whois169/roboot007v/docs/机械狗007A/头部抬头低头.png

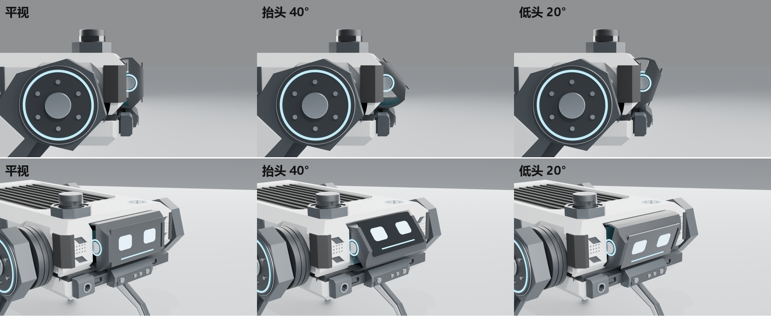
docs/机械狗007A/头部抬头低头.png
