whois169/roboot007v/docs/机械狗007A/效果图_v20_后45.png

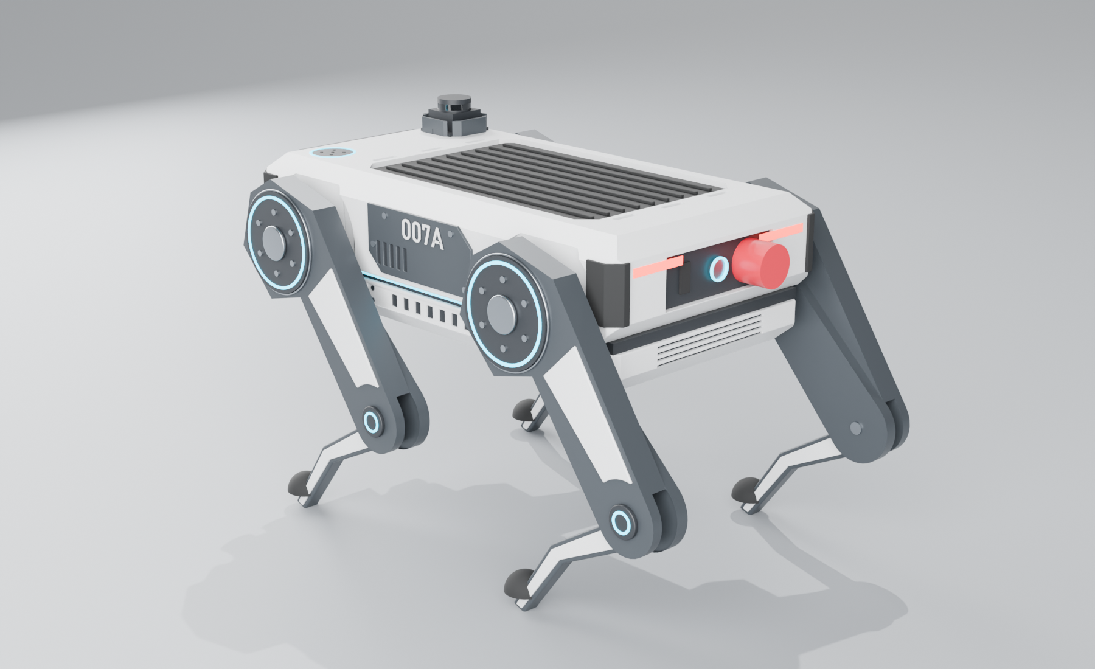
docs/机械狗007A/效果图_v20_后45.png
