whois169/roboot007v/007a/out/eng_report.txt

007A 骨架检查（eng_body.py）

站立：0 处干涉
外摆 ±20°（加 3 mm 余量）：0 处干涉

电子托板 z = 83（离机身底），顶板 z = 131，托板上能放高 41 的东西
托板上太高的：无
