whois169/roboot007v/007v/out/report.txt

机械狗007v骨架检查报告  2026-10-23 15:56
改尺寸：007v/config.py；重新生成：python 007v/build.py

【姿态】
  行驶（平视）：摆臂 +55.0°，头 +0°，机身底离地 127 mm → 长 591 × 宽 410 × 高 463 mm
      滑撬离地 121 mm；轮子最低 0.0 mm；除轮子和滑撬外最低的是 前右电机护罩端圈（18 mm）
  行驶（抬头）：摆臂 +55.0°，头 -35°，机身底离地 127 mm → 长 591 × 宽 410 × 高 463 mm
      滑撬离地 121 mm；轮子最低 0.0 mm；除轮子和滑撬外最低的是 前右电机护罩端圈（18 mm）
  行驶（低头）：摆臂 +55.0°，头 +20°，机身底离地 127 mm → 长 591 × 宽 410 × 高 463 mm
      滑撬离地 121 mm；轮子最低 0.0 mm；除轮子和滑撬外最低的是 前右电机护罩端圈（18 mm）
  折叠：摆臂 +0.0°，头 +15°，机身底离地 6 mm → 长 736 × 宽 410 × 高 342 mm
      滑撬离地 0 mm；轮子最低 18.0 mm；除轮子和滑撬外最低的是 外壳·底部灯槽右（4 mm）
  机身坐上滑撬时的摆臂角 +6.1°（从这里往上翻，轮子离地）

【干涉检查】（实体求交，> 2 mm³ 算撞；转轴、皮带、卡槽这些本来就套在一起的不算）
  行驶（平视）：0 处
  行驶（抬头）：0 处
  行驶（低头）：0 处
  折叠：0 处

【折叠过程 + 抬头低头】（每 2° 摆一次，算不同刚体之间的最近距离；40 mm 以外不细算；髋部轴承座和臂座之间固定的 1 mm / 3 mm 转动缝不算）
  全程没有相撞，也没有零件进到地面以下
  机身 ↔ 屏幕头：最近 0.7 mm（左转轴壳 ↔ 屏幕头·主壳，③行驶时抬头到低头，摆臂 +55°、头 +20°）
  前左腿 ↔ 机身：最近 7.0 mm（外壳·髋支座前左螺栓 x+182z57 ↔ 前左外壳·线夹4，①轮子着地、机身降到滑撬上，摆臂 +55°、头 +0°）
  后左腿 ↔ 机身：最近 7.0 mm（外壳·髋支座后左螺栓 x-182z57 ↔ 后左外壳·线夹4，①轮子着地、机身降到滑撬上，摆臂 +55°、头 +0°）
  前右腿 ↔ 机身：最近 7.0 mm（外壳·髋支座前右螺栓 x+182z57 ↔ 前右外壳·线夹4，①轮子着地、机身降到滑撬上，摆臂 +55°、头 +0°）
  后右腿 ↔ 机身：最近 7.0 mm（外壳·髋支座后右螺栓 x-182z57 ↔ 后右外壳·线夹4，①轮子着地、机身降到滑撬上，摆臂 +55°、头 +0°）
  ①轮子着地、机身降到滑撬上：除轮子和滑撬外离地最低 4 mm（外壳·底部灯槽左）
  ②摆臂往上往里翻：除轮子和滑撬外离地最低 4 mm（外壳·底部灯槽左）
  ③行驶时抬头到低头：除轮子和滑撬外离地最低 18 mm（前左电机护罩端圈）

【重量和重心】
  空车：15.9 kg，重心 x +12 / y +1 / 离地 180 mm
      前轮各 4.2 kg、后轮各 3.8 kg；撑住车身的髋扭矩 前 4.0 / 后 3.6 N·m
      侧翻临界 45°，往前翻 53°，往后翻 55°
      其他腿不动、直接抬一条腿，重心离三轮三角形的边：前左 -8 mm，前右 -6 mm，后左 +6 mm，后右 +8 mm（正 = 在里面；要靠调姿势加大，见仿真报告）
  满载 10 kg：25.9 kg，重心 x -13 / y +1 / 离地 257 mm
      前轮各 6.1 kg、后轮各 6.8 kg；撑住车身的髋扭矩 前 5.9 / 后 6.5 N·m
      侧翻临界 35°，往前翻 45°，往后翻 42°
      其他腿不动、直接抬一条腿，重心离三轮三角形的边：前左 +7 mm，前右 +8 mm，后左 -8 mm，后右 -7 mm（正 = 在里面；要靠调姿势加大，见仿真报告）
  满载从趴着撑起来：髋扭矩最大 11.2 N·m（摆臂 +6°）；髋驱动额定约 20.7 N·m

【整机宽度】
  机身 240 + 两边各（髋轴承座 18 + 轴毂 17 + 腿板 6 + 轴承座 3 + 轮宽 37（外侧和腿外侧齐平）+ 髋盖 4；电机在腿板内侧、露在机身下方）= 410 mm

零件 471 个，自重合计 15.9 kg（含外壳 1.37 kg）；用时 86 秒
