whois169/roboot007v/007v/out/sim_report.txt

机械狗007v仿真报告  2026-10-22 15:24
重新跑：python 007v/sim/run_sim.py（改了 CAD 先跑 python 007v/build.py，再加 --export）

电机模型：髋 = 5840 蜗轮 × 3:1 同步带（额定按 20.7 N·m 判）；轮 = GIM4310-10（峰值 5.6、额定 2.05 N·m，转速越高能出的越少）；
麦轮按 12 个 45° 滚子真实建模（每个滚子能自由转）；地面摩擦系数 0.9；货物 10 kg 在货斗中间、重心高出甲板 10 cm。

【站着不动】背上 10 kg，看髋关节要撑多大力。
  前腿髋关节撑住车身：5.0 N·m（上限 20.7）  ✓
  后腿髋关节撑住车身：5.6 N·m（上限 20.7）  ✓
  每个轮子分到的重量：6.1 / 6.1 / 6.7 / 6.7 kg（前左/前右/后左/后右）
  轮子电机要出力吗：不用 ；蜗轮自锁，站着不耗电  ✓

【折叠 → 站起来 → 趴下】背上 10 kg，从折叠趴着展开站起来，再趴下折叠（髋 80°/秒，轮子接地前后放慢到 20°/秒）。
  站起来时髋扭矩最大：11.4 N·m（上限 20.7）；后左腿  ✓
  趴下时髋扭矩最大：9.9 N·m（上限 20.7）；后左腿  ✓
  站起来用时：2.3 秒
  站起来后机身离地：127 mm；设计值 127  ✓
  站起来过程车身最大倾斜：0.0 °  ✓
  注：如果一直 80°/秒不放慢，轮子接地那一下髋扭矩冲到 12.0 N·m（之后稳定在 8–10）；接地前后放慢以后见上面

【平地加速和急停】背上 10 kg，加速到最高速 1.0 m/s（110 轮 + GIM4310-10 的上限），正常刹车，再加速后急停。
  加速时轮子扭矩最大：0.88 N·m（上限 5.6）；额定 2.05  ✓
  1.0 m/s 匀速时轮子扭矩：0.4 N·m（上限 2.05）  ✓
  实际速度：1.0 m/s；指令 1.0  ✓
  急停实际减速度：3.7 m/s²；指令 4  ✓
  急停刹车距离：19 cm
  急停时后轮最少还压着：1.9 kg；大于 0 就没翘起来  ✓
  急停时车身最大点头：0.0 °
  注：轮子电机限幅触发 2.39 秒

【10% 坡】背上 10 kg，在 10% 的坡（5.7°）上停住、上坡、坡上停车、倒着下坡。
  坡上停住时轮子扭矩：0.35 N·m（上限 2.05）  ✓
  匀速上坡时轮子扭矩（最累的轮）：0.79 N·m（上限 2.05）；这个转速下电机最多能出 0.8  ✓
  上坡起步时轮子扭矩最大：1.26 N·m（上限 5.6）  ✓
  下坡刹车时轮子扭矩最大：0.67 N·m（上限 5.6）  ✓
  实际上坡速度：0.99 m/s；指令 1.0  ✓
  坡上髋扭矩最大：5.7 N·m（上限 20.7）；前左腿  ✓
  停在坡上会不会溜：1.1 mm（第一次停住的 1 秒里滑了多少）  ✓

【横走和原地转】背上 10 kg，麦轮横着往左走 0.5 m/s，再原地转 90°/秒。
  实际横走速度：0.49 m/s；指令 0.5  ✓
  横走时往前后跑偏：0.0 m/s  ✓
  横走 2 秒车头转偏：0.0 °  ✓
  横走时轮子扭矩：0.52 N·m（上限 2.05）  ✓
  实际原地转速：89.0 °/秒；指令 90  ✓
  原地转时轮子扭矩：0.43 N·m（上限 2.05）  ✓
  整段轮子扭矩最大：1.03 N·m（上限 5.6）  ✓

【压过 15 mm 门槛】背上 10 kg，0.8 m/s 直接压过一根 15 mm 高、4 cm 宽的门槛条。
  过得去吗：过得去   ✓
  压门槛时髋扭矩最大：22.2 N·m（上限 20.7）；后左腿  ✗
  平地时髋扭矩（对比）：9.2 N·m
  压门槛时轮子扭矩最大：2.41 N·m（上限 5.6）  ✓
  车身上下颠簸最大：1.9 g；仿真里冲击只是估算
  车身最大点头：1.8 °
  注：髋关节是蜗轮自锁的“硬腿”，颠簸全靠轮子和轮胎吸收，冲击直接传到蜗轮上
  注：同样的门槛慢到 0.3 m/s 过，髋扭矩最大 12.8 N·m

【直接抬后左腿】背上 10 kg，其他腿不动、直接把后左腿往上抬。
  后左腿抬离地面了吗：抬起来了 
  抬起的轮子离地（仿真）：16 mm
  抬着时另外三个轮子最少还压着：0.0 kg；大于 0 就不会翻
  抬着时车身倾斜（仿真）：32.9 °
  整个过程髋扭矩最大：17.5 N·m（上限 20.7）；后左腿
  结论：抬不起来：整个车往后左方向歪了 33°，所以抬腿前必须先调姿势 

【调姿势后抬前左腿】背上 10 kg，先让另外三条腿换角度把重心挪开，再把前左腿抬离地 8 cm 以上，停 2 秒放下。
  调姿势后（静力计算）重心离三角形边：51 mm  ✓
  三条支撑腿的角度：前右 60° / 后左 100° / 后右 65° 
  车身倾斜（计算）：2.5 °
  前左腿抬离地面了吗：抬起来了   ✓
  抬起的轮子离地（仿真）：88 mm
  抬着时另外三个轮子最少还压着：3.9 kg；大于 0 就不会翻  ✓
  抬着时车身倾斜（仿真）：2.5 °
  整个过程髋扭矩最大：8.9 N·m（上限 20.7）；前右腿  ✓
  结论：稳   ✓

【调姿势后抬后左腿】背上 10 kg，先让另外三条腿换角度把重心挪开，再把后左腿抬离地 8 cm 以上，停 2 秒放下。
  调姿势后（静力计算）重心离三角形边：50 mm  ✓
  三条支撑腿的角度：前左 100° / 前右 55° / 后右 50° 
  车身倾斜（计算）：4.9 °
  后左腿抬离地面了吗：抬起来了   ✓
  抬起的轮子离地（仿真）：86 mm
  抬着时另外三个轮子最少还压着：3.4 kg；大于 0 就不会翻  ✓
  抬着时车身倾斜（仿真）：4.9 °
  整个过程髋扭矩最大：10.1 N·m（上限 20.7）；后右腿  ✓
  结论：稳   ✓

【抬腿静力计算】重心离三个着地轮围成的三角形的边（正 = 在里面，越大越稳；限制车身倾斜 ≤ 12°、滑撬离地 ≥ 4 cm）
  满载 前左腿：其他腿不动直接抬 3 cm：+6 mm；先调姿势再抬 10 cm：+51 mm（车身歪 2°，髋 7.8 N·m）
  满载 前右腿：其他腿不动直接抬 3 cm：+7 mm；先调姿势再抬 10 cm：+51 mm（车身歪 2°，髋 7.9 N·m）
  满载 后左腿：其他腿不动直接抬 3 cm：-8 mm；先调姿势再抬 10 cm：+50 mm（车身歪 5°，髋 11.3 N·m）
  满载 后右腿：其他腿不动直接抬 3 cm：-8 mm；先调姿势再抬 10 cm：+49 mm（车身歪 4°，髋 10.4 N·m）
  空车 前左腿：其他腿不动直接抬 3 cm：-11 mm；先调姿势再抬 10 cm：+49 mm（车身歪 7°，髋 6.7 N·m）
  空车 前右腿：其他腿不动直接抬 3 cm：-10 mm；先调姿势再抬 10 cm：+50 mm（车身歪 6°，髋 7.7 N·m）
  空车 后左腿：其他腿不动直接抬 3 cm：+7 mm；先调姿势再抬 10 cm：+50 mm（车身歪 3°，髋 5.3 N·m）
  空车 后右腿：其他腿不动直接抬 3 cm：+8 mm；先调姿势再抬 10 cm：+49 mm（车身歪 2°，髋 4.8 N·m）

【结论】站着不动 ✓；折叠 → 站起来 → 趴下 ✓；平地加速和急停 ✓；10% 坡 ✓；横走和原地转 ✓；压过 15 mm 门槛 ✗；调姿势后抬前左腿 ✓；调姿势后抬后左腿 ✓（“直接抬腿”是演示，不算）
用时 73 秒
