whois169/roboot007v/docs/开发进度与交接.md

# 开发进度与交接（新对话先读这份）

> 最后更新：2026-10-11（硬件 v0.6）。每做完一块就更新这份文件。
> 新开对话时，Claude 先读：`CLAUDE.md` → 这份文件 → `docs/00_项目核心原则.md` → 要改哪块就读哪块的 README。

---

## 一、用户的工作习惯和定下的规矩（一定要遵守）
- **说中文，用简单直白的中文**写文档和回复。
- **测试说明按语音模式写**（`python main.py`）：用户 2026-10-12 说以后基本不用打字模式。
- **用 git**（从 v0.6 起工程是 git 仓库，只在本地，没有远程仓库）。做完一块、用户测通后提交一次；`007v/brain/.env`（密钥）、`007v/brain/models/`、`007v/brain/data/` 不进 git。改完必须跑回归测试（见下）。
- **一块一块做**：每做完一块就停下，告诉用户怎么运行、怎么测，用户测通了再做下一块；做完写进对应的 README。
- **要装大依赖或要做选择时先问用户**；小事按推荐做法直接做，事后说明。
- **改完 CAD 设计**要跑 `CLAUDE.md` 里的验证流程，并同步完整资料包（最新是 v0.6 资料包，01–08 编号文件夹）、README 版本记录、相关文档。
- **定位：科技机械狗**，不是宠物狗，也不做 AI 音箱（见核心原则）。语气是系统汇报式，不说“汪”，不叫“主人”。
- **不用唤醒词**：看着它说话就行，唤醒词只留作备用。
- **隐私**：用户说“不管隐私了”，看着它说的话会发给大模型。**例外**：总指挥要求以后的“会议助手”开始记录前必须先征得在场的人同意。
- **模型以后再换**：现在 DeepSeek 只是测试用；回答速度、合成音色、看图模型，用户说以后自己找了再改，不要卡在这上面。
- **树莓派性能测试**：用户说以后自己弄。
- **上位机是树莓派 5**（2026-10-12 用户更正，不是 4B）。供电要单独一路 5V 5A，GPIO 供电要开 `usb_max_current_enable=1`，见 `../旧版/旧文档/电子系统与接线.md`。CAD 里占位盒的名字还叫“树莓派4B”，下次改 CAD 重新生成时顺手改名。

## 二、大脑程序 `007v/brain/` 现在的状态（2026-10-17 从 `brain/` 挪进来，屏幕动画按 800×440 新屏重写）
详细说明都在 `007v/brain/README.md`。运行：`cd 007v/brain` 然后 `python main.py`。

| 块 | 内容 | 状态 |
|---|---|---|
| ① | 语音对话：看着它说话（不用唤醒词）、本地 SenseVoice 识别、DeepSeek、语音合成服务（Qwen3-TTS，桌面 `RoboDog_TTS`，2026-10-15 起）、边想边说 | ✅ 用户测通 |
| ② | 眼睛：科技风 HUD（平时细小的真实数据流往上流，有人打交道时眼睛从数据流里拼出来；12 个状态；统一 JSON 指令，以后原样发给 ESP32） | ✅ 用户测通 |
| ③ | 看：本地人脸检测（YuNet）+ 正对程度 + 动静检测；有事才截图（看图模型还没配） | ✅ 用户测通 |
| ④ | 感觉板 + 三栏上下文 + 查天气（Open-Meteo，城市默认填的成都，用户还没改） | ✅ |
| ⑤ | 记忆：`data/memory/<家>.db`（SQLite），事实 / 事件 / 每日小结 | ✅ 用户测过“能记住我了” |
| — | 人设改成科技风、回声识别、决策日志、回归测试 | ✅ |
| ⑥ | 主动开口：今天第一次见 / 你回来了（走到面前看着它时先开口）/ 坐太久提醒；频率限制、夜间不说、`quiet` 遵守（`dog/attention.py`） | ✅ 做完，待用户测试 |
| ⑦ | 点屏幕唤醒（2026-10-17 取消头顶、下巴触摸）+ 头部通信协议（`dog/protocol.py`，`docs/头部通信协议.md`）：ESP32 发来的触摸、传感器、隐私开关、心跳；模拟器 T/C/P 键代替 | ✅ 做完，待用户测试 |
| ⑧ | 红外遥控（`dog/ir.py`）：学按键、发码、忘掉；码库和记忆同一个 .db（`ir_codes` 表）；模拟器 R 键代替按遥控器 | ✅ 用户测通（模拟器） |
| ⑨ | 热成像（`dog/thermal.py`）：ESP32 每秒发一帧 32×24，大脑分析热源 / 冷点 / 方向，进感觉板；屏幕画真热画面；60°C 以上持续 5 秒主动提醒；模拟器假房间，H 键开假灶台 | ✅ 用户测通（模拟器） |
| ⑩ | 室内外对比 + 屋里舒不舒服：温湿度改成头部 SHT40 发来（`senses.temp_hum: head`，`temp_offset` 校准）；程序算好温差放进【我查到的】；偏热 / 冷 / 潮 / 干持续 10 分钟、有人在时主动提醒，会问要不要开空调但不自己发；模拟器 [ ] 调温度、, . 调湿度 | ✅ 用户测通（模拟器） |
| ⑪ | 认人（`dog/people.py`，`vision.py` 里算 SFace 特征）：登记（enroll 技能）、认出叫名字、陌生人主动汇报、删人；只存 128 维特征不存照片，和记忆同一个 .db | ✅ 做完，待用户测试 |

**回归测试**（改完代码必须跑）：`cd 007v/brain` → `python tests/run_tests.py`（约 3 分钟，134 项，要联网调大模型）；`--quick` 只跑不联网的部分。

## 三、下一步要做的（按建议顺序，2026-10-11 和用户定的）
1. ~~红外遥控技能~~（第⑧块，2026-10-11 做完）。以后：脖子能转了先转头对准家电再发。
2. ~~热成像模式~~（第⑨块，2026-10-12 做完）。以后：脖子能转了可以“转一圈扫描整个房间的热分布”。
3. ~~测温对比汇报~~（第⑩块，2026-10-12 做完）。
4. ~~认人~~（第⑪块，2026-10-12 做完；SFace 实际约 37MB，用户同意下载）。
4b. ~~换语音合成~~（2026-10-15 做完）：Kokoro 在 CPU 上太慢没用。改成桌面 `RoboDog_TTS` 文件夹里的独立语音合成服务（Qwen3-TTS 0.6B CustomVoice + faster-qwen3-tts 加速，RTX 3060 上约 0.4 秒出第一段，比说话快），大脑通过 HTTP 边收边播。MeloTTS、Kokoro、edge-tts 的模型和代码都删了。树莓派以后也是调笔记本上的这个服务。
5. 搬上树莓派前：断网时的本地回答、开机自启动、崩溃自动重启、日志不无限变大。
6. 零件到了再接：毫米波、测距、光照的真读数；脖子电机（视线换成脖子转角，遵守 `cad/head.py` 的 `NECK_LIMITS`）。
7. 等 ESP32 回声消除做好：说话时能用嗓子打断（现在只能点屏幕打断）。

**2026-10-13 起的顺序（和用户定的）**：用户先测第⑪块认人 → 稳定性（上面第 5 条）→ 对话打断第一步（看着它 + 声音明显大于回声 + 持续 0.5 秒才停，加“停 / 等一下”口令；彻底版等 ESP32 回声消除）→ 搬树莓派。
功能类想法（以后再定）：看家值守 + 回家汇报、留言转达（认出某人时转达）、条件联动（回家且屋里热就开空调）、带热成像确认的关火提醒、声音事件识别、今天谁来过、会议助手（必须先征得在场的人同意）。

**待用户决定的事**：
- ESP32 固件谁写、什么时候写（我写的话要先在电脑上装 PlatformIO 或 Arduino，没板子只能编译不能实测）。
- 红外和热成像要不要加进采购表（旧分阶段采购表（已删））。
- 天气城市（`007v/brain/config.yaml` 的 `weather.city`）、名字（`persona.name`，2026-10-17 已改成 007v）。用户最早回答唤醒词时写过“004v”，含义没确认。

## 四、硬件设计的状态
- **2026-10-16 改版为机械狗007v**，四足（`cad/`）存档。第 1 步选型计算书、第 2 步结构骨架已完成（`007v/`，检查报告 `007v/out/report.txt`）。骨架检查结果：4 个姿态 0 处干涉、折叠全程不撞，最小间隙 3.6 mm（雷达和抬头时的屏幕头）；整机展开约 646×438×468 mm、折叠约 411×438×319 mm；自重 15.6 kg、满载 25.6 kg。
- **第 3 步仿真已完成**（`007v/sim/`，MuJoCo，麦轮 12 个滚子真实建模）：满载站立、起身趴下、加速到 1.4 m/s、急停、10% 坡、横走、原地转、压 15 mm 门槛、抬腿全部在电机额定以内，选型不用改。抬腿要先调姿势（同侧另一条腿收到 100°、对面两条 50–65°）。得出 5 条控制规矩（接地前后放慢、髋加速度限制、软急停、门槛减速、调姿势时松轮子），写底盘程序时照做；风险：髋是硬腿，0.8 m/s 压门槛冲到 17.3 N·m，第 4 步给同步带加弹性。详见 `docs/机械狗007v/仿真报告.md`。
- **第 4 步 4a 完成（2026-10-16）**：查了零件真实尺寸，按真实零件改了模型（麦轮改 45 宽 15 滚子、整机宽 428；头加高放下 112.4 × 75.1 的屏板、头宽 136、肩座 48 宽放得下 LD19 的安装脚；摆臂根部改成铝内板 + 4 根铝柱受力，打印箱只是外壳；髋部轴承座两个 6001、键连接、端头螺丝压紧）。出了零件清单（样品批约 3500 元、第二批约 3500 元）、23 种加工件图纸（`007v/mfg.py`）、接线图（急停只断电机）。**等用户**：下单样品，问卖家要轮子电机、麦轮轮毂、5840 箱体、屏板的安装尺寸图（★），拿到后改 `config.py` 再出 4b 定稿图。屏板引脚被屏幕占满，头部传感器继续用旧的 ESP32-S3。
- 旧版四足 **v0.6**（git 提交 747867e）：参考概念图重做腿（圆弧肩大腿、叉形大腿、外露银色膝盖、狗腿反弓小腿、双色护甲）；v0.5 起是科技机械狗方向，头部有热成像和红外收发，背部任务导轨。详见根目录 `README.md`。
- 2026-10-11 修了 Windows 上 `build.py` 写 `report.txt` / `rig.json` 的乱码（加 `encoding="utf-8"`）。
- **买热成像要注意**：前脸那条白边只够放 12×12 的小板，常见 25×18 转接板放不下（详见 `零件尺寸收集清单.md`）。
- 以后的规划：`docs/扩展规划_投影与传感器.md`（胸口投影、传感器三个梯队、模式切换）。

## 五、在这台电脑上干活的技术坑
- 系统 Python 3.11，命令用 `python`，不是 `python3`。
- **工程路径里有中文**：有些 C++ 库打不开中文路径。`007v/brain/main.py` 启动时会先切到 `007v/brain/` 目录，用相对路径（`dog/config.py` 的 `rel()`）；MuJoCo 脚本也是先 `os.chdir` 再加载。写文本文件一律加 `encoding="utf-8"`。
- 在 Bash 里用 heredoc 写 Python 补丁时，`\n` 这类转义经常被吃掉，改出语法错误。**多行改动用 Edit 工具，或者先把补丁脚本写成文件再运行。**
- 用 `sed` 批量替换要小心范围：曾经一条 sed 改到了别的同名代码行，导致“大模型回答第二句就报错”，靠回归测试才发现。
- **语音合成服务**在桌面 `C:\Users\67309\Desktop\RoboDog_TTS`（不在工程里，自己的 .venv，显卡版 PyTorch 2.14 cu126）。依赖版本被 `constraints.txt` 锁住：transformers 必须 5.15.1（5.19 会报 MimiConfig 没有 rope_theta）。0.6B 模型**不支持 instruct 语气说明**（官方代码里写死了），硬给会生成乱声音。跑大脑和测试前先开服务（start.bat）。
