whois169/roboot007v/docs/机械狗007A/孔位核对.md

# 机械狗007A 孔位核对（每一颗螺丝）

> 由 `007a/print_parts.py` 生成（`mounts.check`）：沿每颗螺丝的轴线每 0.4 mm 取点，中心要空（有孔）、外面一圈要有料（铝板 / 螺丝柱 / 热熔螺母座）。
> 过孔有料 ≥ 1.5、咬螺纹的（自攻 / 热熔螺母）有料 ≥ 3 才算过。

一共 47 颗，**对不上 0 颗**。

| 螺丝 | 结果 | 细节 |
|---|---|---|
| 上层壳 M3×6 (-25,-108) | ✅ | A07 顶板：有孔、有料 3.2；上层甲板壳：有孔、有料 2.8 |
| 上层壳 M3×6 (-25,108) | ✅ | A07 顶板：有孔、有料 3.2；上层甲板壳：有孔、有料 2.8 |
| 上层壳 M3×6 (25,-108) | ✅ | A07 顶板：有孔、有料 3.2；上层甲板壳：有孔、有料 2.8 |
| 上层壳 M3×6 (25,108) | ✅ | A07 顶板：有孔、有料 3.2；上层甲板壳：有孔、有料 2.8 |
| 上层壳 M3×6 (-200,0) | ✅ | A07 顶板：有孔、有料 3.2；上层甲板壳：有孔、有料 2.8 |
| 上层壳 M3×6 (200,0) | ✅ | A07 顶板：有孔、有料 3.2；上层甲板壳：有孔、有料 2.8 |
| 下层底盘 M3×8 (-200,0) | ✅ | 下层底盘：有孔、有料 1.6；A01 底板：有孔、有料 3.2 |
| 下层底盘 M3×8 (200,0) | ✅ | 下层底盘：有孔、有料 1.6；A01 底板：有孔、有料 3.2 |
| 防撞杠 M3×8 (y+66,z24) | ✅ | A05 前端板：有孔、有料 4.0；前防撞杠：有孔、有料 3.6 |
| 防撞杠 M3×8 (y+66,z40) | ✅ | A05 前端板：有孔、有料 4.0；前防撞杠：有孔、有料 3.6 |
| 防撞杠 M3×8 (y-66,z24) | ✅ | A05 前端板：有孔、有料 4.0；前防撞杠：有孔、有料 3.6 |
| 防撞杠 M3×8 (y-66,z40) | ✅ | A05 前端板：有孔、有料 4.0；前防撞杠：有孔、有料 3.6 |
| 深度相机 M3×6 (y-22) | ✅ | 前防撞杠：有孔、有料 2.8 |
| 深度相机 M3×6 (y+22) | ✅ | 前防撞杠：有孔、有料 2.8 |
| 热像仪 M2.5×6 (-10.2,-6.3) | ✅ | 前防撞杠：有孔、有料 4.0 |
| 热像仪 M2.5×6 (-10.2,+6.3) | ✅ | 前防撞杠：有孔、有料 4.0 |
| 热像仪 M2.5×6 (+10.2,-6.3) | ✅ | 前防撞杠：有孔、有料 4.0 |
| 热像仪 M2.5×6 (+10.2,+6.3) | ✅ | 前防撞杠：有孔、有料 4.0 |
| 台阶测距 M2×6 (y+78,-6.3) | ✅ | 前防撞杠：有孔、有料 4.0 |
| 台阶测距 M2×6 (y+78,+6.3) | ✅ | 前防撞杠：有孔、有料 4.0 |
| 台阶测距 M2×6 (y-78,-6.3) | ✅ | 前防撞杠：有孔、有料 4.0 |
| 台阶测距 M2×6 (y-78,+6.3) | ✅ | 前防撞杠：有孔、有料 4.0 |
| 尾部接口板 M3×8 (y+63,z-15) | ✅ | A06 后端板：有孔、有料 4.0；尾部接口板：有孔、有料 3.6 |
| 尾部接口板 M3×8 (y+63,z+15) | ✅ | A06 后端板：有孔、有料 4.0；尾部接口板：有孔、有料 3.6 |
| 尾部接口板 M3×8 (y-63,z-15) | ✅ | A06 后端板：有孔、有料 4.0；尾部接口板：有孔、有料 3.6 |
| 尾部接口板 M3×8 (y-63,z+15) | ✅ | A06 后端板：有孔、有料 4.0；尾部接口板：有孔、有料 3.6 |
| 雷达 M2×8 (+16.0,+23.4) | ✅ | 上层甲板壳：有孔、有料 4.8 |
| 雷达 M2×8 (+16.0,-23.4) | ✅ | 上层甲板壳：有孔、有料 4.8 |
| 雷达 M2×8 (-16.0,+0.0) | ✅ | 上层甲板壳：有孔、有料 4.8 |
| 舵机座 M3×8 (x238) | ✅ | 舵机座 P04：有孔、有料 2.0；头支架左：有孔、有料 3.2 |
| 舵机座 M3×8 (x248) | ✅ | 舵机座 P04：有孔、有料 2.0；头支架左：有孔、有料 3.2 |
| 舵机后耳 M2×6 (z-4) | ✅ | 舵机座 P04：有孔、有料 4.0 |
| 舵机后耳 M2×6 (z+4) | ✅ | 舵机座 P04：有孔、有料 4.0 |
| 树莓派 5 铜柱孔 (+24.5,+39.0) | ✅ | C01 电子托板：有孔、有料 2.8 |
| 树莓派 5 铜柱孔 (+24.5,-19.0) | ✅ | C01 电子托板：有孔、有料 2.8 |
| 树莓派 5 铜柱孔 (-24.5,+39.0) | ✅ | C01 电子托板：有孔、有料 2.8 |
| 树莓派 5 铜柱孔 (-24.5,-19.0) | ✅ | C01 电子托板：有孔、有料 2.8 |
| 5V 5.5A 降压 D36V50F5 铜柱孔 (-10.5,-10.6) | ✅ | C01 电子托板：有孔、有料 2.8 |
| 5V 5.5A 降压 D36V50F5 铜柱孔 (-10.5,+10.6) | ✅ | C01 电子托板：有孔、有料 2.8 |
| 5V 5.5A 降压 D36V50F5 铜柱孔 (+10.5,+10.6) | ✅ | C01 电子托板：有孔、有料 2.8 |
| 5V 3.2A 降压 D36V28F5 铜柱孔 (+7.1,+7.7) | ✅ | C01 电子托板：有孔、有料 2.8 |
| 5V 3.2A 降压 D36V28F5 铜柱孔 (-6.5,-8.2) | ✅ | C01 电子托板：有孔、有料 2.8 |
| 功放 MAX98357A 铜柱孔 (-6.3,+7.0) | ✅ | C01 电子托板：有孔、有料 2.8 |
| 功放 MAX98357A 铜柱孔 (+6.3,+7.0) | ✅ | C01 电子托板：有孔、有料 2.8 |
| IMU 超核 HI12M0 铜柱孔 (+0.0,+8.3) | ✅ | C01 电子托板：有孔、有料 2.8 |
| IMU 超核 HI12M0 铜柱孔 (-8.5,-8.3) | ✅ | C01 电子托板：有孔、有料 2.8 |
| IMU 超核 HI12M0 铜柱孔 (+8.5,-8.3) | ✅ | C01 电子托板：有孔、有料 2.8 |

## 传感器官方尺寸来源

| 东西 | 型号 | 外形 | 孔 | 怎么装 | 来源 |
|---|---|---|---|---|---|
| 深度相机 | 奥比中光 Gemini 335 | 89.48 × 30 × 25 | 背面 2-M3 深 3，孔距 45，高度正中；底面 1/4-20 深 5 | 前防撞杠相机罩，2 颗 M3×6 从杠背面拧（低头 20°） | 奥比中光官网《Gemini 330 系列 Reference Design - Mounting》产品图 V1.0（2024-03-22） |
| 热像仪 | Adafruit MLX90640 110°（4469） | 板 25.4 × 17.78 × 1.57；探头 Φ9.3 在板背面正中，凸出 5.72 | 4-Φ2.5，孔距 20.32 × 12.7 | 前防撞杠右头，探头朝前，4 颗 M2.5 自攻 | Adafruit 官方 3D 模型 4469 MLX90640 Stemma.step（007a/ref/adafruit/） |
| 台阶测距 ×2 | Pololu VL53L1X（3415） | 12.7 × 17.78 | 2-Φ2.18，孔距 12.7，离左边 2.54 | 前防撞杠 y ±78，低头 20°，2 颗 M2 自攻 | Pololu 官方尺寸图（007v/ref/pololu/dims_3415.jpg） |
| 探照灯 | XHP50 20 mm 铜基板 + 3° 聚光透镜（矮款）+ 20 × 20 × 6 散热铝块 | 透镜 Φ21.8 × 17.6；基板 Φ20 × 1.6；铝块 20 × 20 × 6 | — | 前防撞杠左头灯筒：透镜、基板、铝块从后往前叠，前面打印压圈压住 | 淘宝店铺尺寸图（格锐特光电 3 度透镜：直径 21.78 高 17.6；铜基板 Φ20 × 1.6；铝块 20 × 20 × 6） |
| 激光雷达 | 乐动 LD19 | 安装脚 54 × 46.29，总高 34.8，扫描面离底 27 | 3-Φ2.5：前两个 ±23.4、前后 31.92 | 上层壳左前角，3 颗 M2 自攻拧进壳里的柱子 | 乐动 LD19 规格书 V2.5 |
| 麦克风 ×2 | INMP441 圆板 | Φ13.8 | — | 上层壳右前角拾音孔下面 Φ14.2 圆槽，胶粘 | 模块资料 |
| 急停 | 施耐德 XB2BS542C | 头 Φ40；面板后 66.5，底座 30 × 40 | 开孔 Φ22.5，面板厚 1–6 | 尾部接口板 y = -40 | 施耐德产品数据表（ref/estop/） |
| 总开关 | GQ16F 自锁带灯 | 头 Φ18，螺母 19，面板后 26 | 开孔 Φ16.2 | 尾部接口板正中 | 厂家图纸（ref/switch/） |
| 充电口 | Amass XT60E1-F | 27.1 × 12.1 × 16.7 | 后身截面 15.5 × 8.1（店铺 XT60 图纸，开孔 16.2 × 8.6）；★ 法兰固定孔距 20.5 按外形推的，到货卡尺量 | 尾部接口板 y = +42，2 颗 M2.5 自攻 | Amass 产品规格书（ref/xt60/） |
| 树莓派 5 | Raspberry Pi 5 | 85 × 56 | 4-M2.5，孔距 58 × 49，离边 3.5 | C01 托板，M2.5 铜柱 ×4 | 树莓派官方机械图 |
| 5V 5.5A 降压 | Pololu D36V50F5 | 25.4 × 25.4 | 3-Φ2.18（三个角，离边约 2） | C01 托板，M2 铜柱 ×3 | Pololu 官方尺寸图（007v/ref/pololu/dims_4091.jpg） |
| 5V 3.2A 降压 | Pololu D36V28F5 | 20.32 × 17.78 | 2-Φ2.18（对角） | C01 托板，M2 铜柱 ×2 | Pololu 官方尺寸图（007v/ref/pololu/dims_3782.jpg） |
| 功放 | Adafruit MAX98357A（3006） | 17.78 × 19.05 | 2-Φ2.5，孔距 12.7，离一边 2.54 | C01 托板，M2.5 铜柱 ×2 | Adafruit 官方 3D 模型 3006 MAX98357.step（007a/ref/adafruit/） |
| IMU | 超核 HI12M0-MI1-000（UART + CAN） | 22 × 22 × 10 | 3-Φ2.6：下面两个孔距 17，上面一个在正中、离下排 16.6 | C01 托板，M2.5 铜柱 ×3 | 天猫 HiPNUC 旗舰店详情页尺寸表（HI12 系列：A 10、D 22、D1 17、E 22、E1 16.6、孔 Φ2.6、缺口 R2.4） |
| 抬头舵机 | 飞特 STS3032 | 23 × 12 × 27.5；耳总长 32，离底 20.5–22；花键 25T Φ4.95，顶离底 31.9 | 4-Φ2.5（★ 孔距 28 × 8 按 4-R2 同心推的；输出轴离机身一头 8.21 ★） | 打印舵机座 P04，后耳 2 颗 M2 自攻，座子 2 颗 M3 拧左头支架 | 店铺详情页尺寸图 |
| USB 转 4 路 485 | 宇树 | 照片估约 60 × 35（托板上留 60 × 45） | 没有 | C01 托板：扎带 + 3M 双面泡棉胶，不靠尺寸 | 天猫宇树旗舰店照片：光板、没有安装孔（宇树没给尺寸） |
