whois169/roboot007v/docs/机械狗007A/走线说明.md

# 机械狗007A 走线说明（第 2 步初版）

> 图：`走线图.png`（`python 007a/routing.py` 生成）。接线到每一个针脚的接线图等样品到了再出（同 007v 的 `wiring.py`）。

## 1. 腿：每条腿一路 485，3 个电机串起来

宇树手册：一路总线可以串 3 个电机，**两头各加一个 120 Ω**；电源线至少 16 AWG；**不能带电插 XT30(2+2)**。

```
USB 转 4 路 485（托板上）的第 k 路 ──┐
保险丝盒的第 k 路（10 A）──────────┤ 一根 XT30(2+2) 线，从外摆隔板中间的 Φ40 孔过去
                                    ▼
外摆电机（固定在隔板上）──短线、留 6 cm 余量──▶ 髋电机（在髋座上，跟外摆转 ±20°）
                                                   │
                                                   ▼ 在“绕线环”里绕 1.5 圈（像钟表发条）
                                                膝电机（在大腿杯上，跟大腿转）← 这里接 120 Ω
```

| 哪一段 | 要转多少 | 余量怎么留 |
|---|---|---|
| 外摆电机 → 髋电机 | 外摆 ±20° | 线在髋座后板和隔板之间弯一个 U 形，长 6 cm |
| 髋电机 → 膝电机 | 大腿前后摆约 ±100° | **绕线环**：打印的环（外径 108、内径 98、宽 30），套在髋电机外面、拧在髋座上；线在环里绕 1.5 圈约 19 cm，大腿转的时候圈收紧 / 放松，不拉、不磨 |

> 每个关节都要在程序里设软限位，不能超过上面的角度（不然线会被拉断）。

## 2. 电源

```
电池 XT60 ─ 保险丝盒（30 A 总）─┬─ 继电器 80 A（急停断它的线圈）─ 4 路 10 A ─ 4 条腿
                                ├─ 5 V 5.5 A ─ 树莓派
                                ├─ 5 V 3.2 A ─ USB 集线器、传感器、抬头舵机 STS3032（5 V！）
                                └─ 12 V 5 A ─ 探照灯
充电口 XT60（尾部）─ 电池保护板的充电口
```

电机刹车会往电池回充电：**一定用电池供电**，不要接开关电源（宇树手册第 3 条）。

## 3. 传感器和头

| 东西 | 在哪 | 线 | 从哪进机身 | 接到 |
|---|---|---|---|---|
| 深度相机 Gemini 335 | 前防撞杠正中 | USB-C（USB 3） | 前端板下面的窗口 | 树莓派 USB 3 口 |
| 热像仪 P2 Pro | 防撞杠右头 | USB-C | 同上 | USB 集线器 |
| 探照灯 | 防撞杠左头 | 12 V + PWM | 同上 | 12 V 降压、派 GPIO（MOSFET） |
| 台阶测距 ×2 | 防撞杠里 | I2C | 同上 | 派 I2C |
| 头：屏幕板 4.3B | 头里面 | USB-C | 前端板上面的窗口（头支架旁边），留 3 cm 余量（头转 ±20°） | USB 集线器 |
| 抬头舵机 STS3032 | 左头支架上 | 舵机总线 | 同上 | 总线舵机转接板 → 派串口 |
| 喇叭 ×2 | 前脸两边 | 喇叭线 | 前端板窗口 | 功放 MAX98357A（托板上） |
| 激光雷达 LD19 | 顶上左前角 | USB（转接板） | 顶板前面那条中间通道 | USB 集线器 |
| 麦克风 + 录音灯 | 顶上右前角 | I2S + 灯 | 同上 | 派 I2S、GPIO |
| IMU 超核 HI12M0 | 托板正中 | Molex 8 针（UART，3.3 V） | — | 派串口 |
| 急停、总开关、充电口 | 尾部接口板 | 粗线 | 后端板窗口 | 继电器线圈、电源、电池 |
| 腰线灯（WS2812） | 两侧黑腰 | 5 V + 数据 | 侧梁的减重孔 | 派 GPIO |

## 4. 还要等到货再定的（★）

- 宇树电机 XT30(2+2) 插座在电机哪一面、朝哪个方向（决定隔板孔和髋座上的走线口位置）
- USB 转 4 路 485 模块的尺寸和接口朝向
- 每段线的实际长度（样品电机装上以后量）
