whois169/roboot007v/docs/机械狗007A/选型计算书.md

# 机械狗 007A 选型计算书（第 1 步，草稿 2026-10-29）

做法和 007v 一样：先算要多大力 → 再选国内买得到的零件 → 尺寸以**官方资料**为准。
标记：✅ 官方资料查到了；★ 官网查不到（只有图片 / 经销商数据），下单时问卖家要“安装尺寸图（PDF / STEP）”；📏 便宜通用件，到货实测。

---

## 一、用途和要求

- 用途：管道巡检（电缆隧道、综合管廊这种人能走进去的），看哪里堵塞、哪里发热、有没有有害气体；也能驮东西（5 kg 以内）。先不考虑防水。
- 能上楼梯：住宅 175 × 260、公共 150 × 300（腿长按 `007a/stair_calc.py` 定：大腿 200、小腿 190）。

## 二、整机重量估算（`007a/sizing.py`）

| 项 | kg |
|---|---|
| 关节电机 ×12（按候选里最重的 0.53 kg 算） | 6.4 |
| 腿结构 ×4 | 1.4 |
| 机身骨架（铝板 + 型材） | 2.0 |
| 外壳（打印） | 1.5 |
| 电池 6S 约 220 Wh | 1.5 |
| 主控、驱动、线 | 0.8 |
| 传感器（雷达、深度相机、热像仪、气体、屏幕、灯） | 0.8 |
| **整机** | **14.4** |
| 加 5 kg 货 | 19.4 |

## 三、每个关节要多大扭矩（19.4 kg，侧面静力 × 动载系数）

| 工况 | 髋高 mm | 每条腿 N | 髋前后 N·m | 膝 N·m | 外摆 N·m |
|---|---|---|---|---|---|
| 站立（膝 90°） | 276 | 47 | 0 | 6.5 | 2.8 |
| 对角小跑（2 腿 × 1.8） | 276 | 171 | 0 | **23.5** | **10.3** |
| 爬楼梯·后腿蹬直（3 腿 × 1.3） | 353 | 82 | **8.2** | 1.3 | 4.9 |
| 爬楼梯·前腿收起 | 178 | 82 | 6.6 | 15.6 | 4.9 |
| 趴下站起（膝 40°） | 134 | 47 | 0 | 8.7 | 2.8 |

结论：**膝最吃力（小跑 23.5 N·m）**，髋前后和外摆 10 N·m 左右。
→ 三个关节用同一款电机（好备件），膝加一级 **1 : 1.5 减速**（同步带或连杆，电机放在髋那里，腿轻、甩得快），膝就有 1.5 倍余量。

## 四、关节电机候选（要你定）

| | 宇树 GO-M8010-6 | SteadyWin GIM8108-8 |
|---|---|---|
| 峰值扭矩 | 23.7 N·m ✅ | 22 N·m（堵转）★ 官网只有曲线图 |
| 额定扭矩 | — | 7.5 N·m ★ |
| 重量 | 530 g ✅ | 约 375 g ★（各家 327–396 g） |
| 尺寸 | 96.5 × 92.5 × 42.3 ✅ | Φ92 × 55 ★ |
| 电压 | 12–30 V，推荐 24 V ✅ | 12–56 V，额定 48 V ★ |
| 通信 | RS-485 4 Mbps（要宇树的 USB 转 485）✅ | **CAN**（和 007v 轮子电机 GIM4310 同一家、同一套协议，007v 写好的底盘固件能接着用） |
| 用在哪 | 宇树 Go1 同款，四足用得最多，资料多 | 国产开源四足用得多，价格低 |
| 12 个省多少重 | — | 比宇树轻约 1.9 kg |

| 价格（只查到海外零售价，国内以淘宝官方店为准） | 约 280 美元 / 个 | 约 85 美元 / 个（不带驱动） |

**定：宇树 GO-M8010-6**（2026-10-29，用户要“好用、稳健、灵敏”）：
- 稳健：宇树 Go1 量产同款，官方参数、SDK、仿真模型都齐，不用猜；
- 灵敏：电机里 6000 Hz 闭环，RS-485 4 Mbps，每条腿一路总线，500–1000 Hz 控制没压力；
- 代价：12 个大约贵一倍、重 1.9 kg（重量估算已经按它算了）；007v 的 CAN 程序不能直接用（007A 走路本来就要新写）。

**膝：电机放髋上 + 同步带 1 : 1.5**（用户定）：皮带没有间隙、比连杆准，膝转动范围也大。膝峰值 23.7 × 1.5 ≈ 35 N·m，比小跑要的 23.5 多 50% 余量。

## 五、其他零件（新加的）

| 零件 | 型号 | 关键数据 | 状态 |
|---|---|---|---|
| 深度相机 | 奥比中光 Gemini 335 | 90 × 25 × 30，97 g，< 3 W，USB-C，底部 1/4-20 + 背面 2 × M3，0.1–20 m，视场 90° × 65° | ✅ 官网；装得进前防撞杠正中的相机罩（96 宽） |
| 红外热像仪 | 艾睿光电 Tiny1-C（256 × 192，要带 USB 转接板的版本） | 机芯 < 2.5 g，长波 8–14 µm，25 帧 | ★ 官网尺寸两处写的不一样（13 × 13 × 8 / 13 × 28 × 10），USB 板要问卖家 |
| 气体检测 | 炜盛 ZCE04B 四合一（CO / H₂S / O₂ / CH₄） | 41 × 41 × 21.6，3.5–5 V，< 100 mA，串口（2.8 V 电平），7 针 | ✅ 手册；★ 安装孔要问卖家 |
| IMU（走路必须有） | 超核 HI14 一类（1000 Hz） | — | ★ 官网查不到尺寸，下一轮再定 |
| 腿主控 | 要能同时管 4 路总线（每条腿一路，500 Hz 以上） | 候选：达妙 MC02（3 路 CAN FD）/ 4 个 USB 转 CAN | ★ 跟电机一起定 |
| 探照灯 | CREE XHP50 一类 12 V LED 灯头 + 恒流板 | 灯筒 Φ34 | 📏 |

**气体模块的说明书写着“不要用在涉及人身安全的系统里”**：所以 007A 测到的气体只是**预警**，人进管道前还是要用合格的手持检测仪再测一次。这一条会写进说明书和大脑的回答规矩里。

## 六、沿用 007v 的（已经查过官方资料）

树莓派 5、乐动 LD19 雷达、微雪 4.3 寸屏、飞特 STS3215（屏幕抬头低头）、VL53L1X 台阶测距、施耐德急停、GQ16 开关、XT60 充电口、6S 电池方案、Pololu 降压板、MAX98357A 功放、INMP441 麦克风。

## 七、下一步（你点头以后）

1. ~~定关节电机、膝的减速方式~~（已定）；腿主控跟着电机定：每条腿一个宇树 USB 转 485（共 4 个）接树莓派。
2. 我按定下来的去官网把剩下的 ★ 补齐，出完整采购表（同 007v 的 `bom.py`）。
3. 第 2 步骨架：电机座、膝减速、机身铝板、电子件托板、卡槽、螺丝孔（同 007v 的 `config.py → model.py → build.py`，带干涉检查）。

资料来源：宇树官网电机页 unitree.com/go1/motor；奥比中光官网 orbbec.com Gemini 335；炜盛 ZCE04B 用户手册 V1.0（winsen-sensor.com）；SteadyWin 官网 steadywin.cn（只有图）；艾睿 infiray.com Tiny1-C。

## 六、国产电机对比（2026-10-30，用户问能不能换）

要求（按第 3 步仿真）：峰值扭矩 ≥ 23 N·m（小跑 0.8 m/s 髋 22.0、上楼梯膝 33.8 ÷ 1.5 = 22.6）；输出转速 ≥ 约 180 rpm（小跑 17.6–18.3 rad/s），上楼梯短时到 26.6 rad/s（≈ 255 rpm）。电池现在是 6S（22.2 V）。

| | 宇树 GO-M8010-6（现在） | SteadyWin GIM8108-8 | 达妙 DM-J8009P-2EC | 灵足 RobStride 03 |
|---|---|---|---|---|
| 峰值扭矩 | 23.7 | 18.3（24 V 驱动）/ 23.1（48 V 驱动） | 40 | 60 |
| 最高转速（输出） | 286 rpm @24 V | 308 / 290 rpm | 160 rpm @24 V，320 @48 V | 195 rpm @48 V |
| 重量 | 530 g | 396 g | 930 g | 880 g |
| 尺寸 | Φ96.5 × 42.3 | Φ92 × 55 | Φ98 × 61.7 | 106 × 106 × 56 |
| 通信 | RS-485 | CAN / RS-485 | CAN | CAN |
| 价格 | 天猫 1500 元 | 海外 85 美元（不含驱动），国内价未查到 | 约 2200 元（两年前文章）；海外 395 美元 | 发布价 999 元（2024-09）；海外 225 美元 |
| 12 个比现在 | — | 轻 1.6 kg | 重 4.8 kg | 重 4.2 kg |
| 结论 | ✅ 够用 | ⚠ 24 V 不够劲；要换 48 V 电池才勉强够，没余量 | ❌ 24 V 太慢；换 48 V 能用，但更重更贵 | ⚠ 扭矩很足，但太慢（小跑勉强、上楼梯不够），还要换 48 V、重 4 kg |

小米 CyberGear（峰值 12 N·m）、RobStride 01（17 N·m）扭矩不够，不列。
**暂不换**：便宜的两款都要把电池改成 48 V，且转速或扭矩没余量；宇树仍是 24 V 下唯一扭矩、转速、重量都合适的。
