whois169/roboot007v/docs/机械狗007A/仿真报告.md

# 机械狗007A 仿真报告（第 3 步初版）

> `python 007a/sim/run_sim.py [场景…] [--gif]`（MuJoCo 3.15）。模型 `007a/sim/export_mujoco.py`：重量、重心、惯量按第 2 步的零件算（整机 17.17 kg，背 5 kg 货）。
> 电机按宇树 GO-M8010-6 官方手册：23.7 N·m、24 V 最高 30 rad/s（电池 22.2 V → 27.8）；膝经同步带 ×1.5 → 35.5 N·m。
> ★ 估的：转速过半以后扭矩直线降到 0、线圈电阻 0.25 Ω、转子惯量、减速器摩擦（等宇树数据）。
> 每个场景有扭矩曲线图 `仿真_*.png` 和动图 `仿真_*.gif`。

## 结果

| 场景（背 5 kg） | 外摆 峰值 / 23.7 | 髋 峰值 / 23.7 | 膝 峰值 / 35.5 | 机身晃 | 结果 |
|---|---|---|---|---|---|
| 站立 | 4.8 | 0.4 | 8.3 | 0° | ✅ |
| 趴下 → 站起 → 趴下 | 9.0 | 16.6 | 10.0 | < 1° | ✅ |
| 小跑 0.5 m/s | 10.4 | 17.1 | 24.2 | < 2° | ✅ 实测 0.50 m/s |
| 小跑 0.8 m/s | 9.9 | 22.0 | 23.2 | < 2° | ✅ 实测 0.80 m/s，髋快到上限 |
| 住宅楼梯 175×260×4 级，正着上（静步） | 23.7（顶到） | 14.4 | 22.7 | 俯仰 ≤ 20° | ✅ 上去了（+701 mm），⚠ 小腿 / 大腿蹭踏步边（最深约 3 mm） |
| 公共楼梯 150×300，正着上 | — | — | — | — | ❌ 摔了：是静步控制器（我写的）的问题，见下 |
| 跨 60 高电缆槽 | — | — | — | — | ❌ 同上 |

- 电机：平地站、起、小跑扭矩都够。小跑 0.5 m/s 膝 99% 时间在 23 N·m 以下（余量约 35%）；0.8 m/s 髋到 22.0，**0.8 m/s 就是上限**，平时用 0.5。
- 功率：站着约 140 W（外摆电机要一直撑着横向，腿在机身外侧），小跑约 225 W。电池 280 Wh 用 85 % → **小跑约 1 小时、站着巡检约 1.7 小时**（★ 线圈电阻是估的）。

## 楼梯：重要发现

1. stair_calc.py 只算了“膝中心离踏步边 15 mm”，但真实的膝（大带轮 + 皮带 + 壳）半径约 31.5 mm，大腿、小腿也有厚度。按真实厚度重新算（膝 ≥ 34、大腿 ≥ 32、小腿 ≥ 18 mm）：
   - **正着上住宅楼梯：只剩 2–6 mm 余量**（后腿的小腿 / 膝贴着踏步边）；公共楼梯约 9 mm。仿真里也确实在蹭。
   - **倒着上（屁股朝楼梯）：20–31 mm**；公共楼梯 26–33 mm。膝朝后的腿倒着上舒服得多。
   - 站着不动的姿势里，“倒着上”和“正着下”是一样的 → **正着下楼梯也舒服**。
2. 倒着上的问题：深度相机在前面，看不到身后的台阶 → 要先正面看清楚、记下台阶，再转身倒着上（或者尾部加一个便宜的深度 / 测距传感器）。
3. 静步控制器（一次抬一条腿、重心始终在三条腿的三角形里）是我为了验证写的简化版，还不够好：公共楼梯、电缆槽、倒着上的物理仿真还会摔。这是控制程序的问题，不是电机或结构的问题（摔之前扭矩都没顶满）。真机上楼梯一般用强化学习训出来的步态，这一块可以以后做。

## 下一步可选

- A：改结构让正着上楼梯也有余量（比如小腿靠膝那一段做细、膝盖帽做小，或大腿 / 小腿各加长 10 mm 再算一遍）。
- B：保持结构，楼梯按“倒着上、正着下”，尾部加一个测距 / 深度传感器。
- C：继续改静步控制器，把公共楼梯、电缆槽、倒着上都跑通。

## 第二版：走楼梯程序改版（2026-10-30）

**结构结论（改正上一版）**：上一版说“正着上楼梯余量只剩 2–6 mm”是把小腿当直圆棍算的，算悲观了。按真实腿外形（髋盘 + 大腿 + 膝圆头 + 带折弯的小腿）把所有走法搜一遍：正着上住宅楼梯余量 18 mm、公共楼梯 20 mm。
小腿的折弯是有用的（改直反而只剩 11 / 13 mm），**腿的结构不改**。对比图：小腿外形对比.png；检查程序：007a/sim/leg_clear.py。

**程序改了什么**（007a/sim/run_sim.py）：
1. 碰撞检查用真实腿外形（轮廓每 4 mm 一个点），离台阶 ≥ 5 mm；膝角放到 40–165°。
2. 节奏：机身每走半个踏步停一次，左右两条腿在同一处先后跨；前腿、后腿的跨步时机分开挑。
3. 稳：抬腿前机身左右挪 ±12 cm、前后挪 ±10 cm，重心离三角形每条边 ≥ 5 cm；一对腿先跨哪条挑稳的。
4. 机身高度 / 俯仰：规则姿势不够好（< 1 cm）时，在 ±5 cm / ±10° 里再挑，每步最多变 2 cm / 5°。
5. 跨的腿按机身**实际**姿势算落点（以前按“应该在的”姿势，机身一滑脚就落偏，越走越歪 —— 这是电缆槽以前摔的原因）；撑着的脚滑了 5 cm 以内就按实际位置撑。

| 场景 | 结果 | 峰值扭矩 外摆 / 髋 / 膝 | 说明 |
|---|---|---|---|
| 住宅楼梯·正着上 | ✅ 走完，升高 716 mm | 21.3 / 16.7 / 33.8 | 腿还会短时擦台阶边；膝短时到 33.8 / 35.5 |
| 跨电缆槽 60 mm | ✅ 通过，没碰 | 9.6 / 11.7 / 24.1 | 晃 2° |
| 公共楼梯·正着上 | ❌ 第 13 步摔 | — | 第一级到第二级之间，规划找不到又稳又不碰的落脚 |
| 住宅楼梯·倒着上 | ❌ 第 8 步摔 | — | |
| 住宅楼梯·正着下 | ❌ 第 25 步摔 | — | 快到底时脚滑 |

**判断**：摔的地方电机扭矩都没到上限，是这个“一次抬一条腿、事先排好”的步态程序能力到头了，不是结构或电机不够。
真机走楼梯一般用强化学习训练出来的步态（边走边看、边调），以后单独做。
