whois169/roboot007v/docs/机械狗007v/软件结构.md

# 机械狗007v 软件结构（先定逻辑，再写代码）

> 2026-10-24 初稿，等你看过、定下来再动手写。
> 下面"已有"是指代码里已经有、并且测过（模拟器或笔记本）；"要做"是还没写的。

## 一、四层

```
第 4 层  大模型（总调度）      听懂你的话 → 决定用哪几个技能 → 汇报结果
            ↑ 看"感觉板"摘要          ↓ 调用技能
第 3 层  自动反应（不经过模型）  一直盯着数据，该停就停、该提醒就提醒；断网、模型卡住也照样工作
            ↑                          ↓
第 2 层  感觉板（数据中心）      所有传感器的最新读数：值、单位、在哪、什么时候测的、可不可信
            ↑ 驱动自己往上送
第 1 层  驱动                    每个硬件一个，只管读数、执行命令
```

规矩：
1. **传感器不等人来问**，驱动读到就往感觉板送。模型想知道什么，看感觉板。
2. **安全的事不交给模型**。急停、台阶、撞东西、断线、电量保护都在第 1–3 层，离硬件越近越好。
3. **模型只拿到"技能"**。每个技能背后必须有真的驱动、真的数据，没有就不给模型（不做假功能）。
4. 每块板和大脑之间都有**心跳**，一边掉线，另一边自己进入安全状态。

## 二、四块"脑子"，各管什么

| 板子 | 在哪 | 管哪些硬件 | 跟谁说话 |
|---|---|---|---|
| **树莓派 5**（大脑） | 机身托板 | 相机 OV5693、激光雷达 LD19、深度相机（以后）；跑大模型对话、看人、记忆、导航 | USB 串口连下面三块 |
| **底盘 ESP32-S3** | 机身托板 | 4 个轮子电机（CAN）、4 个髋电机 + 霍尔编码器、4 个 AS5600 腿角度、4 个台阶测距 VL53L1X、INA226 电池、急停按钮常开触点 | 一根 USB 串口 → 树莓派（协议：`007v/chassis/protocol.py`） |
| **头部传感器 ESP32-S3** | 头里托盘 | 麦克风 ×2、功放、下巴测距 VL53L5CX、毫米波 LD2410B、热成像 MLX90640、红外收 / 发、光照、温湿度、俯仰舵机 STS3215 | 一根 USB → 头部集线器 → 树莓派（协议：`brain/dog/protocol.py`） |
| **屏幕板**（微雪 4.3B） | 头前面 | 屏幕、触摸 | 同上 |

## 三、每个硬件：驱动在哪、数据叫什么、谁用它

| 硬件 | 驱动在哪 | 送到感觉板的数据 | 自动反应（第 3 层）用它做什么 | 模型怎么用到 | 现在 |
|---|---|---|---|---|---|
| 轮子 ×4 + 髋 ×4 | 底盘 ESP32 | 状态、速度、里程、腿角度、载重 | 断线 2 秒自己停；髋卡住停 | 技能 move / turn / stop / posture | 已有（虚拟底盘测过） |
| 急停按钮 | 硬件直接断电机电 + 底盘 ESP32 | 急停中 | 电机断电，要按复位才能动 | 汇报"急停没解除" | 已有 |
| 电池 INA226 | 底盘 ESP32 | 电量 %、电压 | 低于 15% 提醒 | 看感觉板，能回答"还有多少电" | 已有 |
| **台阶测距 ×4** | 底盘 ESP32 | 前后地面距离 | **前面地面突然没了 / 有台阶 → 底盘自己刹车**，再告诉大脑 | 汇报"前面有台阶，停下了" | **要做** |
| **激光雷达 LD19** | 树莓派 | 周围一圈最近的东西（方向 + 距离） | **走的方向上东西太近 → 大脑直接给底盘发 stop / 限速**（不问模型） | 以后：建地图、"去厨房" | **要做** |
| 下巴测距 VL53L5CX | 头部 ESP32 | 正前方 8×8 距离 | 和雷达一起防撞（雷达看不到的矮东西） | 看感觉板 | 协议有，驱动要做 |
| 相机 | 树莓派 | 有没有人、是谁、在哪个方向 | 有人看着它说话 → 开始听 | 技能 enroll / forget_person；以后"看一下"给看图模型 | 已有（笔记本摄像头测过） |
| 麦克风 ×2 + 功放 | 头部 ESP32 装成 USB 声卡，树莓派当普通声卡用 | 声音 | 说话检测 | 对话 | 笔记本上已有 |
| 毫米波 LD2410B | 头部 ESP32 | 有没有人、多远（不动、背对也测得到） | 有人进屋 → 可以主动打招呼 | 看感觉板 | 协议有，驱动要做 |
| 热成像 MLX90640 | 头部 ESP32 发画面，树莓派分析 | 热源、方向、最高温 | 高温主动提醒 | 技能 display thermal | 已有（模拟器） |
| 红外收 / 发 | 头部 ESP32 | 学到的码 | — | 技能 ir_learn / ir_send / ir_forget | 已有（模拟器） |
| 光照、温湿度 | 头部 ESP32 | lux、°C、% | 太热 / 太冷 / 太潮提醒 | 看感觉板 | 已有（模拟器） |
| **俯仰舵机** | 头部 ESP32 | 头的角度 | — | **技能 look 现在只是屏幕上眼睛往那边看，头不会动** | **要做** |
| 屏幕 + 触摸 | 屏幕板 | 点屏幕 | 点一下 = 叫醒 / 打断 | 技能 display、眼睛 | 已有 |
| **灯**（腰线、尾灯、前照灯、关节光环） | 机身的灯归底盘 ESP32，头上的光环归头部 ESP32 | — | 状态灯：电量、急停红闪、刹车尾灯 | — | **要做（灯的型号也还没选）** |

## 四、自动反应清单（第 3 层，全部不经过模型）

| 什么情况 | 谁来管 | 怎么反应 | 现在 |
|---|---|---|---|
| 按了急停 | 硬件 + 底盘 | 电机断电；屏幕变红；要复位 | 已有 |
| 大脑掉线 2 秒 | 底盘 | 自己慢慢停下 | 已有 |
| 前面地面没了 / 台阶 | 底盘 | 马上刹车，报 `CLIFF`；只允许往后退 | 要做 |
| 走的方向上快撞到 | 大脑（雷达 + 下巴测距） | 越近限速越低，太近就停 | 要做 |
| 髋卡住、轮子没回应 | 底盘 | 停下报故障 | 已有 |
| 电量低 | 底盘报、大脑处理 | 提醒；以后自己回去充电（不做自动回充，先只提醒） | 已有提醒 |
| 有人看着它说话 | 大脑 | 开始听 | 已有 |
| 屋里有高温热源 | 大脑 | 主动提醒 | 已有 |

## 五、查出来的问题和决定（2026-10-24 已定）

1. **麦克风和喇叭怎么接到树莓派（最重要）**
   麦克风 INMP441、功放 MAX98357A 都是接在头部 ESP32 上的，可现在头部 ESP32 和树莓派之间只有"一行一条 JSON"的串口协议，是给传感器读数用的，没设计传声音（声音是连续不断的，每秒 256 千位，硬塞进去会把传感器消息堵住，大脑这边也要自己拼声音）。两个办法：
   - **A（已定）**：头部 ESP32 用 USB 同时假装成一块"USB 声卡"。树莓派把它当普通麦克风和喇叭用，大脑程序不用改；工作量在 ESP32 固件里，硬件不用再买。
   - B：另买一个 USB 麦克风阵列 + USB 小喇叭直接插头部集线器（约 150–300 元）。简单，但已经买的麦克风和功放就用不上了，头里还要重新留位置。
2. **灯由谁控制（已定）**：机身上的灯都归底盘 ESP32（它最先知道急停、刹车、电量），头上的光环归头部 ESP32。灯的型号还没选，要先定型号。
3. **"look 看向"要真动（已定）**： 上 / 下 = 俯仰舵机真的抬头低头；左 / 右 = 底盘原地转一点（脖子没有左右转的关节）。
4. **布线图有一处旧了**：接线图上台阶测距还写着"在腿上"，实际已经挪到机身前后，要改。

## 六、写的顺序（建议）

1. 先改协议（纸面上）：底盘加台阶、灯；头部加舵机、声音走法。你看过再写。
2. 底盘 ESP32 固件：照着已经测过的 `chassis/controller.py` 翻成 C++，加台阶刹车。**最先做，因为安全都在这里。**
3. 树莓派：雷达驱动 + 防撞。
4. 头部 ESP32 固件：传感器、舵机、声音。
5. 每到一个硬件，先单独测它的驱动，测通了再接进大脑；每一步跑回归测试，不能把以前测通的弄坏。
