whois169/roboot007v/docs/机械狗007v/选型计算书.md

# 机械狗007v选型计算书

> 第 1 版，2026-10-16。外观按 `docs/概念/机械狗007v_外观v10.html`。
> 计算程序：`007v/sizing.py`（所有输入都在文件最上面，零件到货实测后改数字重新跑）。
> 价格是国内零售的大概价，**以下单时为准**。每个零件都写了“硬指标”，换店比价时只要满足硬指标就行。

## 一、定下来的需求
| 项 | 要求 |
|---|---|
| 载重 | 背上货斗驮 **5–10 kg**（按 10 kg 设计） |
| 地面 | 商场、超市、小区平整路面；10% 的坡；先做平地，跨 8–10 cm 小坎以后再验证 |
| 速度 | 平时 1.0 m/s，能跟上人走路（约 1.4 m/s） |
| 轮子 | 麦克纳姆轮（能横移、原地转） |
| 续航 | 平地 2 小时以上 |
| 费用原则 | 能省则省，**不牺牲质量和功能**；会坏、影响安全的地方不省 |
| 不变的 | 树莓派 5、头部 ESP32-S3、大脑程序、语音合成服务、传感器清单 |

## 二、算出来的结果（`python 007v/sizing.py`）
| 项 | 结果 |
|---|---|
| 整机自重 | 约 **15.6 kg**；加 10 kg 货物 **25.6 kg** |
| 每个轮子受力 | 平时 6.4 kg；抬一条腿时最重的那个约 **12.8 kg** |
| 轮子扭矩 | 持续 1.23 N·m（10% 坡匀速），峰值 1.58 N·m（坡上起步） |
| 轮子转速 | 巡航 126 转/分，跟人走 176 转/分（152 mm 轮） |
| 髋关节扭矩 | 行驶时 6.1 N·m；抬一条腿最大 **12.3 N·m**；从趴着撑起来最大 10.7 N·m |
| 稳定性 | 满载重心高约 0.30 m：侧翻临界 29°，前后翻临界 40°（10% 坡只有 5.7°） |
| 续航 | 平地巡航约 56 W → **3.3 小时**；加机载电脑约 71 W → 2.6 小时；站着不动约 9 小时 |

计算用的假设：麦轮滚动阻力系数 0.08（比普通轮大）、麦轮传力效率 0.7、安全系数 1.5、起步加速度 0.5 m/s²。

## 三、选型和理由

### 1. 轮子电机：扁平关节电机 ×4（推荐 SteadyWin GIM4310-10）
**为什么必须是“扁的”**：轮子挂在摆臂末端，折叠时摆臂翻上来，轮子贴到车身侧面。普通的 42 mm 行星减速电机加减速箱有 12–15 cm 长，要和轮子同轴装，折叠时会捅进车身，展开时车身两边也会被撑宽到半米。扁平电机只有约 4 cm 厚，能贴着轮子装进轮毂一侧。

| 候选 | 额定 / 峰值扭矩 | 最高转速 | 尺寸、重量 | 结论 |
|---|---|---|---|---|
| **SteadyWin GIM4310-10（V1.1）** | 2.05 / 5.6 N·m | 228 转/分 | Φ53×38 mm（含驱动），227 g | **推荐**：扭矩余量 1.7 倍，最高约 1.54 m/s，跟得上人走路 |
| 达妙 DM-J4310-2EC（V1.2，24V） | 3.5 / 12.5 N·m | 200 转/分 | Φ57×46 mm，325 g | 扭矩更大，但最高约 1.35 m/s，跟不上人走路；要更快得用 48V 版 |

**硬指标**：直径 ≤ 60 mm、厚 ≤ 45 mm；24V；额定 ≥ 1.9 N·m、峰值 ≥ 2.4 N·m；带载 ≥ 180 转/分；自带驱动和编码器；CAN 控制。
注意买 **V1.1**（V1.0 的额定扭矩低）。约 **500–650 元/个**。

### 2. 轮子：~~152 mm~~ → ~~127 mm~~ → **110 mm 铝合金麦克纳姆轮 ×4**（2026-10-17 外观定稿时改小两次）
- 127 mm 的轮子要转得更快才跟得上人，而且普通款每个只能保守扛 10–12 kg，抬腿时最重的轮子要扛约 12.8 kg，不够。
- 6 寸轮子转得慢一点就够快，过小坎、地砖缝也更从容，外观也更接近效果图。

**硬指标**：直径 150–155 mm；**金属轮毂**；**带轴承的聚氨酯滚子**；单轮额定载重 ≥ 20 kg；左旋、右旋各 2 个；轮毂能和电机法兰对接（需要转接法兰的话，我们自己做铝件）。约 **400–600 元/套**。

**2026-10-17 外观定稿改成 127 mm**：用户觉得 152 太大不好看。127 宽 40、单轮约 0.68 kg、要求单轮额定 ≥15 kg（抬腿时最重的轮约 12.5 kg）。代价：GIM4310-10 带载最高约 1.3 m/s（平地仿真能到 1.4 但电机顶到转速上限、没余量），正常走路能跟上，快走会落后；坡道扭矩反而更富余（需求 1.0 N·m）。整机 62.2 × 43.0 × 45.6 cm，自重约 15 kg。

**同一天再改成 110 mm**：用户还是嫌大。110 宽 40、14 个滚子、单轮约 0.56 kg。代价：GIM4310-10 带载最高约 **1.1 m/s**（慢走能跟上，快走会落后；要找回 1.4 得换更高转速的轮电机）；平地仿真按 1.1 m/s 测，急停减速 3.6 m/s²、后轮不翘 ✓。过 15 mm 门槛时髋扭矩 20.2 N·m，贴着上限 20.7，**过门槛要慢到 0.3 m/s**（这时只有 11.7）。整机 60.5 × 43.0 × 44.7 cm，自重约 14.7 kg。

**外观定稿 v4（2026-10-18）改成 Φ97，结构也变了**：用户要腿更细、轮子更小，并且不再往上折叠（最多趴平）。
- 轮子 Φ97 × 40（左旋 2、右旋 2），装在腿外侧，外侧面和腿外侧面齐平；最高约 1.0 m/s（GIM4310-10 空载 228 转/分），坡道和加速扭矩余量 2.8 倍。
- 轮子电机在腿板内侧、露在机身下方（不往上折叠所以碰不到机身），外面一个 PA12-CF 打印的护罩兼电机支架。
- 轮子只靠内侧一边支撑：电机输出盘 → 带法兰的轮轴（B08）→ 腿板内侧的轮轴承座（B07，两个 6801-2RS）→ 麦轮。轮子重量由轴承扛，不压电机轴。
- 腿：6 mm 铝腿板（臂根板一直延长到轮轴）承力，外面浅色打印臂座 + 4 mm 铝外板；腿厚 49 mm。
- 每条腿加一个 VL53L1X 台阶测距，看门槛和楼梯口；15 mm 门槛必须减速到 0.3 m/s 再过（0.8 m/s 直接压髋要 22 N·m，超过 20.7 的额定）。
- 整机约 59 × 42 × 46 cm（站立），趴平时长约 74 cm；自重约 16.5 kg。

**第 4 步查资料后定（2026-10-16）**：买**宽 45、15 个轴承滚子的铝合金款**。标“重载”的 152 麦轮（如 Nexus 14169）宽 79、单个 2.3 kg、轴孔 30，太宽太重。轮宽从 50 改 45 后整机宽 428 mm。电机和轮毂之间用自己做的铝转接法兰（图纸 B03）。

### 3. 髋关节：金属蜗轮减速电机 + 3:1 同步带 ×4
- **保留蜗轮“自锁”**：驮着 25 kg 站着**不用通电、不发热**；突然断电也不会塌下去。对运输车来说，这比关节模组更合适，因为腿大部分时间是不动的。
- 常见的 5840 金属齿轮蜗轮电机额定约 **6.9 N·m（70 kg·cm）**，单独不够（抬腿要 12.3 N·m）。**后面再接一级 3:1 同步带减速**：额定变成约 **20.7 N·m**，余量 1.7 倍；蜗轮本身只承受三分之一的力，寿命长得多；皮带还能吸收一点冲击。
- 选 24V 40 转/分那一档，经过 3:1 后髋转速约 13 转/分（80°/秒），折叠一次两三秒。

**硬指标**：24V；**金属齿轮**；额定 ≥ 60 kg·cm；输出轴 8 mm D 形或更粗；带霍尔编码器；**自锁**；约 40 转/分；单个 ≤ 0.5 kg。
注意：网上同叫“5840”的电机参数差很多，**以卖家给的规格书为准**，不要只看标题。约 **100–150 元/个**。
同步带：HTD 3M 或 GT2 9 mm 宽，带轮 15T / 45T（铝），髋轴 Φ12 钢轴 + 两个 6001 轴承。约 **50 元/套**。

**角度**：每个髋轴上装一个 **AS5600 磁编码器**，开机就知道腿在什么角度，不用回零。约 10 元/个。

### 4. 头部俯仰：总线舵机 ×1
带位置反馈的总线舵机（如飞特 STS3215 一类），能读回头的实际角度。头只有约 0.4 kg，扭矩绰绰有余。约 **100 元**。

### 5. 头部屏幕：4.3 寸 800×480 的 ESP32-S3 一体屏板
- 它本身就是一块 ESP32-S3（8 MB PSRAM），所以“头部 ESP32-S3”不变，现在的 HUD 程序移植过去就行；
- 屏幕显示区约 95×54 mm，正好放进效果图里的屏幕脸；
- 推荐带 7–36V 宽电压输入的版本（如微雪 ESP32-S3-Touch-LCD-4.3B），供电更省事。约 **200–270 元**。

### 6. 电池：6S2P 21700 锂电组
- **品牌电芯**（如三星 50E、Molicel P42A），6S2P = 22.2V、10 Ah、约 216 Wh；
- 带**均衡保护板**，持续放电 ≥ 30 A；配 25.2V 充电器；
- 电芯质量直接关系安全和寿命，**这一项不省**。约 **600–800 元**（含保护板和充电器）。

### 7. 控制和驱动
| 部分 | 选什么 | 说明 |
|---|---|---|
| 大脑 | 树莓派 5（不变） | USB 连两块 ESP32-S3 |
| 底盘控制 | **新增一块 ESP32-S3** | 管 4 个髋电机（PWM + 编码器 + AS5600）和 4 个轮子电机（CAN，加一个 CAN 收发芯片） |
| 髋电机驱动 | 带电流检测的双路驱动板 ×2（单路 ≥ 7 A 持续） | 堵转、过流马上停，这是安全功能 |
| 轮子电机驱动 | 电机自带 | 不用另买 |
| 头部 | 4.3 寸 ESP32-S3 屏板 | 屏幕、触摸屏、传感器、红外、热成像 |

**原计划里的达妙 MC02 主控和 12 个达妙电机都不买了。**

### 8. 供电
```
6S 电池（22.2V）─ 总开关 ─ 急停 ─┬─ 轮子电机 ×4（24V 直接供）
                                 ├─ 髋电机驱动 ×2（24V 直接供）
                                 ├─ DC-DC 5V 5A → 树莓派 5（单独一路）
                                 ├─ DC-DC 5V 3A → 头部屏板、传感器、雷达
                                 └─ 头部舵机（按舵机电压，可能要一路 DC-DC）
```

## 四、费用（电机、驱动、电池这一部分）
| 项 | 约 |
|---|---|
| 轮子电机 ×4 | 2000–2600 |
| 152 mm 重载麦轮 ×4 | 400–600 |
| 髋蜗轮电机 ×4 + 同步带 ×4 + AS5600 ×4 | 650–850 |
| 髋电机驱动 ×2 | 150–250 |
| 底盘 ESP32-S3 + CAN 收发 | 50 |
| 头部总线舵机 | 100 |
| 电池 + 保护板 + 充电器 | 600–800 |
| **合计** | **约 4000–5200 元** |

不含：头部屏板（约 200–270）、激光雷达（约 280）、铝型材和铝板、轴承螺丝、打印耗材、传感器。

## 五、先买样品，测完再批量
| 样品 | 测什么 | 合格标准 |
|---|---|---|
| 轮子电机 ×1 + 麦轮 ×1 | 带 6.4 kg 负载转起来的转速、电流、温升；控制是否平稳 | 带载 ≥ 180 转/分；连续跑 30 分钟温升 ≤ 40°C |
| 髋蜗轮电机 ×1 + 同步带 | 输出端挂重物测扭矩；断电后能不能锁住；空程（来回晃的间隙） | 3:1 后额定 ≥ 18 N·m；挂 13 N·m 断电不动；空程 ≤ 1° |
| 电池 | 实际容量；满载放电时保护板会不会跳 | 容量 ≥ 9.5 Ah；30 A 放电不跳 |

测完把实测数字填回 `007v/sizing.py` 顶上，重新算一遍。

## 六、还没解决、要在后面验证的
1. ~~抬一条腿时站不站得稳~~ → **第 3 步仿真已解决**：先把同一侧另一条腿收到 100°、对面两条腿放到 50–65°，再抬，满载四条腿都能抬 10 cm、重心在里面约 5 cm（`docs/机械狗007v/仿真报告.md`）。上台阶的完整动作第一代先不做。
2. **麦轮和电机法兰怎么对接**：取决于买到的麦轮轮毂孔位，可能要做一个铝转接法兰。
3. **蜗轮自锁的代价**：腿是“硬”的。仿真：满载 0.8 m/s 压 15 mm 门槛，髋冲到 17.3 N·m（额定 20.7），0.3 m/s 过只有 10.4。程序上看到门槛减速；结构上第 4 步给同步带加弹簧张紧或橡胶缓冲。

**第 3 步仿真结论**：所有场景（站立、起身趴下、加速到最高速（110 轮后是 1.1 m/s）、急停、10% 坡、横走、原地转、过门槛、抬腿）电机都在额定以内，选型不用改。

## 参考来源
- [SteadyWin GIM4310-10 参数（OpenELAB）](https://openelab.com/products/steadywin-gim4310-10-precision-joint)
- [达妙 DM-J4310-2EC V1.2 参数](https://eckstein-shop.de/dm-j4310-2ec-v1-2-24v-dual-encoder-servo-motor_1)
- [127 mm 铝麦轮载重（EasyMech，各页 10–20 kg 不等）](https://st.robu.in/product/set-127mm-aluminum-mecanum-wheels-set-2-left-2-right)
- [5840 金属齿轮蜗轮电机带编码器，额定 70 kg·cm（E-S Motor）](https://ca.robotshop.com/products/e-s-motor-high-torque-gearmotor-self-locking-worm-gear-motor-w-encoder-24v-56rpm)
- [Micro DC Motors 5840 系列（不同减速比参数）](https://microdcmotors.com/product-category/5840-worm-gear-motor)
- [微雪 ESP32-S3 4.3 寸 800×480 屏板（Type B）](https://www.waveshare.com/esp32-s3-touch-lcd-4.3b.htm?sku=27848)
