whois169/roboot007v/docs/扩展规划_投影与传感器.md

# 扩展规划：胸口投影 + 传感器分梯队（2026-10-08，总指挥讨论记录）

> 这是讨论记录，后面还会深化。已经落实到设计里的只有“第一梯队”的两样（v0.4.1：`cad/head.py` 预留了安装位，`零件尺寸收集清单.md` 加了要量的尺寸）。其余都还没进设计。

---

## 一、胸口微型投影（决定：加，装胸口，以后再选型）

### 先说清楚物理限制（免得以后失望）
- 能装进狗身上的微型投影，亮度大约 **100 流明**量级（体积小、发热低）；正经会议室投影仪一般 **3000 流明以上**。
- 能看清的场合：小会议室拉上窗帘、或者开着灯但不太亮的屋子，投到 1–2 米外的白墙上，40–60 寸画面。
- 看不清的场合：大会议室、开着大灯，画面很淡，比不过会议室自己的投影仪。
- **定位：随叫随到的小型投影，不是会议室投影仪的替代品。** 小团队开会、在客户那边临时演示、在家里投个视频，够用。

### 装在哪：胸口（脖子下方），朝前投；不能装头上
- 头已经很重：之前脖子俯仰电机顶到力矩上限，是靠把俯仰轴往前移 12mm 才解决的（v0.3.3）。投影机加散热一两百克，脖子扛不住。
- **狗的身体本身就是投影支架**：
  - 坐下：身体前高后低，正好朝前上方投到墙上；
  - 站着微微低头：投到地上，显示箭头、地图；
  - 画面歪了，它自己用腿调身体姿态把画面摆正。普通投影仪要靠支架和梯形校正，它自己就能调。

### 开会时能干嘛
1. **投屏**：手机或电脑上的 PPT 投过去，树莓派上跑投屏软件。
2. **会议助手**（真正有价值的地方）：
   - 用麦克风听会议，实时转成文字；
   - 墙上投出“会议要点”“待办事项”，边开边更新；
   - 散会后把纪要发到手机。
   - **规矩**：开始记录前先问在场的人“可以记录吗？”，同意了才录。别人的会议内容不上传、不乱存。
3. **随叫随到**：说一句“过来，投到这面墙上”，它自己走过去、找空白墙面、坐下、对准。**这一条最能体现它和投影仪的区别：自己找位置，自己对准。**

### 怎么实现（以后再比较）
- **A**：买便宜的成品迷你投影，拆出光机和驱动板，HDMI 接树莓派。便宜，但拆机折腾。
- **B**：用 TI 专门给树莓派设计的 DLP 小投影模块。接口现成，尺寸规整，好装进机身。
- 电子产品越晚买越便宜、越亮，到 P5 整机阶段再选。

### 要注意的
- **耗电**：投影大约 10W。狗坐着投影时腿基本不用力，电池扛得住。
- **发热**：机身里本来就设计了 4010 风扇，可以共用风道。

---

## 二、传感器分梯队

### 第一梯队：现在就进头部设计（已落实，v0.4.1）
| 传感器 | 价格 | 能干嘛 | 为什么现在加 |
|---|---|---|---|
| **红外遥控收发**（红外发射管 + VS1838B 类接收头） | 几块钱 | 学习并控制电视、空调、风扇。比如“把空调调到 26 度”，它转头对准空调发信号 | 去别人家也能用，不需要人家有智能家居。音箱做不到，因为音箱不能走到空调前面。头的朝向可以调，正好用来瞄准 |
| **热成像 MLX90640**（32×24） | 一两百块 | 黑暗里看见人；发现发热的插座、充电器、没关的电热器；判断灶台关没关、热水凉没凉；大致看人的体表温度 | 镜头很小（约 Φ9），头部正面传感器带放得下。屏幕和手机 App 上切到“热成像模式”叠加伪彩色，是机器狗最有标志性的画面之一 |

现在定下来的原因：头壳等零件到货就要重画，现在把这两样加进去，以后不用再改一次设计（设计变更最麻烦）。
- 红外收发很便宜，直接买。
- 热成像预算够就现在买，到货量尺寸；不够就先按官方尺寸留好位置（已留），以后再买。

### 第二梯队：身体上加（P5 整机阶段）
| 传感器 | 能干嘛 | 科技感体现 |
|---|---|---|
| CO₂ 传感器 SCD40 | 测每个房间空气闷不闷，提醒开窗 | 手机 App 上的空气质量分布图 |
| 强光补光灯 | 黑暗里照明、巡检 | 夜间巡逻模式 |
| UWB 定位 | 精确跟着你走（“跟我来”），去别人家也能用 | 跟随模式，地图上显示你的位置 |
| 低功率激光指示器 | 找到东西后打一个红点：“钥匙在这” | 很酷。**必须用 1 级/2 级低功率的，并且软件规定：检测到人脸方向时禁止发射** |

### 第三梯队：远期
- **3D 深度相机**：识别台阶、物体形状，以后给机械臂用。
- **微型投影**：见第一部分（胸口，地上投箭头指路、墙上投信息）。

### 夜视
不单独加。热成像 + 激光雷达在全黑环境里都能工作，已经覆盖“黑暗中看见”。想要夜视画面的话，问摄像头卖家 OV5693 有没有“红外夜视版”（带 IR-CUT 自动切换），以后换一个模组就行，不影响设计。

---

## 三、科技感的“出口”：屏幕和 App 的模式切换
传感器多了，要让人看得到它在用什么：

| 模式 | 头部屏幕 / 手机 App 上 |
|---|---|
| 普通模式 | HUD 眼睛（现在是：平时数据流，有人时眼睛拼出来） |
| 热成像模式 | 伪彩色画面（HUD 里已有 THERMAL 状态，现在是假数据） |
| 雷达模式 | 周围的人显示成点 |
| 扫描模式 | 建图动画（HUD 里已有 SCAN 状态） |
| 巡检模式 | 机身灯带流动 |

说一句“切到热成像”，它的眼睛和手机就同时切过去。

---

## 四、待办（以后深化时从这里接着做）
- [ ] 淘宝加购：红外发射管 + 红外接收头；MLX90640 看预算（买之前确认板子尺寸，见《零件尺寸收集清单》）
- [ ] 红外和热成像到货后：量尺寸，改 `cad/head.py` 的 `IR_TX`、`IR_RX`、`THERMAL`，重跑验证流程
- [ ] 大脑软件：红外学习/发射技能（“把空调调到 26 度”）、热成像接进感觉板和 HUD 的 THERMAL 模式（替换假数据）
- [ ] P5：胸口投影选型（A 拆机 / B TI DLP 模块），机身里留安装位和风道；会议助手（先征得同意才记录）
- [ ] P5：第二梯队传感器进机身设计
- [ ] 手机 App：模式切换和 HUD 同步
