whois169/roboot007v/ref/xt60/XT60E-M.pdf

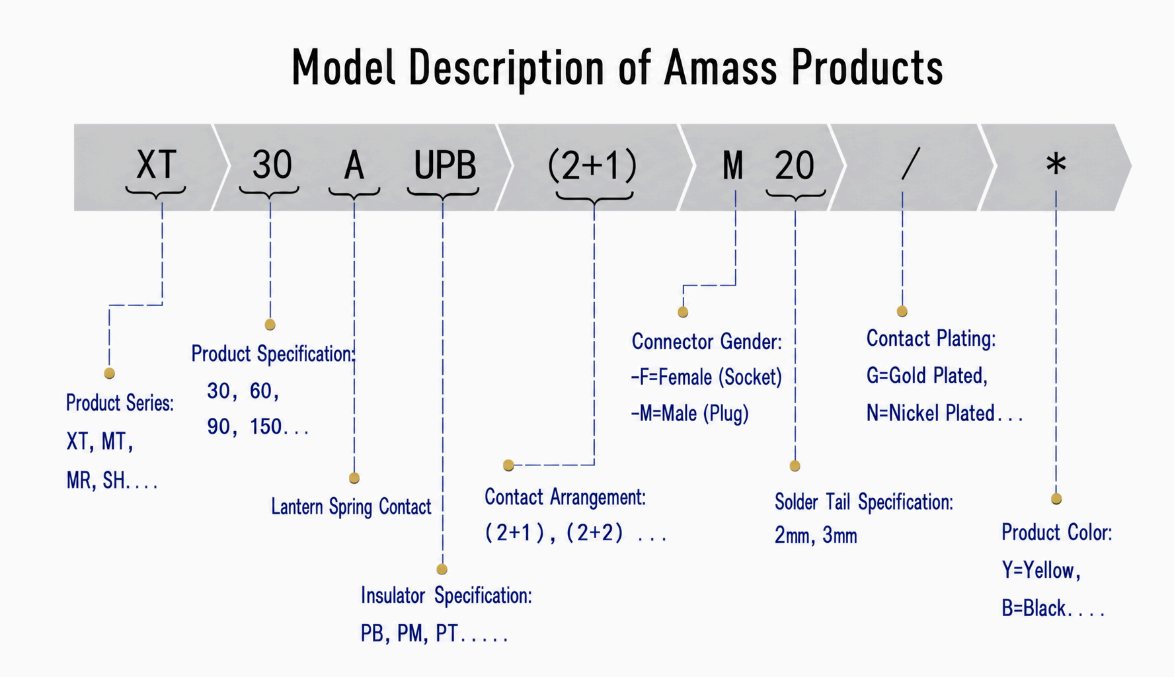
[picture p3: page 1]
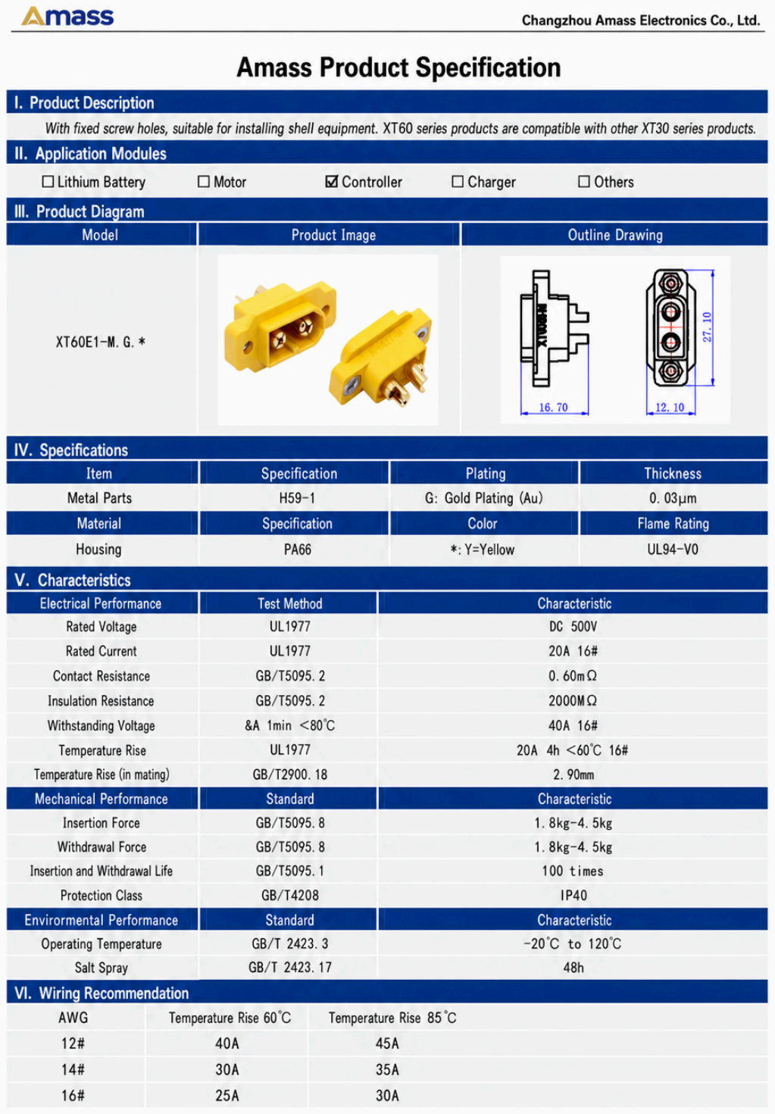
[picture p4: page 2]
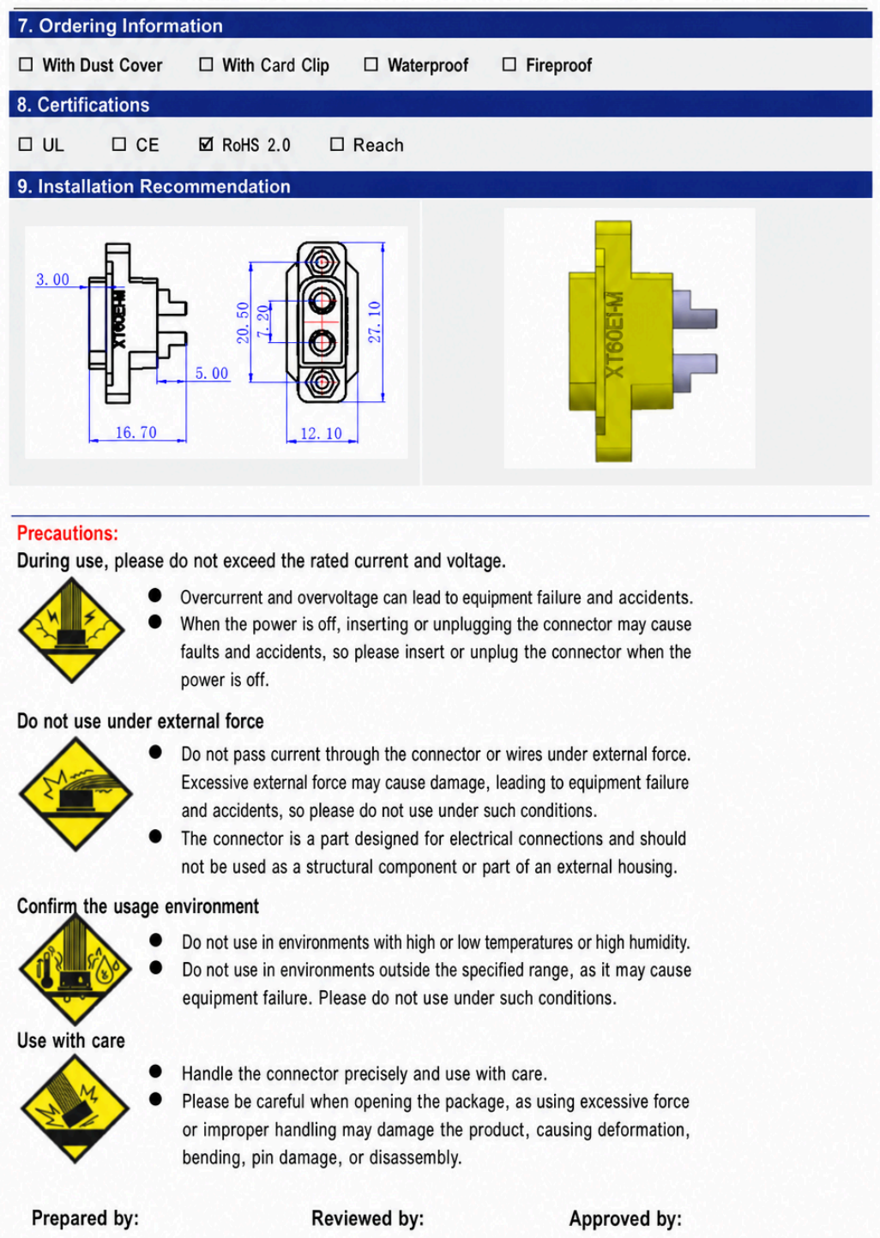
[picture p5: page 3]
