whois169/roboot007v/bb/out/report.txt

笨笨 Mini（BB-01）骨架检查报告  2026-10-16 01:10
改尺寸：bb/config.py；重新生成：python bb/build.py

【姿态】
  行驶（平视）：摆臂 +55.0°，头 +0°，机身底离地 155 mm → 长 647 × 宽 438 × 高 468 mm
      滑撬离地 149 mm；轮子最低 0.0 mm；除轮子和滑撬外最低的是 前右摆臂外板（42 mm）
  行驶（抬头）：摆臂 +55.0°，头 -35°，机身底离地 155 mm → 长 647 × 宽 438 × 高 468 mm
      滑撬离地 149 mm；轮子最低 0.0 mm；除轮子和滑撬外最低的是 前右摆臂外板（42 mm）
  行驶（低头）：摆臂 +55.0°，头 +20°，机身底离地 155 mm → 长 647 × 宽 438 × 高 468 mm
      滑撬离地 149 mm；轮子最低 0.0 mm；除轮子和滑撬外最低的是 前右摆臂外板（42 mm）
  折叠：摆臂 -110.0°，头 +15°，机身底离地 6 mm → 长 411 × 宽 438 × 高 319 mm
      滑撬离地 0 mm；轮子最低 149.8 mm；除轮子和滑撬外最低的是 右侧板（6 mm）
  机身坐上滑撬时的摆臂角 -3.4°（从这里往上翻，轮子离地）

【干涉检查】（实体求交，> 2 mm³ 算撞；转轴、皮带、卡槽这些本来就套在一起的不算）
  行驶（平视）：0 处
  行驶（抬头）：0 处
  行驶（低头）：0 处
  折叠：0 处

【折叠过程 + 抬头低头】（每 2° 摆一次，算不同刚体之间的最近距离；40 mm 以外不细算；髋部轴承座和臂座之间固定的 1 mm / 3 mm 转动缝不算）
  全程没有相撞，也没有零件进到地面以下
  机身 ↔ 屏幕头：最近 3.6 mm（雷达 ↔ 屏幕头，③行驶时抬头到低头，摆臂 +55°、头 -35°）
  前左腿 ↔ 机身：最近 4.0 mm（左肩座 ↔ 前左麦轮轮毂，②摆臂往上往里翻，摆臂 -72°、头 +15°）
  前右腿 ↔ 机身：最近 4.0 mm（右肩座 ↔ 前右麦轮轮毂，②摆臂往上往里翻，摆臂 -65°、头 +15°）
  后左腿 ↔ 机身：最近 5.0 mm（甲板 ↔ 后左麦轮外包络，②摆臂往上往里翻，摆臂 -45°、头 +15°）
  后右腿 ↔ 机身：最近 5.0 mm（甲板 ↔ 后右麦轮外包络，②摆臂往上往里翻，摆臂 -45°、头 +15°）
  前左腿 ↔ 后左腿：最近 32.6 mm（前左麦轮外包络 ↔ 后左麦轮外包络，②摆臂往上往里翻，摆臂 -110°、头 +15°）
  前右腿 ↔ 后右腿：最近 32.6 mm（前右麦轮外包络 ↔ 后右麦轮外包络，②摆臂往上往里翻，摆臂 -110°、头 +15°）
  ①轮子着地、机身降到滑撬上：除轮子和滑撬外离地最低 6 mm（左侧板）
  ②摆臂往上往里翻：除轮子和滑撬外离地最低 6 mm（左侧板）
  ③行驶时抬头到低头：除轮子和滑撬外离地最低 42 mm（前左摆臂外板）

【重量和重心】
  空车：15.6 kg，重心 x +9 / y +0 / 离地 188 mm
      前轮各 4.1 kg、后轮各 3.8 kg；撑住车身的髋扭矩 前 3.9 / 后 3.6 N·m
      侧翻临界 38°，往前翻 52°，往后翻 54°
      其他腿不动、直接抬一条腿，重心离三轮三角形的边：前左 -5 mm，前右 -4 mm，后左 +4 mm，后右 +5 mm（正 = 在里面；要靠调姿势加大，见仿真报告）
  满载 10 kg：25.6 kg，重心 x -24 / y +0 / 离地 274 mm
      前轮各 5.8 kg、后轮各 7.0 kg；撑住车身的髋扭矩 前 5.5 / 后 6.7 N·m
      侧翻临界 29°，往前翻 45°，往后翻 39°
      其他腿不动、直接抬一条腿，重心离三轮三角形的边：前左 +12 mm，前右 +12 mm，后左 -12 mm，后右 -12 mm（正 = 在里面；要靠调姿势加大，见仿真报告）
  满载从趴着撑起来：髋扭矩最大 11.5 N·m（摆臂 +1°）；髋驱动额定约 20.7 N·m

【整机宽度】
  机身 240 + 两边各（间隙 5 + 轮宽 50 + 轮子电机 38 + 外板 6）= 438 mm

零件 152 个，自重合计 15.6 kg（含外壳 1.5 kg）；用时 8 秒
