whois169/roboot007v/007a/concept/007A_方案草图_v1.png

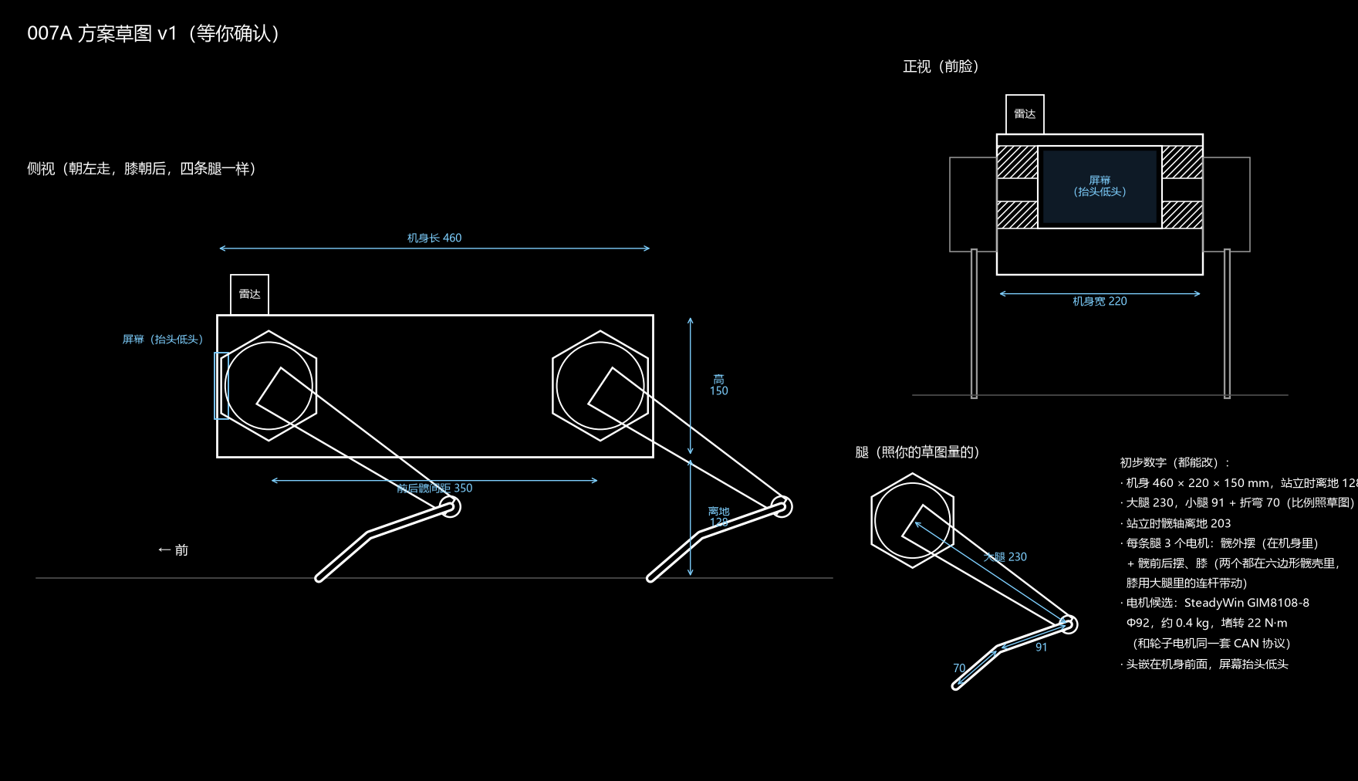
007a/concept/007A_方案草图_v1.png
