whois169/roboot007v/007a/out/drawings/A01_A01底板.png

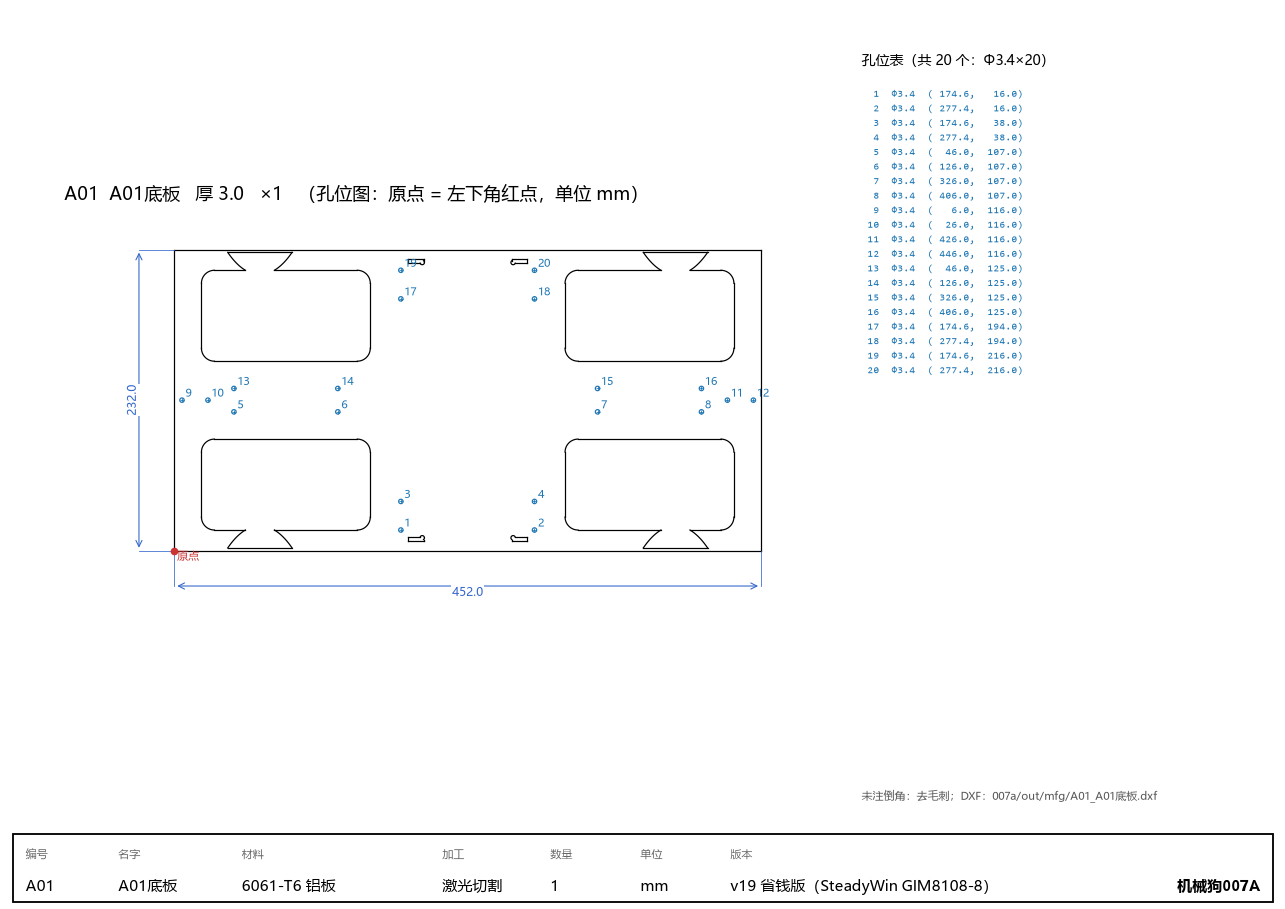
007a/out/drawings/A01_A01底板.png
