whois169/roboot007v/007a/out/drawings/A02_A02外摆隔板前.png

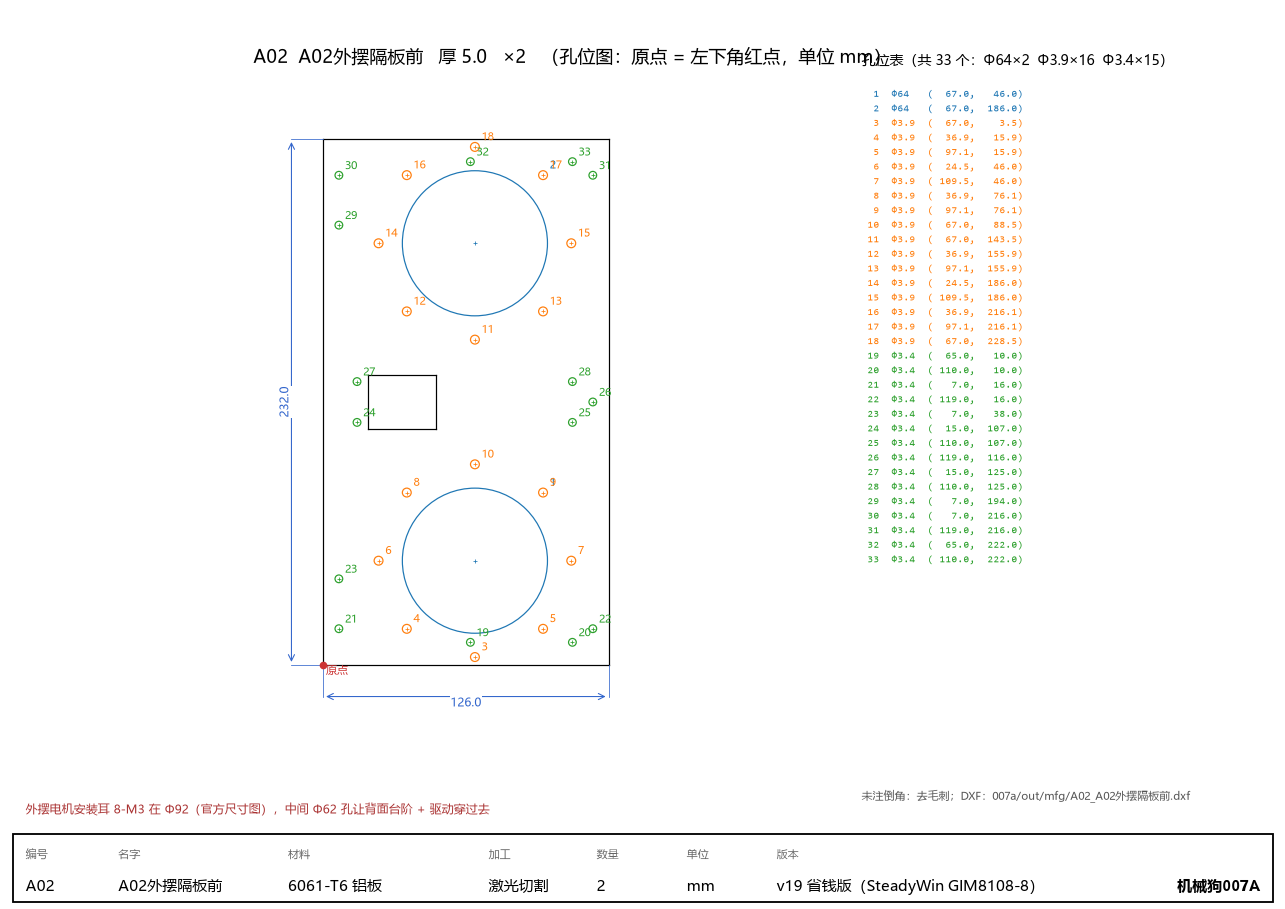
007a/out/drawings/A02_A02外摆隔板前.png
