whois169/roboot007v/007a/out/drawings/A03_A03侧梁左.png

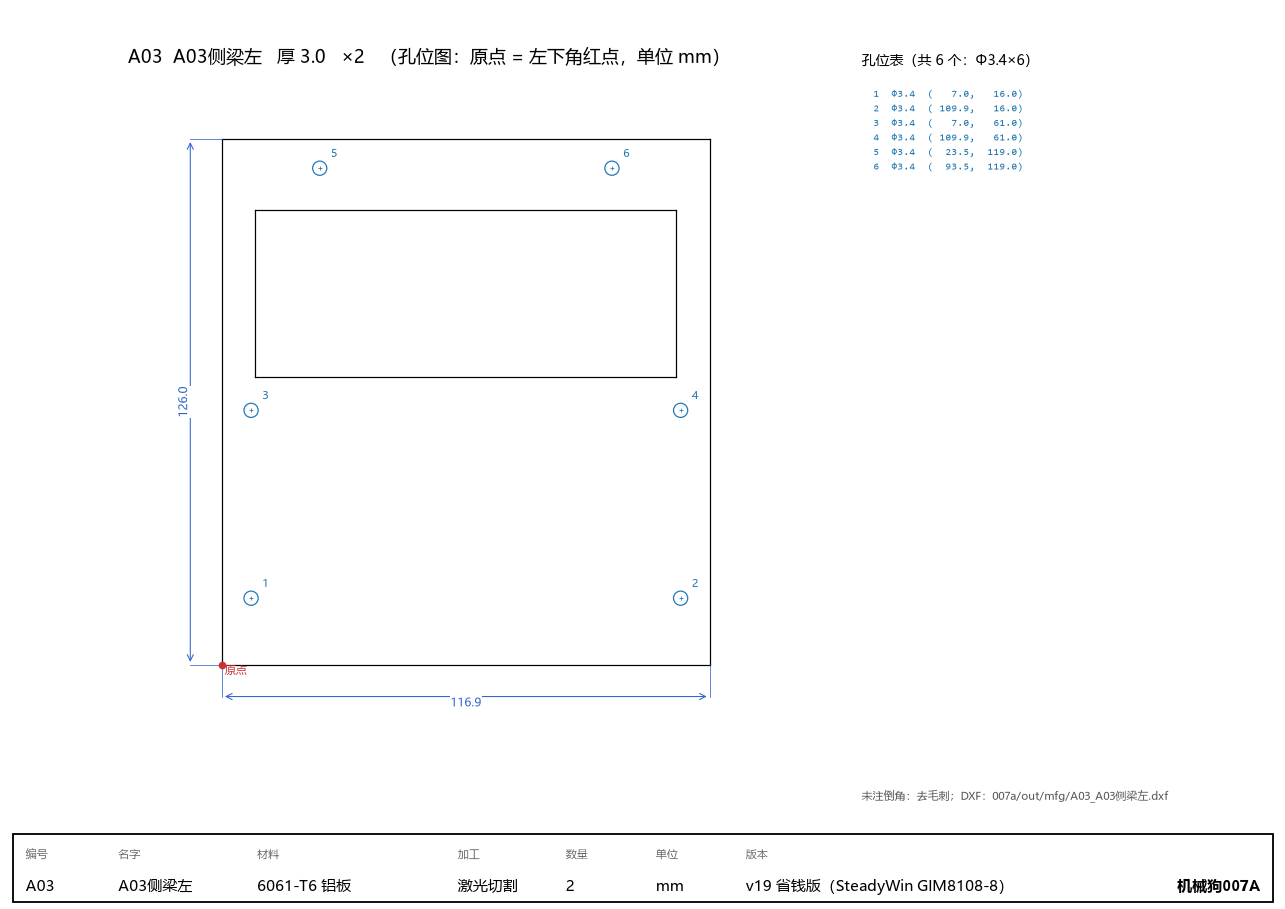
007a/out/drawings/A03_A03侧梁左.png
