whois169/roboot007v/007a/out/drawings/A04_A04纵梁前左.png

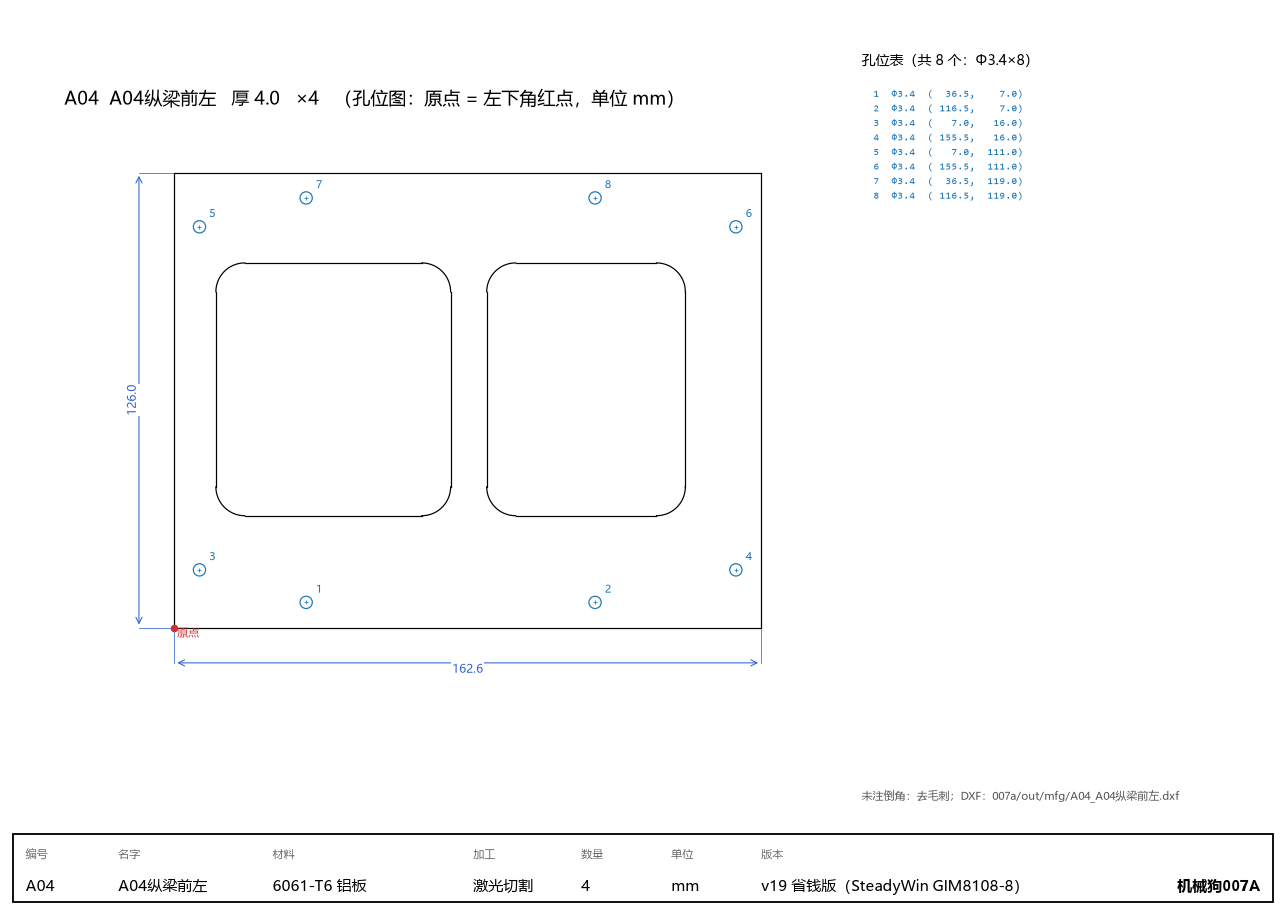
007a/out/drawings/A04_A04纵梁前左.png
