whois169/roboot007v/007a/out/drawings/A05_A05前端板.png

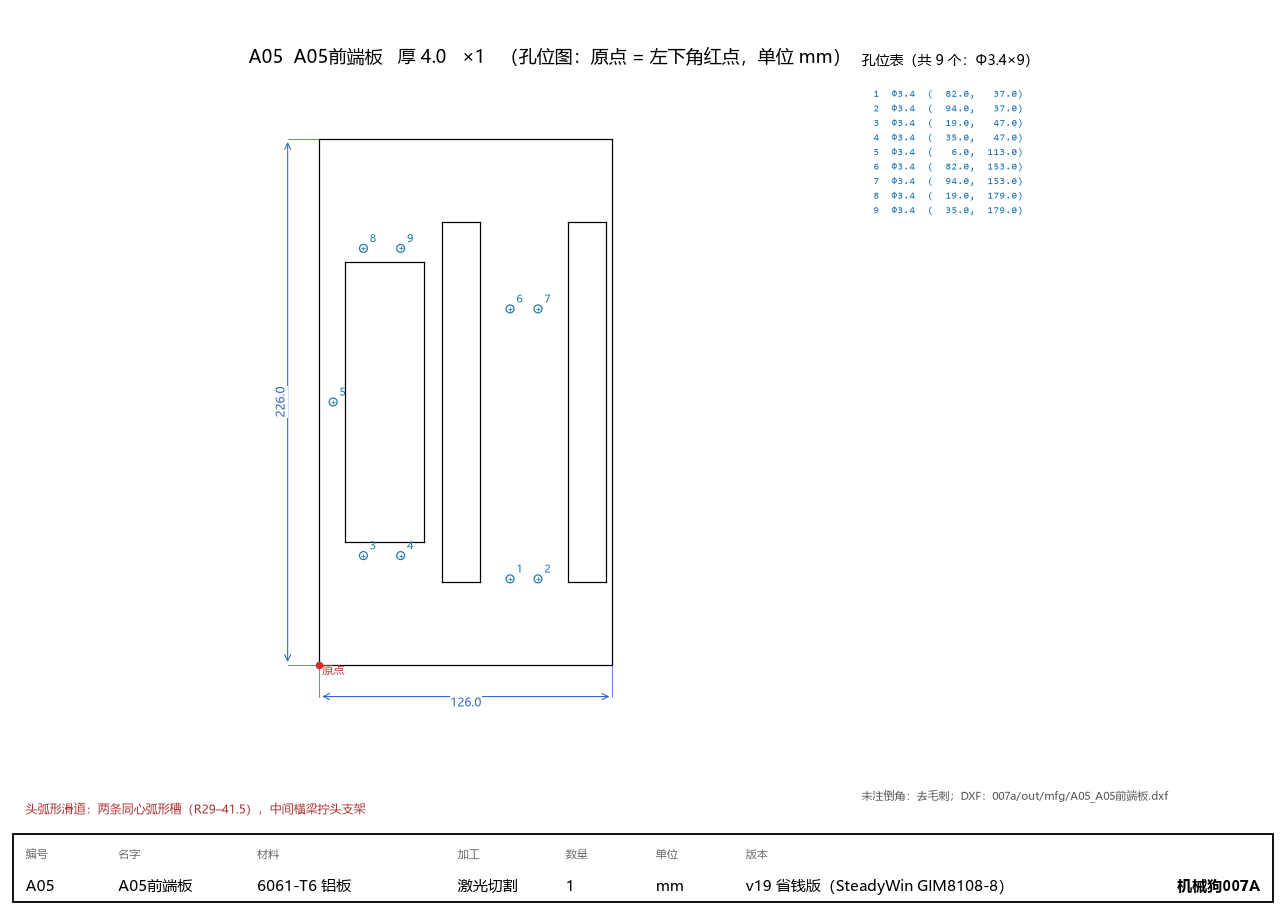
007a/out/drawings/A05_A05前端板.png
