whois169/roboot007v/007a/out/drawings/A06_A06后端板.png

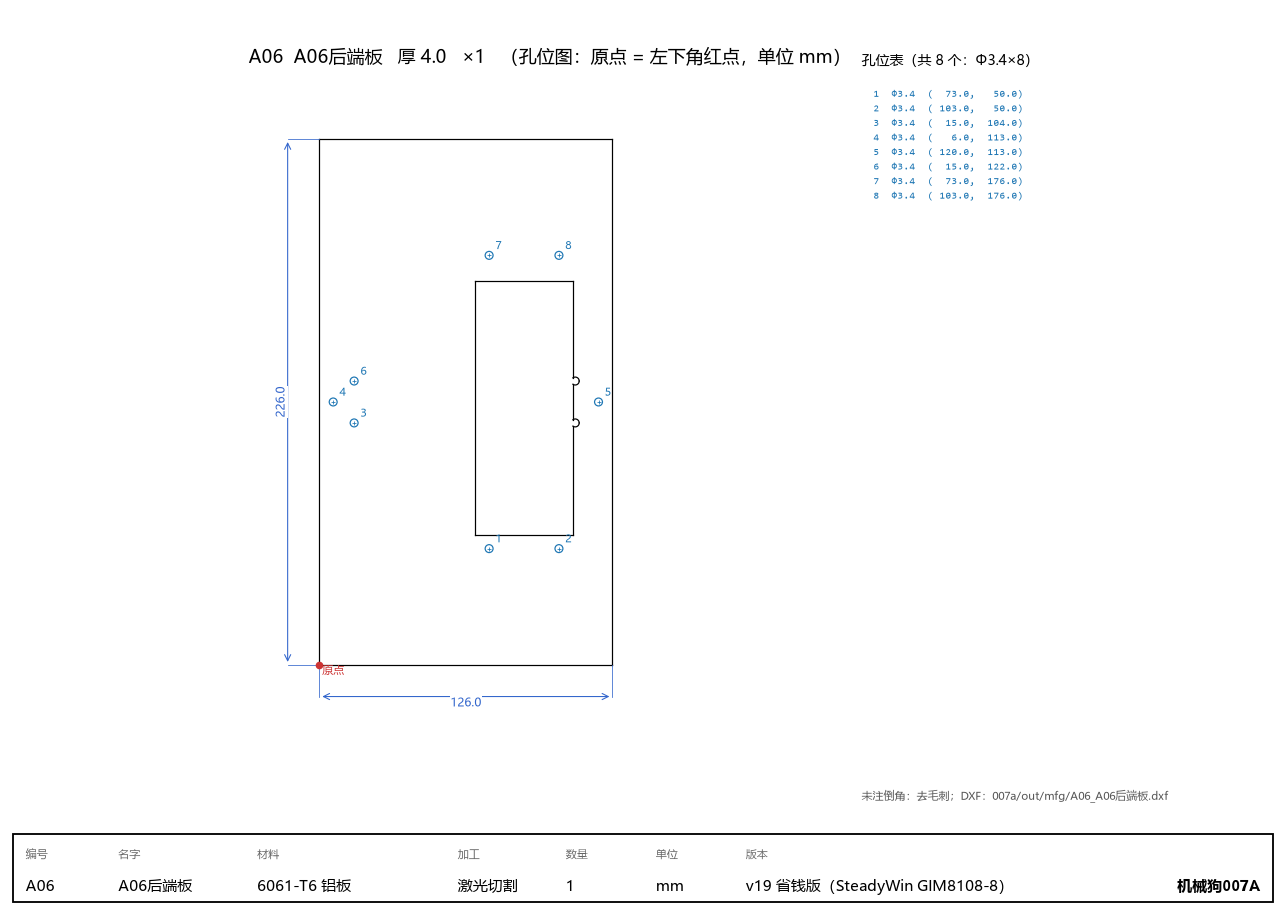
007a/out/drawings/A06_A06后端板.png
