whois169/roboot007v/007a/out/drawings/A07_A07顶板.png

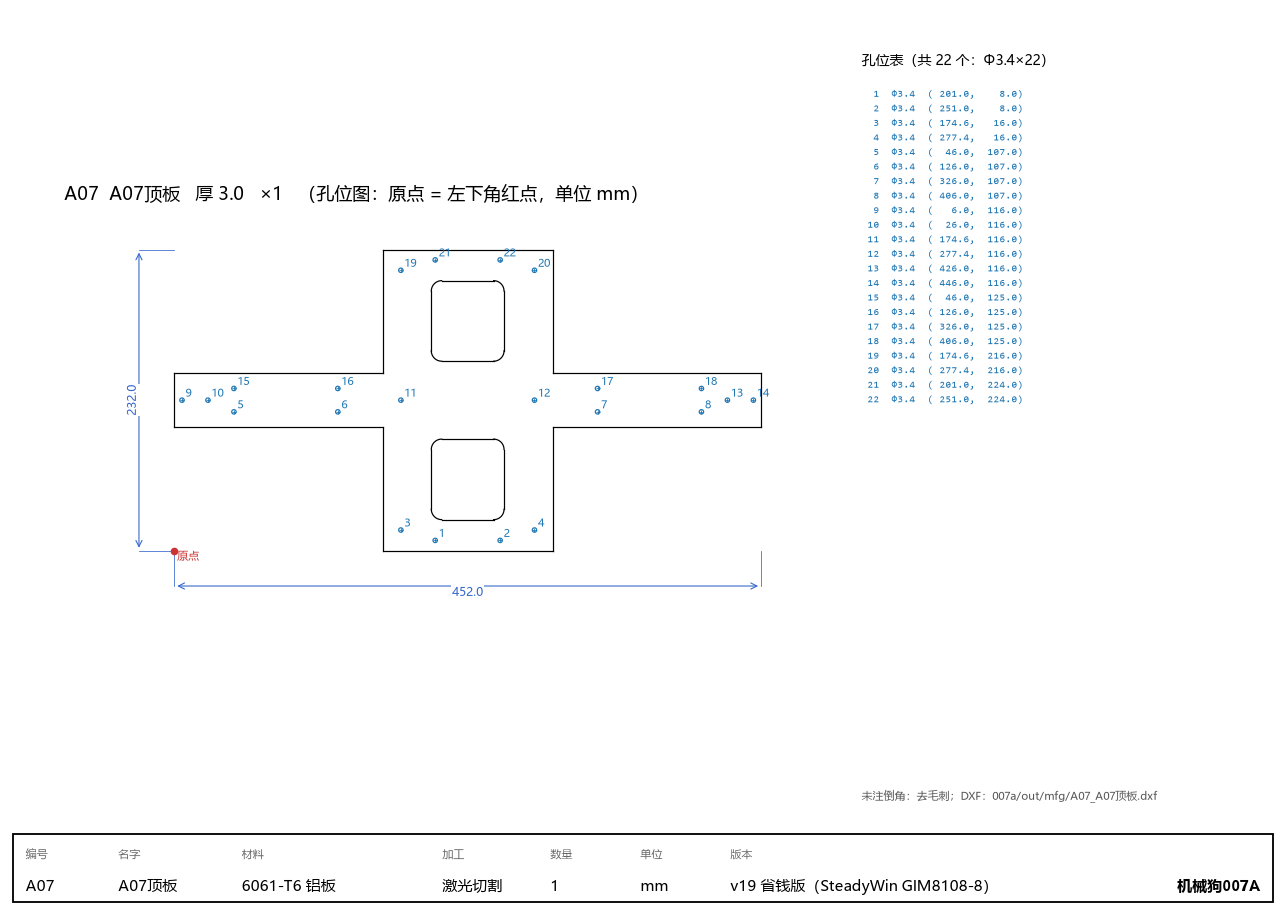
007a/out/drawings/A07_A07顶板.png
