whois169/roboot007v/007a/out/drawings/C01_电子托板.png

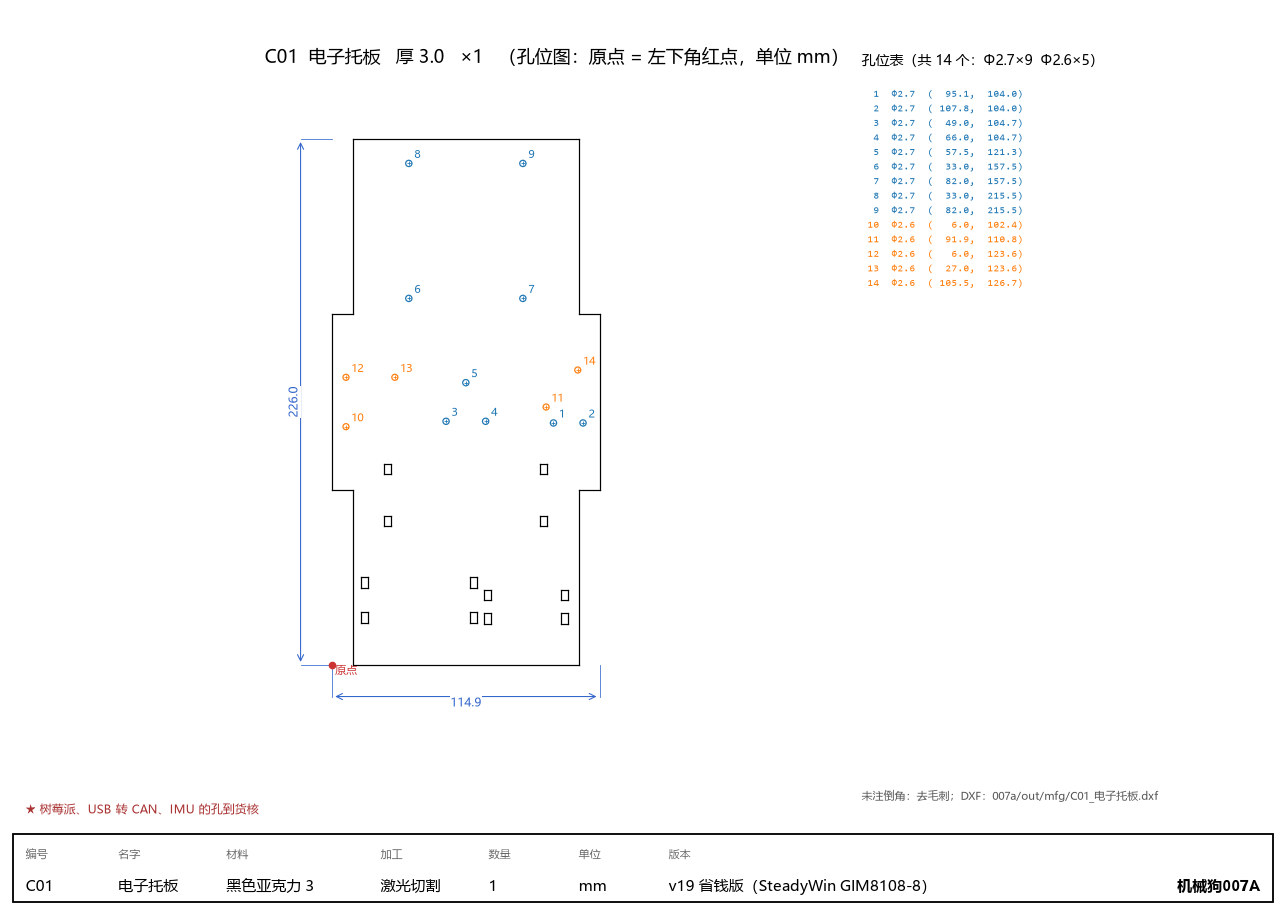
007a/out/drawings/C01_电子托板.png
