whois169/roboot007v/007a/out/drawings/H01_头支架左.png

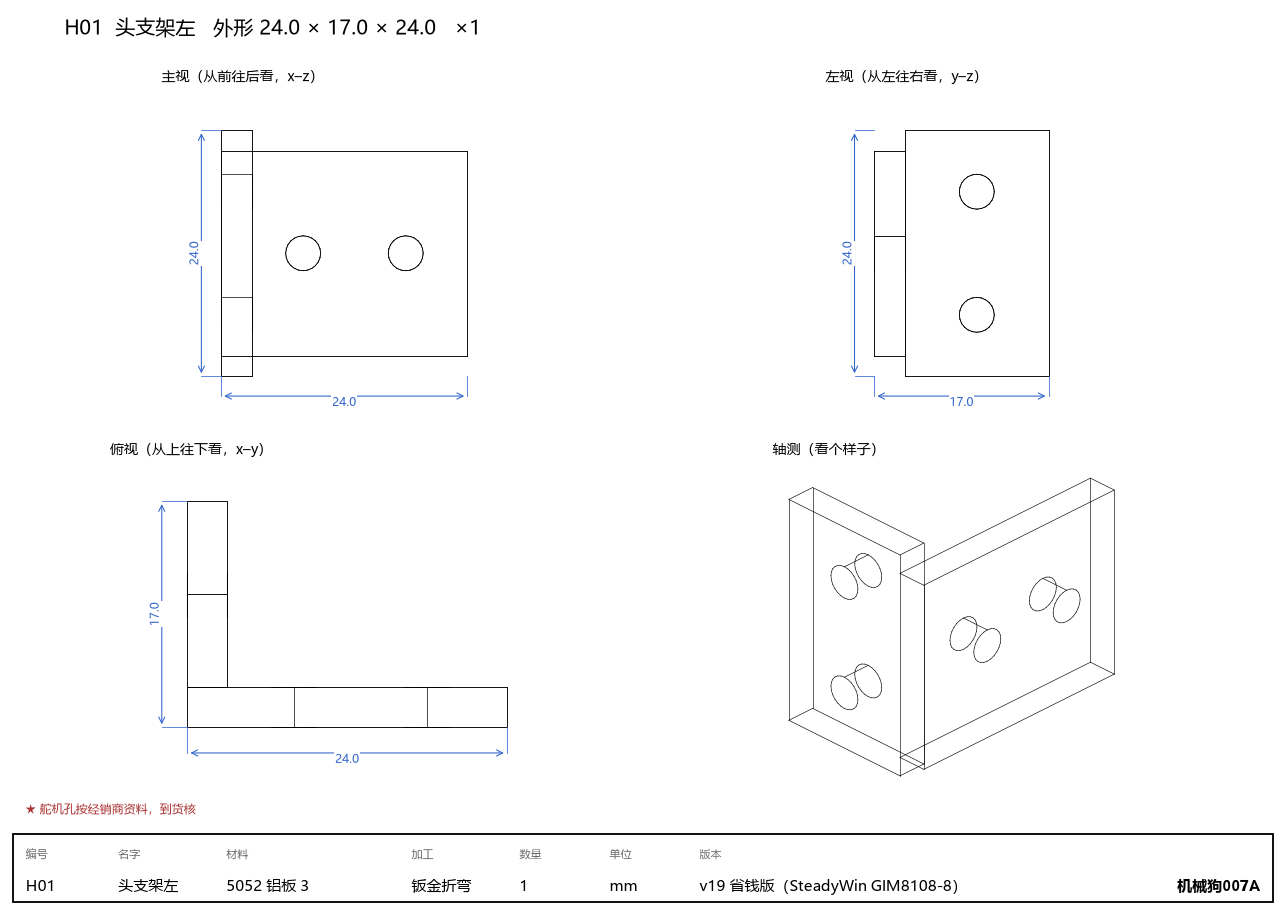
007a/out/drawings/H01_头支架左.png
