whois169/roboot007v/007a/out/drawings/H02_头支架右.png

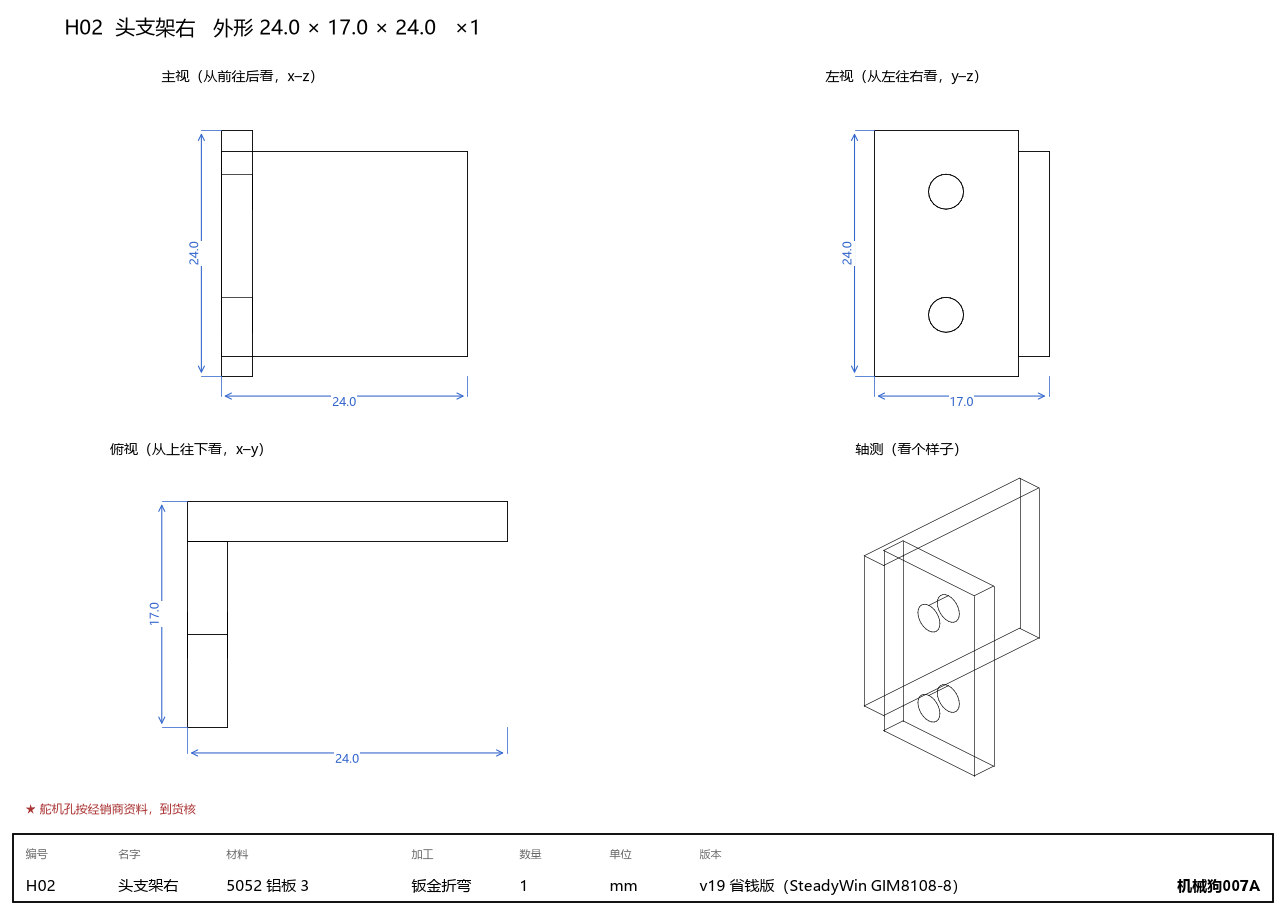
007a/out/drawings/H02_头支架右.png
