whois169/roboot007v/007a/out/drawings/L01_大腿外板.png

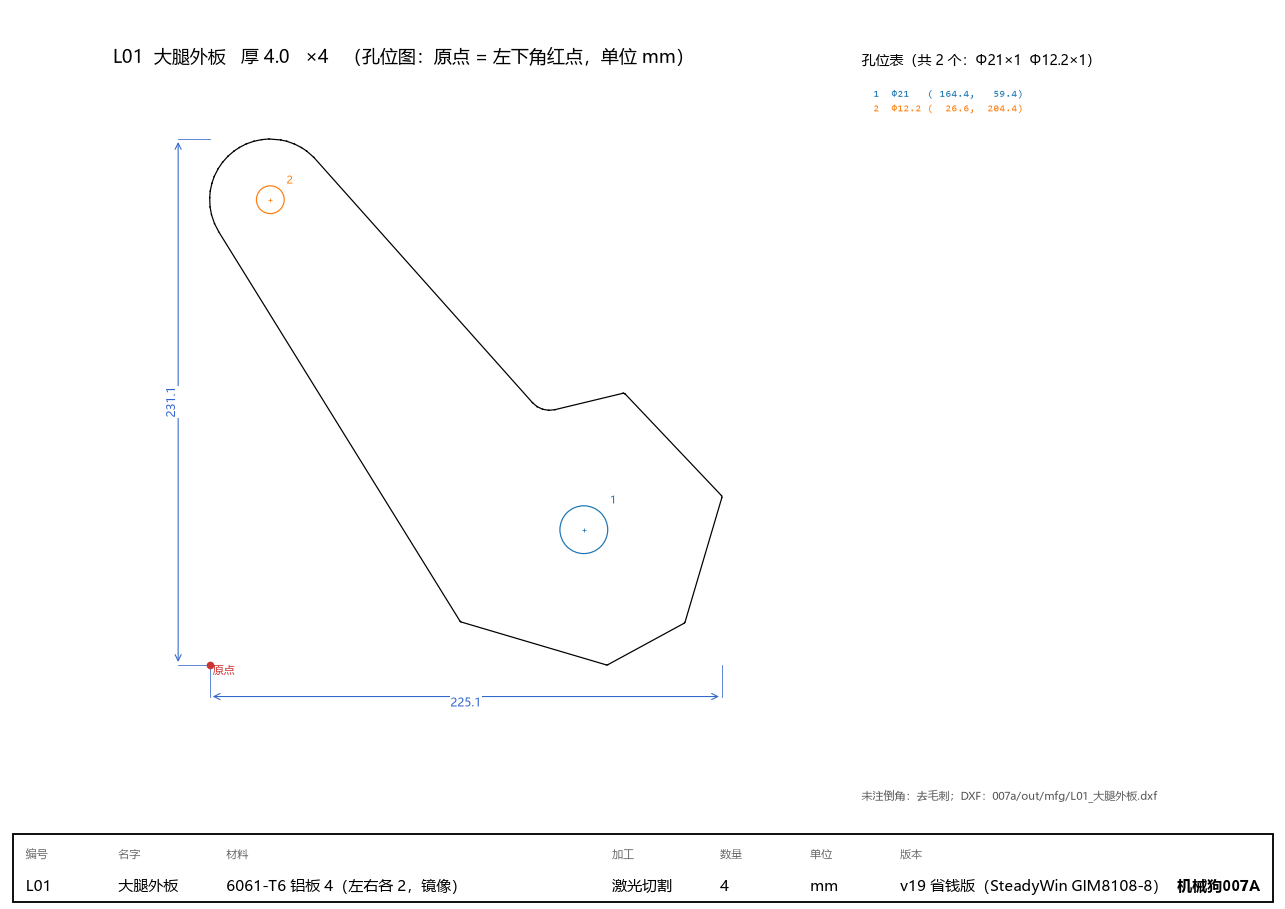
007a/out/drawings/L01_大腿外板.png
