whois169/roboot007v/007a/out/drawings/L02_大腿杯和内板.png

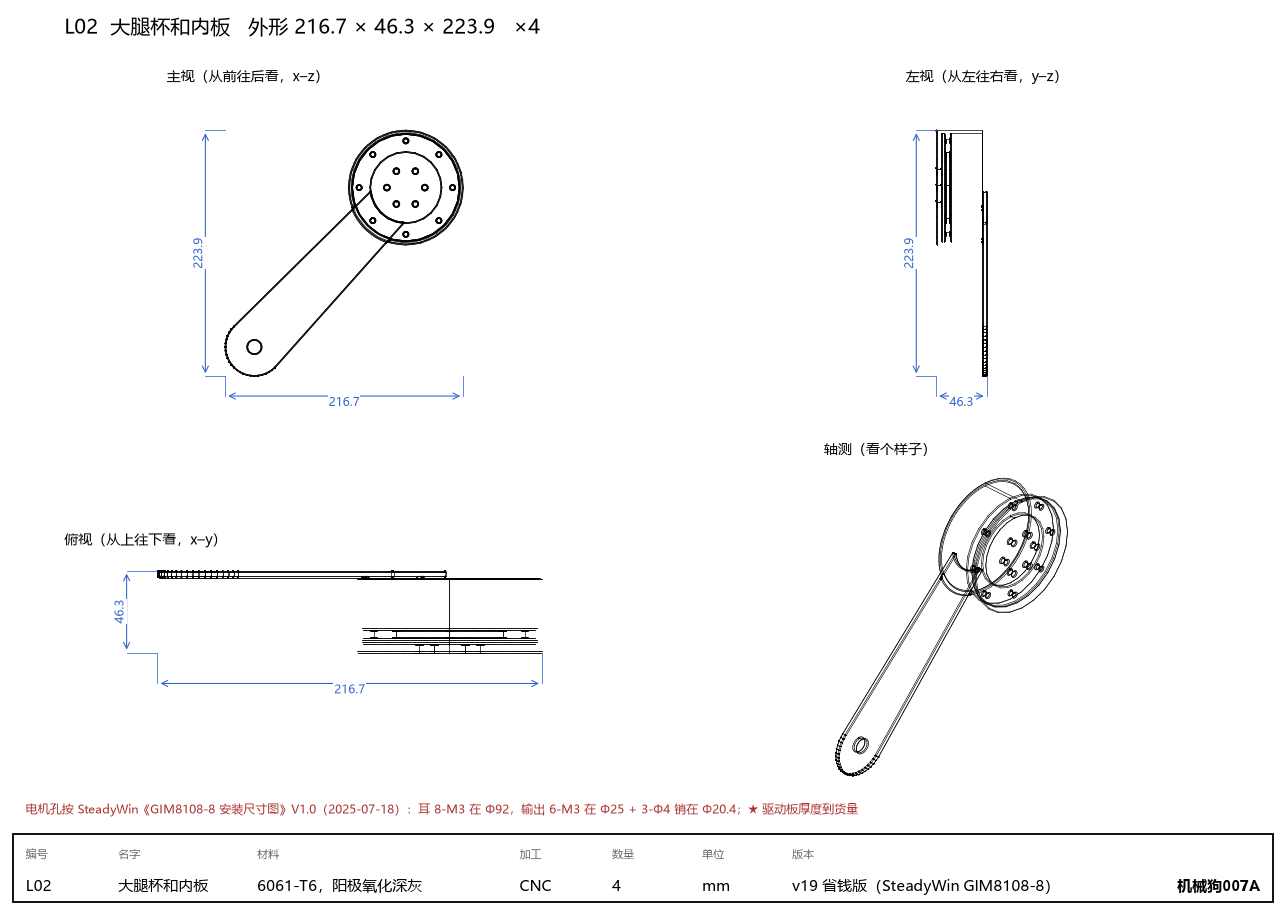
007a/out/drawings/L02_大腿杯和内板.png
