whois169/roboot007v/007a/out/drawings/L03_髋座.png

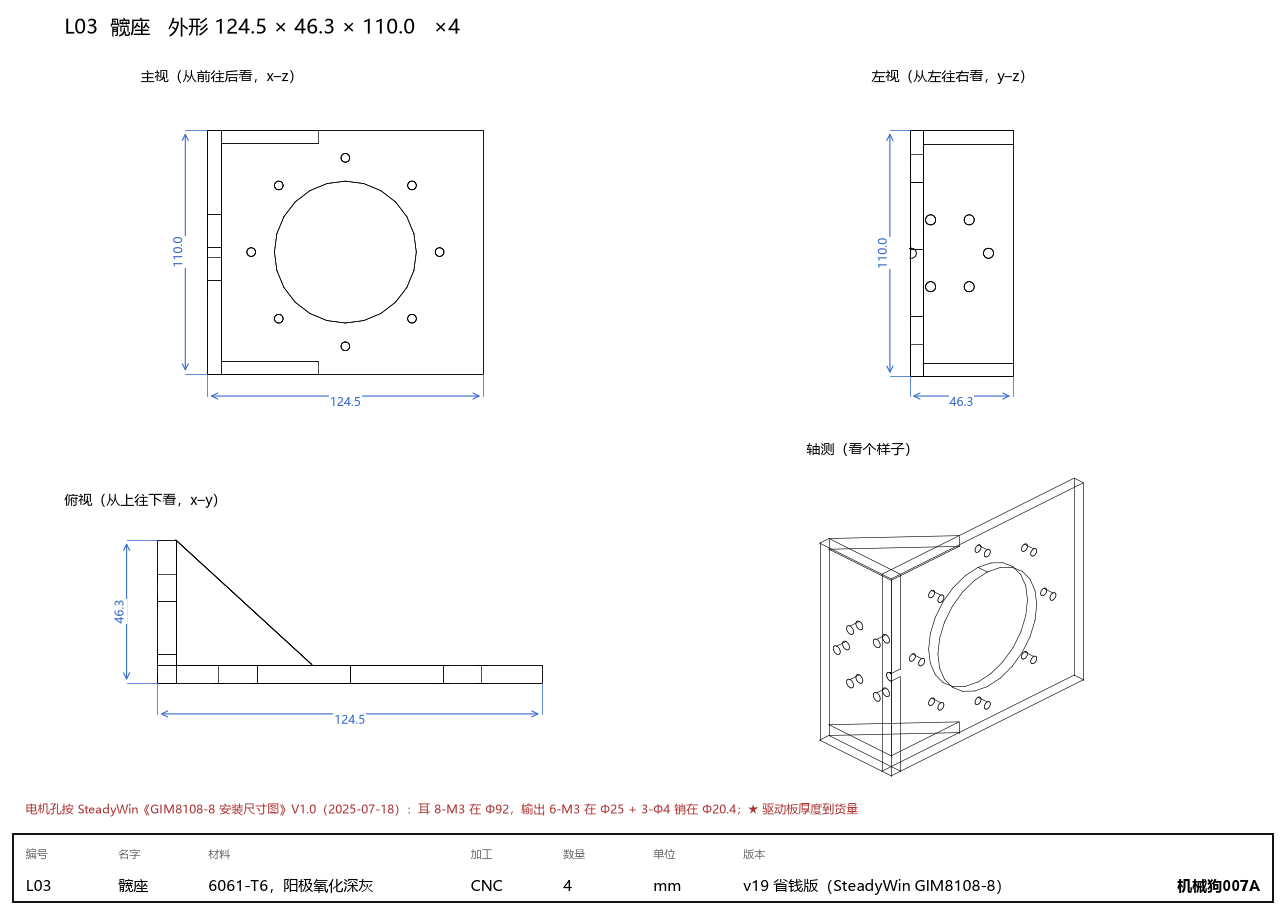
007a/out/drawings/L03_髋座.png
