whois169/roboot007v/007a/out/drawings/L04_转接盘和轴.png

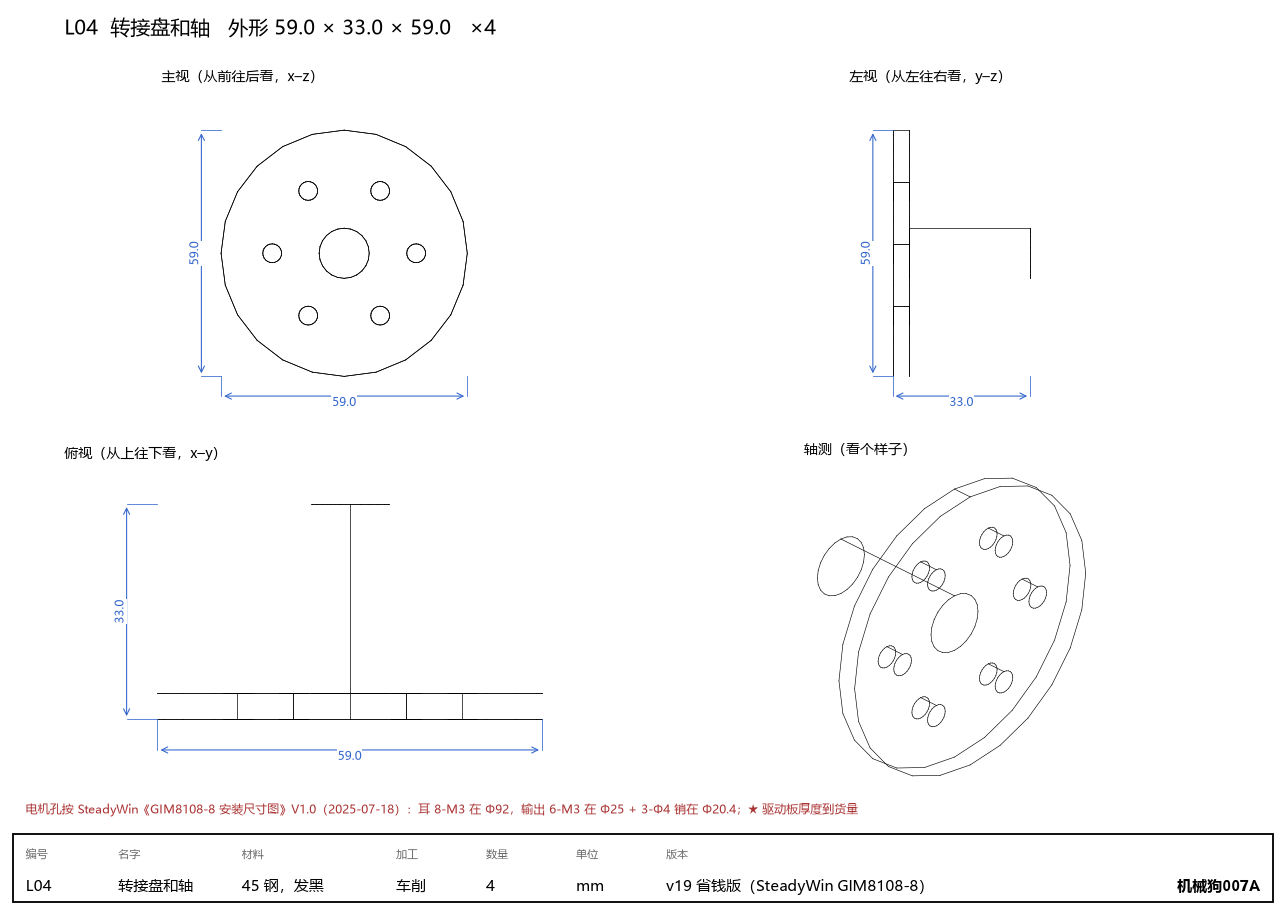
007a/out/drawings/L04_转接盘和轴.png
