whois169/roboot007v/007a/out/drawings/L05_膝轴.png

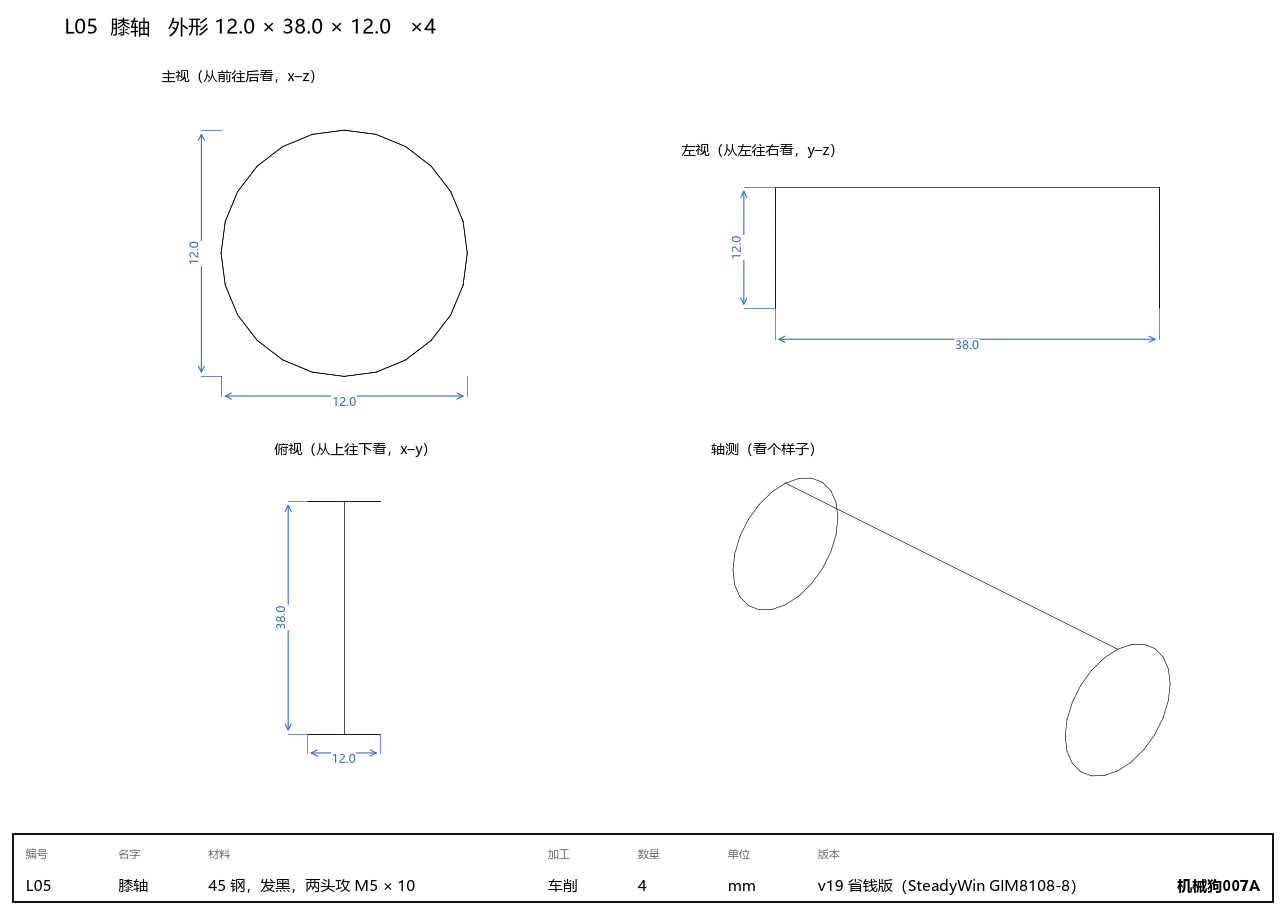
007a/out/drawings/L05_膝轴.png
