whois169/roboot007v/007a/out/drawings/L09_小腿根.png

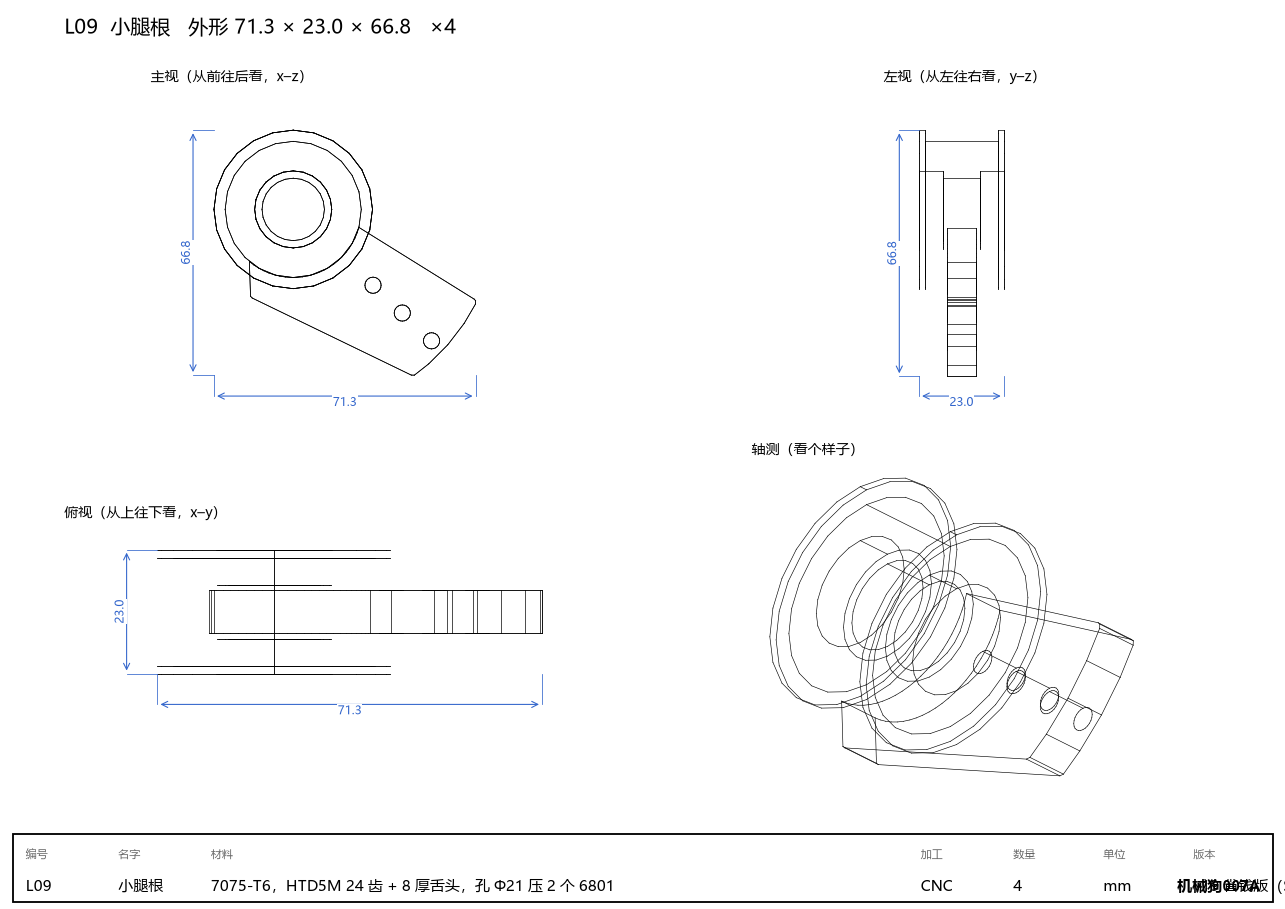
007a/out/drawings/L09_小腿根.png
