whois169/roboot007v/007a/out/exploded/leg/腿部爆炸图_带标注.png

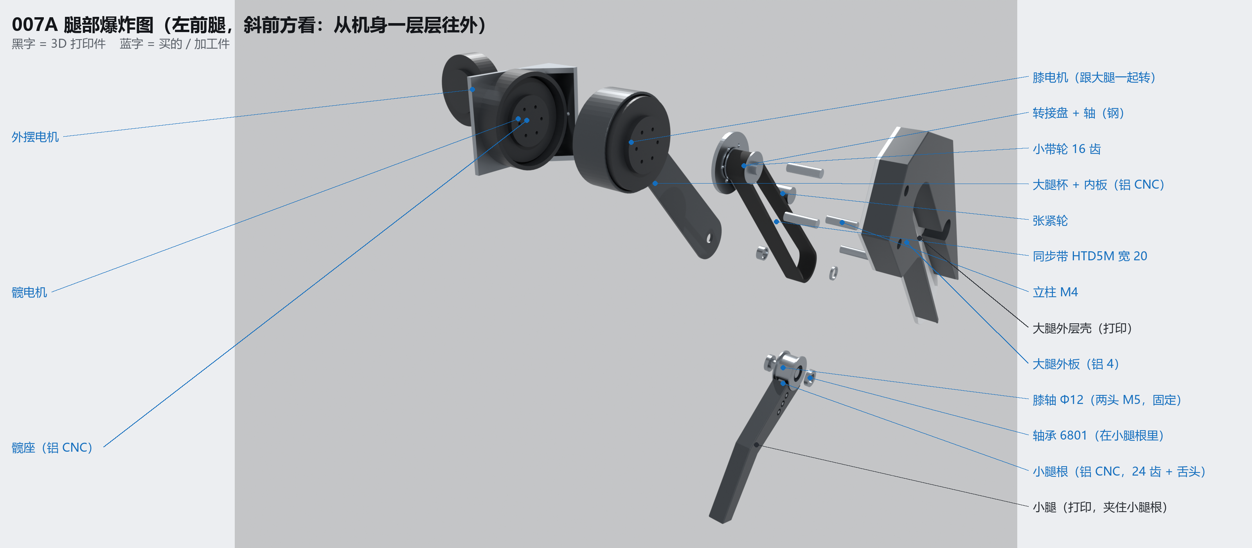
007a/out/exploded/leg/腿部爆炸图_带标注.png
