whois169/roboot007v/007a/out/exploded/whole/整机爆炸图.png

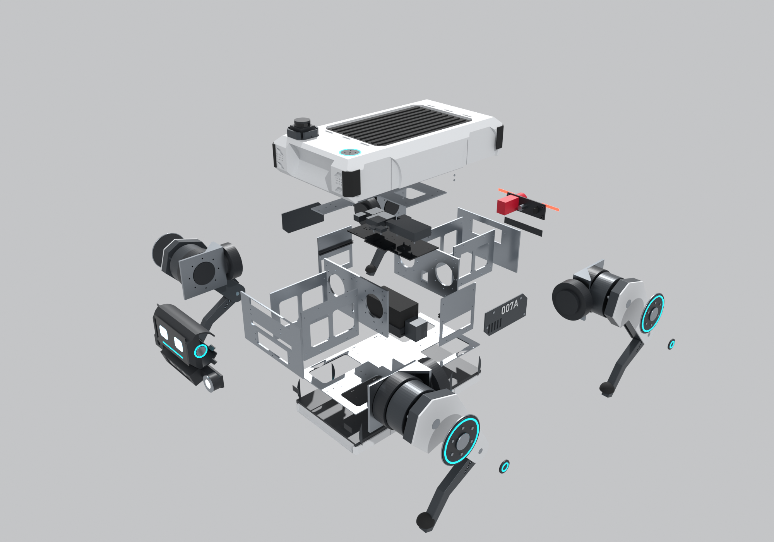
007a/out/exploded/whole/整机爆炸图.png
