whois169/roboot007v/007a/out/head_closeup/头特写_0_前45.png

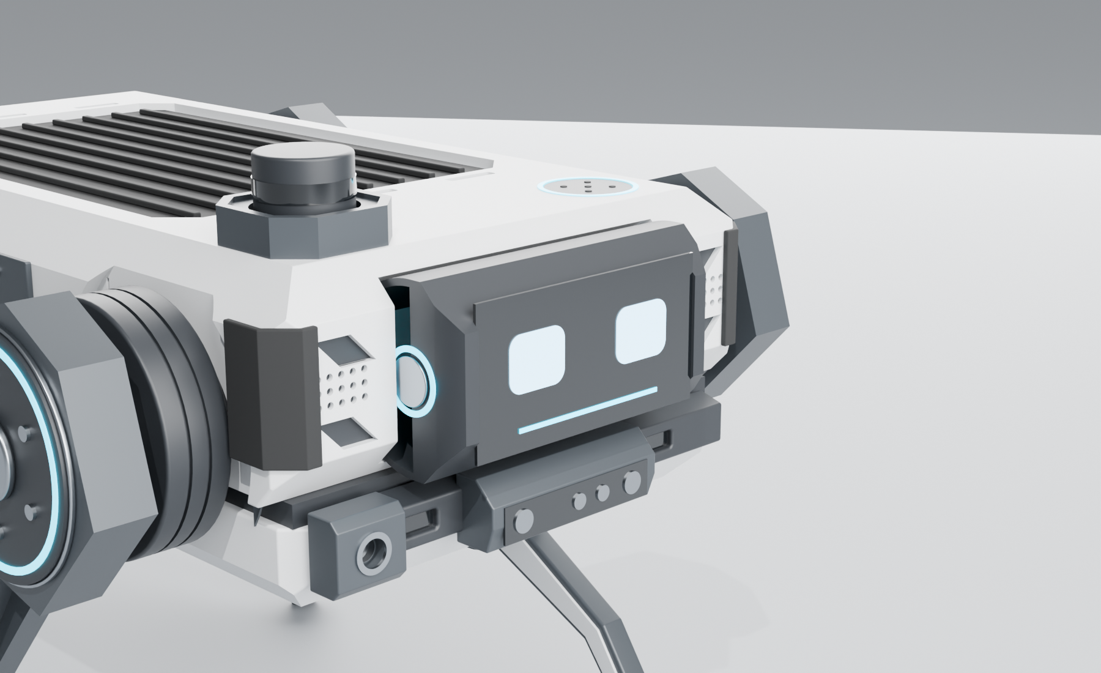
007a/out/head_closeup/头特写_0_前45.png
