whois169/roboot007v/007a/out/render_v21b/007A_侧面.png

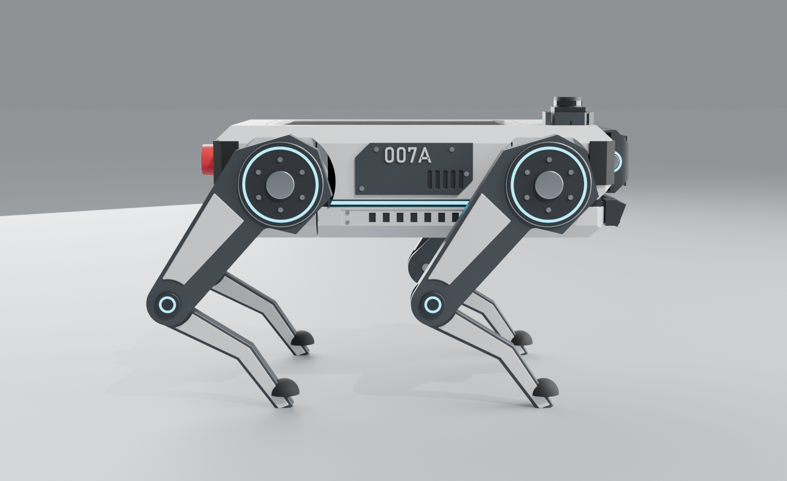
007a/out/render_v21b/007A_侧面.png
