whois169/roboot007v/007a/out/render_v21b/007A_正面.png

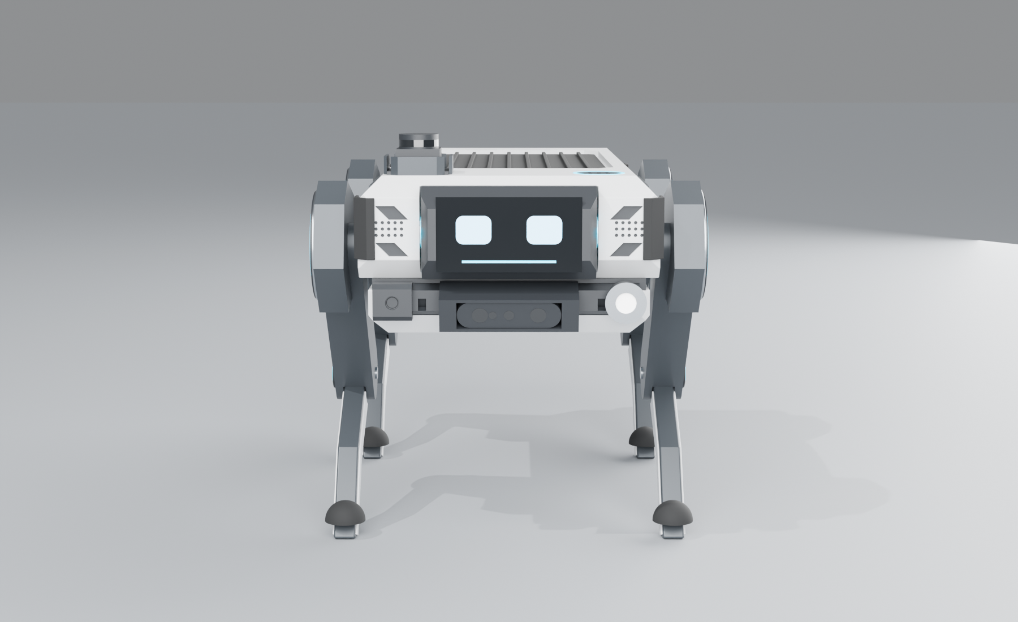
007a/out/render_v21b/007A_正面.png
