whois169/roboot007v/007a/ref/go-m8010-6/尺寸图.png

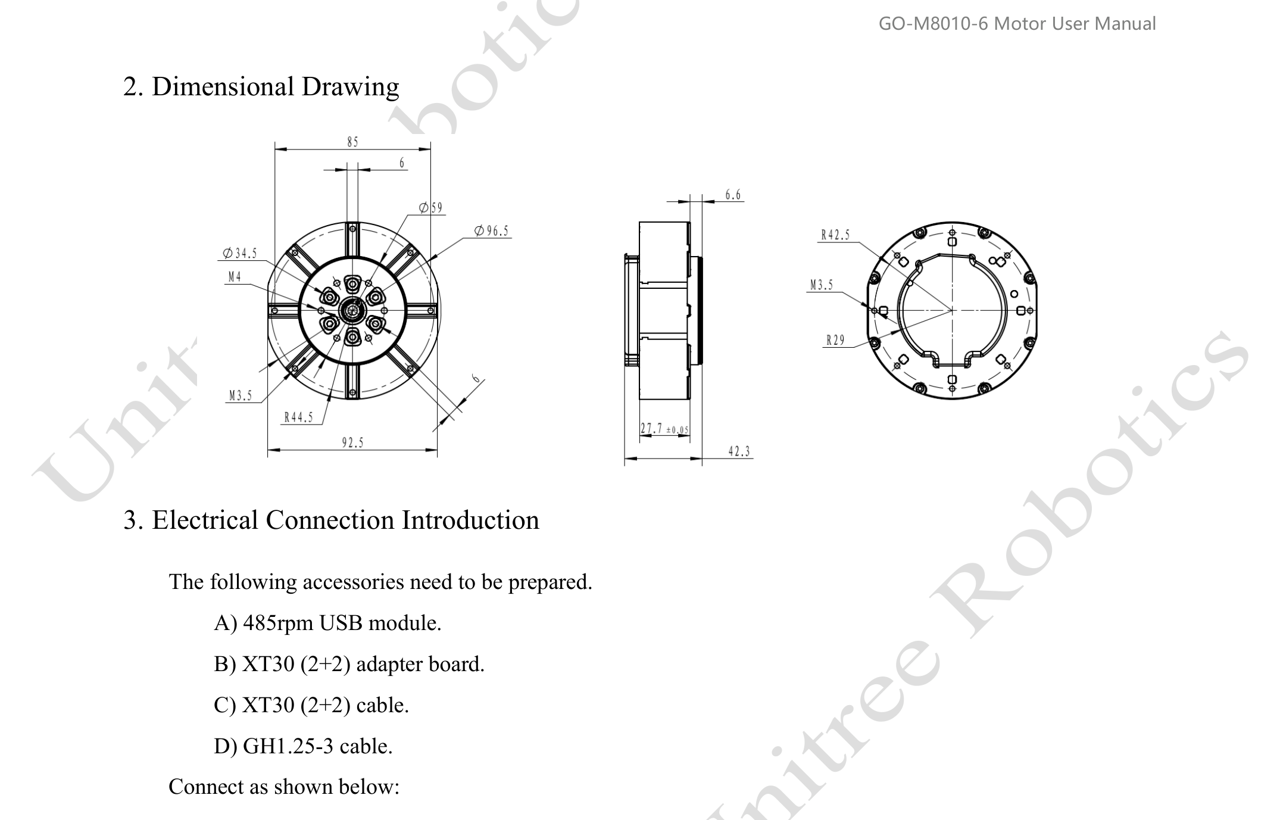
007a/ref/go-m8010-6/尺寸图.png
