whois169/roboot007v/007v/ref/boards/esp32_dims.png

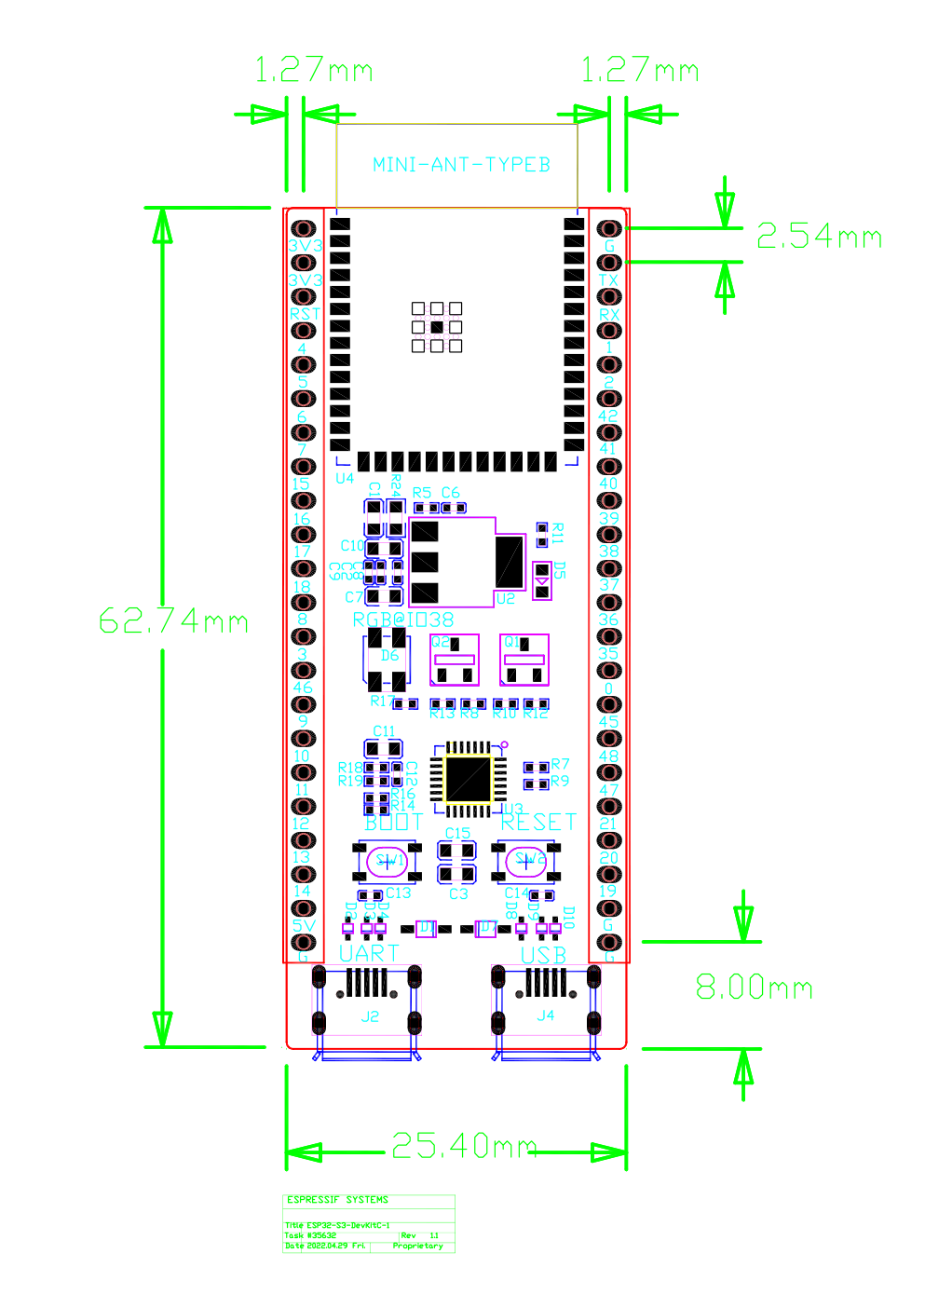
007v/ref/boards/esp32_dims.png
