whois169/roboot007v/007v/ref/gim4310/gds_2d.png

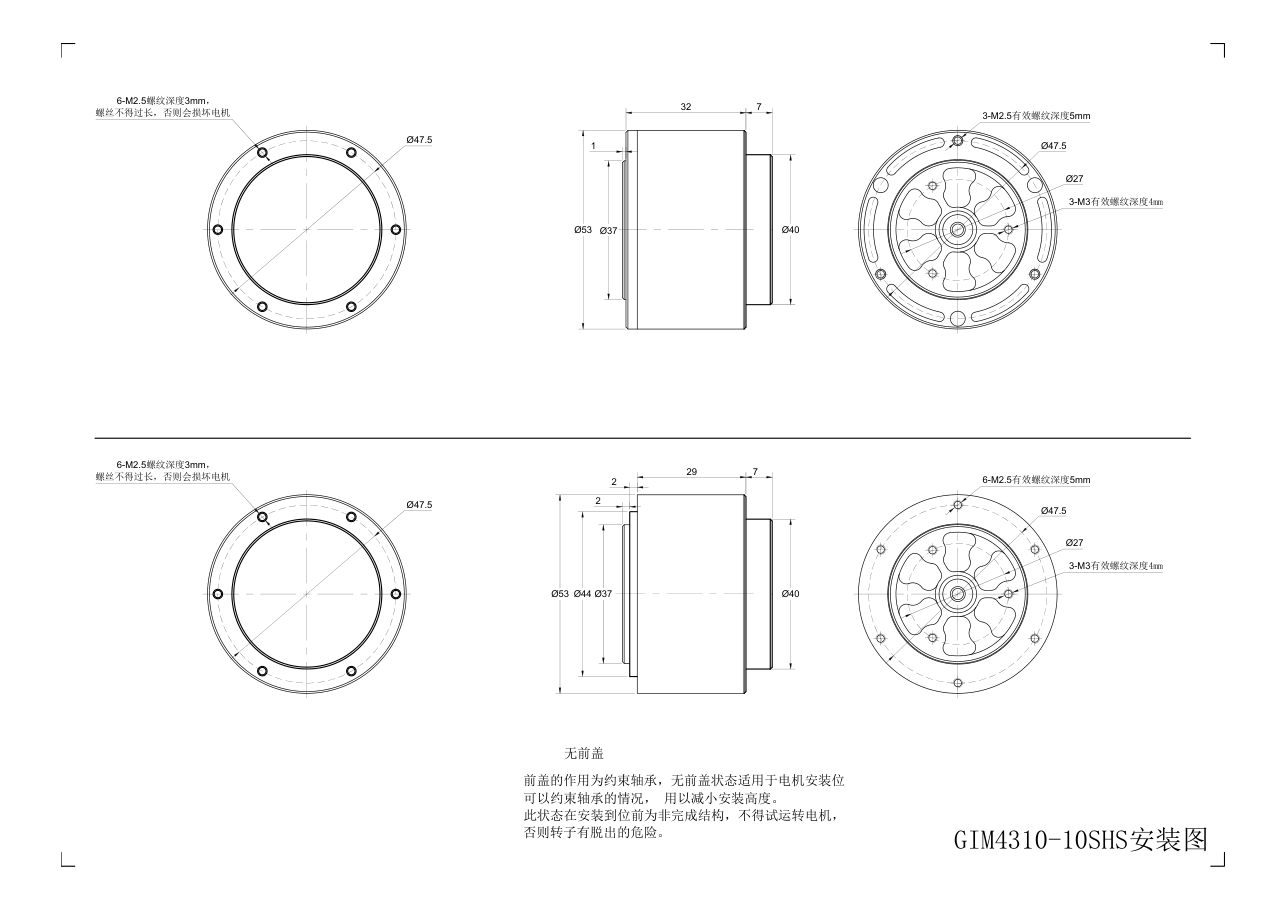
007v/ref/gim4310/gds_2d.png
