whois169/roboot007v/007v/ref/pololu/dims_3782.jpg

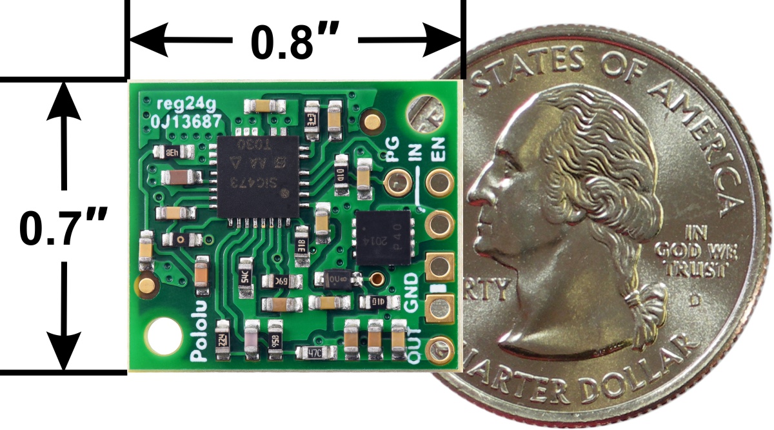
007v/ref/pololu/dims_3782.jpg
