whois169/roboot007v/007v/ref/waveshare_4.3B/size_1.png

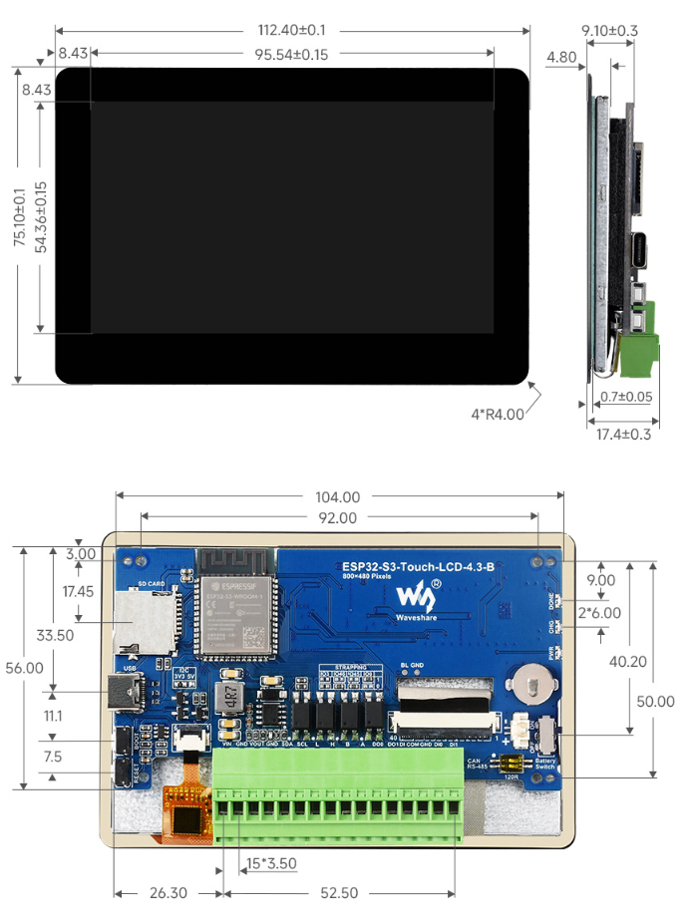
007v/ref/waveshare_4.3B/size_1.png
