whois169/roboot007v/007v/ref/worm5840/dim_zoom.png

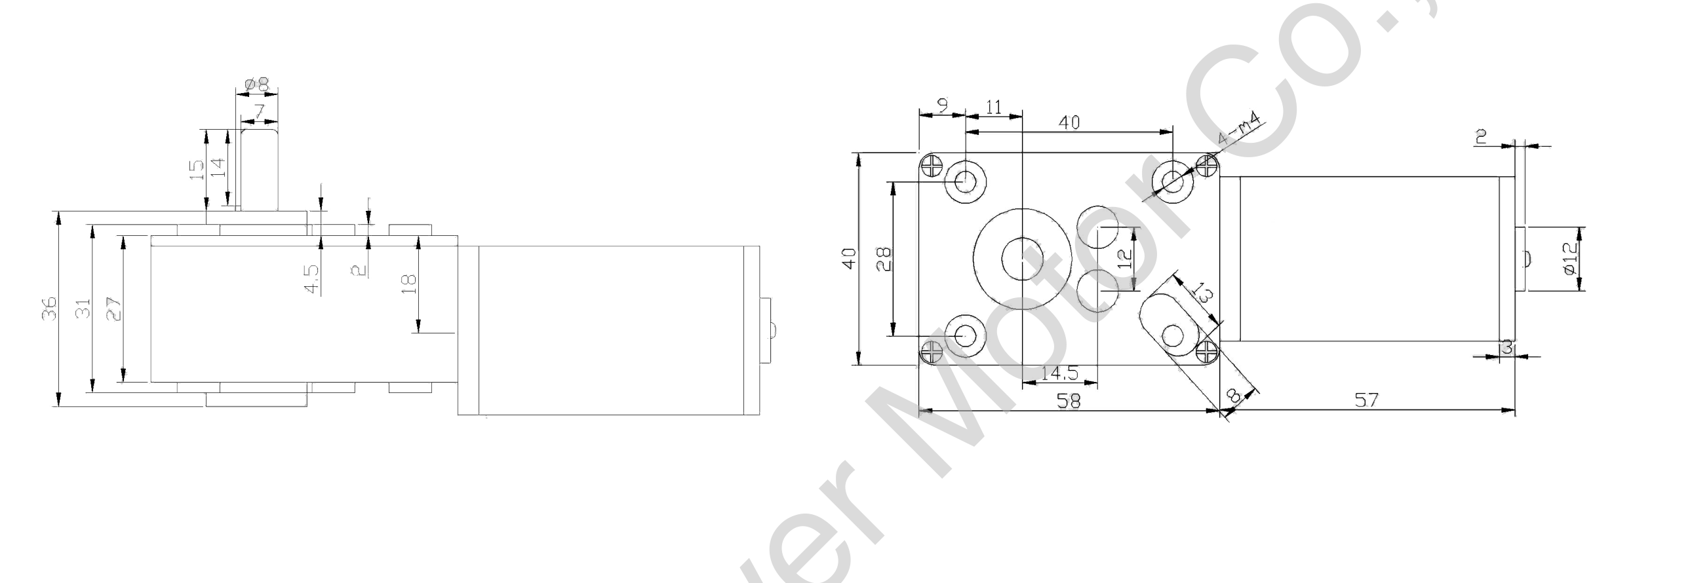
007v/ref/worm5840/dim_zoom.png
