whois169/roboot007v/007v/ref/worm5840/p0.png

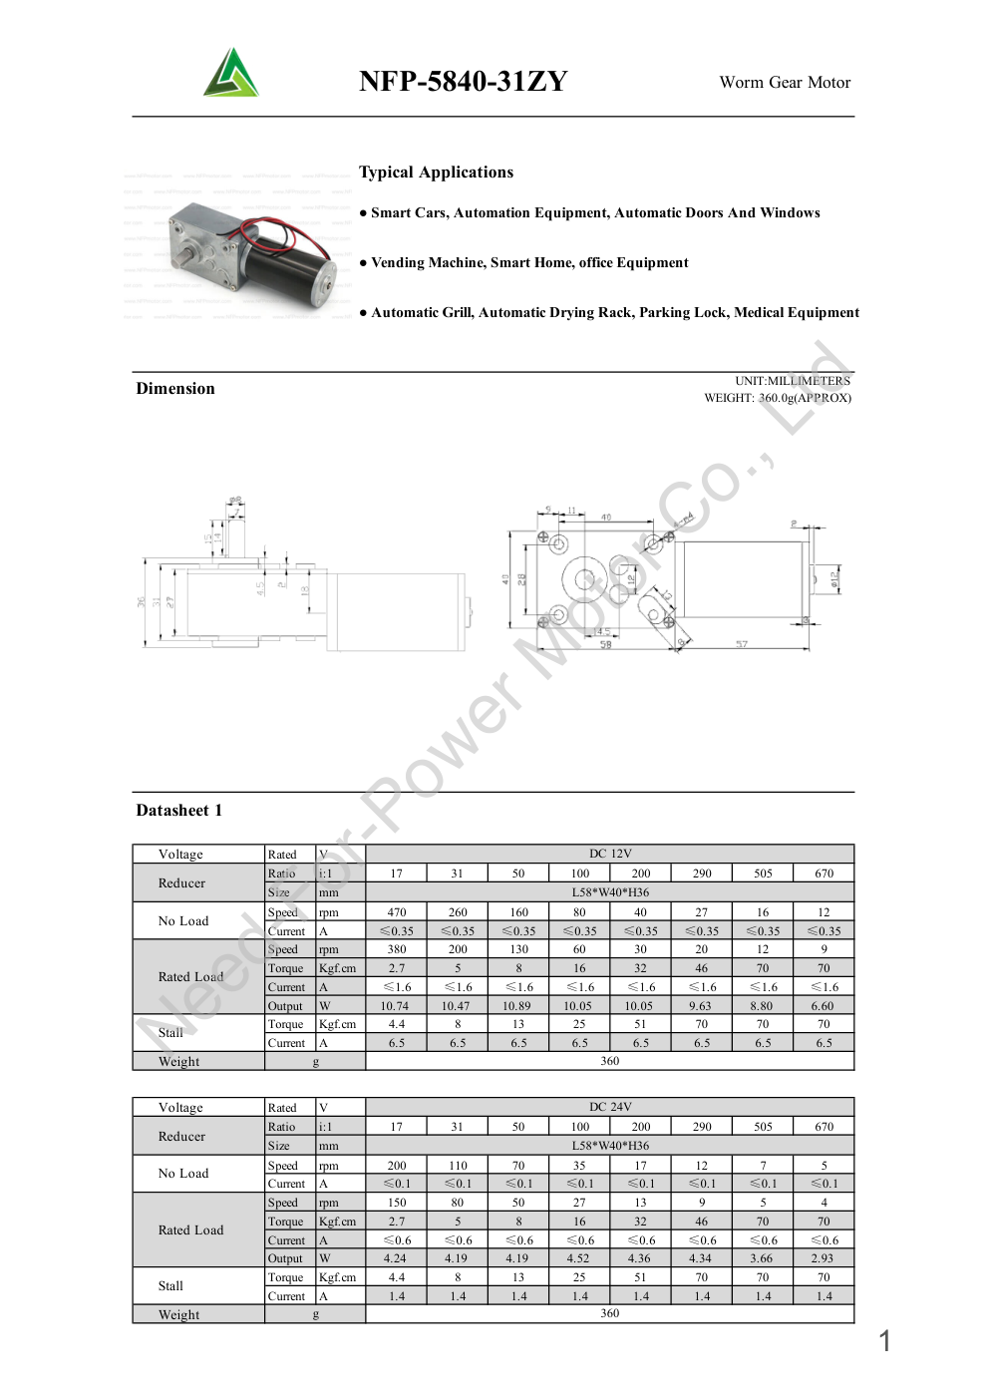
007v/ref/worm5840/p0.png
