whois169/roboot007v/docs/机械狗007A/仿真_住宅楼梯_正着下.gif

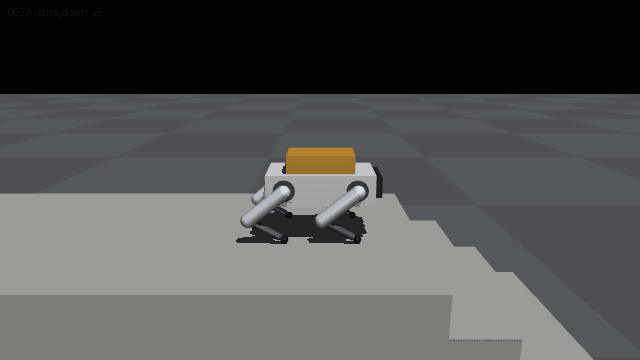
docs/机械狗007A/仿真_住宅楼梯_正着下.gif
