whois169/roboot007v/docs/机械狗007A/仿真_公共楼梯_正着上（空载）.png

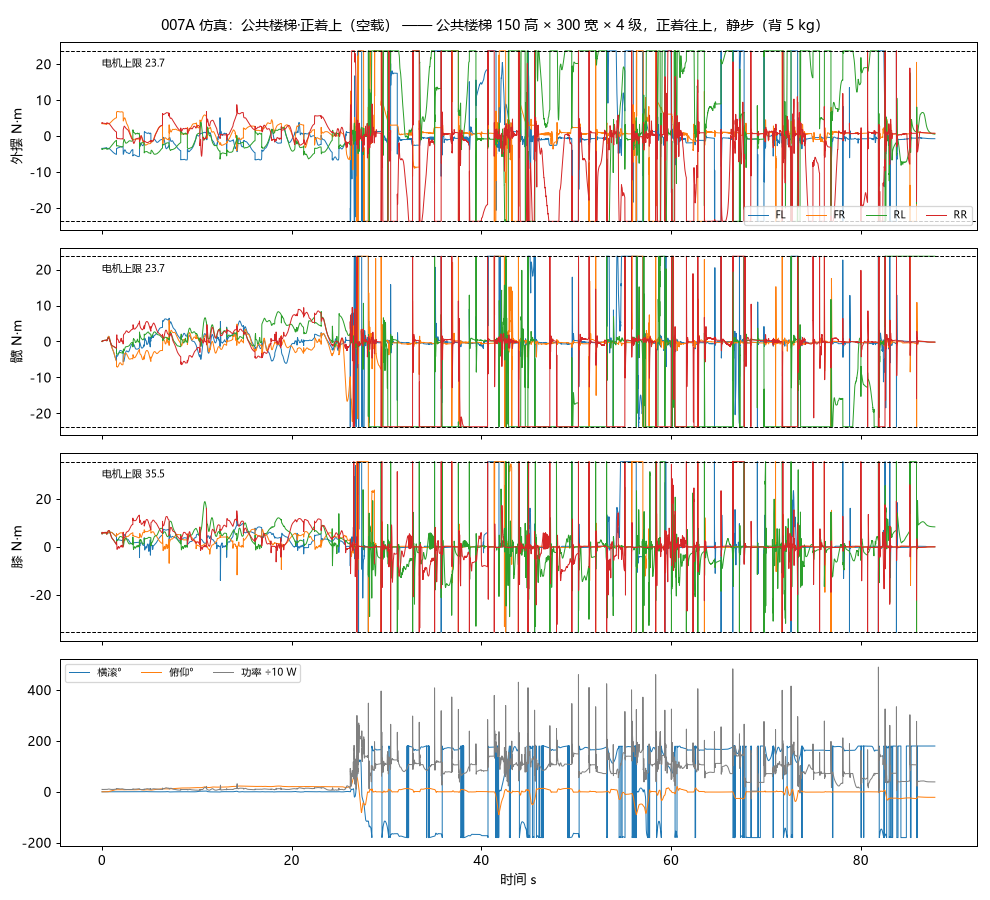
docs/机械狗007A/仿真_公共楼梯_正着上（空载）.png
