whois169/roboot007v/docs/机械狗007A/仿真_小跑0.5m每s.gif

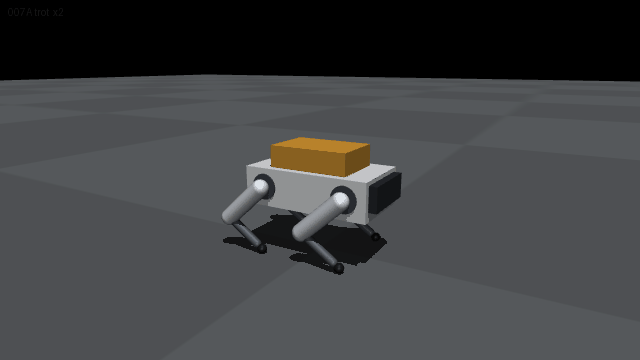
docs/机械狗007A/仿真_小跑0.5m每s.gif
