whois169/roboot007v/docs/机械狗007A/仿真_小跑0.8m每s.png

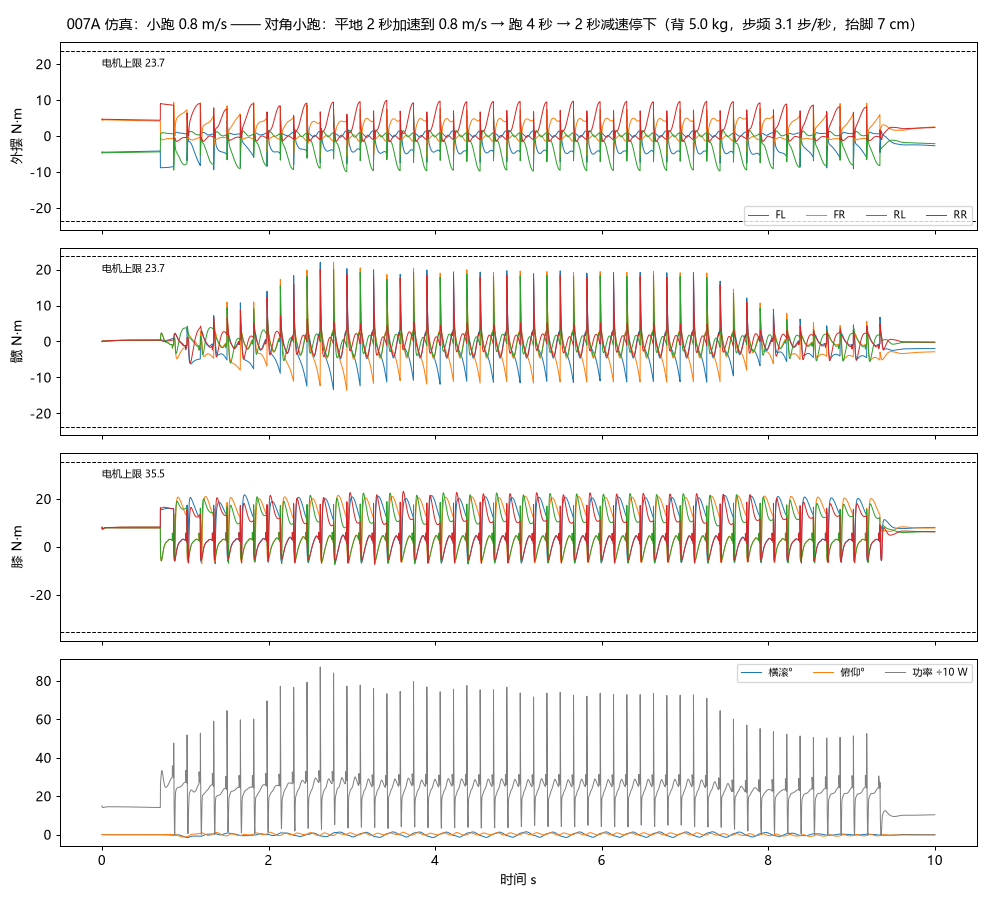
docs/机械狗007A/仿真_小跑0.8m每s.png
