whois169/roboot007v/docs/机械狗007A/仿真_小跑0.8m每s（空载）.png

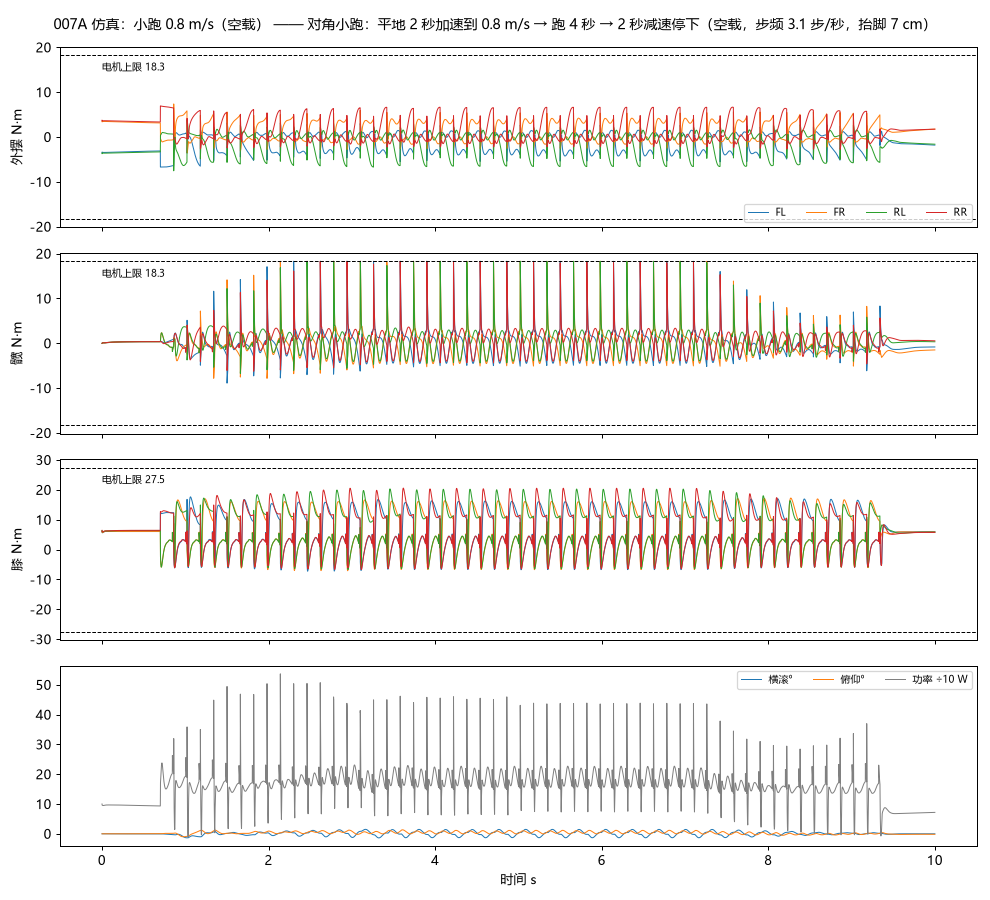
docs/机械狗007A/仿真_小跑0.8m每s（空载）.png
