whois169/roboot007v/docs/机械狗007A/仿真_趴下站起（空载）.gif

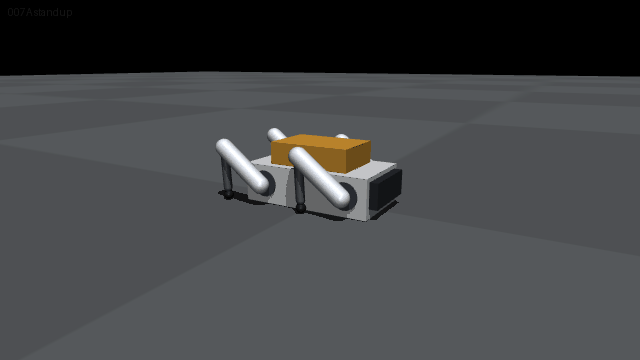
docs/机械狗007A/仿真_趴下站起（空载）.gif
