whois169/roboot007v/docs/机械狗007A/仿真_跨电缆槽（空载）.png

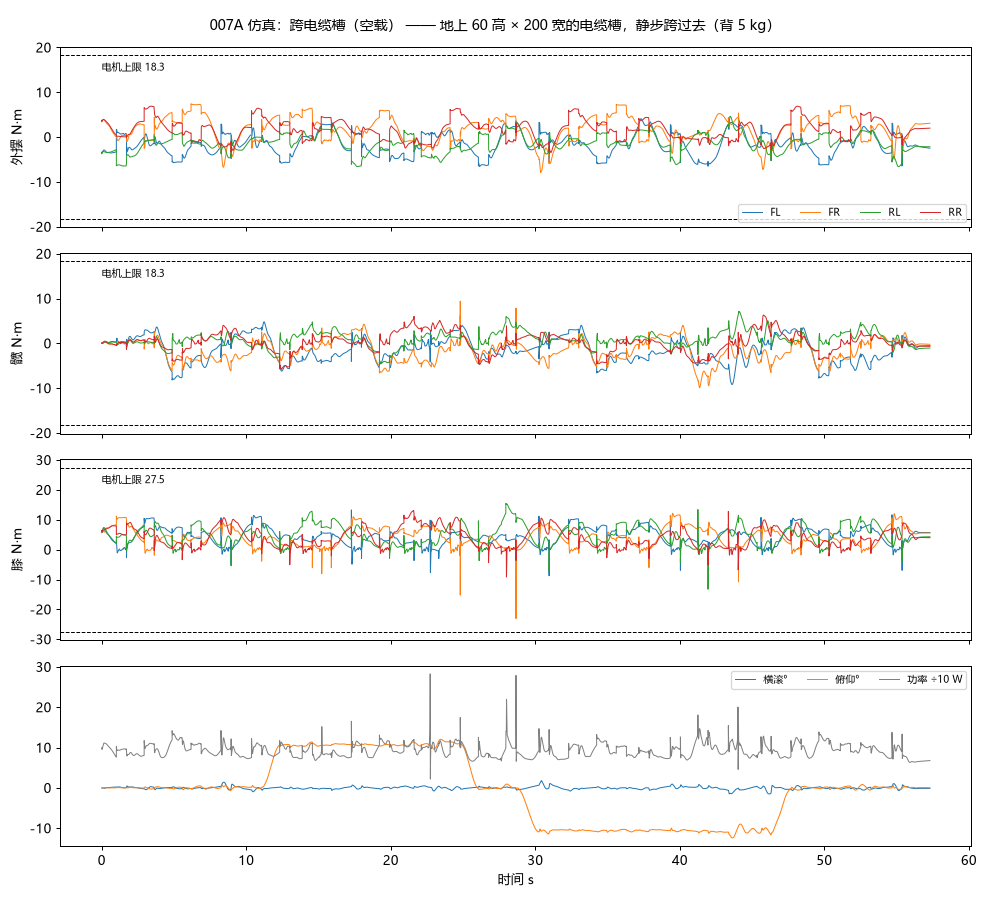
docs/机械狗007A/仿真_跨电缆槽（空载）.png
