whois169/roboot007v/docs/机械狗007A/制造件总览.png

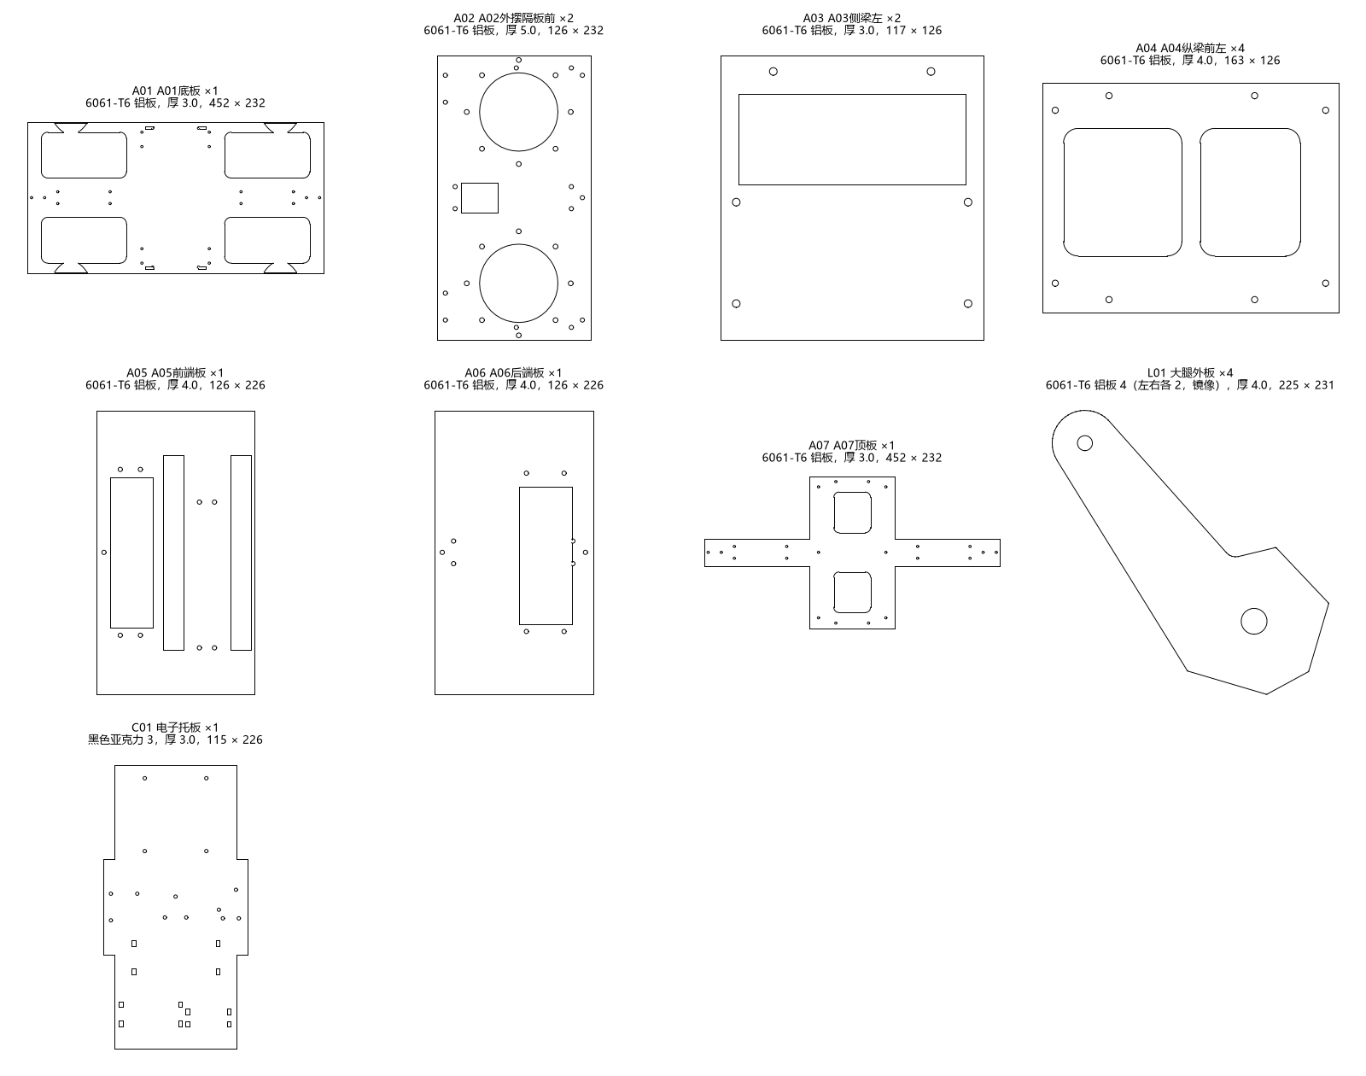
docs/机械狗007A/制造件总览.png
