whois169/roboot007v/docs/机械狗007A/大腿收细对比.png

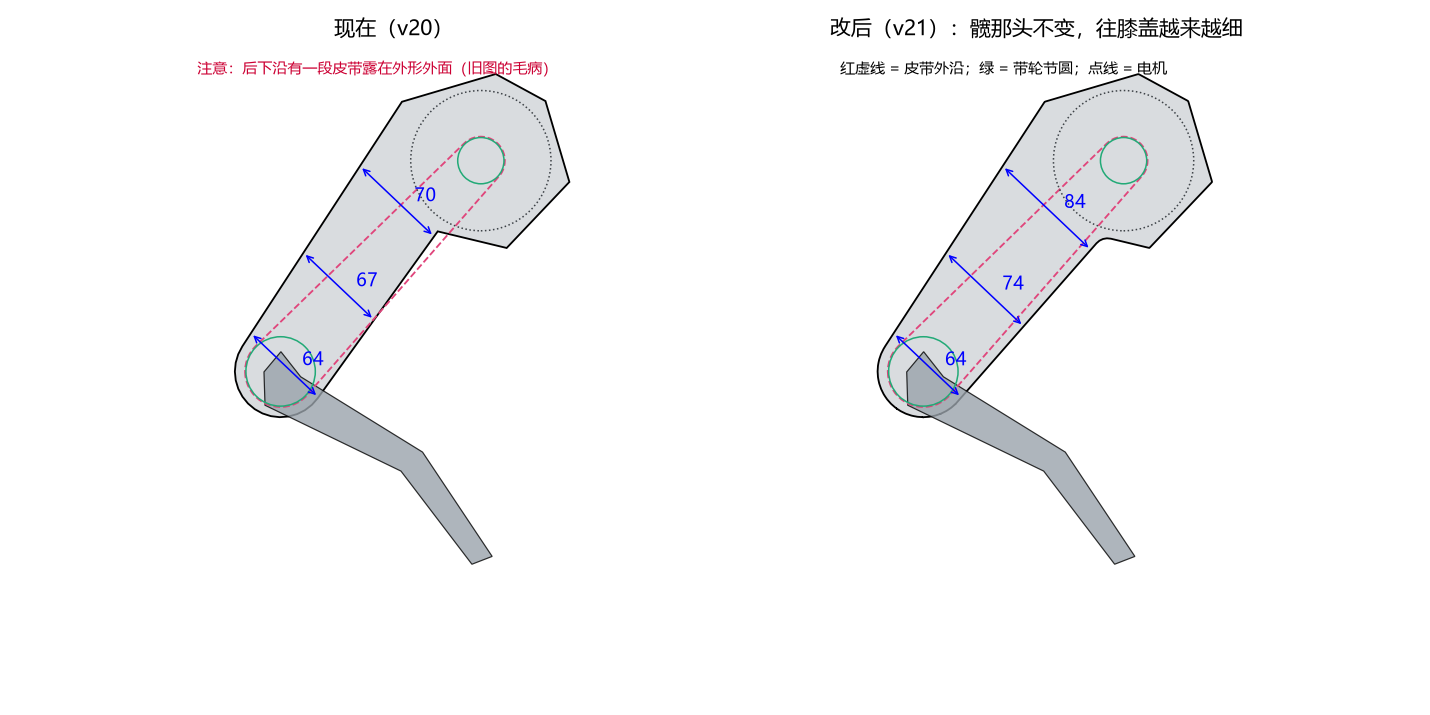
docs/机械狗007A/大腿收细对比.png
