whois169/roboot007v/docs/机械狗007A/小腿外形对比.png

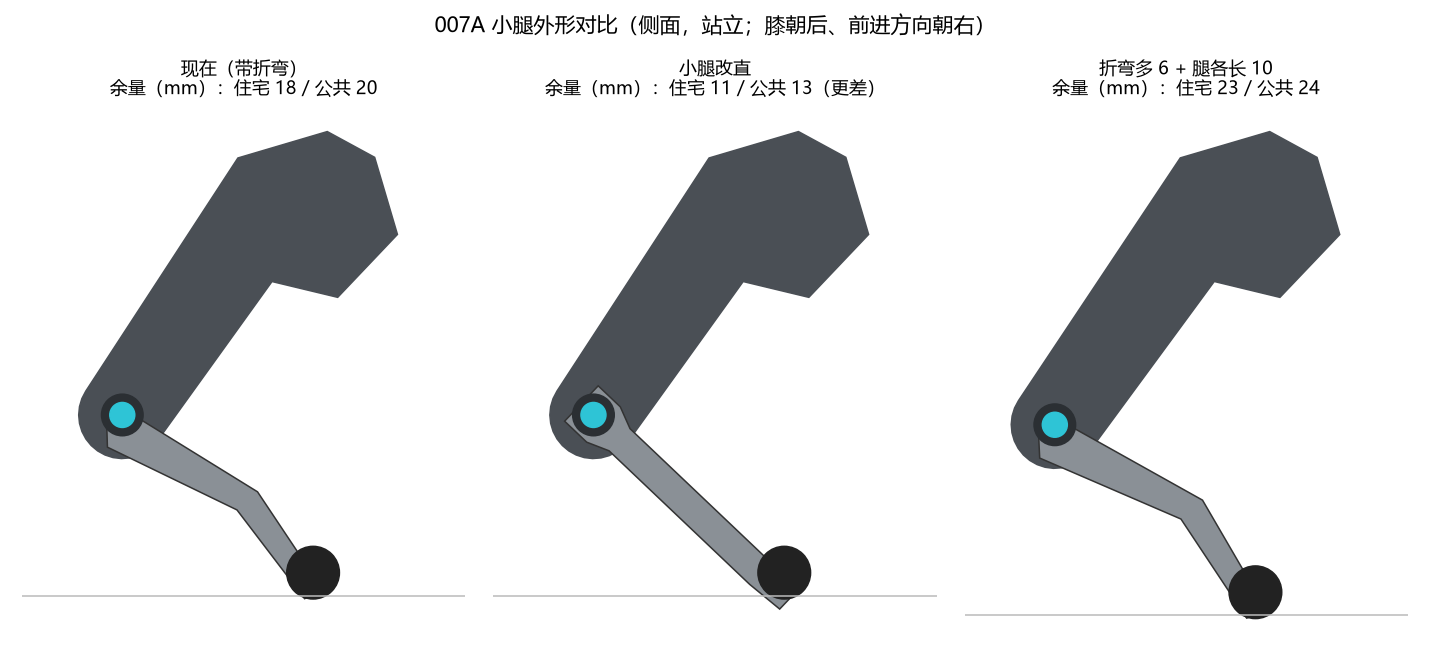
docs/机械狗007A/小腿外形对比.png
