whois169/roboot007v/docs/机械狗007A/电机布置方案.png

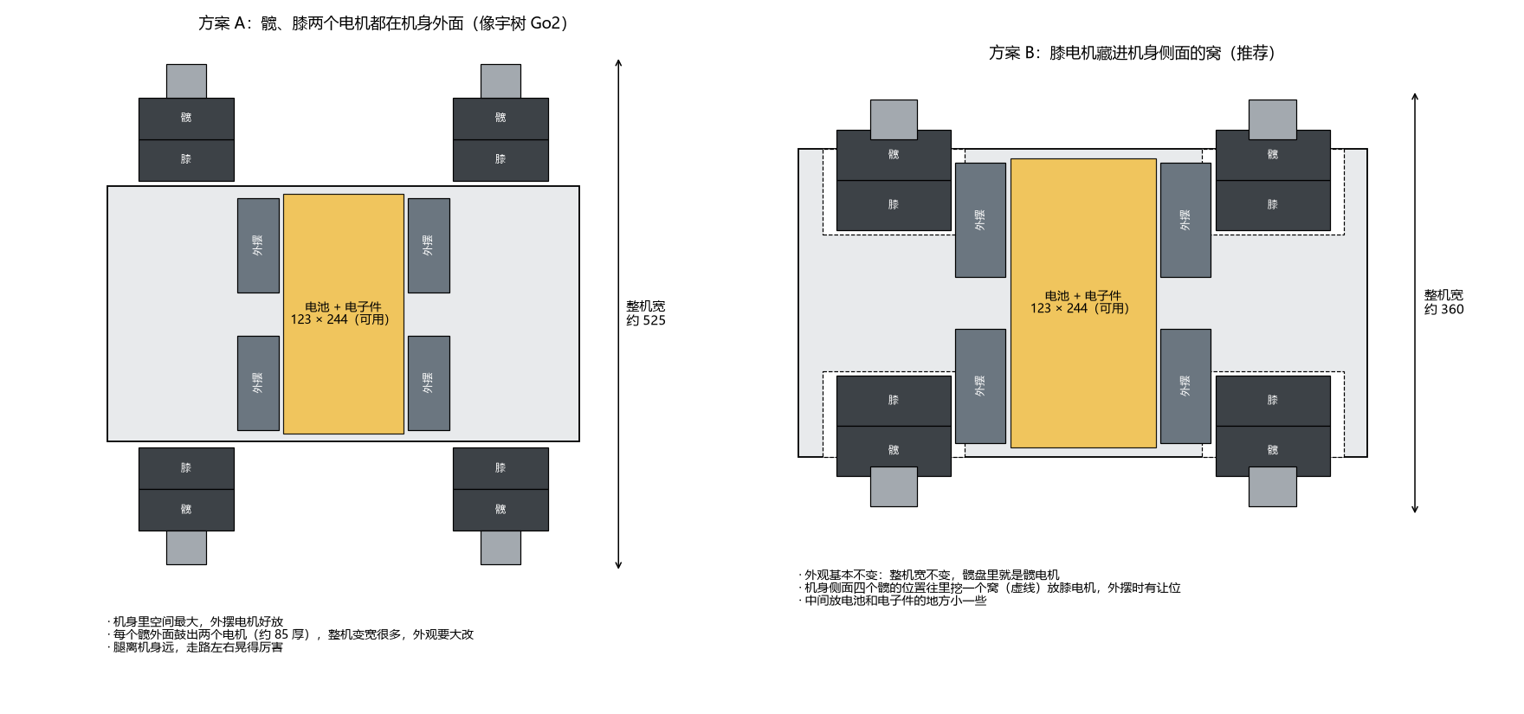
docs/机械狗007A/电机布置方案.png
