whois169/roboot007v/docs/机械狗007A/腿_截面.png

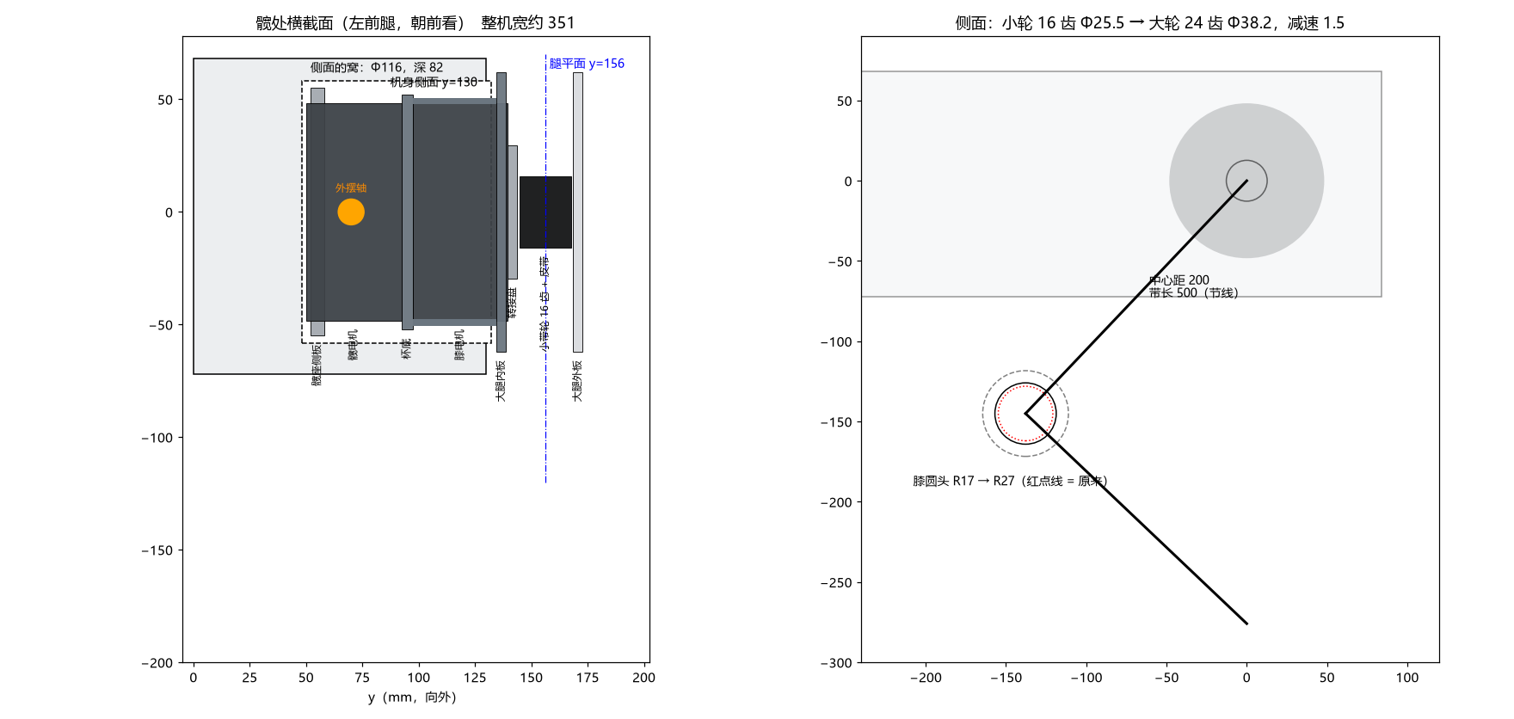
docs/机械狗007A/腿_截面.png
