whois169/roboot007v/docs/机械狗007A/膝盖_小腿根连接.png

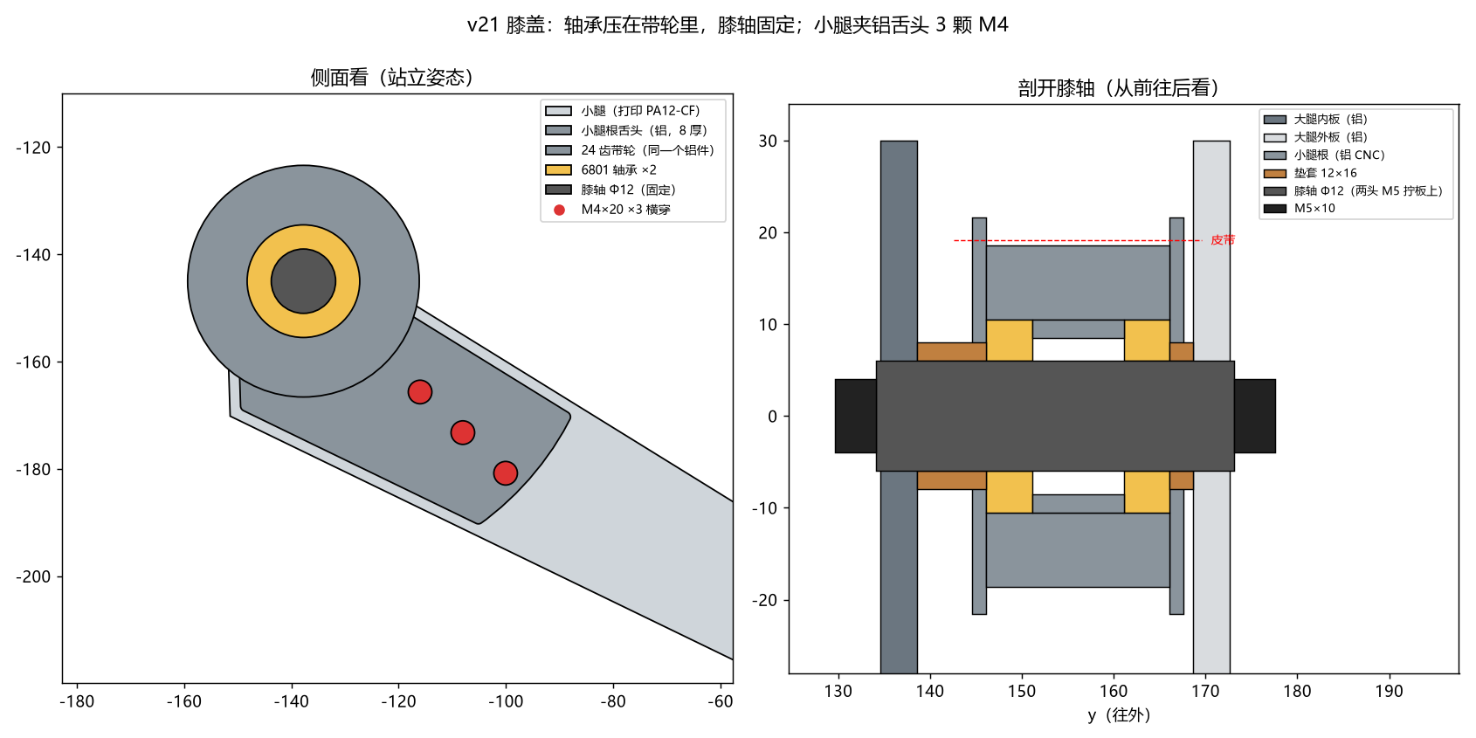
docs/机械狗007A/膝盖_小腿根连接.png
