whois169/roboot007v/docs/机械狗007A/走线图.png

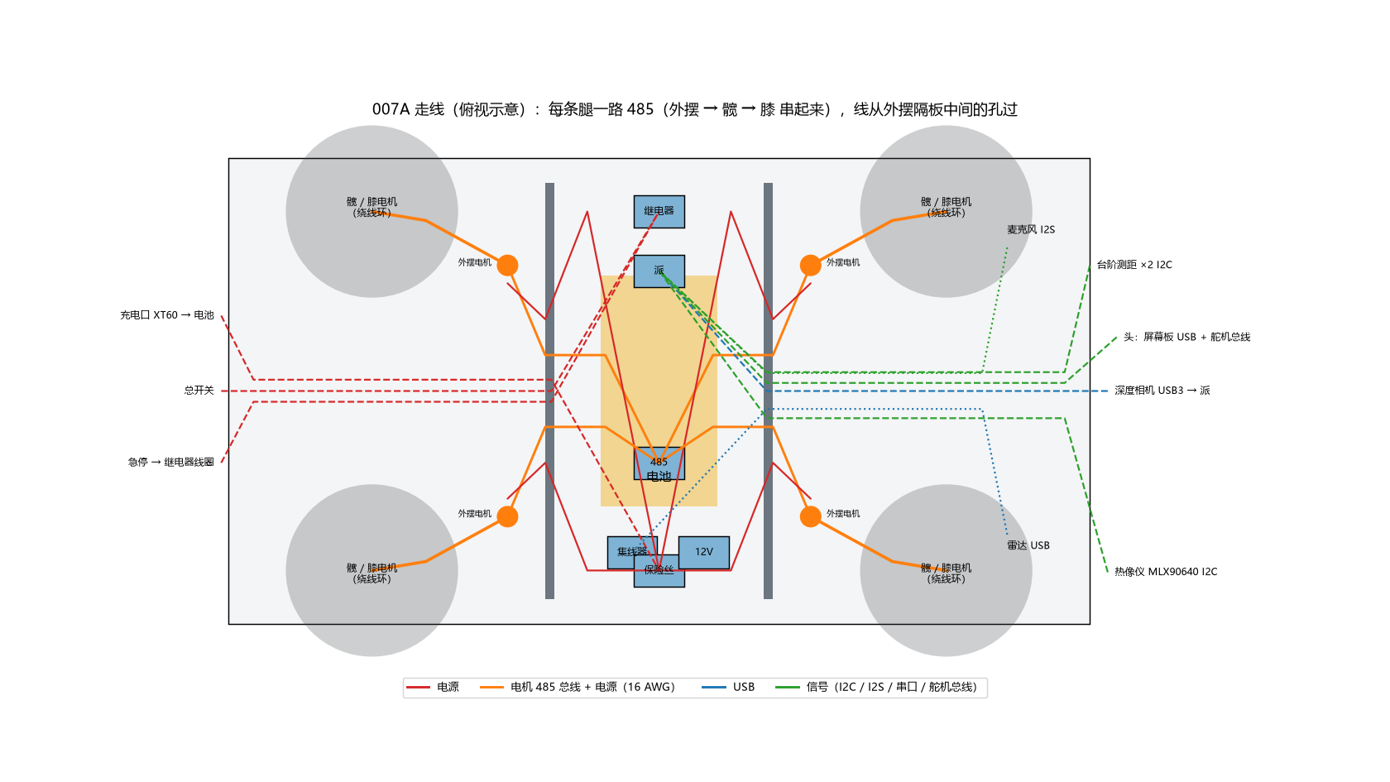
docs/机械狗007A/走线图.png
