whois169/roboot007v/docs/机械狗007A/骨架_俯视.png

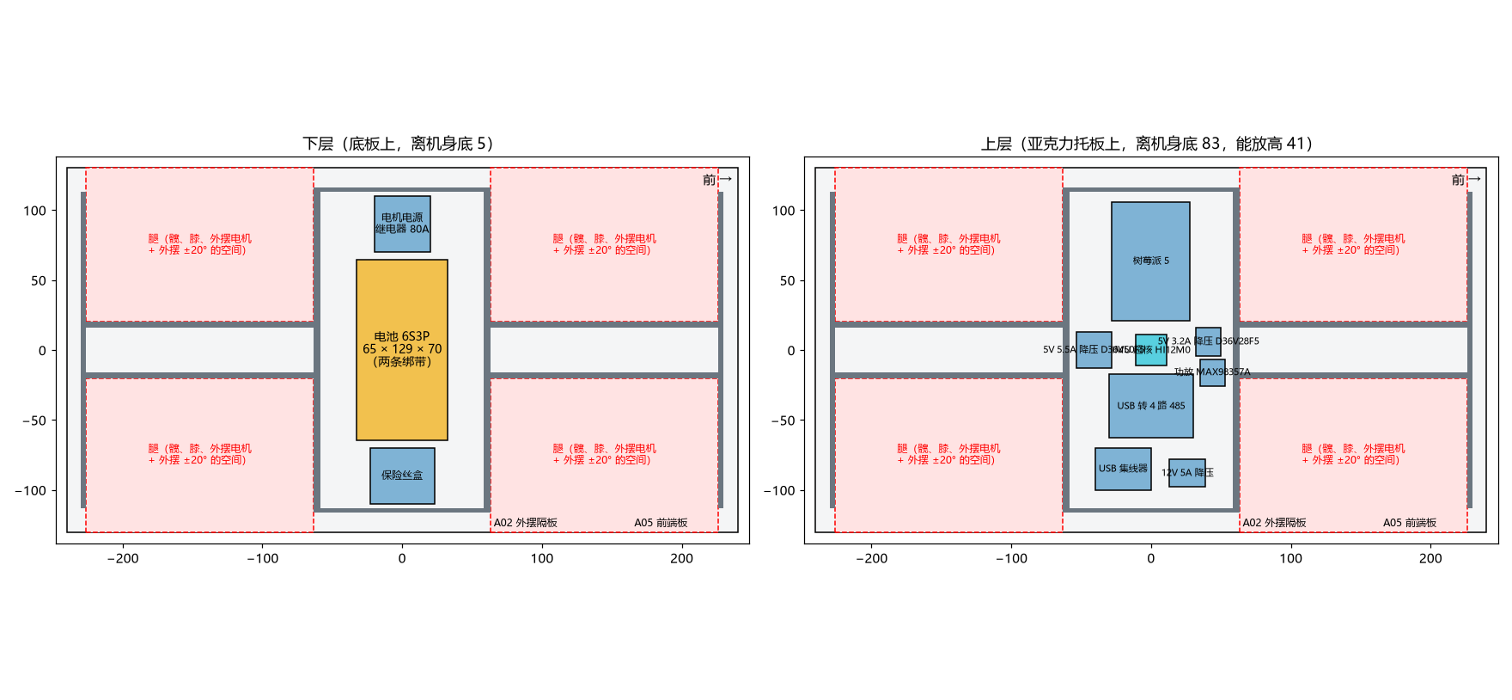
docs/机械狗007A/骨架_俯视.png
