whois169/roboot007v/docs/机械狗007A/骨架_前45.png

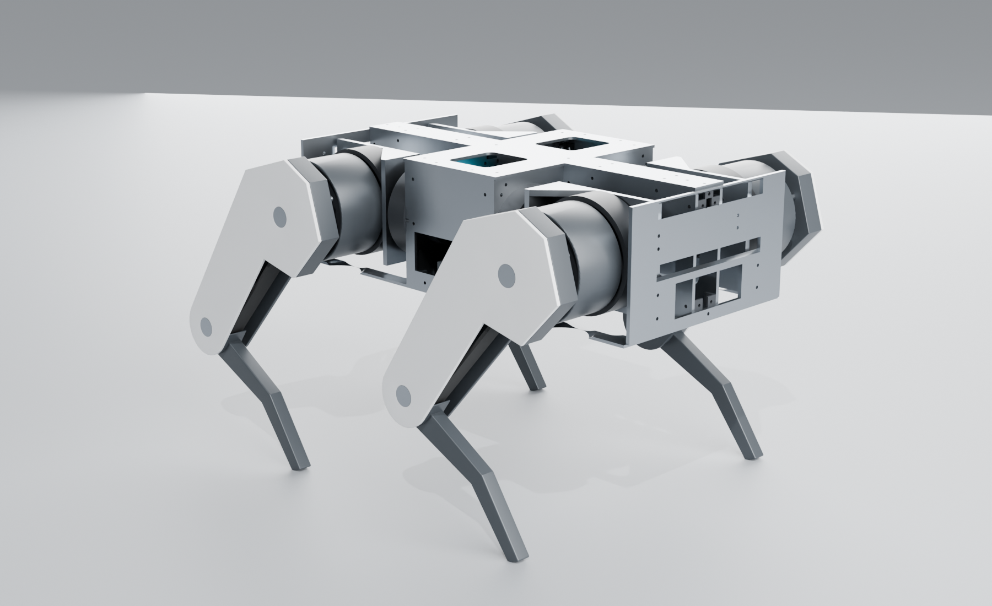
docs/机械狗007A/骨架_前45.png
