whois169/roboot007v/docs/机械狗007v/007V宣传海报_手机版.png

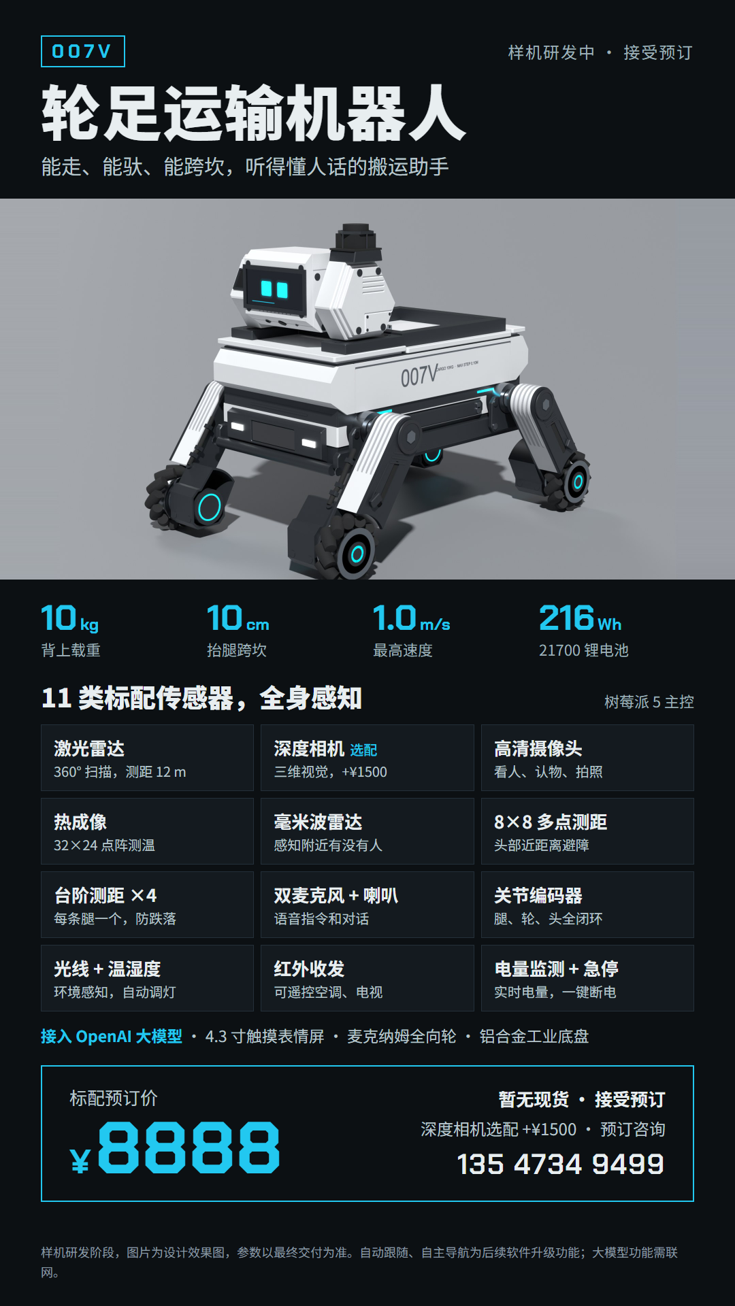
docs/机械狗007v/007V宣传海报_手机版.png
