whois169/roboot007v/docs/机械狗007v/头部爆炸图_带标注.png

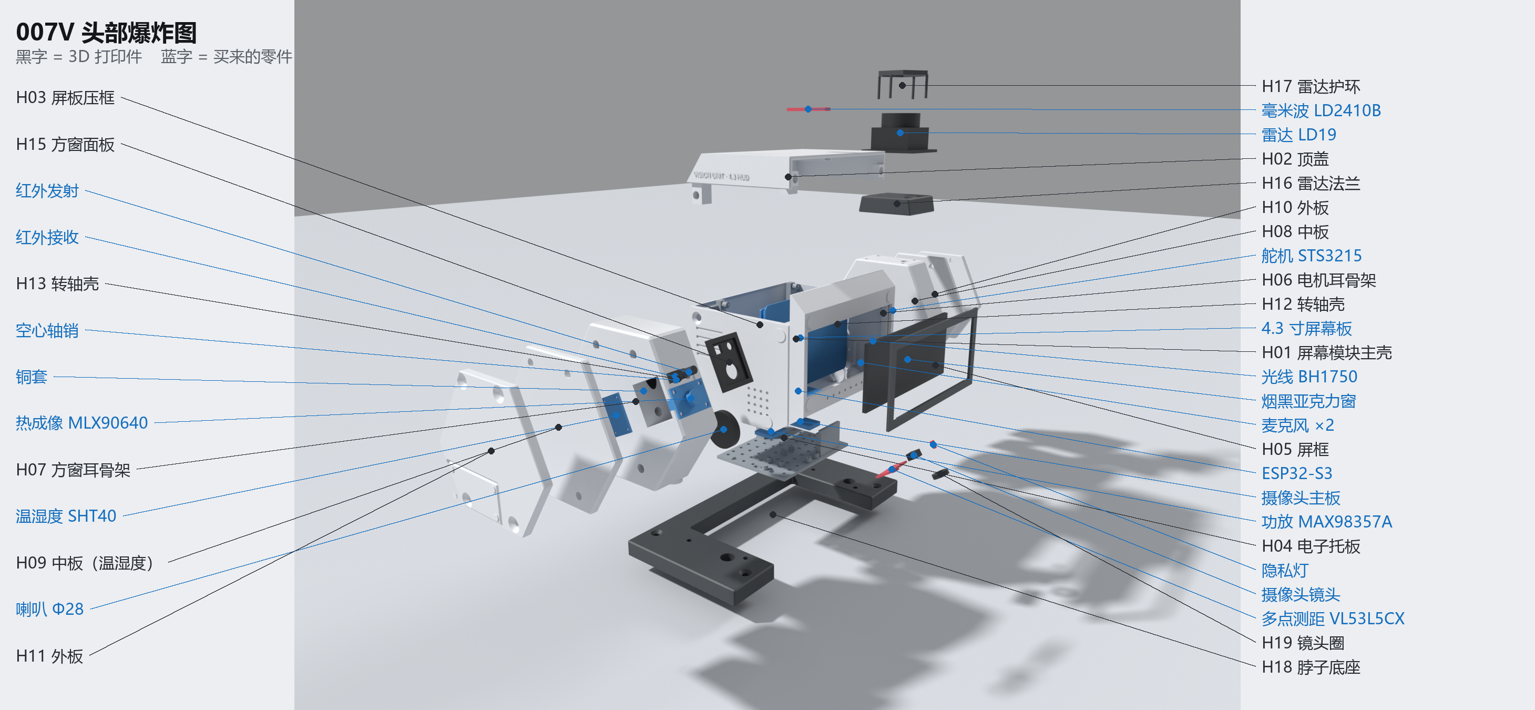
docs/机械狗007v/头部爆炸图_带标注.png
