whois169/roboot007v/docs/机械狗007v/腿部爆炸图_带标注.png

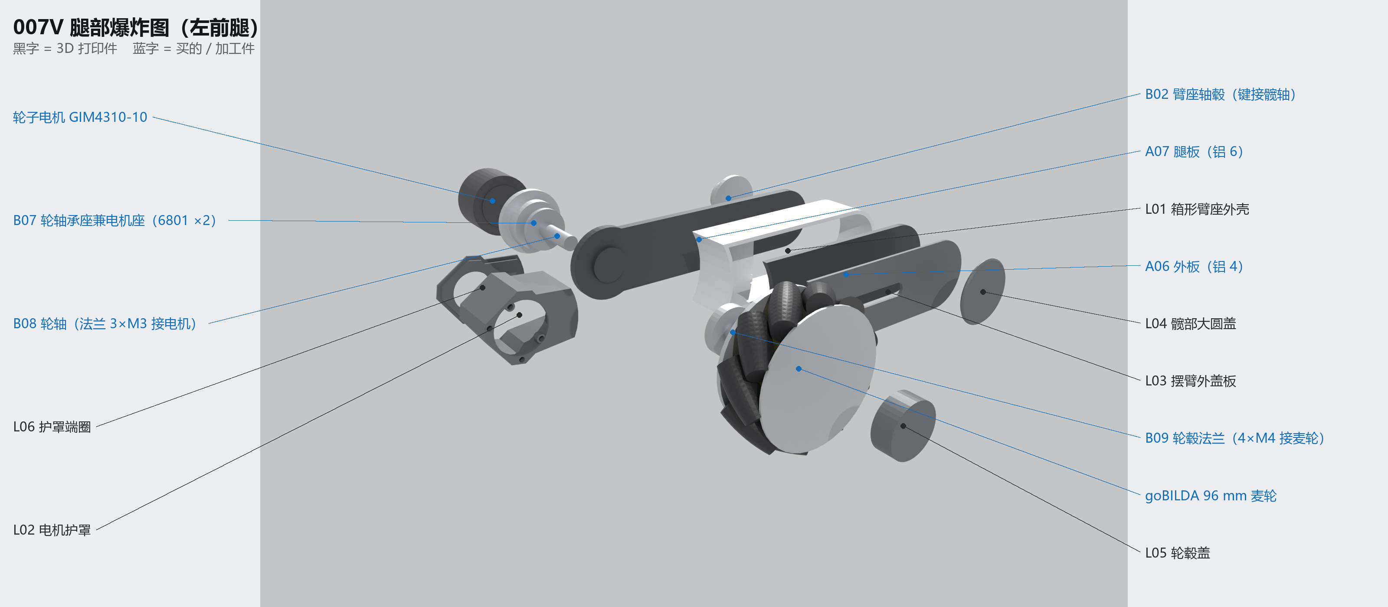
docs/机械狗007v/腿部爆炸图_带标注.png
