whois169/roboot007v/docs/机械狗007A/制造件清单.md

# 机械狗007A 制造件清单（第 4 步，v19 省钱版）

> 由 `007a/mfg.py` 生成。文件在 `007a/out/mfg/`。铝板发 DXF 给激光切割厂；CNC / 车削件发 STEP；打印件是 STL。
> 每个件一页的零件图（尺寸、孔表、三视图）在 `零件图.pdf`（`007a/drawings.py`）；外壳等打印件见 `打印件清单.md`（`007a/print_parts.py`）。
> 电机孔已按 SteadyWin 官方安装尺寸图画；孔位标 ★ 的（舵机、IMU、USB 转 CAN、驱动板厚度）到货核对后再改。

| 编号 | 名字 | 数量 | 材料 | 加工 | 厚 | 外形 | 文件 |
|---|---|---|---|---|---|---|---|
| A01 | A01底板 | 1 | 6061-T6 铝板 | 激光切割 | 3.0 | 452 × 232 | A01_A01底板.dxf, A01_A01底板.step |
| A02 | A02外摆隔板前 | 2 | 6061-T6 铝板 | 激光切割 | 5.0 | 126 × 232 | A02_A02外摆隔板前.dxf, A02_A02外摆隔板前.step |
| A03 | A03侧梁左 | 2 | 6061-T6 铝板 | 激光切割 | 3.0 | 117 × 126 | A03_A03侧梁左.dxf, A03_A03侧梁左.step |
| A04 | A04纵梁前左 | 4 | 6061-T6 铝板 | 激光切割 | 4.0 | 163 × 126 | A04_A04纵梁前左.dxf, A04_A04纵梁前左.step |
| A05 | A05前端板 | 1 | 6061-T6 铝板 | 激光切割 | 4.0 | 126 × 226 | A05_A05前端板.dxf, A05_A05前端板.step |
| A06 | A06后端板 | 1 | 6061-T6 铝板 | 激光切割 | 4.0 | 126 × 226 | A06_A06后端板.dxf, A06_A06后端板.step |
| A07 | A07顶板 | 1 | 6061-T6 铝板 | 激光切割 | 3.0 | 452 × 232 | A07_A07顶板.dxf, A07_A07顶板.step |
| L01 | 大腿外板 | 4 | 6061-T6 铝板 4（左右各 2，镜像） | 激光切割 | 4.0 | 225 × 231 | L01_大腿外板.dxf, L01_大腿外板.step |
| L02 | 大腿杯和内板 | 4 | 6061-T6 | CNC | — | 217 × 46 × 224 | L02_大腿杯和内板.step |
| L03 | 髋座 | 4 | 6061-T6 | CNC | — | 124 × 46 × 110 | L03_髋座.step |
| L04 | 转接盘和轴 | 4 | 45 钢 | 车削 | — | 59 × 33 × 59 | L04_转接盘和轴.step |
| L05 | 膝轴 | 4 | 45 钢（两头攻 M5 × 10） | 车削 | — | 12 × 38 × 12 | L05_膝轴.step |
| L06 | 大腿外层壳 | 4 | PETG / ASA | 3D 打印 | — | 215 × 23 × 214 | L06_大腿外层壳.stl |
| L07 | 小腿 | 4 | PA12-CF | 3D 打印 | — | 163 × 20 × 131 | L07_小腿.stl |
| L09 | 小腿根 | 4 | 7075-T6（齿形 HTD5M 24 齿） | CNC | — | 71 × 23 × 67 | L09_小腿根.step |
| L08 | 绕线环 | 4 | PETG | 3D 打印 | — | 112 × 30 × 112 | L08_绕线环.stl |
| J01 | L角码 | 62 | 不锈钢 / 铝（买成品，腿长 12、宽 12、厚 2，M3 孔） | 买 | — | 12 × 12 × 12 | J01_L角码.step |
| H01 | 头支架左 | 1 | 5052 铝板 3（折弯） | 钣金折弯 | — | 24 × 17 × 24 | H01_头支架左.step |
| H02 | 头支架右 | 1 | 5052 铝板 3（折弯） | 钣金折弯 | — | 24 × 17 × 24 | H02_头支架右.step |
| P01 | 电池托 | 1 | PETG | 3D 打印 | — | 73 × 137 × 25 | P01_电池托.stl |
| P02 | 托板插槽导轨 | 2 | PETG | 3D 打印 | — | 117 × 6 × 9 | P02_托板插槽导轨.stl |
| C01 | 电子托板 | 1 | 黑色亚克力 3 | 激光切割 | 3.0 | 115 × 226 | C01_电子托板.dxf, C01_电子托板.step |
