whois169/roboot007v/docs/机械狗007A/打印件清单.md

# 机械狗007A 3D 打印件清单（第 4 步，v19 省钱版）

> 由 `007a/print_parts.py` 生成，STL 在 `007a/out/print/`（按装配位置导出，切片时自己摆平、加支撑）。打印机按 256 × 256 × 256 算。
> 外壳是 2.5 mm 的壳，包在铝骨架外面；大块按 x = 0 / y = 0 拆开，接缝打 Φ4.2 × 6 销孔（Φ4 × 10 钢销）再用胶粘。
> 上层甲板壳从 A07 顶板下面用 M3 拧进热熔螺母；下层底盘从下面用 M3 圆头螺丝拧进 A01 底板。

| 编号 | 名字 | 数量 | 材料 | 外形 mm | 体积 cm³ | 能不能打 | 说明 |
|---|---|---|---|---|---|---|---|
| S01 | 上层甲板壳前左 | 1 | ASA 浅灰 | 244 × 132 × 90 | 110.6 | ✓ | 整圈接缝一共 4 个 Φ3.2 销孔（Φ3 × 10 钢销）+ 胶 |
| S02 | 上层甲板壳前右 | 1 | ASA 浅灰 | 244 × 132 × 90 | 110.7 | ✓ | 整圈接缝一共 4 个 Φ3.2 销孔（Φ3 × 10 钢销）+ 胶 |
| S03 | 上层甲板壳后左 | 1 | ASA 浅灰 | 244 × 132 × 90 | 113.5 | ✓ | 整圈接缝一共 4 个 Φ3.2 销孔（Φ3 × 10 钢销）+ 胶 |
| S04 | 上层甲板壳后右 | 1 | ASA 浅灰 | 244 × 132 × 90 | 113.5 | ✓ | 整圈接缝一共 4 个 Φ3.2 销孔（Φ3 × 10 钢销）+ 胶 |
| S05 | 黑腰前 | 1 | ASA 深灰 | 232 × 240 × 10 | 17.6 | ✓ | 接缝只有胶（壳太薄打不了销） |
| S06 | 黑腰后 | 1 | ASA 深灰 | 232 × 240 × 10 | 19.7 | ✓ | 接缝只有胶（壳太薄打不了销） |
| S07 | 下层底盘前 | 1 | ASA 浅灰 | 236 × 248 × 40 | 121.7 | ✓ | 整圈接缝一共 2 个 Φ3.2 销孔（Φ3 × 10 钢销）+ 胶 |
| S08 | 下层底盘后 | 1 | ASA 浅灰 | 236 × 248 × 40 | 135.1 | ✓ | 整圈接缝一共 2 个 Φ3.2 销孔（Φ3 × 10 钢销）+ 胶 |
| S09 | 头壳 | 1 | ASA 深灰 | 53 × 150 × 80 | 37.6 | ✓ | 壁厚 3，后面上下两片弧形裙边（滑道，跟机身缝 1.5）；屏幕玻璃（亚克力 2 mm 烟黑）从前面嵌进去；后面敞开，头支架从影线缝伸进来 |
| S10 | 侧装甲板1 | 1 | ASA 深灰 | 144 × 3 × 64 | 25.3 | ✓ | 左 |
| S11 | 侧装甲板-1 | 1 | ASA 深灰 | 144 × 3 × 64 | 25.3 | ✓ | 右 |
| S12 | 前防撞杠 | 1 | ASA 深灰 | 44 × 236 × 41 | 107.0 | ✓ | v20 一件：深度相机罩 + 热像仪座 + 探照灯筒 + 2 个台阶测距窗；背面 4 个 M3 热熔螺母（拧 A05）+ 走线槽；传感器孔位见 mounts.py |
| S13 | 雷达护圈 | 1 | ASA 深灰 | 60 × 60 × 16 | 11.3 | ✓ | 中间方口套住 LD19 安装脚；底面 2 个 M2.5 自攻孔（从壳里往上拧） |
| S14 | 尾部接口板 | 1 | ASA 深灰 | 9 × 139 × 47 | 24.1 | ✓ | 4 厚：急停 Φ22.5、开关 Φ16.2、充电口（★ XT60 开孔到货核）；背面 4 根柱子 M3 热熔螺母（拧 A06） |
| S15 | 麦克风座 | 1 | ASA 深灰 | 40 × 40 × 2 | 1.9 | ✓ |  |
| S16 | 探照灯压圈（打印） | 1 | ASA 深灰 | 2 × 36 × 36 | 1.5 | ✓ | 压住透镜，胶粘 |
| S17 | 舵机座 | 1 | PETG | 25 × 25 × 16 | 4.4 | ✓ | 抬头舵机 STS3032 座（店铺尺寸图）；2 颗 M3×8 沉头拧左头支架 H01（外面螺母），舵机后耳 2 颗 M2×6 自攻 |
| S18 | 护角 | 4 | TPU 95A 黑 | 33 × 19 × 54 | 6.8 | ✓ | 四个角一样（左右镜像打：切片里镜像） |
| S19 | 大腿外层壳 | 4 | PA12-CF / ASA | 215 × 23 × 214 | 267.0 | ✓ | 左右腿镜像（切片里镜像） |
| S20 | 小腿 | 4 | PA12-CF | 163 × 20 × 131 | 84.1 | ✓ | 左右腿镜像（切片里镜像） |
| S21 | 绕线环 | 4 | PETG | 112 × 30 × 112 | 50.0 | ✓ | 左右腿镜像（切片里镜像） |
| S22 | 大腿外盖板 | 4 | ASA 浅灰 | 99 × 3 × 110 | 10.2 | ✓ |  |
| S23 | 小腿盖板 | 8 | ASA 浅灰 | 137 × 2 × 118 | 5.8 | ✓ | 小腿两面各一块 |
| S24 | 髋盖 | 4 | ASA 深灰 | 99 × 4 × 99 | 30.5 | ✓ |  |
| S25 | 膝盖帽外 | 4 | ASA 深灰 | 30 × 4 × 30 | 2.8 | ✓ |  |
| S26 | 脚垫 | 4 | TPU 95A 黑 | 38 × 38 × 19 | 14.4 | ✓ |  |

合计约 2890 cm³（实心体积；按 15–20 % 填充、3 圈壁，耗材约 1.6 kg）。超出打印机的：没有
