whois169/roboot007v/docs/机械狗007A/零件清单.md

# 机械狗007A 零件清单

> 由 `007a/bom.py` 生成（改清单改那个文件，再跑 `python 007a/bom.py`）。价格是国内零售大概价，以下单时为准。
> 批次：**样品** = 先买 1 个（电机先买 1 条腿的 3 个）测试；**第二批** = 样品测过再买齐；**第2步定** = 结构件，等骨架图纸；**沿用** = 007v 已有。

**样品这一批约 8950 元；样品合格后第二批约 12775 元；第 2 步结构件约 0 元起**（不含沿用的树莓派；铝板、车削件、打印耗材第 2 步出图后再算）。

## 下单时要问卖家要图的（★）

## 清单

### 关节

| 名称 | 规格 / 型号 | 样品 / 总数 | 单价 | 批次 | 硬指标 | 搜索关键词 | 尺寸与孔位 | 状态 | 备注 |
|---|---|---|---|---|---|---|---|---|---|
| 关节电机 | 宇树 GO-M8010-6（驱动在电机里面，24 V，RS-485） | 3 / 12 | 897 | 样品 | 峰值 23.7 N·m（减速 6.33）；最大电流 40 A；24 V 供电最高 30 rad/s；12–30 V（推荐 24 V）；RS-485 4 Mbps | 宇树 GO-M8010-6 关节电机 | Φ96.5（削平 92.5）× 42.3，约 530 g；输出盘 Φ59 凸 6.6、6-M4 在 Φ34.5；背面 8-M3.5 在 R42.5、背面凸台凸出 8（直径★按图量约 Φ61）；壳上 8 根筋各一个 M3.5（R44.5）（官方《GO-M8010-6 用户手册 V1.0》尺寸图，007a/ref/go-m8010-6/） | 已确认 | v20 换回宇树（用户定）。天猫 Unitree 宇树旗舰店“1个装”1500 元；“会员价”897 元 = 账号首次购买、一个账号限 2 个（客服 2026-10-30）；学生价要学生证 + 学信网、电机相关专业、一证限 2 个。驱动在电机里（客服确认），不用买套装。M3.5 螺丝要专门买 |
| USB 转 4 路 485 | 宇树 USB 转 4 路 485 模块（每路一条腿，3 个电机一条总线） | 1 / 1 | 269 | 样品 | 4 Mbps；一个模块管 4 条腿 | 宇树 USB转4路485模块 | 光板约 60 × 35（照片估），托板留 60 × 45 | 已确认 | 宇树旗舰店 269 元（2026-10-31 截图；之前看到 199）；光板没有安装孔（店铺照片），托板上用扎带 + 双面胶，不用等尺寸；不要买“CAN 转 485”“UART 转 485” |
| 电机线和转接板 | 宇树“包装清单1”（199 元，买 1 套照着做）+ XT30(2+2) 电源信号线（49 元一根）+ XT30(2+2) 母头、GH1.25-3 信号线自己做 | 1 / 1 | 400 | 样品 | 电源线 ≥16 AWG（手册要求） | 宇树 GO 电机 XT30 2+2 转接板 线 | XT30(2+2)-F（Amass，20 A） | 已确认 | 包装清单1 里有：高速单路 485 通信模块、XT30 电源线、GH1.25 数据线、XT30(2+2) 线等（店铺页面）；其余 11 个电机的线照着做 |
| 小同步带轮 | HTD5M 16 齿，铝，带挡边，带宽 20，孔 Φ12 + 键槽 | 1 / 4 | 30 | 样品 | 装在转接轴上（L04）；节圆 Φ25.5 | HTD5M 同步轮 16齿 宽20 孔12 键槽 | 节圆 Φ25.46 | 已确认 | v21 小一号带轮（用户定）：减速 24 / 16 = 1.5 |
| 小腿根 L09（CNC） | 7075-T6 铝 CNC 一体：HTD5M 24 齿带轮（带挡边，带宽 20）+ 往下 8 厚舌头 + 孔 Φ21 压 2 个 6801（中间 Φ17 台阶）；舌头 3 个 Φ4.4 孔 | 1 / 4 | 200 | 样品 | 节圆 Φ38.2；膝盖力：铝齿 → 铝舌头 → 3 颗 M4 → 打印小腿 | CNC 加工 7075 同步带轮 HTD5M 24齿 非标（发 STEP） | STEP 在 007a/out/mfg/L09_小腿根.step | 已确认 | v21（用户：轴承用小的、放进带轮里）：膝轴不转、拧死在大腿两块板上，小腿根绕轴承转；单价是估价，发 STEP 找 CNC 厂报价 |
| 膝轴固定件 | M5 × 10 内六角 ×2 / 腿（拧膝轴两头）+ 垫套 12 × 16（长 6–7，按图车或买尼龙/铜套）×2 / 腿 + M4 × 16 薄头内六角（DIN7984）+ M4 薄螺母（2.2 厚）×3 / 腿（小腿夹舌头，头和螺母沉进小腿 Φ8.5 × 3 沉孔） | 1 / 4 | 8 | 样品 | — | M5x10 内六角；轴套 12x16；M4x16 薄头内六角 DIN7984；M4 薄螺母 | — | 已确认 | 垫套只顶轴承内圈，带轮两边留缝 |
| 膝同步带 | HTD5M 500 节线长（100 齿）、宽 20、PU 钢丝芯闭口带 | 2 / 6 | 40 | 样品 | 膝峰值 35 N·m 时拉力约 1860 N：一定要钢丝芯 PU 带 | PU钢丝 同步带 500-5M 宽20 闭口 | 中心距 200 正好 100 齿 | 已确认 | 卖家确认 20 宽能长期扛 1860 N（2026-10-31）；多买 2 根备用；张紧轮在大腿后侧调 |
| 轴承 | 6801-2RS（12 × 21 × 5）：膝 2 个（压在小腿根里）+ 大腿外板 1 个 / 腿；MF105（5 × 10 × 4，法兰）×2 给头的右转轴 | 3 / 14 | 4 | 样品 | — | 6801-2RS 轴承；MF105 法兰轴承 | 12 × 21 × 5 | 已确认 | 多买 2 个 |
| 张紧轮 | Φ18 光面惰轮（带轴承，M5 轴） | 1 / 4 | 8 | 样品 | — | 同步带 惰轮 18 光面 M5 | Φ18 | 到货实测 | 大腿后侧直段上，长孔 ±4 调 |
| 足端橡胶 | 半球橡胶脚垫 Φ40（TPU 95A 自己打也行） | 4 / 6 | 10 | 样品 | 防滑、耐磨 | 机器狗 足端 橡胶 脚垫 | — | 到货实测 | 多 2 个备用 |

### 传感器

| 名称 | 规格 / 型号 | 样品 / 总数 | 单价 | 批次 | 硬指标 | 搜索关键词 | 尺寸与孔位 | 状态 | 备注 |
|---|---|---|---|---|---|---|---|---|---|
| 深度相机 | 奥比中光 Gemini 335 | 1 / 1 | 1980 | 样品 | 0.1–20 m（最佳 0.26–3 m）；视场 90° × 65°；USB-C（USB 3.0）；< 3 W | 奥比中光 Gemini 335 | 90 × 25 × 30，97 g；底部 1/4-20，背面 2 × M3（官网） | 已确认 | 淘宝 亚博智能旗舰店 1980 元（500+ 人买，2026-10-29）；别家 1500–2050；前防撞杠正中的相机罩里，往下斜 20° 看台阶 |
| 探照灯 | XHP50 LED 20 mm 铜基板（6 V）+ 3° 聚光透镜矮款（直径 21.78 高 17.6，带支架）+ 20 × 20 × 6 散热铝块（带导热胶）+ 恒流驱动（12 V 入，调到约 3 W） | 1 / 1 | 40 | 样品 | 约 400 流明够照路；ASA 灯筒里散热有限，功率别超过 3 W | XHP50 20mm铜基板 6V；3度超聚光透镜 XML 5050 直径21.7 高17.6；20*20*6 铝散热片 带胶 | 透镜 Φ21.8 × 17.6、基板 Φ20 × 1.6、铝块 20 × 20 × 6（店铺图） | 已确认 | v20 加回来（用户要）：前防撞杠左头的灯筒里，打印压圈压住透镜 |
| 热像仪 | Adafruit MLX90640 24×32 热成像 110°（4469） | 1 / 1 | 400 | 样品 | 跟 007v 同款（007v/brain/dog/thermal.py 能直接用）；I2C；要 110° 那款（4469），不是 55°（4407） | Adafruit MLX90640 110度 4469 | 25.8 × 17.8 × 10.5（官方） | 设计时查官方图 | v19：原来的艾睿 P2 Pro 1999 元换成它；前防撞杠右头，镜头前直接开 Φ12 孔（塑料挡远红外） |
| IMU | 超核 HI12M0-MI1-000（基础型 IMU/VRU，带同步，UART(TTL) + CAN 2.0） | 1 / 1 | 350 | 样品 | 走路平衡必须有；UART 接树莓派串口（3.3 V TTL） | 超核 HI12M0-MI1-000 | 22 × 22 × 10；3-Φ2.6（下排孔距 17、上下 16.6）（天猫 HiPNUC 旗舰店尺寸表） | 已确认 | 用户选的（淘宝 HiPNUC 超核，2026-10-31 实付 350）；3 颗 M2.5 铜柱直接拧 C01 托板正中、靠近重心（v21 取消打印卡座） |

### 电源

| 名称 | 规格 / 型号 | 样品 / 总数 | 单价 | 批次 | 硬指标 | 搜索关键词 | 尺寸与孔位 | 状态 | 备注 |
|---|---|---|---|---|---|---|---|---|---|
| 电池 | 6S3P 21700 锂电组定做（Molicel P42A）+ 60 A 均衡保护板 + 25.2 V 充电器 | 1 / 1 | 1000 | 样品 | 22.2 V 12.6 Ah 约 280 Wh；持续 ≥ 60 A；满电 25.2 V（宇树电机 12–30 V 以内）；XT60 头 | 6S3P 21700 P42A 电池组 定做 | 18 节：6 列 × 3 排平放约 130 × 65 × 70（第 2 步按机身里的空间定排法） | 第2步定 | 电机刹车会往回充电：要用电池供电（不要用开关电源），保护板要能吃回充电流 |
| 电机电源继电器 | 24 V 80 A 汽车继电器（带座） | 1 / 1 | 30 | 样品 | 12 个电机峰值合起来可能 60 A 以上 | 汽车继电器 24V 80A | — | 到货实测 | 急停断这个（和 007v 一样：急停串在继电器线圈上） |
| 12 V 降压（抬头舵机、探照灯） | 24 V 转 12 V 5 A 降压模块 | 1 / 1 | 20 | 样品 | — | 24V转12V 5A 降压 | — | 到货实测 | — |
| USB 集线器 | 带外接 5 V 供电的 USB 3.0 集线器（7 口） | 1 / 1 | 80 | 样品 | 要接：USB 转 4 路 485、深度相机（USB 3）、雷达、屏幕板（IMU 走串口不占） | USB3.0 集线器 外接供电 7口 | — | 到货实测 | — |
| 电池监测（多路） | INA226 模块 + 电机总线大电流分流器 75 mV 100 A | 1 / 1 | 40 | 样品 | — | INA226 分流器 100A 75mV | — | 到货实测 | — |

### 结构

| 名称 | 规格 / 型号 | 样品 / 总数 | 单价 | 批次 | 硬指标 | 搜索关键词 | 尺寸与孔位 | 状态 | 备注 |
|---|---|---|---|---|---|---|---|---|---|
| 铝板激光切割 | A01–A07 机身（3 / 4 / 5 mm）+ L01 大腿外板 ×4 + H01 / H02 头支架，6061-T6 | 1 / 1 | 500 | 第二批 | DXF 发激光切割厂 | 铝板 激光切割 6061 | 见 制造件总览.png | 已确认 | 角码孔、减重孔、安装孔都有了；孔位都按官方 / 店铺图；485 模块是光板没孔，用扎带 |
| CNC 件 | L02 大腿杯 + 内板 ×4、L03 髋座 ×4（6061-T6） | 1 / 1 | 2000 | 第二批 | STEP 发 CNC 厂 | CNC 加工 铝 6061 小批量 | — | 已确认 | 价格估的（每件约 250）；先做一条腿的 2 件试装 |
| 车削件 | L04 转接盘 + 轴 ×4、L05 膝轴 ×4（45 钢，两头攻 M5） | 1 / 1 | 320 | 第二批 | — | 车削加工 45钢 | — | 已确认 | — |
| 打印耗材 | 外壳 ASA 浅灰 2 kg、深灰 1 kg；大腿外层壳 / 小腿 PA12-CF 1 kg；电池托、导轨 PETG | 1 / 1 | 600 | 第二批 | — | — | — | 已确认 | — |
| 电子托板 | C01 黑色亚克力 3 mm 激光切割 | 1 / 1 | 30 | 第二批 | — | 亚克力 激光切割 | — | 已确认 | — |
| L 角码 + 螺丝 | L 型角码（腿长 12、宽 12、厚 2，M3 孔）×62 + M3×8 内六角 ×130 + M3 防松螺母 ×130 | 1 / 1 | 90 | 第二批 | 骨架铝板之间全靠它连（eng_body.py joints()） | L型角码 12x12 M3 不锈钢 | 孔离角 7 | 到货实测 | 买不到 12 的就买 15，告诉我改图 |
| 热熔螺母、外壳螺丝 | M3 铜热熔螺母 ×30（外壳螺丝柱）、M3×10 ×20（外壳拧顶板 / 底板） | 1 / 1 | 25 | 第二批 | — | M3 热熔螺母 | — | 已确认 | — |
| 电机螺丝 M3.5 | M3.5 × 8 内六角（电机背面 8 个孔 × 12 个电机，多买）×110 + M4 × 10 内六角（输出盘 6 个 × 12）×80 | 1 / 1 | 60 | 第二批 | 宇树电机背面是 M3.5（不常见），螺纹深度 ★ 到货量再定长度 | M3.5 内六角 螺丝 | — | 到货实测 | — |
| 托板铜柱 | M2.5 × 6 铜柱 + 螺丝螺母 ×10（树莓派 4、功放 2、IMU 3、多 1）；M2 × 6 铜柱 + 螺丝螺母 ×6（两块 Pololu 降压） | 1 / 1 | 15 | 第二批 | — | M2.5 铜柱 6mm 套装；M2 铜柱 6mm | — | 已确认 | — |
| 定位销、自攻螺丝 | Φ3 × 10 钢销 ×40（外壳接缝）；M2 × 6 自攻 ×10（台阶测距）、M2 × 8 自攻 ×10（雷达）；M2.5 × 6 自攻 ×20（热像仪、充电口、雷达护圈）；M3 × 6 ×2（深度相机） | 1 / 1 | 30 | 第二批 | — | 定位销 3x10；M2 自攻；M2.5 自攻 | — | 已确认 | — |

### 沿用 007v

| 名称 | 规格 / 型号 | 样品 / 总数 | 单价 | 批次 | 硬指标 | 搜索关键词 | 尺寸与孔位 | 状态 | 备注 |
|---|---|---|---|---|---|---|---|---|---|
| 急停按钮 | 施耐德 XB2BS542C（Φ40 红蘑菇头，旋转复位，1 常闭）+ ZB2BE101C 常开触点 1 个 | 1 / 1 | 90 | 样品 | — | 施耐德 XB2BS542C 急停 + ZB2BE101C | 开孔 Φ22.5，面板后 ≤ 66.5（官方图纸 ref/estop/） | 已确认 | 常闭断电机继电器，常开告诉 ESP32；加的常开触点要装在同一个底座上，不能往后叠（后面只留了 66.5） |
| 总开关 | 16 mm 金属平头自锁按钮带环形灯，24V 灯（GQ16F 系列，自锁、环形灯） | 1 / 1 | 25 | 样品 | — | 16mm 金属按钮 自锁 环形灯 24V 平头 | 开孔 Φ16.2，头 Φ18，螺母 19，面板后 ≤ 26（ref/switch/） | 已确认 | 灯接 24V：开机就亮 |
| 充电口 | Amass XT60E1-F 面板母座（黑色，带两个固定孔）+ XT60 公头防尘帽 | 1 / 1 | 12 | 样品 | — | Amass XT60E1-F 黑色 面板座 + XT60 防尘帽 | 27.1 × 12.1 × 16.7（ref/xt60/），固定孔距 20.5 到货用卡尺核对 | 已确认 | 车上用母座（带电那头不露铜）；充电器那头换 XT60 公头 |
| 保险丝盒 | 6 路刀片保险丝盒 + 保险丝（30A×1、10A×2、5A×6、3A×2） | 1 / 1 | 35 | 样品 | — | 6路 刀片保险丝盒 | — | 到货实测 | — |
| 接头和线 | XT60（公母 5 对）、XT30（10 对）、14/18/22 AWG 硅胶线、CAN 双绞线、GH1.25 / JST 端子 | 1 / 1 | 120 | 样品 | — | XT60 XT30 硅胶线 | — | — | — |
| 5V 5A 降压 | Pololu D36V50F5（5V 5.5A） | 1 / 1 | 150 | 样品 | 输入 ≥30V；5V ≥5A（树莓派 5 要 5A） | Pololu D36V50F5 | 25.4 × 25.4 × 9.5，3 个 M2 孔 | 已确认 | 单独一路给树莓派 5 |
| 5V 3A 降压 | Pololu D36V28F5（5V 3.2A） | 1 / 1 | 90 | 样品 | — | Pololu D36V28F5 | 17.8 × 22.9 | 已确认 | 给头部 USB 集线器、雷达、底盘 ESP32 |
| 屏幕板 | 微雪 ESP32-S3-Touch-LCD-4.3B（800×480，触摸） | 1 / 1 | 260 | 样品 | — | 微雪 ESP32-S3-Touch-LCD-4.3B | 112.4 × 75.1（官方）；PCB 4 个 M2 孔：相距 92 / 低 50 | 已确认 | 只当显示屏（HUD），通过 USB 接树莓派；已按官方图纸和 3D 模型做了卡槽和压框（H01、H03）；USB 口离侧壁近，要配 90° 侧弯线 |
| 抬头舵机 | 飞特 STS3032（20 g，4.5 kg·cm，5 V 总线，磁编码）+ 总线舵机转接板 | 1 / 1 | 60 | 样品 | 5 V（不是 12 V）；和 007v 的 STS3215 同一套总线协议 | 飞特 STS3032 总线舵机 | 23 × 12 × 27.5，耳总长 32（店铺尺寸图） | 到货实测 | 舵机座 P04 是打印件，耳孔差 1 mm 就重打一个，不卡下单；头只有约 150 g，0.25 kg·cm 就够；STS3215 太大，装进头里转起来会碰屏幕板（eng_head.py 查过 STS3032 不碰） |
| 激光雷达 | 乐动 LD19（DTOF，12 m，带 USB 转接板） | 1 / 1 | 280 | 样品 | — | LD19 激光雷达 | 3 个 Φ2.5 孔：前两个相距 46.8，后一个居中，前后 31.92；总高 34.8，扫描面离底 27 | 已确认 | 装在电机耳顶上的低矮法兰上（打印件 H16，3 颗 M2×8 自攻） |
| 功放 | Adafruit MAX98357A I2S 功放板（3006） | 1 / 1 | 50 | 样品 | 原装 Adafruit | Adafruit MAX98357A 3006 | 官方有尺寸图 | 设计时查官方图 | 接喇叭 |
| 喇叭 | Φ28 小喇叭 8Ω 1W | 2 / 2 | 5 | 样品 | 直径 28 | 28mm 喇叭 8欧 1W | Φ28 | 到货实测 | 前脸两边的扬声器孔后面，左右各一个 |
| 麦克风 | INMP441 I2S 全向麦克风模块（圆板 Φ13.8） | 2 / 2 | 10 | 样品 | 圆形 Φ13.8 那款 | INMP441 全向麦克风模块 圆形 | Φ13.8，底部进声 | 已确认 | 顶上右前角的麦克风座（会议助手录音、听指令） |
| 台阶测距 | Pololu VL53L1X 测距板（3415） | 1 / 2 | 70 | 样品 | 原装 Pololu | Pololu VL53L1X 3415 | 12.7 × 17.78，2 × Φ2.18 孔距 12.7（官方图） | 已确认 | 前防撞杠 2 个，往下斜看台阶 |
| 树莓派 5 | Raspberry Pi 5 + 官方主动散热 | 0 / 1 | — | 沿用 | — | — | 85 × 56；4 × M2.5，58 × 49 | 已确认 | — |

## 尺寸资料来源

- 宇树 GO-M8010-6 用户手册 V1.0（尺寸图、接线、XT30(2+2)）：存在 `007a/ref/go-m8010-6/`；官网 https://www.unitree.com/cn/go1/motor
- 奥比中光 Gemini 335：https://www.orbbec.com/products/stereo-vision-camera/gemini-335/
- 超核 HI12M0：天猫 HiPNUC 旗舰店详情页尺寸表（https://detail.tmall.com/item.htm?id=845713072380）
- 艾睿 Tiny1-C：https://www.infiray.com/products/tiny1-c-micro-uncooled-ir-camera-sensor-module.html
- 沿用 007v 的零件：见 `docs/机械狗007v/零件清单.md` 的资料来源
