whois169/roboot007v/docs/机械狗007v/零件清单.md

# 机械狗007v 零件清单

> 由 `007v/bom.py` 生成（改清单改那个文件，再跑 `python 007v/bom.py`）。价格是国内零售大概价，以下单时为准。
> 头部打印件（H01–H18）、头部要买的螺丝 / 热熔螺母 / 磁铁 / 亚克力窗、装配步骤，见 `头部打印与装配说明.md`。`out/mfg/` 里的 D02、D07–D14、D18 只是外观模型，不要打印。
> 批次：**样品** = 先各买 1 个测试（选型计算书第五节）；**第二批** = 样品测过、图纸改好再买；**已有** = 旧项目沿用；**以后** = 现在不买。

**样品这一批约 5501 元；样品合格后第二批约 4449 元**（不含已有的树莓派，不含以后的深度相机）。

## 下单时要问卖家要图的（★）

这几样的安装孔位网上查不到，图纸里先按常见规格画、标了 ★。下单时请卖家发**安装尺寸图（PDF 或 STEP）**，拿到后发给我，我改图：

## 清单

### 底盘

| 名称 | 规格 / 型号 | 样品 / 总数 | 单价 | 批次 | 硬指标 | 搜索关键词 | 尺寸与孔位 | 状态 |
|---|---|---|---|---|---|---|---|---|
| 轮子电机 | SteadyWin GIM4310-10 V1.1（自带驱动 + 编码器，CAN） | 1 / 4 | 580 | 样品 | 24V；额定 ≥1.9、峰值 ≥2.4 N·m；带载 ≥180 转/分；Φ≤60、厚≤45；买 V1.1 | GIM4310-10 关节电机 CAN | Φ53 × 41（GDZ34 驱动版；GDS34 版 39 也行），227 g；输出盘 3-M3 Φ27，前面机壳 3-M2.5 Φ47.5 | 已确认 |
| 麦克纳姆轮（一套 4 个） | goBILDA 96 mm 麦轮套装（3213-3606-0002，左 2 + 右 2，70A 轴承滚子） | 1 / 1 | 1100 | 样品 | 认准 goBILDA 原装（官方有 3D 模型） | goBILDA 96mm 麦克纳姆轮 3213-3606-0002 | Φ96.3 × 37.2，轮毂 Φ14 孔 + 16 mm 孔型 4 × M4（官方 3D 模型） | 已确认 |
| 髋蜗轮电机 | NFP-5840-31ZY-EN 蜗轮蜗杆减速电机（带霍尔编码器，自锁），24V，减速比 505（空载 16 转/分） | 1 / 4 | 130 | 样品 | 24V；减速比 505：额定 70 kgf·cm（3:1 后 20.6 N·m）；输出轴 Φ8 D 形；带编码器 | NFP-5840-31ZY-EN 24V 505 编码器 蜗轮蜗杆 | 减速箱 58 × 40 × 31，4 × M4 孔距 28 × 40，输出轴 Φ8 伸出 15、离远端 20；电机 Φ31 × 57（厂家图） | 已确认 |
| 小同步带轮 | HTD3M 15 齿，D 形孔 8，带挡边，带宽 10 | 1 / 4 | 12 | 样品 | D 孔对上蜗轮电机输出轴；带两颗顶丝 | 3M 同步轮 15齿 D孔8 宽10 | 节圆 Φ14.32 | 已确认 |
| 大同步带轮 | HTD3M 45 齿，孔 12 带 4 mm 键槽，带挡边，带宽 10 | 1 / 4 | 35 | 样品 | 孔 Φ12 H7 + 键槽 4（扭矩 20 N·m，顶丝扛不住，一定要键槽） | 3M 同步轮 45齿 内孔12 键槽 | 节圆 Φ42.97 | 已确认 |
| 同步带 | HTD3M 闭口带，宽 9，周长 213（71 齿） | 2 / 6 | 8 | 样品 | 买不到 213 就 210 或 216，侧板长孔能调 ±2 | HTD 3M 213 同步带 宽9 | 中心距 60 | 已确认 |
| 髋轴承 | 6001-2RS（12 × 28 × 8） | 2 / 8 | 4 | 样品 | 双面胶封 | 6001-2RS 轴承 | 12 × 28 × 8 | 已确认 |
| 轮轴轴承 | 6801-2RS（12 × 21 × 5） | 2 / 10 | 4 | 样品 | 双面胶封；多买 2 个备用 | 6801-2RS 轴承 12x21x5 | 12 × 21 × 5 | 已确认 |
| 台阶测距 | Pololu VL53L1X 测距板（3415） | 1 / 4 | 70 | 样品 | 原装 Pololu | Pololu VL53L1X 3415 | 12.7 × 17.78，2 × Φ2.18 孔距 12.7（官方图） | 已确认 |
| 磁编码器 | Adafruit AS5600 磁编码器板（6357）+ Φ6 × 2.5 径向充磁磁铁 | 1 / 4 | 60 | 样品 | 原装 Adafruit；磁铁要“径向充磁” | Adafruit AS5600 6357 | 25.4 × 17.78，4 × M2.5（官方 .brd） | 已确认 |
| I2C 分路器 | Adafruit TCA9548A（2717） | 1 / 1 | 50 | 样品 | 原装 Adafruit | Adafruit TCA9548A 2717 | 17.78 × 30.48，2 × M2.5（官方 .brd） | 已确认 |
| 髋电机驱动 | BTS7960（IBT-2）43A 单路 H 桥，带电流检测 | 1 / 4 | 30 | 样品 | ≥7A 持续；带电流检测输出（IS） | BTS7960 电机驱动 模块 43A | 约 50 × 50 × 40（含散热片） | 到货实测 |
| 底盘主控 | ESP32-S3-DevKitC-1 N16R8 | 1 / 1 | 50 | 样品 | — | ESP32-S3-DevKitC-1 N16R8 | 约 63 × 25.5（没有安装孔，扎带固定） | 已确认 |
| CAN 收发小板 | Adafruit CAN Pal（TJA1051，5708） | 1 / 1 | 50 | 样品 | 原装 Adafruit；3.3V 逻辑 | Adafruit CAN Pal 5708 | 20.32 × 20.32，2 × M2.5（官方 .brd） | 已确认 |
| USB 转 RS485（调试用） | USB 转 RS485 模块（CH340 / FT232 都行） | 1 / 1 | 15 | 样品 | — | USB转RS485 模块 | — | 已确认 |
| 机身小件 | 热熔铜螺母 M3 ×40、M4 ×40；M5×12 沉头 ×8（侧挂板）、M3×10 ×8（保险杠 / 格栅）、M4×12 沉头 ×8（滑撬）、M3×8 沉头 ×8（编码器支架）；M2 / M2.5 / M3 尼龙柱套装；3M VHB 双面胶 1 卷（外壳贴铝板）；扎带 | 1 / 1 | 80 | 样品 | — | — | — | 已确认 |

### 电源

| 名称 | 规格 / 型号 | 样品 / 总数 | 单价 | 批次 | 硬指标 | 搜索关键词 | 尺寸与孔位 | 状态 |
|---|---|---|---|---|---|---|---|---|
| 电池 | 6S2P 21700 锂电组定做（三星 50E / Molicel P42A 品牌电芯）+ 30A 均衡保护板 + 25.2V 充电器 | 1 / 1 | 700 | 样品 | 22.2V 10Ah 约 216 Wh；持续放电 ≥30A；电芯平放沿一个方向，6 列 × 2 层；XT60 头 | 6S2P 21700 电池组 定做 22.2V 10Ah | 外形 ≤ 75 × 135 × 47（不含保护板；保护板约 60 × 40 × 8 另外贴在顶上） | 按这个尺寸定做 |
| 电池监测 | INA226 模块（带分流电阻，量程 ≥20A） | 1 / 1 | 15 | 样品 | — | INA226 电流电压 模块 | 约 25 × 20 | 到货实测 |
| 5V 5A 降压 | Pololu D36V50F5（5V 5.5A） | 1 / 1 | 150 | 样品 | 输入 ≥30V；5V ≥5A（树莓派 5 要 5A） | Pololu D36V50F5 | 25.4 × 25.4 × 9.5，3 个 M2 孔 | 已确认 |
| 5V 3A 降压 | Pololu D36V28F5（5V 3.2A） | 1 / 1 | 90 | 样品 | — | Pololu D36V28F5 | 17.8 × 22.9 | 已确认 |
| 12V 降压 | 24V 转 12V 3A 降压模块 | 1 / 1 | 15 | 样品 | — | 24V转12V 3A 降压模块 | 到货实测 | 到货实测 |
| 总开关继电器 | 24V 40A 汽车继电器 ×2（总电源一个、电机电源一个）+ 座 | 2 / 2 | 20 | 样品 | 触点 ≥40A | 24V 40A 继电器 带座 | — | 到货实测 |
| 急停按钮 | 施耐德 XB2BS542C（Φ40 红蘑菇头，旋转复位，1 常闭）+ ZB2BE101C 常开触点 1 个 | 1 / 1 | 90 | 样品 | — | 施耐德 XB2BS542C 急停 + ZB2BE101C | 开孔 Φ22.5，面板后 ≤ 66.5（官方图纸 ref/estop/） | 已确认 |
| 总开关 | 16 mm 金属平头自锁按钮带环形灯，24V 灯（GQ16F 系列，自锁、环形灯） | 1 / 1 | 25 | 样品 | — | 16mm 金属按钮 自锁 环形灯 24V 平头 | 开孔 Φ16.2，头 Φ18，螺母 19，面板后 ≤ 26（ref/switch/） | 已确认 |
| 充电口 | Amass XT60E1-F 面板母座（黑色，带两个固定孔）+ XT60 公头防尘帽 | 1 / 1 | 12 | 样品 | — | Amass XT60E1-F 黑色 面板座 + XT60 防尘帽 | 27.1 × 12.1 × 16.7（ref/xt60/），固定孔距 20.5 到货用卡尺核对 | 已确认 |
| 保险丝盒 | 6 路刀片保险丝盒 + 保险丝（30A×1、10A×2、5A×6、3A×2） | 1 / 1 | 35 | 样品 | — | 6路 刀片保险丝盒 | — | 到货实测 |
| 接头和线 | XT60（公母 5 对）、XT30（10 对）、14/18/22 AWG 硅胶线、CAN 双绞线、GH1.25 / JST 端子 | 1 / 1 | 120 | 样品 | — | XT60 XT30 硅胶线 | — | — |

### 头部

| 名称 | 规格 / 型号 | 样品 / 总数 | 单价 | 批次 | 硬指标 | 搜索关键词 | 尺寸与孔位 | 状态 |
|---|---|---|---|---|---|---|---|---|
| 屏幕板 | 微雪 ESP32-S3-Touch-LCD-4.3B（800×480，触摸） | 1 / 1 | 260 | 样品 | — | 微雪 ESP32-S3-Touch-LCD-4.3B | 112.4 × 75.1（官方）；PCB 4 个 M2 孔：相距 92 / 低 50 | 已确认 |
| 头部传感器主控 | 乐鑫官方 ESP32-S3-DevKitC-1-N16R8 | 1 / 1 | 70 | 样品 | 买乐鑫官方版（有官方尺寸图），不要杂牌 | 乐鑫 ESP32-S3-DevKitC-1-N16R8 官方 | 约 63 × 25.4，以乐鑫官方图为准 | 设计时查官方图 |
| 俯仰舵机 | 飞特 STS3215-C018（12V 30 kg·cm，磁编码器）+ 总线舵机转接板 | 1 / 1 | 150 | 样品 | 能读回角度 | 飞特 STS3215 12V 舵机 | 45.22 × 24.72 × 35；舵盘 Φ19.2，4 × M2 在 Φ14 圆上 | 已确认 |
| 激光雷达 | 乐动 LD19（DTOF，12 m，带 USB 转接板） | 1 / 1 | 280 | 样品 | — | LD19 激光雷达 | 3 个 Φ2.5 孔：前两个相距 46.8，后一个居中，前后 31.92；总高 34.8，扫描面离底 27 | 已确认 |
| USB 集线器 | 4 口 USB 2.0 集线器小板（带外部 5V 供电） | 1 / 1 | 20 | 样品 | 外部供电 | USB2.0 HUB 小板 4口 外部供电 | — | 到货实测 |
| 功放 | Adafruit MAX98357A I2S 功放板（3006） | 1 / 1 | 50 | 样品 | 原装 Adafruit | Adafruit MAX98357A 3006 | 官方有尺寸图 | 设计时查官方图 |
| 喇叭 | Φ28 小喇叭 8Ω 1W | 1 / 1 | 5 | 样品 | 直径 28 | 28mm 喇叭 8欧 1W | Φ28 | 到货实测 |
| 多点测距 | SparkFun Qwiic Mini ToF Imager VL53L5CX（SEN-19013） | 1 / 1 | 180 | 样品 | 原装 SparkFun | SparkFun VL53L5CX Mini 19013 | 官方有尺寸图 | 设计时查官方图 |
| 毫米波雷达 | 海凌科 HLK-LD2410B（原厂） | 1 / 1 | 20 | 样品 | 原厂海凌科 | 海凌科 LD2410B | 约 35 × 7，以原厂规格书为准 | 设计时查官方图 |
| 热成像 | Adafruit MLX90640 24×32 热成像 110°（4469） | 1 / 1 | 400 | 样品 | 要 110° 那款（4469），不是 55°（4407） | Adafruit MLX90640 110度 4469 | 25.8 × 17.8 × 10.5（官方） | 设计时查官方图 |
| 红外收发 | 5 mm 940 nm 红外发射管 ×2 + VS1838B 红外接收头 ×2 | 1 / 1 | 5 | 样品 | 940 nm | 940nm 红外发射管 5mm VS1838B | 标准元件 | 已确认 |
| 光线传感器 | GY-302 BH1750 模块 | 1 / 1 | 8 | 样品 | — | GY-302 BH1750 | 通用 18.5 × 13.9 | 到货实测 |
| 温湿度 | Adafruit SHT40 温湿度板（4885） | 1 / 1 | 50 | 样品 | 原装 Adafruit | Adafruit SHT40 4885 | 官方有尺寸图 | 设计时查官方图 |
| 麦克风 | INMP441 I2S 全向麦克风模块（圆板 Φ13.8） | 2 / 2 | 10 | 样品 | 圆形 Φ13.8 那款 | INMP441 全向麦克风模块 圆形 | Φ13.8，底部进声 | 已确认 |
| 摄像头 | OV5693 500 万像素 USB 排线摄像头（自动对焦，排线 55 mm） | 1 / 1 | 80 | 样品 | 排线选 55 mm | 500万像素USB排线摄像头模组 OV5693 自动对焦 | 镜头模组 8 × 8.5 × 5.3；主板 15 × 30，孔距 11 × 26（卖家图纸 WN-L2112） | 已确认 |
| 隐私灯 | 3 mm 红色 LED | 2 / 2 | 1 | 样品 | — | 3mm 红色 LED 直插 | Φ3 | 已确认 |
| 烟黑亚克力窗 | 3 mm 烟黑亚克力，激光切 117.6 × 49.6，四角 R1 | 1 / 1 | 10 | 样品 | — | 烟黑亚克力 激光切割 定做 3mm | 117.6 × 49.6 × 3 | 已确认 |
| USB-C 90° 侧弯线 | USB-C 公（90° 侧弯）转 USB-A 公，0.3 m | 1 / 1 | 15 | 样品 | — | USB-C 90度 侧弯 数据线 短 | — | 已确认 |
| 头部小件 | 热熔铜螺母 M2 ×20、M5 ×10；螺丝：M2×6 盘头 ×13、M2×6 自攻 ×4、M2×8 自攻 ×3、M3×8 ×4、M3×6 ×4、M3×20 沉头 ×4、M4×20 沉头 ×4、M5×20 沉头 ×8、M5×10 沉头 ×2、M2×6 自攻再 ×4（摄像头主板）、M2.5×6 自攻 ×6；钕磁铁 Φ6×3 ×4；1 mm EVA 泡棉 1 张；小扎带 1 包 | 1 / 1 | 60 | 样品 | — | — | — | 已确认 |

### 大脑

| 名称 | 规格 / 型号 | 样品 / 总数 | 单价 | 批次 | 硬指标 | 搜索关键词 | 尺寸与孔位 | 状态 |
|---|---|---|---|---|---|---|---|---|
| 树莓派 5 | Raspberry Pi 5 + 官方主动散热 | 0 / 1 | — | 已有 | — | — | 85 × 56；4 × M2.5，58 × 49 | 已确认 |
| 深度相机 | 奥比中光 Gemini 2 / RealSense D435i 一类 | 0 / 1 | 1500 | 以后 | — | — | 约 90 × 25 × 25 | — |

### 结构

| 名称 | 规格 / 型号 | 样品 / 总数 | 单价 | 批次 | 硬指标 | 搜索关键词 | 尺寸与孔位 | 状态 |
|---|---|---|---|---|---|---|---|---|
| 铝板激光切割 | 图纸 A01–A07（6061-T6，4 / 3 / 6 mm）+ D31 髋支座（7 mm） | 1 / 1 | 520 | 第二批 | 按 DXF 加工；沉头孔、螺纹孔看图纸；外露件深灰阳极 | 铝板 激光切割 加工 6061 | 见图纸 | — |
| 车削件 | 图纸 B01、B02、B04–B08（髋轴承座、轴毂、髋轴、隔圈、轮轴承座、带法兰轮轴） | 1 / 1 | 550 | 第二批 | 按 STEP + 图纸；轴承孔 H7、轴承位 k6 | CNC 车削 加工 来图 | 见图纸 | — |
| 铝管 | 底盘边梁：6063 铝方管 26×10×1.5，长 420 ×2；底盘横管：Φ16×1.5，长 240 ×2 + 银色塑料端盖 ×4 | 1 / 1 | 60 | 第二批 | 深灰阳极 | 铝方管 26x10 铝管 16x1.5 切割 | 见图纸切割表 | 已确认 |
| 2020 铝型材 | 欧标 2020，切割：232 ×4、240 ×2、184 ×2，横梁两端攻 M5 | 1 / 1 | 50 | 样品 | — | 2020 欧标 铝型材 切割 攻丝 | — | 已确认 |
| 2020 配件 | 角码 ×12、M5 T 型螺母 ×50、M5 螺丝 | 1 / 1 | 40 | 样品 | — | 2020 角码 T型螺母 M5 | — | 已确认 |
| 六角铝柱 | M4 × 16 ×16、M3 × 65 ×8 | 1 / 1 | 25 | 样品 | — | 六角铝柱 M4 M3 | — | 已确认 |
| 螺丝套装 | 不锈钢内六角 / 沉头 M2.5、M3、M4、M5，防松螺母，平垫、弹垫 | 1 / 1 | 60 | 样品 | — | 不锈钢 内六角 螺丝 套装 | — | — |
| 平键、挡圈 | 平键 4 × 4 × 12 ×14、轴用挡圈 12（GB894）×12 | 1 / 1 | 20 | 样品 | — | 平键 4x4x12 轴用挡圈 12 | — | 已确认 |
| 热熔螺母 | M2、M2.5、M3、M4 铜热熔螺母各 50，M5 ×20 | 1 / 1 | 35 | 样品 | — | 热熔螺母 铜 M3 | — | 已确认 |
| 打印耗材 | ASA 浅灰 2 kg、ASA 深灰 1 kg、PETG 黑 1 kg、PA12-CF 0.5 kg、TPU 95A 0.5 kg | 1 / 1 | 450 | 第二批 | — | — | — | — |
| 电子托板 | 3 mm 黑色亚克力激光切割（图纸 C01） | 1 / 1 | 30 | 第二批 | — | 亚克力 激光切割 来图 | — | — |

## 标准件 / 关键件清单

轴承、轴、挡圈、平键、磁铁、螺丝这些不贵，但缺一个就装不起来。数量已经算上备用。

| 类别 | 名称 | 规格 | 数量 | 装在哪里 / 做什么 | 备注 |
|---|---|---|---|---|---|
| 轴承 | 髋轴承 | 6001-2RS（12×28×8） | 8 | B01 髋轴承座，每个髋 2 个背靠背 | 外圈 H7 压入；内圈 k6 |
| 轴承 | 轮轴轴承 | 6801-2RS（12×21×5） | 8 | B07 轮轴承座，每个轮子 2 个 | 轮子只靠内侧一边支撑，重量全靠这两个；另备 2 个 |
| 轴承 | 俯仰铜套 | 黄铜 Φ10 外 / Φ8.1 内 × 18 | 1 | 方窗耳里，托屏幕模块右边的 Φ8 轴销 | 头很轻，铜套够了 |
| 轴 | 髋轴 | B04，45# 钢 Φ12 | 4 | 穿过髋轴承、大带轮、轴毂 | 车削件 |
| 轴 | 轮轴（带法兰） | B08，45# 钢 Φ12 + Φ30 法兰 | 4 | 法兰拧电机输出盘，轴穿过两个 6801 进麦轮 | 车削件；轴端按麦轮轮毂做 |
| 轴 | 俯仰轴销 | Φ8 / Φ5 × 35 不锈钢空心管（Φ8×1.5 精密管切 35） | 1 | 屏幕模块右边（-Y）→ 铜套 | 压进 H01；右耳传感器的线从管子里穿进头 |
| 轴 | 隔圈 | B05 ×4、B06 ×4（Φ16 / Φ12.2） | 8 | 髋轴上：带轮 ↔ 轴承、轴承 ↔ 轴毂 | 车削件 |
| 定位 | 平键 | 4×4×12 | 14 | 髋轴：大带轮 4 + 轴毂 4；轮轴：麦轮 4；另备 2 | — |
| 定位 | 轴用挡圈 | GB894 12 | 12 | 髋轴 4、轮轴 4；另备 4 | — |
| 传感 | 径向充磁磁铁 | Φ6 × 2.5 | 6 | 髋轴端头，AS5600 读腿角度 | AB 胶粘；另备 2 |
| 紧固 | 沉头螺丝 M5 | 不锈钢 10.9 级，长 10 / 12 / 16 各 30 | 90 | 外露的 Φ10 螺栓头：髋支座、侧挂板、耳朵、屏幕模块、腿外板 | 全机外露螺栓统一 M5 沉头（头 Φ10） |
| 紧固 | 内六角 M4 | 长 10 / 16 / 20 / 30 | 100 | 髋轴承座、轴毂法兰、轮轴承座、电机护罩、蜗轮箱 | — |
| 紧固 | 内六角 / 沉头 M3 | 长 6 / 8 / 10 / 12 | 120 | 电机背面（护罩）、轮轴法兰（6 颗 × 4）、托板、外壳拼接 | — |
| 紧固 | M2.5 / M2 | 长 6 / 8 | 40 | 树莓派、雷达（3 颗）、屏板压条、小模块 | — |
| 紧固 | 热熔螺母 | M2 / M2.5 / M3 / M4 各 50、M5 ×20 | 220 | 所有打印件的螺丝孔 | 铜，滚花 |
| 传感 | 钕磁铁 | Φ6 × 3（N52） | 4 | 屏幕模块顶盖前端吸住主壳 | — |
| 紧固 | 六角铝柱 | M4×16 ×16、M3×65 ×8 | 24 | 蜗轮箱支柱、电子托板 | — |
| 紧固 | 2020 配件 | 角码 ×12、M5 T 型螺母 ×50 | 62 | 机身横梁、货斗导轨 | — |

## 尺寸资料来源

- 乐动 LD19 规格书 V2.5（安装孔、扫描面高度）：https://botland.com.pl/img/art/inne/21991_Karta%20katalogowa.pdf
- 微雪 ESP32-S3-Touch-LCD-4.3B（112.4 × 75.1、接口、引脚占用）：https://www.waveshare.com/wiki/ESP32-S3-Touch-LCD-4.3B
- SteadyWin GIM4310-10（Φ53 × 38、227 g）：https://openelab.com/products/steadywin-gim4310-10-precision-joint
- Nexus 152 mm 重载麦轮（宽 79、2.3 kg、孔 30）：https://www.vstone.co.jp/products/nexusrobot/download/nexus_14169.pdf
- EasyMech 152 mm 麦轮（宽 45、中心孔 22、分布圆 47.5）：https://stg.robu.in/?p=1971
- 5840 蜗轮电机外形（58 × 40、Φ8 × 15 D 轴）：https://www.robotshop.com/products/aslong-motor-5840-3650-24v-470rpm-high-torque-self-locking-worm-gear-motor
- Pololu D36V50F5（25.4 × 25.4 × 9.5）：https://www.pololu.com/product/4091
- 飞特 STS3215（45.2 × 24.7 × 35）：https://servodatabase.com/servo/feetech/sts3215
- AS5600 模块（23 × 23、Φ6 × 2.5 径向磁铁）：https://www.tinytronics.nl/shop/en/sensors/magnetic-field/as5600-magnetic-angle-sensor-encoder-module
