whois169/roboot007v/007a/out/eng_parts/127.stl

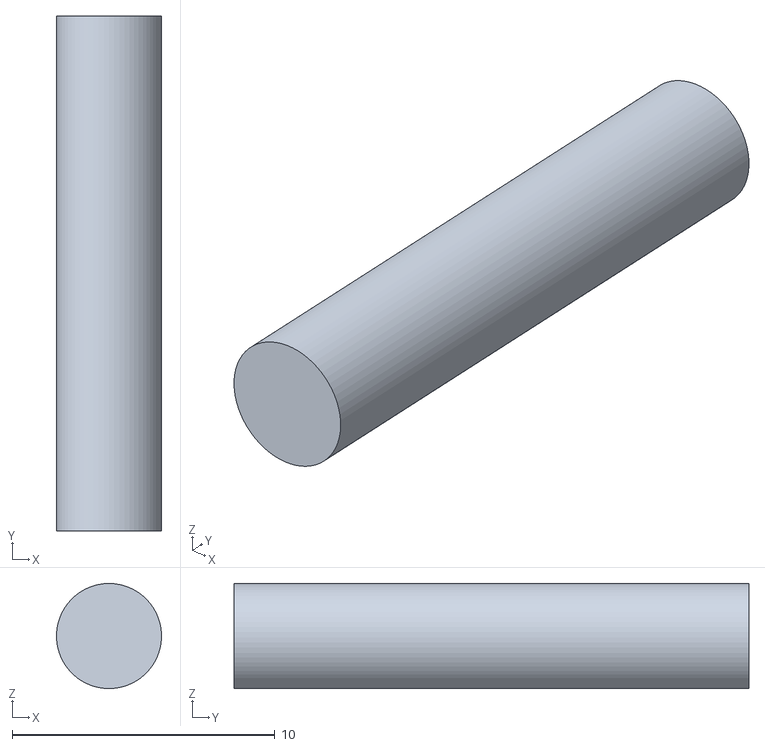
[picture p85: CAD file, 2026-10-31]
007a/out/eng_parts/127.stl
4.00 x 19.6 x 4.00
