whois169/roboot007v/007a/out/leg_parts/021.stl

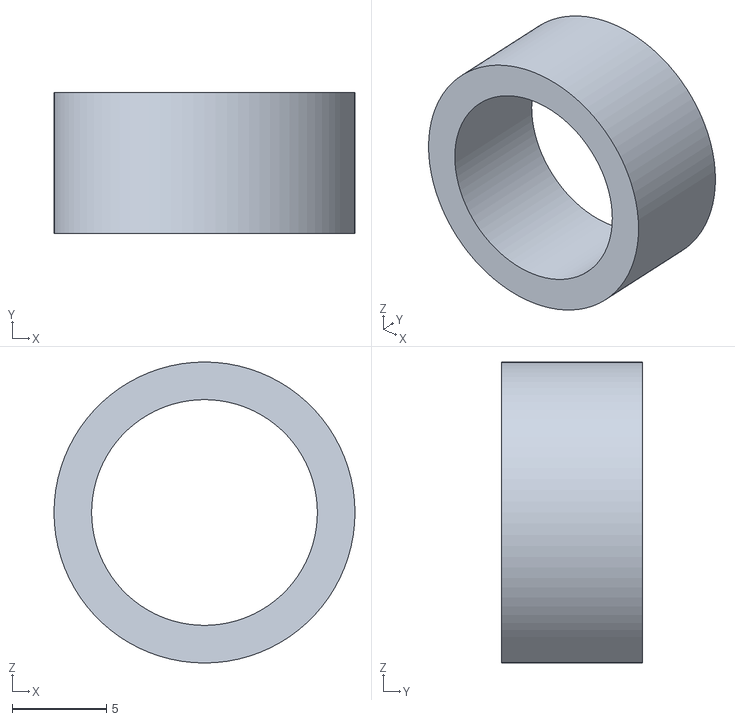
[picture p86: CAD file, 2026-10-31]
007a/out/leg_parts/021.stl
16.0 x 7.50 x 16.0
