whois169/roboot007v/007a/out/mfg/A03_A03侧梁左.step

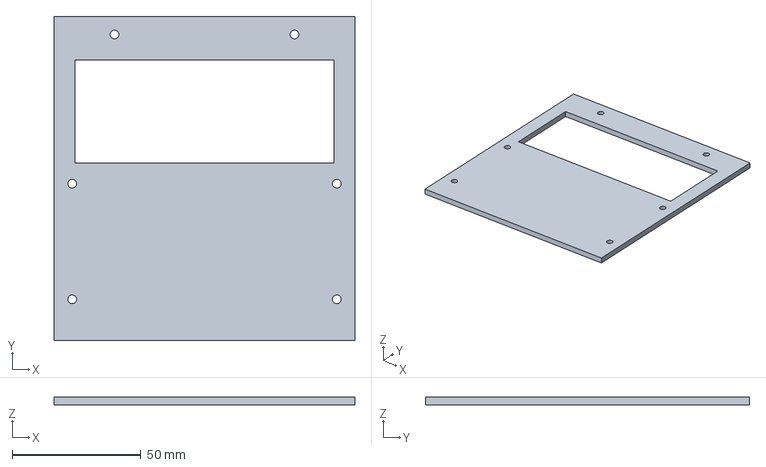
[picture p87: CAD file, 2026-10-31]
007a/out/mfg/A03_A03侧梁左.step
116.9 x 126.0 x 3.00 mm
