whois169/roboot007v/007a/out/print/S21_绕线环.stl

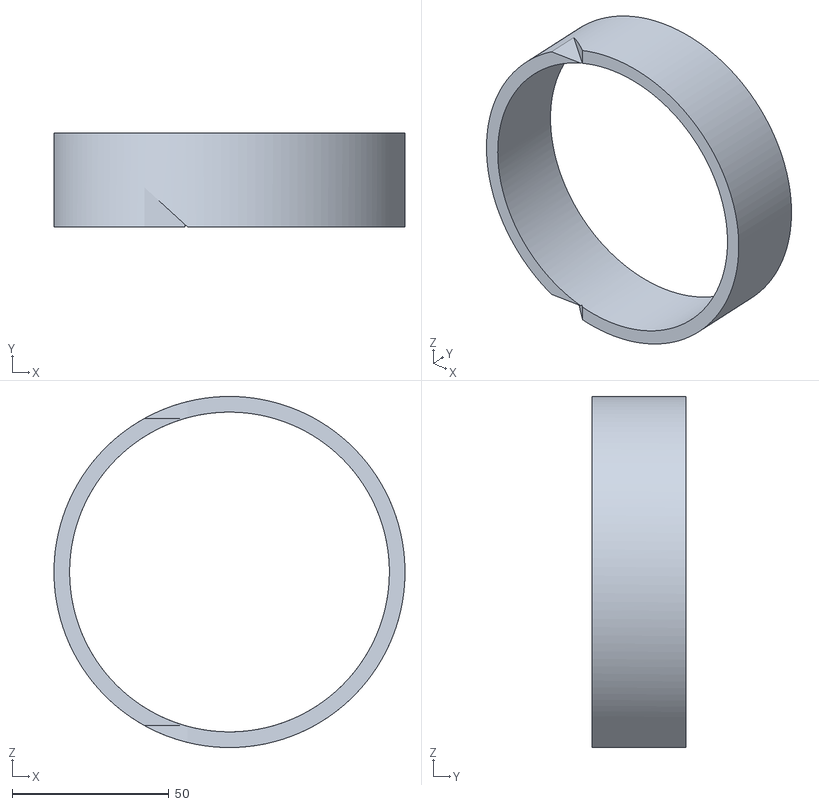
[picture p88: CAD file, 2026-10-31]
007a/out/print/S21_绕线环.stl
112.0 x 30.0 x 112.0
