whois169/roboot007v/007a/ref/adafruit/4469_MLX90640.step

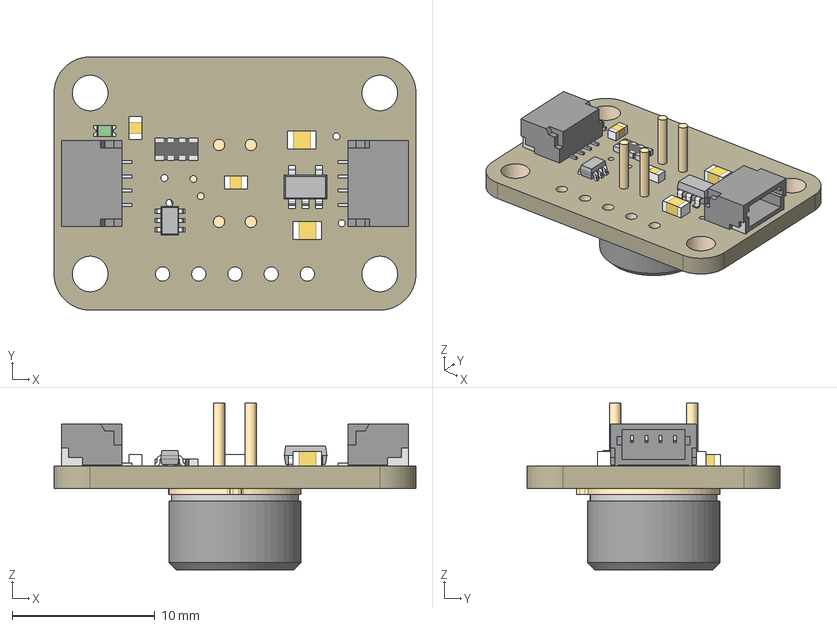
[picture p89: CAD file, 2026-10-30]
007a/ref/adafruit/4469_MLX90640.step
25.4 x 17.8 x 11.7 mm
Board
10uF x 2
AP2112K-3.3
10K x 2
4.7K
BSS138
STEMMA_I2C_QT x 2
GREEN
MLX90640
