whois169/roboot007v/007v/out/body_print/P14_侧挂板·右.step

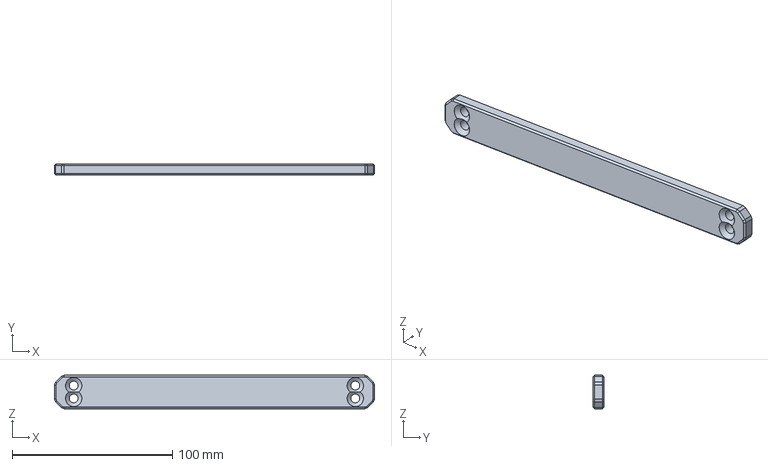
[picture p90: CAD file, 2026-10-23]
007v/out/body_print/P14_侧挂板·右.step
200.0 x 7.00 x 21.0 mm
