whois169/roboot007v/007v/ref/sts3215/STS3215_03a.step

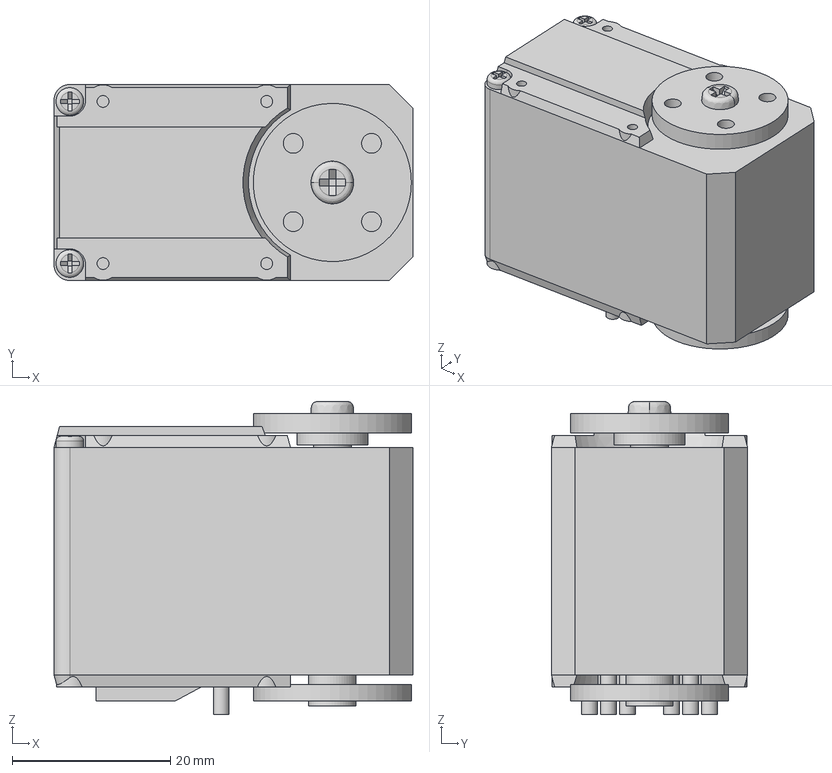
[picture p91: CAD file, 2026-10-22]
007v/ref/sts3215/STS3215_03a.step
45.4 x 24.8 x 39.6 mm
