whois169/roboot007v/007a/out/leg_parts/005.stl

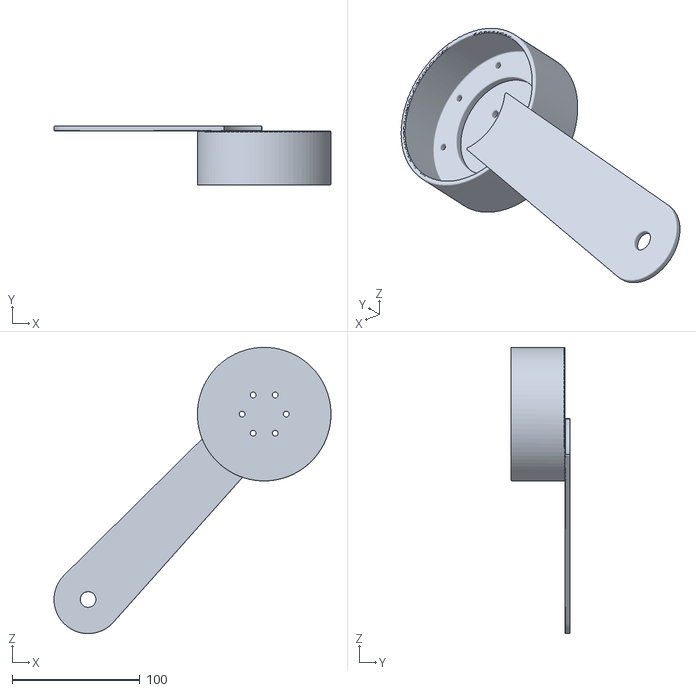
[picture p92: CAD file, 2026-10-31]
007a/out/leg_parts/005.stl
216.7 x 46.3 x 223.9
