whois169/roboot007v/007a/out/mfg/L03_髋座.step

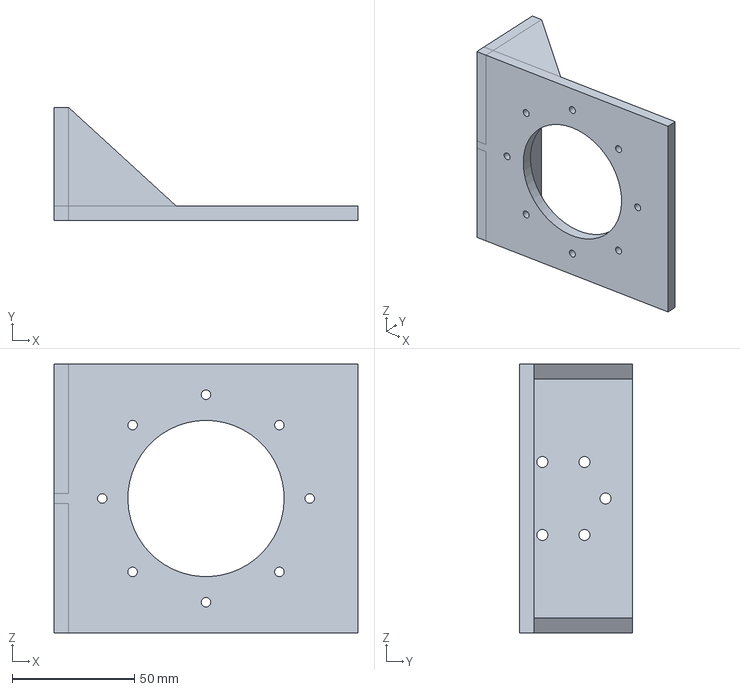
[picture p93: CAD file, 2026-10-31]
007a/out/mfg/L03_髋座.step
124.5 x 46.3 x 110.0 mm
