whois169/roboot007v/007a/out/print/S20_小腿.stl

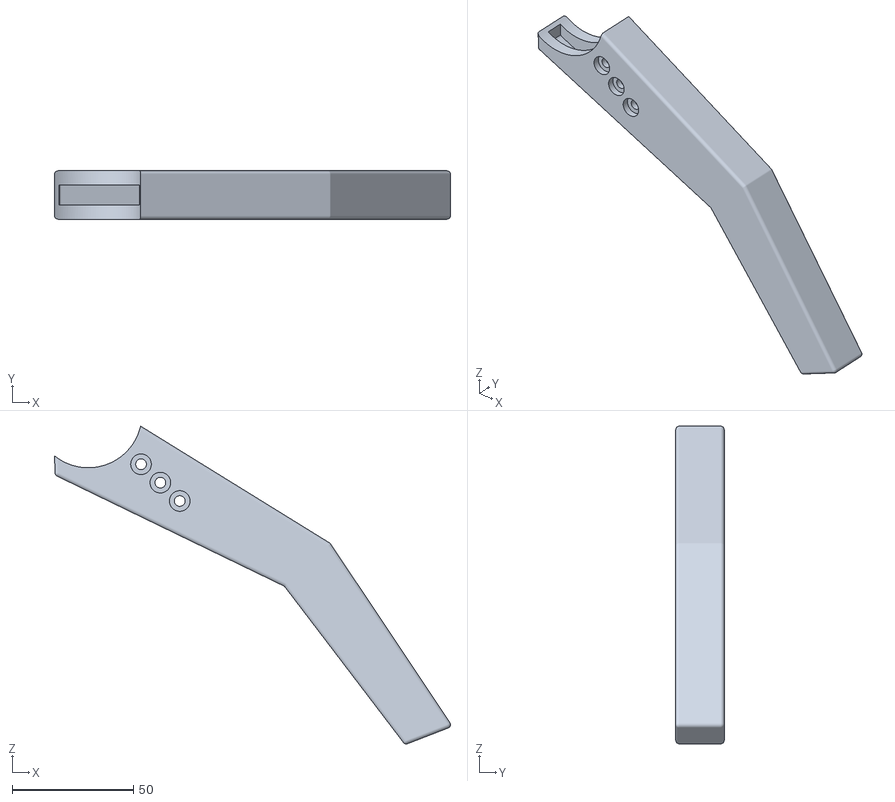
[picture p94: CAD file, 2026-10-31]
007a/out/print/S20_小腿.stl
163.2 x 20.0 x 131.0
