whois169/roboot007v/007a/ref/adafruit/3006_MAX98357.step

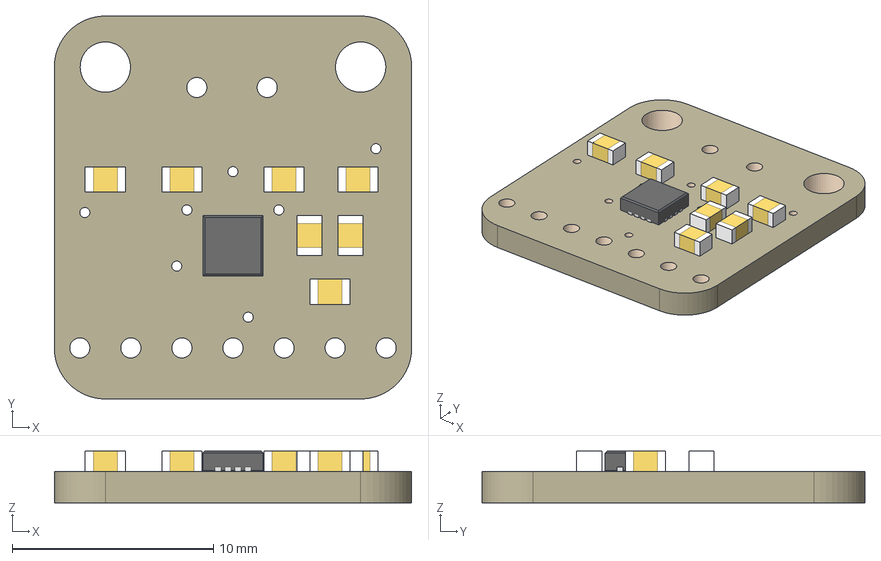
[picture p95: CAD file, 2026-10-30]
007a/ref/adafruit/3006_MAX98357.step
17.8 x 19.1 x 2.57 mm
Board
MAX98357A
220pF x 7
