whois169/roboot007v/007v/out/body_print/P09_上层甲板壳·左前.step

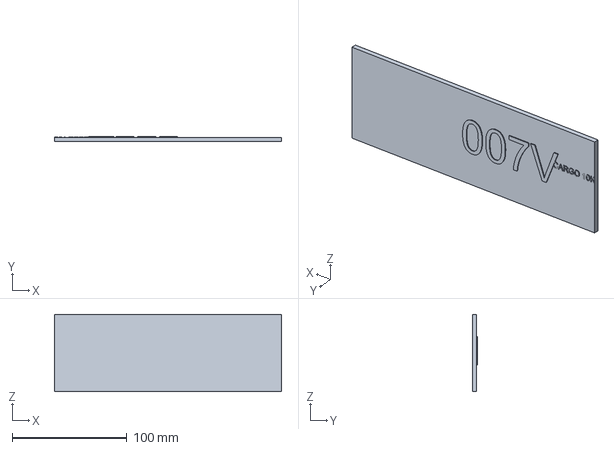
[picture p96: CAD file, 2026-10-23]
007v/out/body_print/P09_上层甲板壳·左前.step
198.0 x 4.10 x 67.5 mm
