whois169/roboot007v/007a/out/leg_parts/006.stl

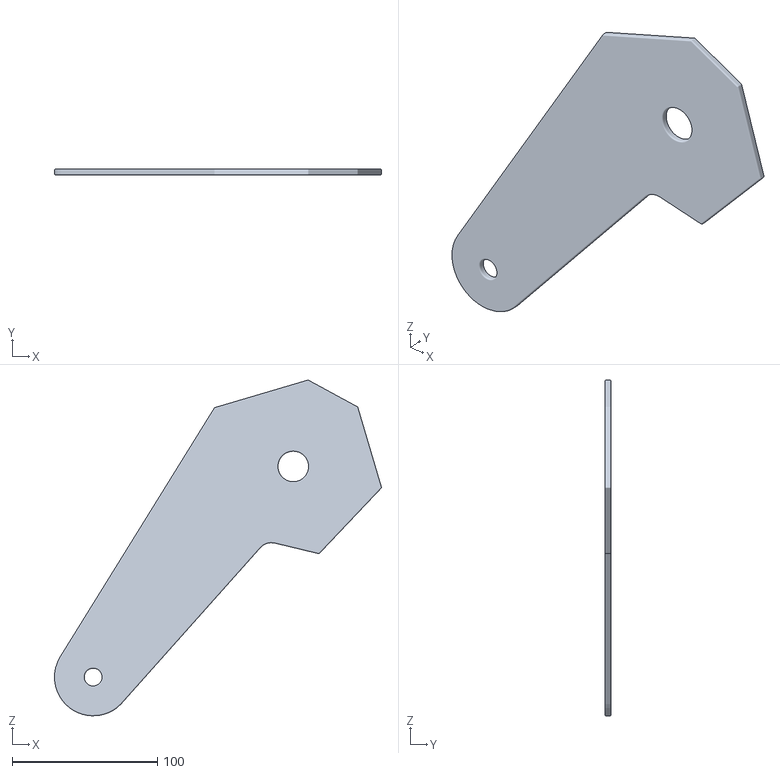
[picture p97: CAD file, 2026-10-31]
007a/out/leg_parts/006.stl
225.1 x 4.00 x 231.1
