whois169/roboot007v/007a/out/print/S19_大腿外层壳.stl

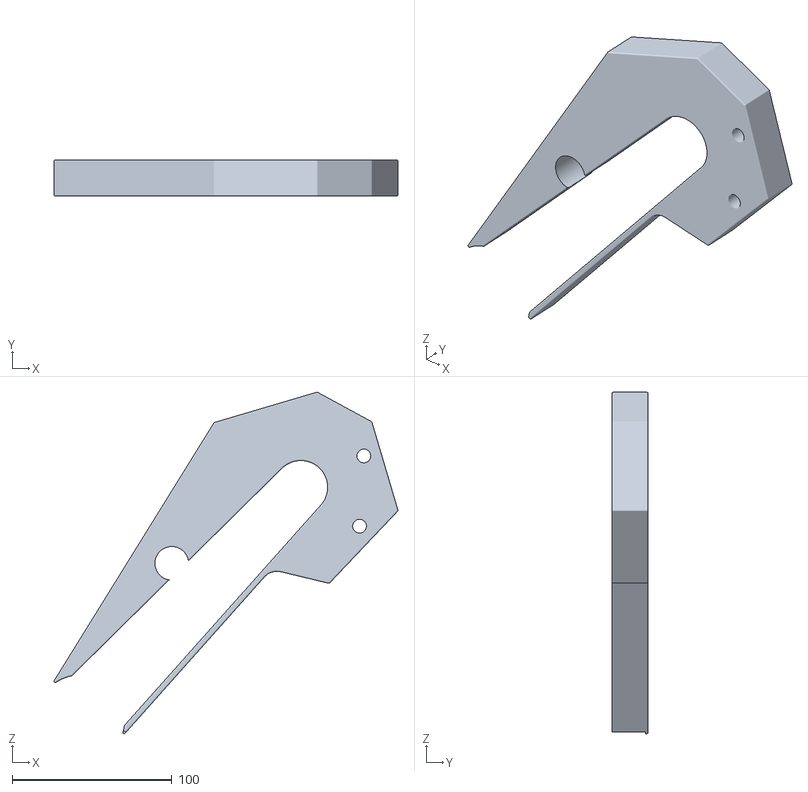
[picture p98: CAD file, 2026-10-31]
007a/out/print/S19_大腿外层壳.stl
215.0 x 22.6 x 213.5
