whois169/roboot007v/007v/out/body_print/L04_髋部大圆盖.step

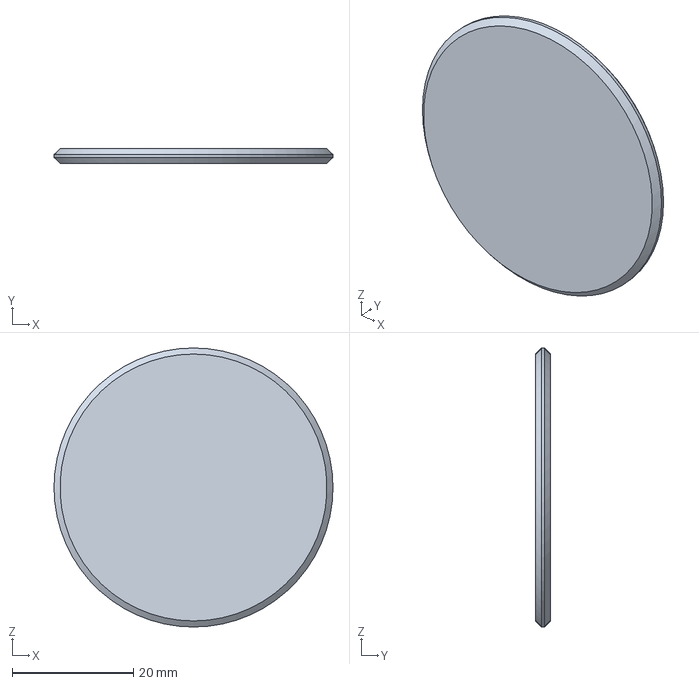
[picture p99: CAD file, 2026-10-23]
007v/out/body_print/L04_髋部大圆盖.step
46.0 x 2.50 x 46.0 mm
