whois169/roboot007v/007a/out/eng_parts/178.stl

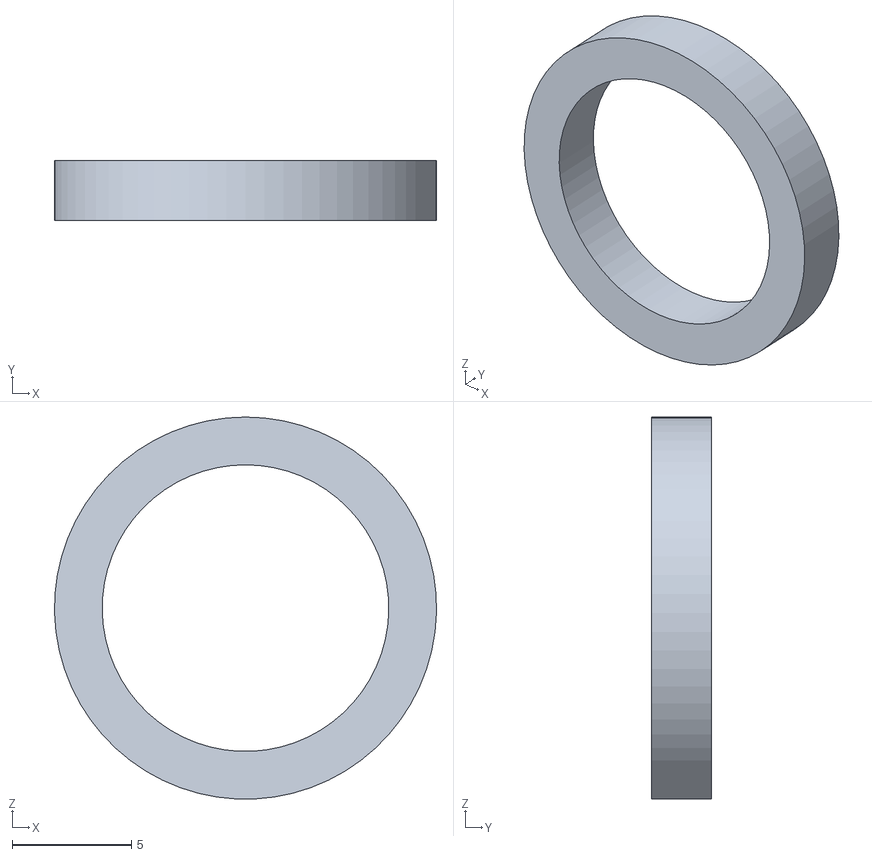
[picture p100: CAD file, 2026-10-31]
007a/out/eng_parts/178.stl
16.0 x 2.50 x 16.0
