whois169/roboot007v/007a/out/leg_parts/020.stl

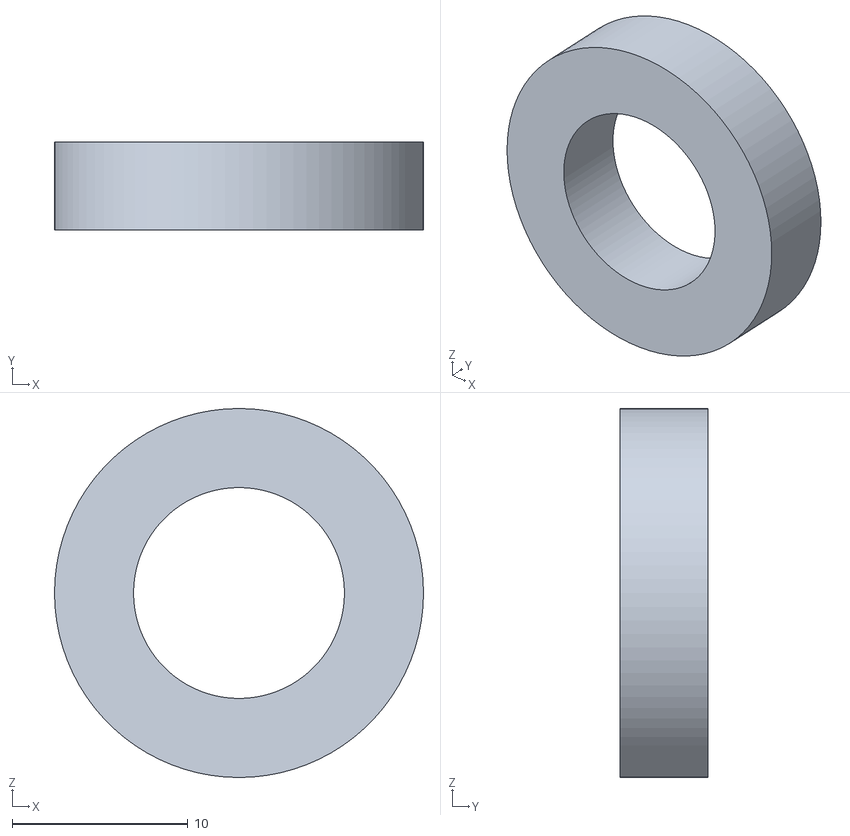
[picture p101: CAD file, 2026-10-31]
007a/out/leg_parts/020.stl
21.0 x 5.00 x 21.0
