whois169/roboot007v/007a/out/print/S12_前防撞杠.stl

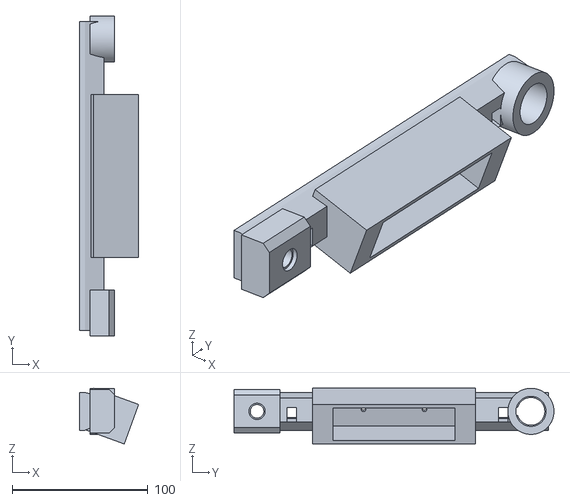
[picture p102: CAD file, 2026-10-31]
007a/out/print/S12_前防撞杠.stl
43.7 x 236.0 x 41.3
