whois169/roboot007v/007v/out/body_print/L03_摆臂外盖板.step

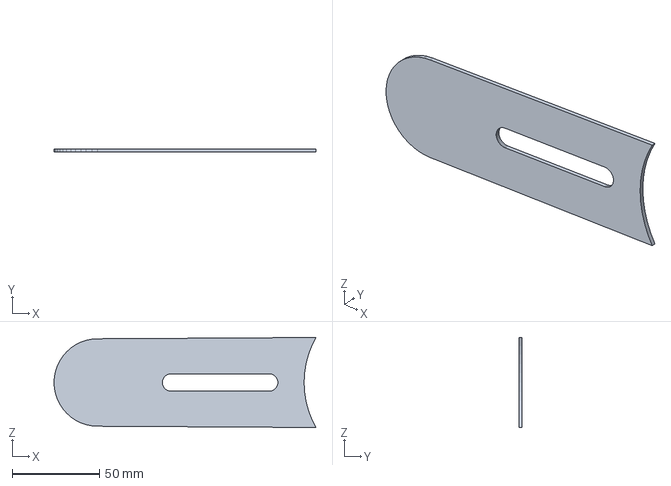
[picture p103: CAD file, 2026-10-23]
007v/out/body_print/L03_摆臂外盖板.step
149.8 x 2.00 x 51.5 mm
