whois169/roboot007v/007a/out/mfg/C01_电子托板.step

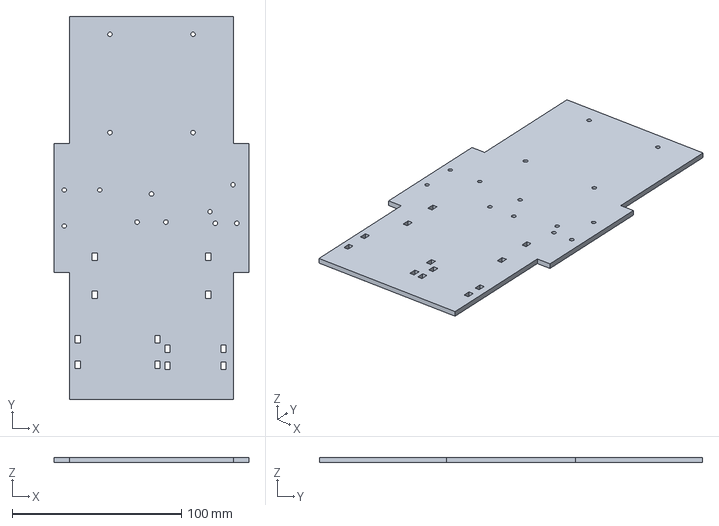
[picture p104: CAD file, 2026-10-31]
007a/out/mfg/C01_电子托板.step
114.9 x 226.0 x 3.00 mm
