whois169/roboot007v/007a/out/print/S16_探照灯压圈（打印）.stl

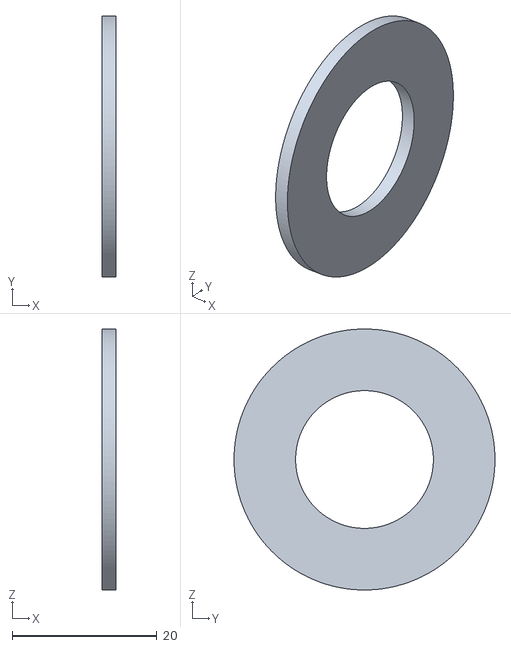
[picture p105: CAD file, 2026-10-31]
007a/out/print/S16_探照灯压圈（打印）.stl
2.00 x 36.0 x 36.0
