whois169/roboot007v/007a/out/print/S13_雷达护圈.stl

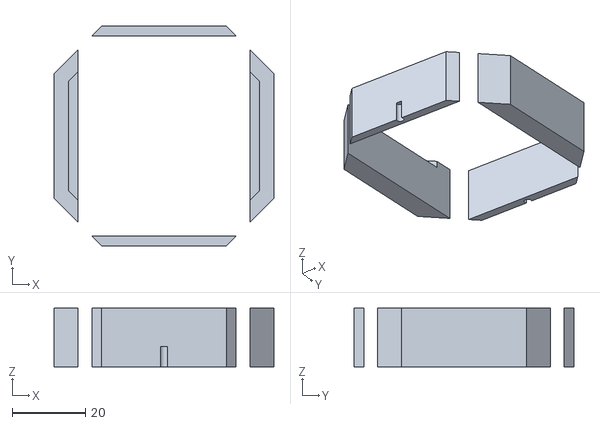
[picture p108: CAD file, 2026-10-31]
007a/out/print/S13_雷达护圈.stl
60.0 x 60.0 x 16.0
