whois169/roboot007v/007v/out/body_print/P06_下层外壳·右后.step

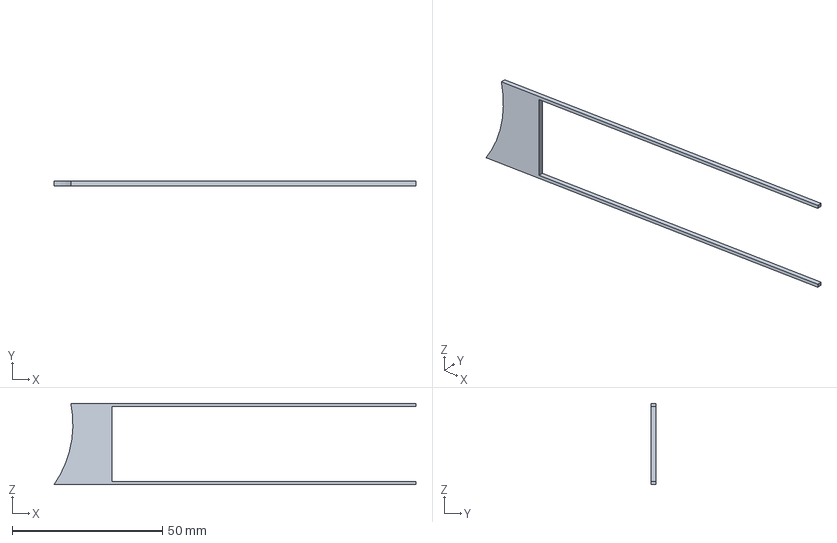
[picture p109: CAD file, 2026-10-23]
007v/out/body_print/P06_下层外壳·右后.step
120.3 x 1.50 x 27.0 mm
