whois169/roboot007v/007a/out/eng_parts/179.stl

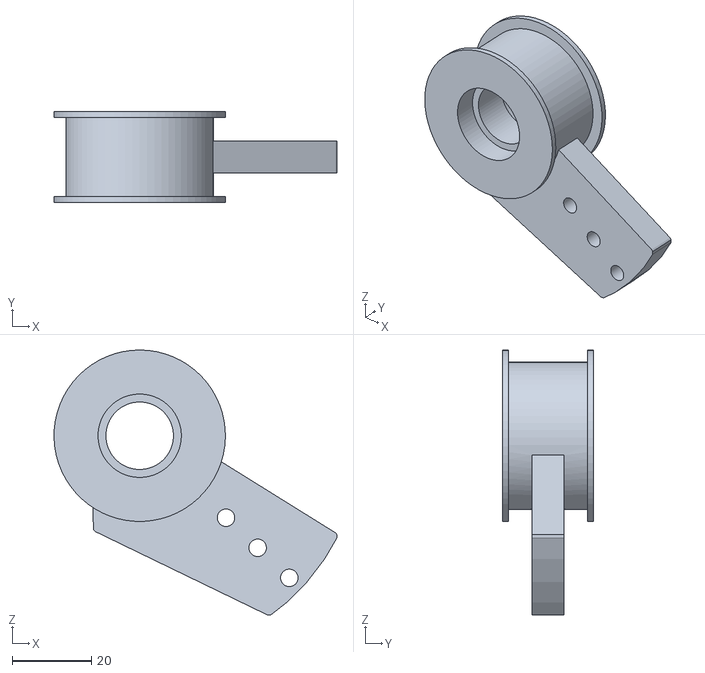
[picture p110: CAD file, 2026-10-31]
007a/out/eng_parts/179.stl
71.3 x 23.0 x 66.8
