whois169/roboot007v/007a/out/mfg/A01_A01底板.step

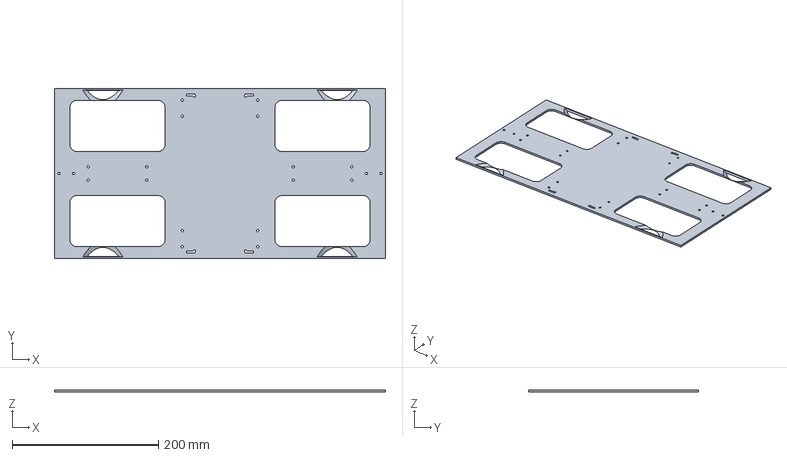
[picture p111: CAD file, 2026-10-31]
007a/out/mfg/A01_A01底板.step
452.0 x 232.0 x 3.00 mm
