whois169/roboot007v/007a/out/print/S25_膝盖帽外.stl

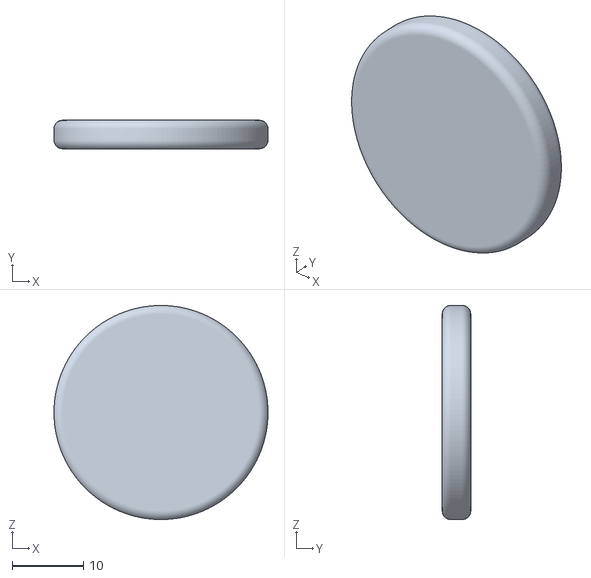
[picture p112: CAD file, 2026-10-31]
007a/out/print/S25_膝盖帽外.stl
30.0 x 4.00 x 30.0
