whois169/roboot007v/007v/out/body_print/P23_侧栏板·右.step

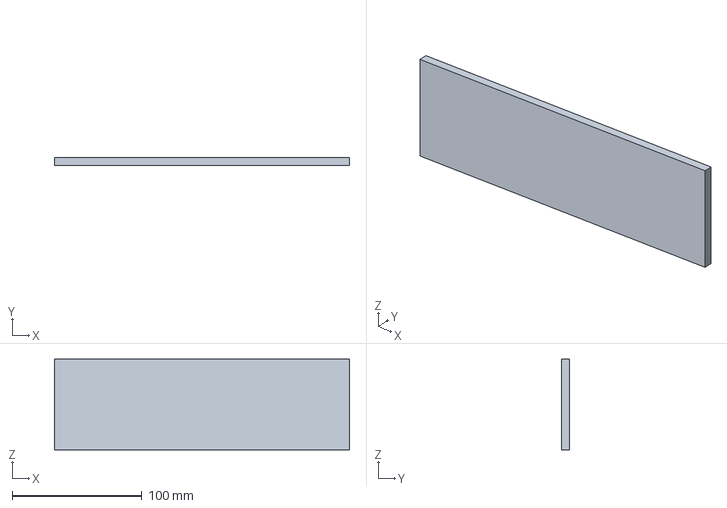
[picture p113: CAD file, 2026-10-23]
007v/out/body_print/P23_侧栏板·右.step
227.0 x 6.00 x 70.0 mm
