whois169/roboot007v/007a/out/mfg/A04_A04纵梁前左.step

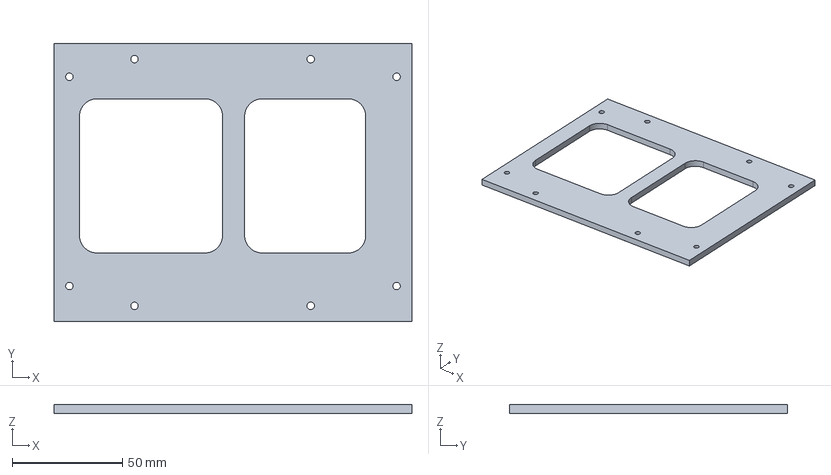
[picture p114: CAD file, 2026-10-31]
007a/out/mfg/A04_A04纵梁前左.step
162.6 x 126.0 x 4.00 mm
