whois169/roboot007v/007a/out/print/S11_侧装甲板-1.stl

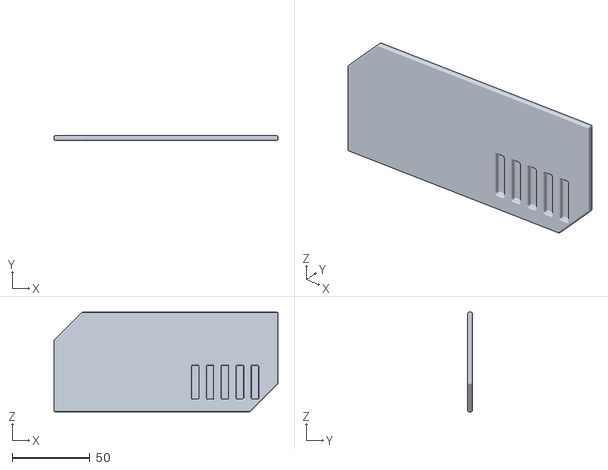
[picture p115: CAD file, 2026-10-31]
007a/out/print/S11_侧装甲板-1.stl
144.0 x 3.00 x 64.0
