whois169/roboot007v/007v/out/body_print/P18_货斗底板.step

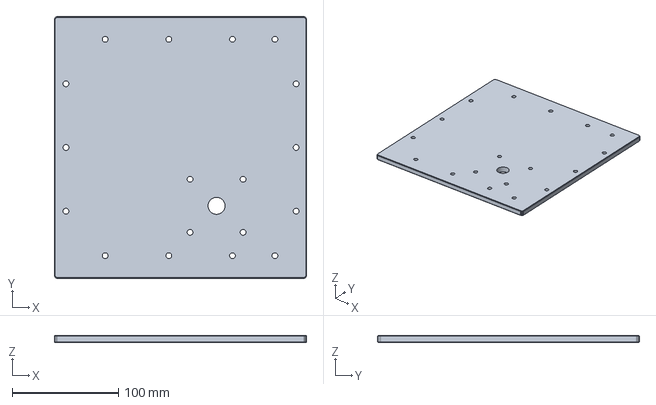
[picture p116: CAD file, 2026-10-23]
007v/out/body_print/P18_货斗底板.step
238.0 x 247.0 x 7.00 mm
