whois169/roboot007v/007a/out/mfg/H01_头支架左.step

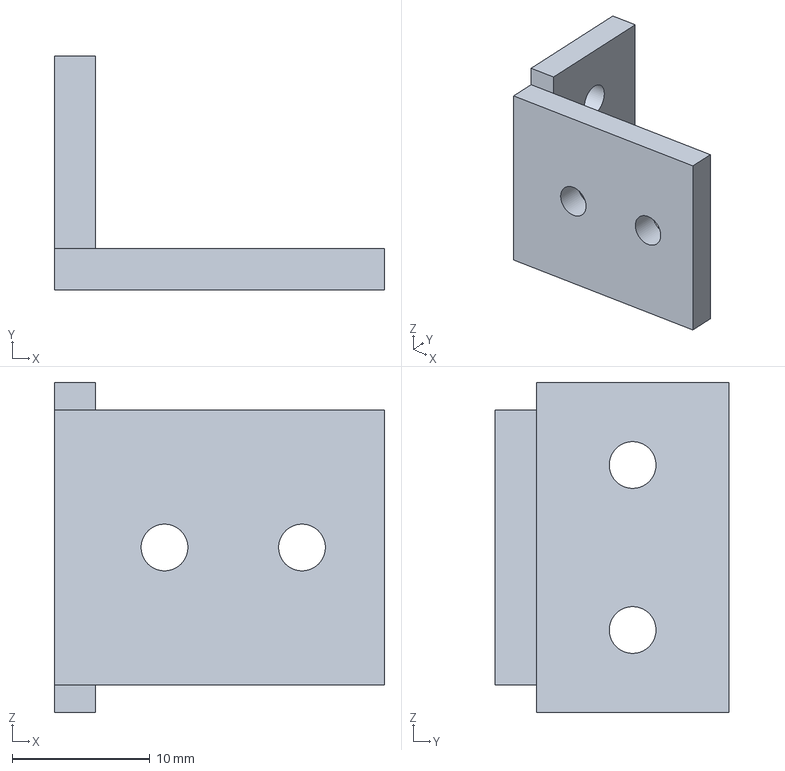
[picture p117: CAD file, 2026-10-31]
007a/out/mfg/H01_头支架左.step
24.0 x 17.0 x 24.0 mm
