whois169/roboot007v/007a/out/print/S02_上层甲板壳前右.stl

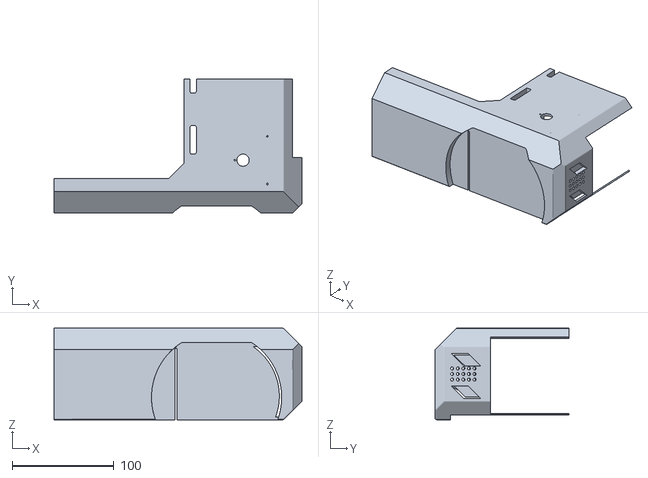
[picture p118: CAD file, 2026-10-31]
007a/out/print/S02_上层甲板壳前右.stl
243.9 x 131.9 x 90.0
