whois169/roboot007v/007v/out/body_print/P26_编码器支架（左右镜像各打 2）.step

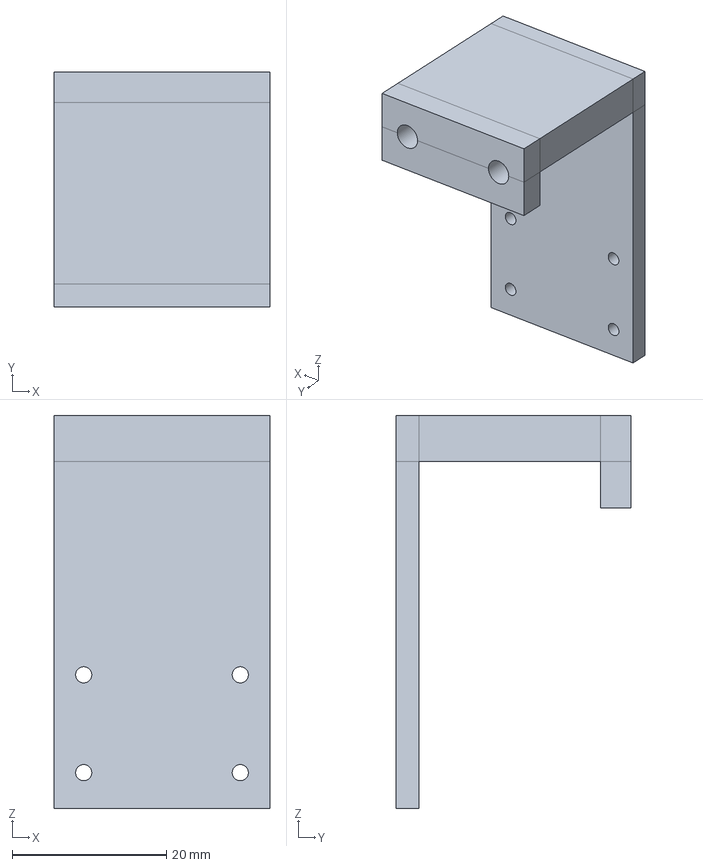
[picture p119: CAD file, 2026-10-23]
007v/out/body_print/P26_编码器支架（左右镜像各打 2）.step
28.0 x 30.5 x 51.0 mm
