whois169/roboot007v/007a/out/mfg/L04_转接盘和轴.step

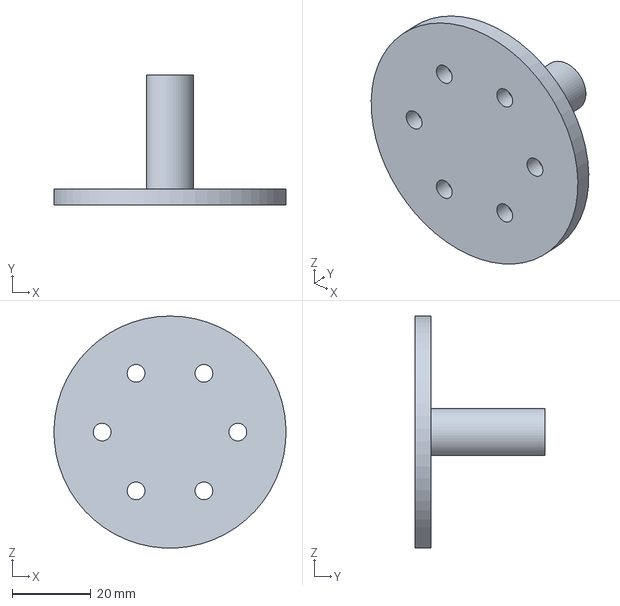
[picture p120: CAD file, 2026-10-31]
007a/out/mfg/L04_转接盘和轴.step
59.0 x 33.0 x 59.0 mm
