whois169/roboot007v/007v/out/body_print/P02_下层外壳·后.step

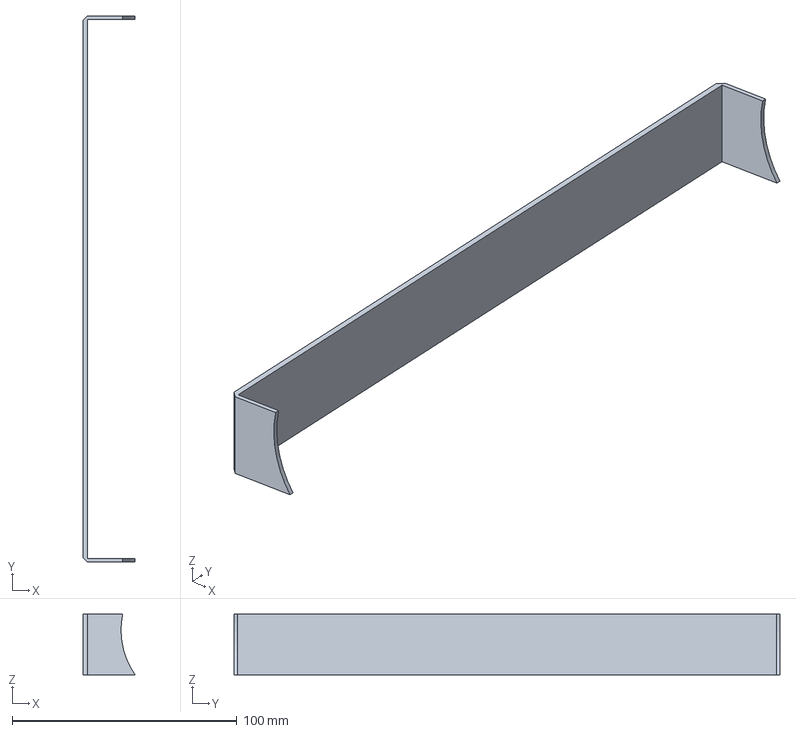
[picture p121: CAD file, 2026-10-23]
007v/out/body_print/P02_下层外壳·后.step
23.3 x 243.0 x 27.0 mm
