whois169/roboot007v/007a/out/print/S17_舵机座.stl

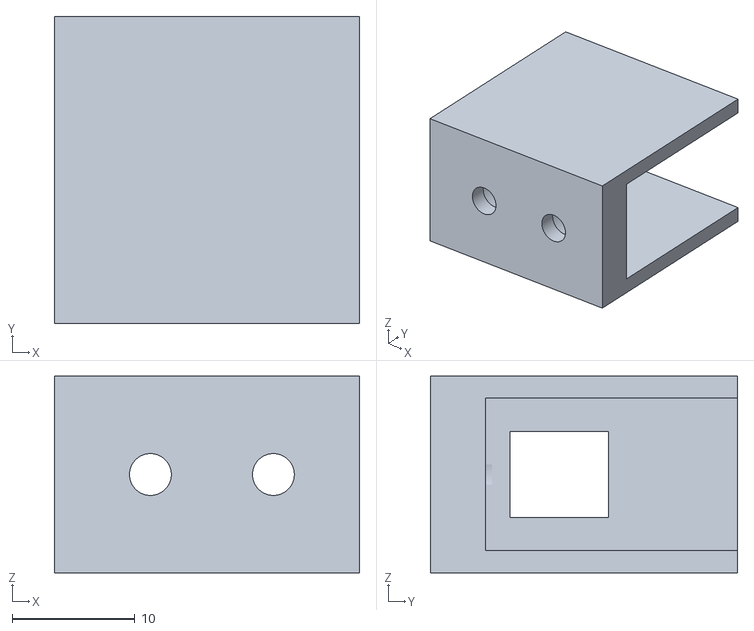
[picture p123: CAD file, 2026-10-31]
007a/out/print/S17_舵机座.stl
24.8 x 25.0 x 16.0
