whois169/roboot007v/007v/out/body_print/P16_后格栅.step

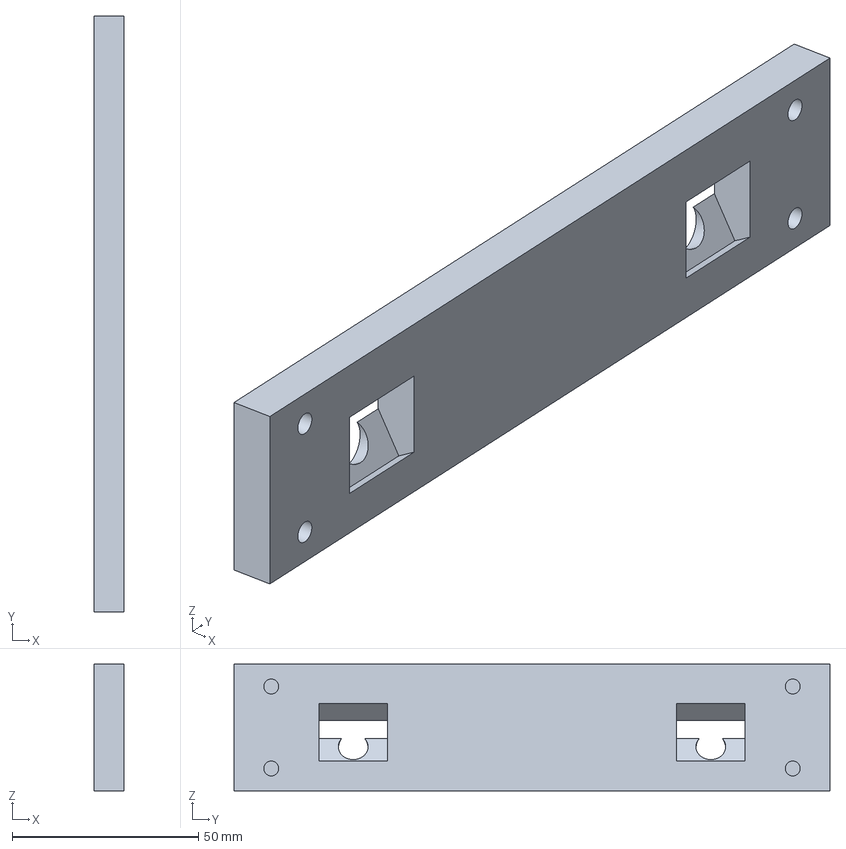
[picture p124: CAD file, 2026-10-23]
007v/out/body_print/P16_后格栅.step
8.00 x 160.0 x 34.0 mm
