whois169/roboot007v/007a/out/print/S23_小腿盖板.stl

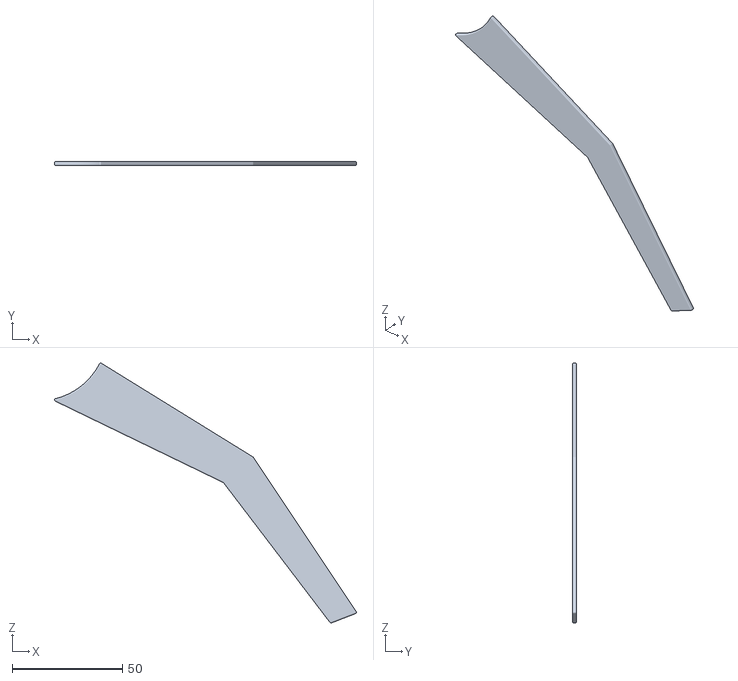
[picture p125: CAD file, 2026-10-31]
007a/out/print/S23_小腿盖板.stl
136.7 x 2.00 x 117.7
