whois169/roboot007v/007a/out/eng_parts/116.stl

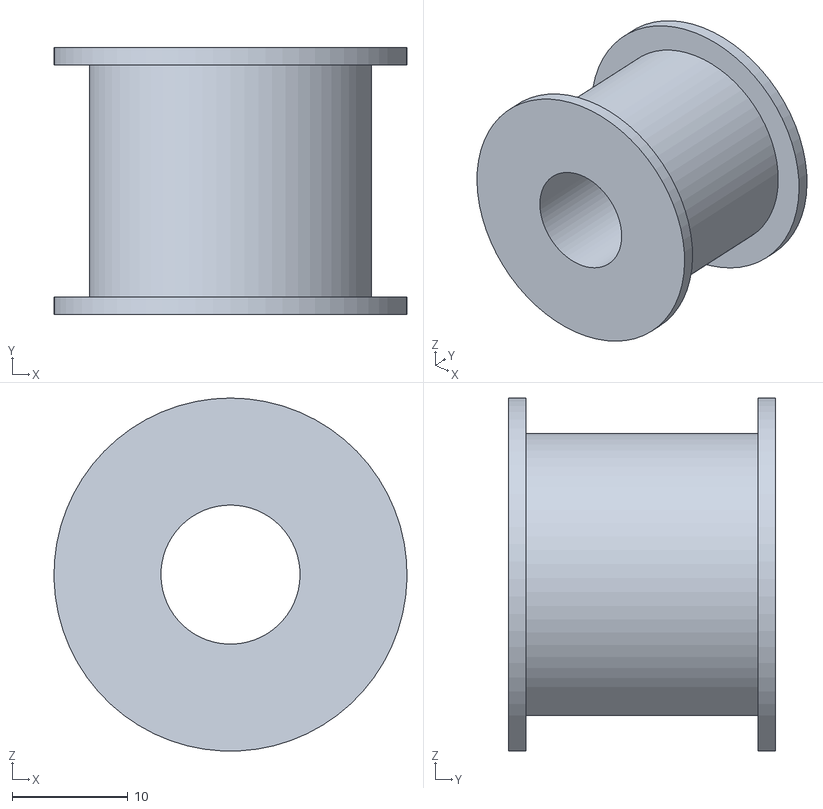
[picture p126: CAD file, 2026-10-31]
007a/out/eng_parts/116.stl
30.5 x 23.0 x 30.4
