whois169/roboot007v/007a/out/print/S15_麦克风座.stl

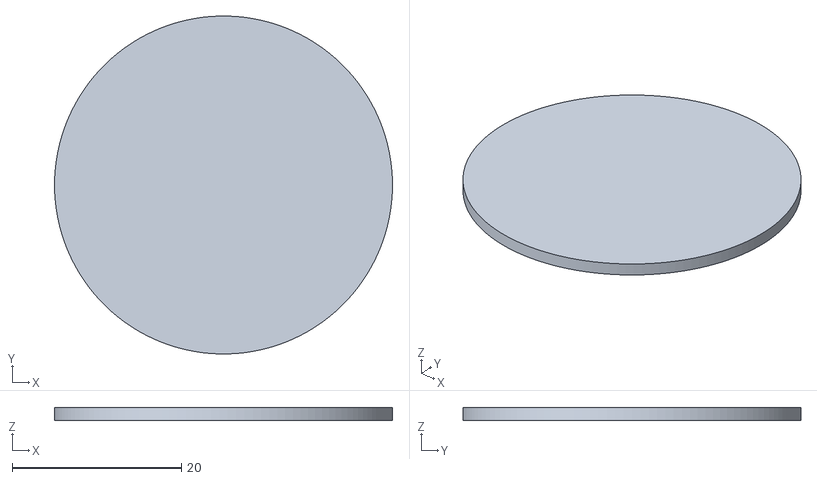
[picture p127: CAD file, 2026-10-31]
007a/out/print/S15_麦克风座.stl
40.0 x 40.0 x 1.50
