whois169/roboot007v/007a/out/mfg/H02_头支架右.step

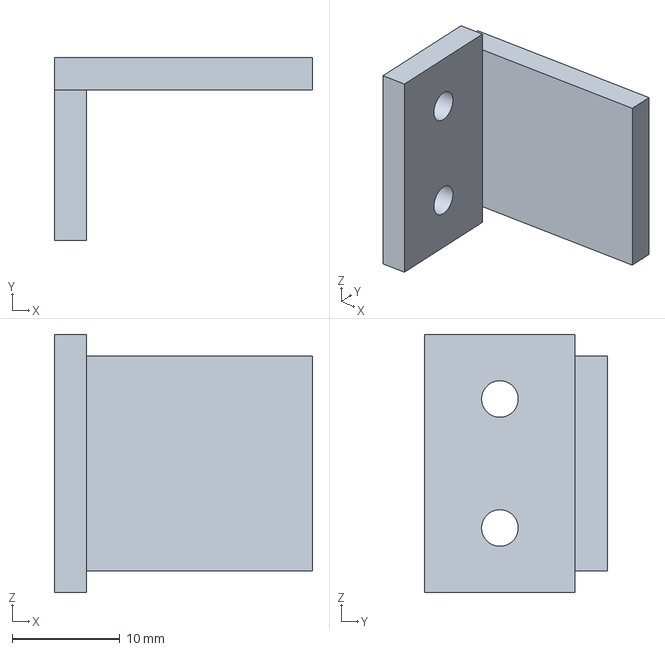
[picture p128: CAD file, 2026-10-31]
007a/out/mfg/H02_头支架右.step
24.0 x 17.0 x 24.0 mm
