whois169/roboot007v/007a/out/print/S18_护角.stl

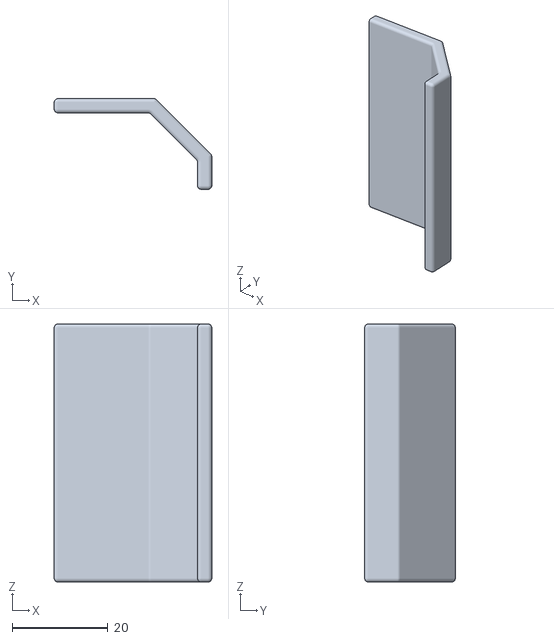
[picture p129: CAD file, 2026-10-31]
007a/out/print/S18_护角.stl
33.0 x 19.0 x 54.0
