whois169/roboot007v/007a/out/leg_parts/016.stl

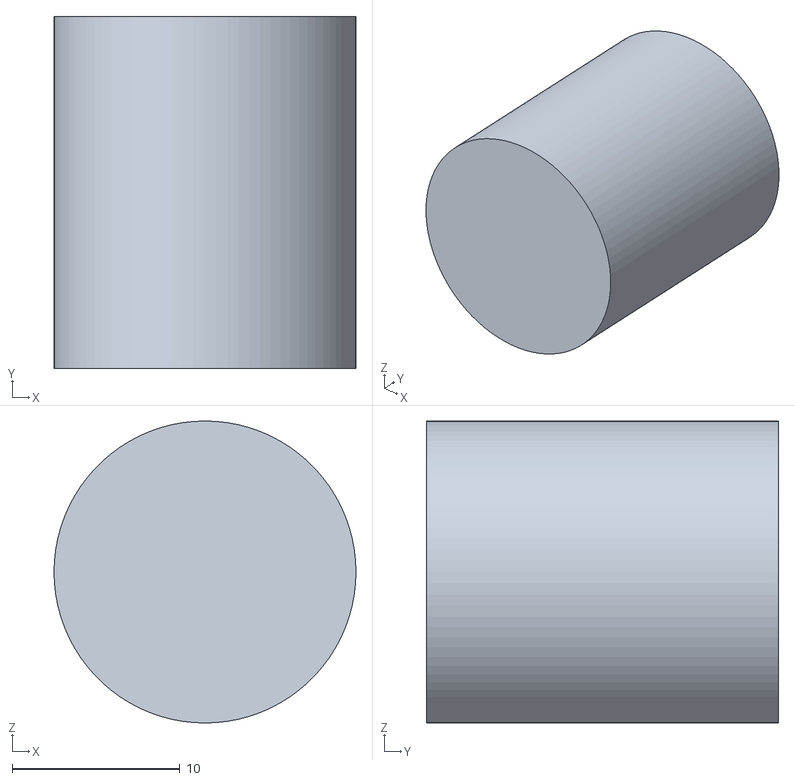
[picture p130: CAD file, 2026-10-31]
007a/out/leg_parts/016.stl
18.0 x 21.0 x 18.0
