whois169/roboot007v/007a/out/mfg/L05_膝轴.step

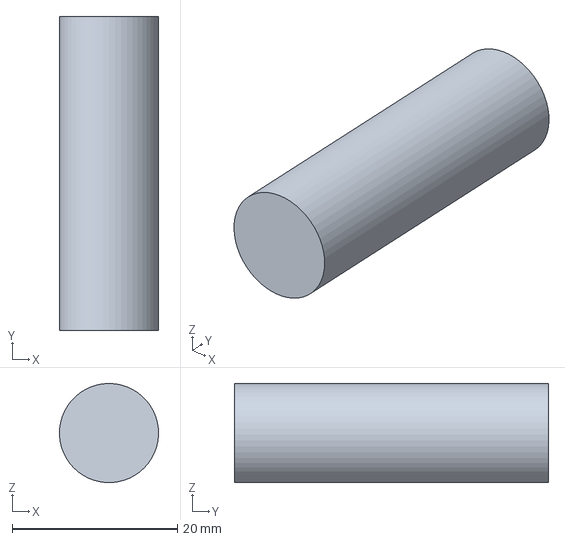
[picture p131: CAD file, 2026-10-31]
007a/out/mfg/L05_膝轴.step
12.0 x 38.0 x 12.0 mm
