whois169/roboot007v/007a/out/print/S01_上层甲板壳前左.stl

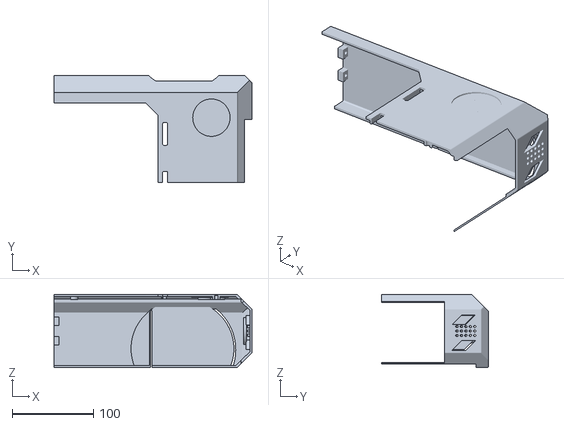
[picture p132: CAD file, 2026-10-31]
007a/out/print/S01_上层甲板壳前左.stl
243.9 x 131.9 x 90.0
