whois169/roboot007v/007v/out/body_print/P10_上层甲板壳·左后.step

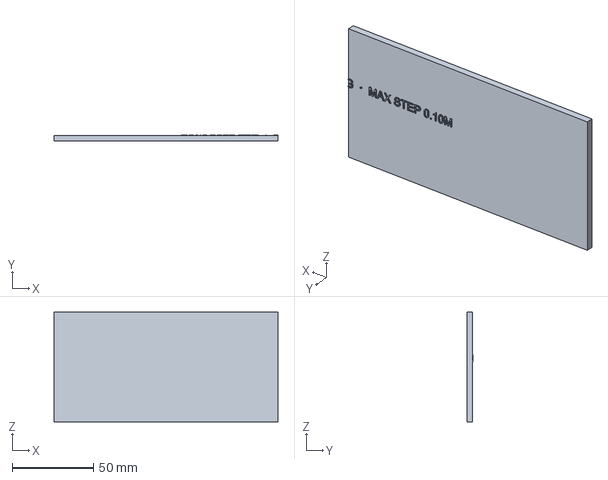
[picture p133: CAD file, 2026-10-23]
007v/out/body_print/P10_上层甲板壳·左后.step
138.0 x 3.90 x 67.5 mm
