whois169/roboot007v/007a/out/leg_parts/017.stl

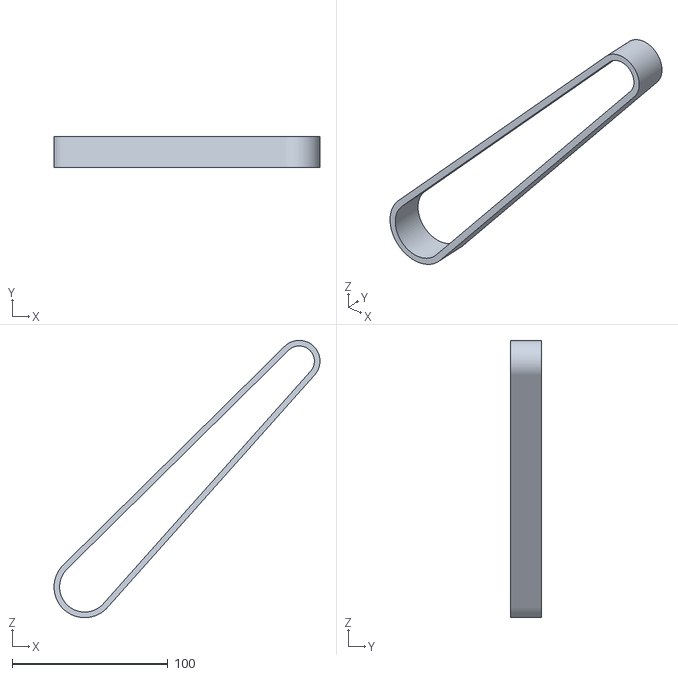
[picture p134: CAD file, 2026-10-31]
007a/out/leg_parts/017.stl
170.8 x 20.0 x 178.0
