whois169/roboot007v/007a/out/mfg/J01_L角码.step

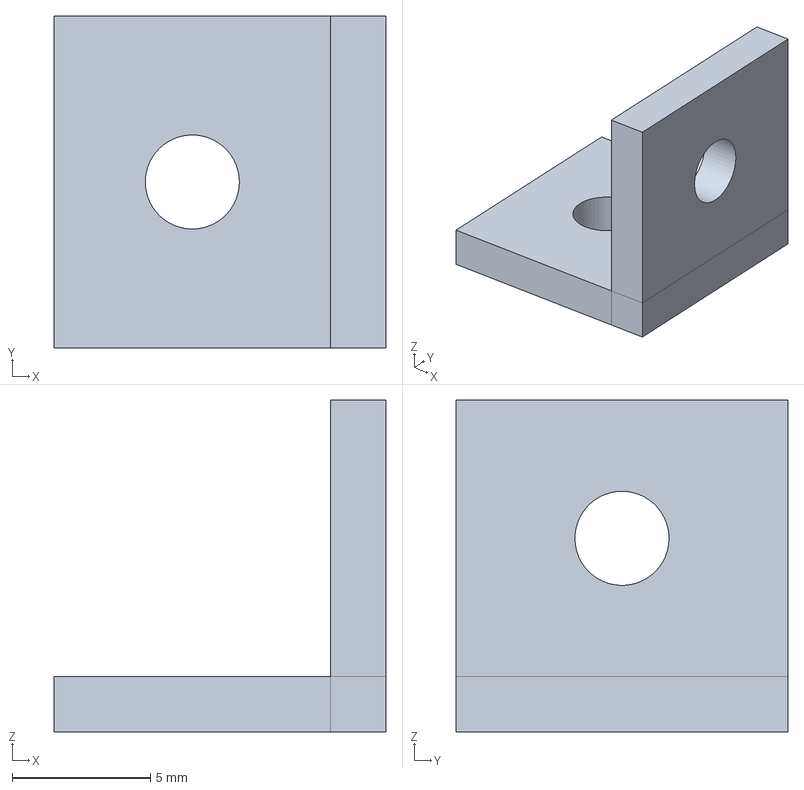
[picture p135: CAD file, 2026-10-31]
007a/out/mfg/J01_L角码.step
12.0 x 12.0 x 12.0 mm
