whois169/roboot007v/007a/out/print/S07_下层底盘前.stl

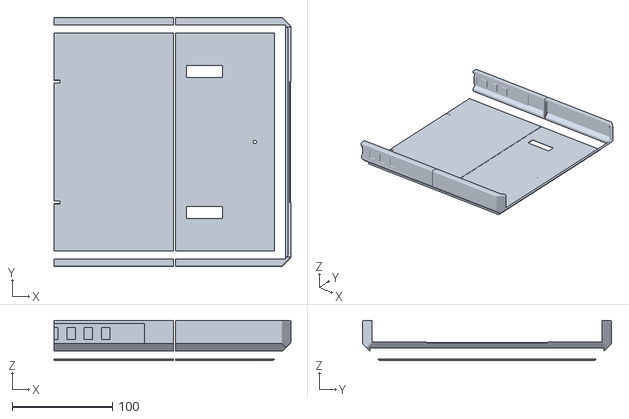
[picture p136: CAD file, 2026-10-31]
007a/out/print/S07_下层底盘前.stl
235.9 x 248.0 x 40.0
