whois169/roboot007v/007v/out/body_print/P21_滑撬·右.step

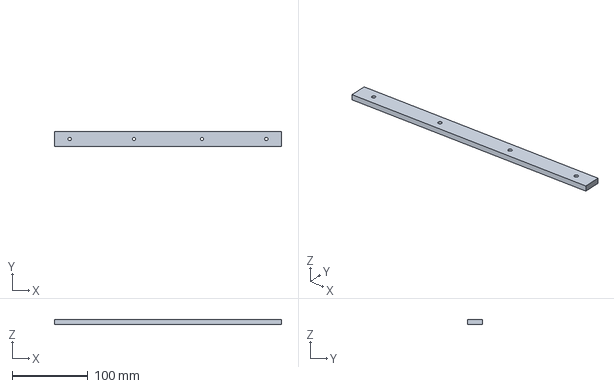
[picture p137: CAD file, 2026-10-23]
007v/out/body_print/P21_滑撬·右.step
300.0 x 20.0 x 6.00 mm
