whois169/roboot007v/007a/out/leg_parts/004.stl

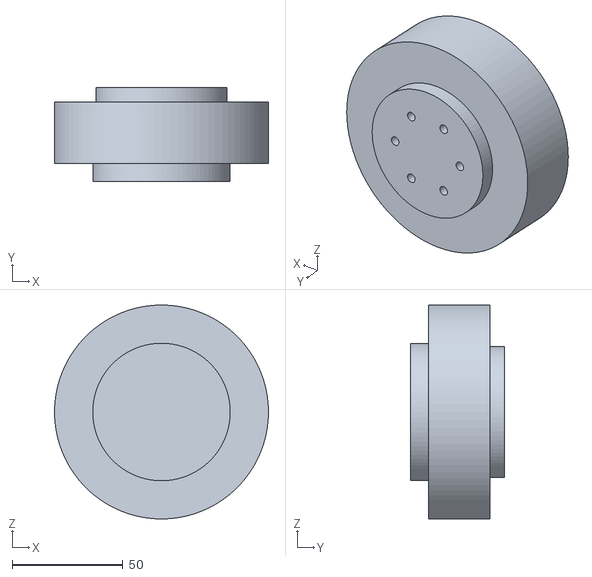
[picture p138: CAD file, 2026-10-30]
007a/out/leg_parts/004.stl
96.5 x 42.3 x 96.5
