whois169/roboot007v/007v/out/body_print/P17_头部平台盖.step

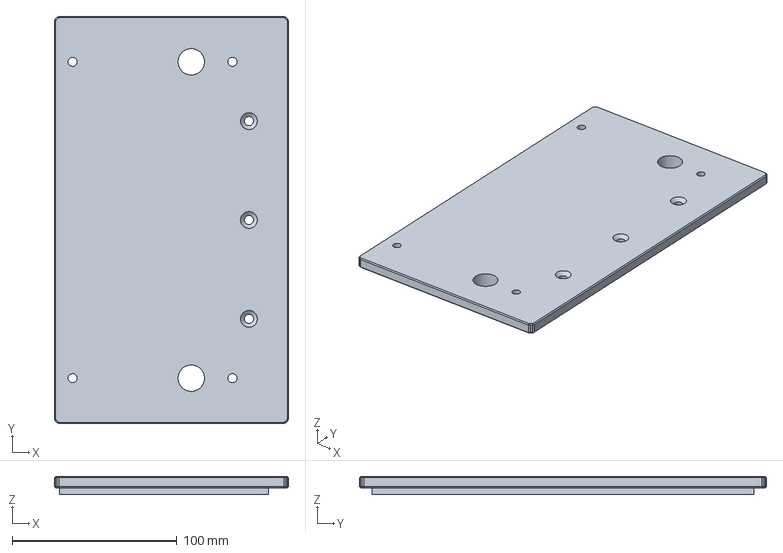
[picture p139: CAD file, 2026-10-23]
007v/out/body_print/P17_头部平台盖.step
142.0 x 247.0 x 11.0 mm
