whois169/roboot007v/007a/out/print/S08_下层底盘后.stl

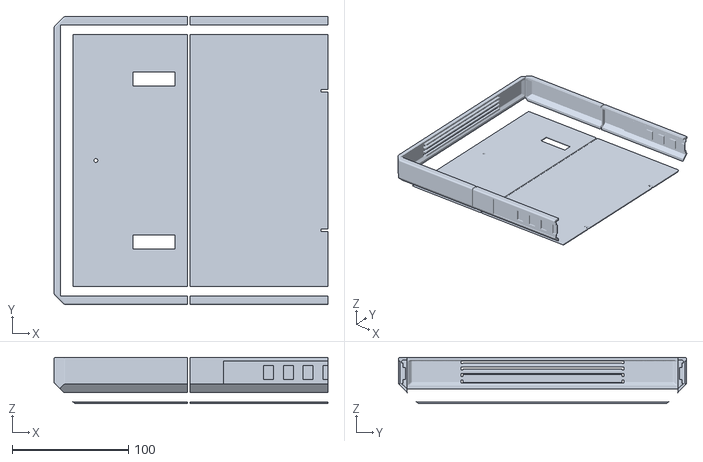
[picture p140: CAD file, 2026-10-31]
007a/out/print/S08_下层底盘后.stl
235.9 x 248.0 x 40.0
