whois169/roboot007v/007v/out/body_print/L06_电机护罩端圈.step

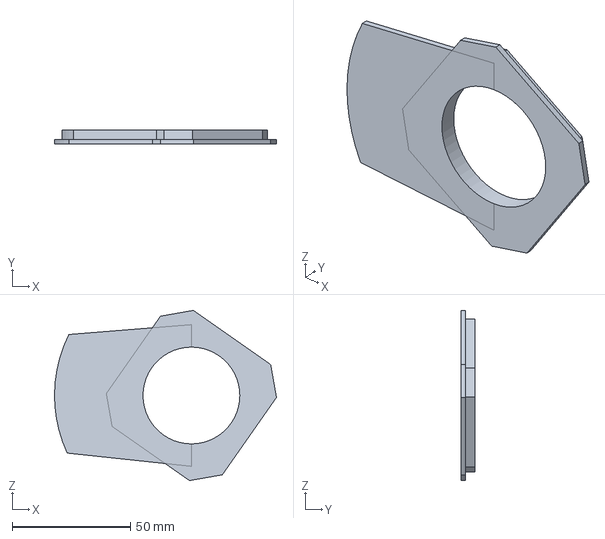
[picture p141: CAD file, 2026-10-23]
007v/out/body_print/L06_电机护罩端圈.step
94.0 x 6.00 x 72.1 mm
