whois169/roboot007v/007a/out/leg_parts/001.stl

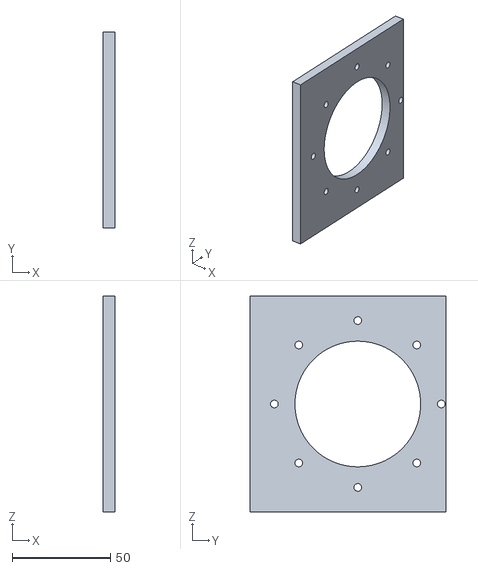
[picture p142: CAD file, 2026-10-30]
007a/out/leg_parts/001.stl
6.00 x 100.0 x 110.0
