whois169/roboot007v/007a/out/mfg/A02_A02外摆隔板前.step

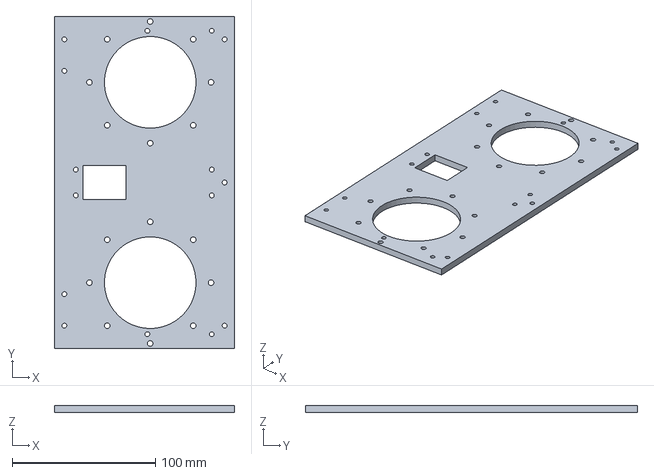
[picture p143: CAD file, 2026-10-31]
007a/out/mfg/A02_A02外摆隔板前.step
126.0 x 232.0 x 5.00 mm
