whois169/roboot007v/007a/out/print/S22_大腿外盖板.stl

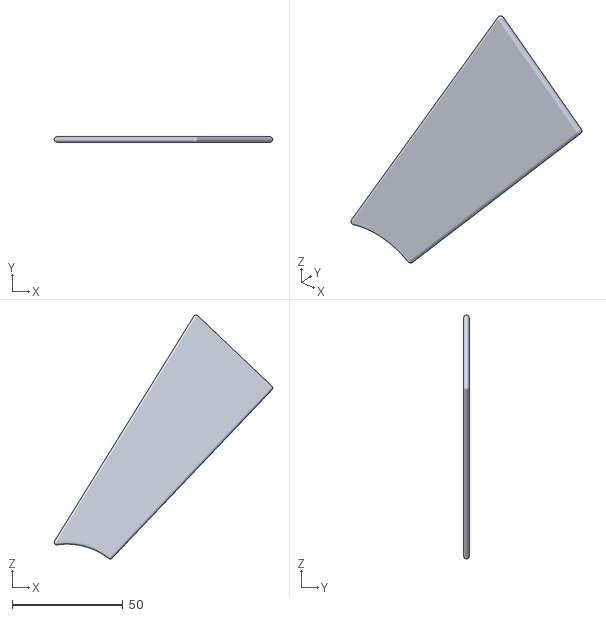
[picture p144: CAD file, 2026-10-31]
007a/out/print/S22_大腿外盖板.stl
98.7 x 2.50 x 110.2
