whois169/roboot007v/007v/out/body_print/P15_前保险杠.step

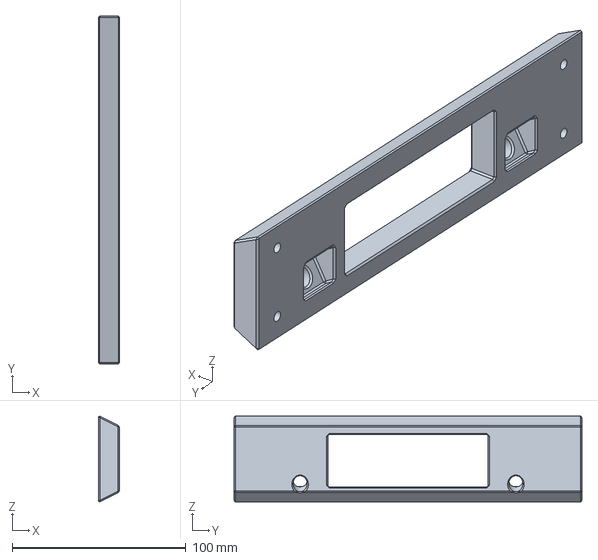
[picture p145: CAD file, 2026-10-23]
007v/out/body_print/P15_前保险杠.step
12.0 x 200.0 x 49.3 mm
