whois169/roboot007v/007a/out/mfg/A05_A05前端板.step

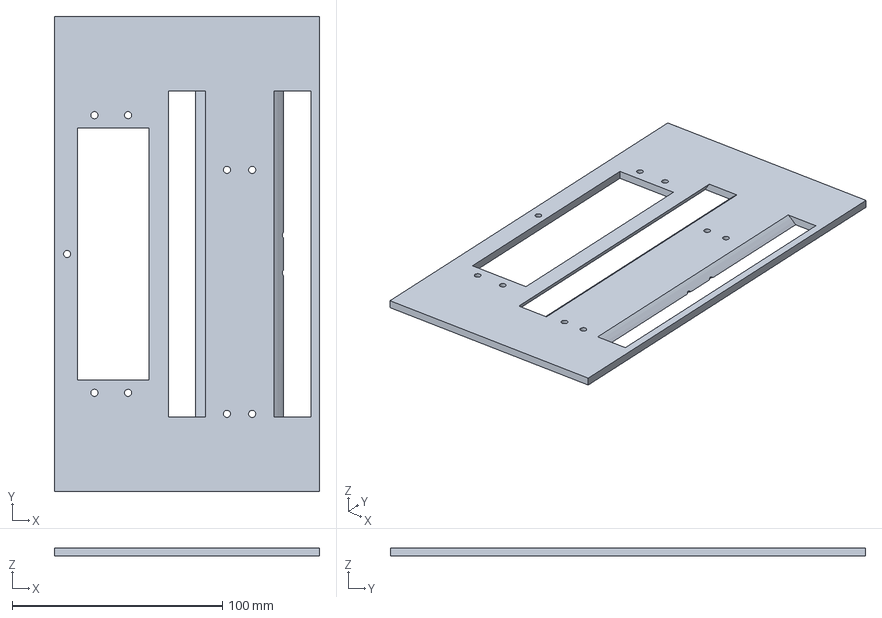
[picture p146: CAD file, 2026-10-31]
007a/out/mfg/A05_A05前端板.step
126.0 x 226.0 x 4.00 mm
