whois169/roboot007v/007a/out/print/S26_脚垫.stl

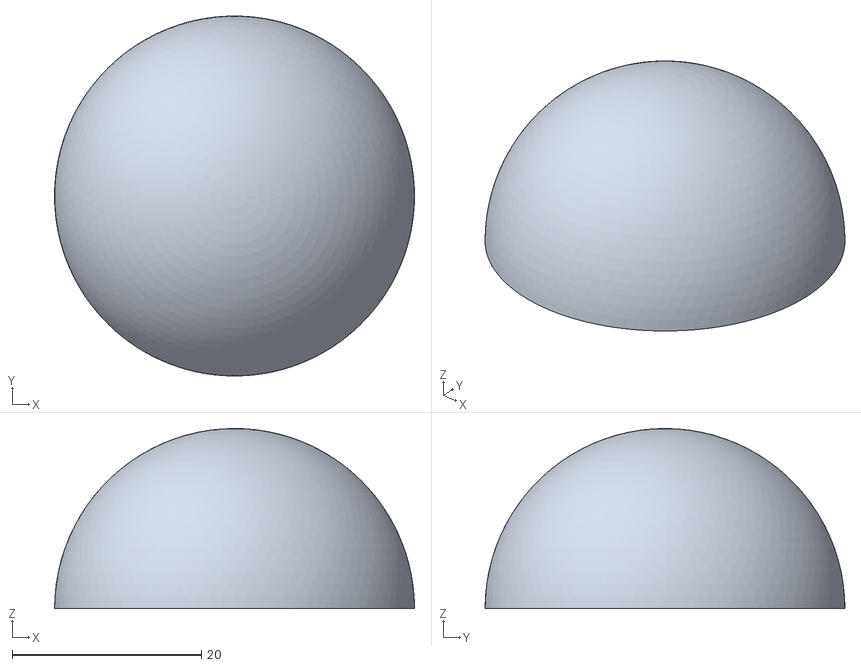
[picture p147: CAD file, 2026-10-31]
007a/out/print/S26_脚垫.stl
38.0 x 38.0 x 19.0
