whois169/roboot007v/007v/out/body_print/P19_后检修盖.step

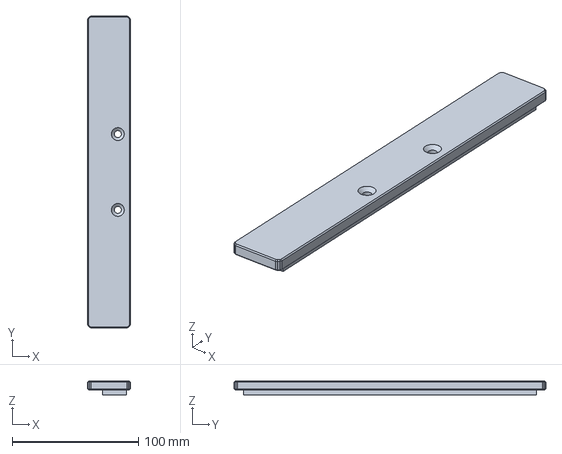
[picture p148: CAD file, 2026-10-23]
007v/out/body_print/P19_后检修盖.step
34.0 x 247.0 x 11.0 mm
