whois169/roboot007v/007a/out/mfg/P02_托板插槽导轨.stl

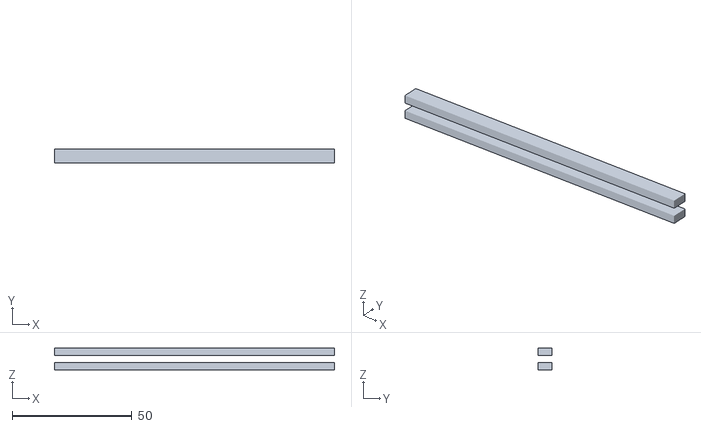
[picture p149: CAD file, 2026-10-30]
007a/out/mfg/P02_托板插槽导轨.stl
116.9 x 6.00 x 9.00
