whois169/roboot007v/007a/out/print/S05_黑腰前.stl

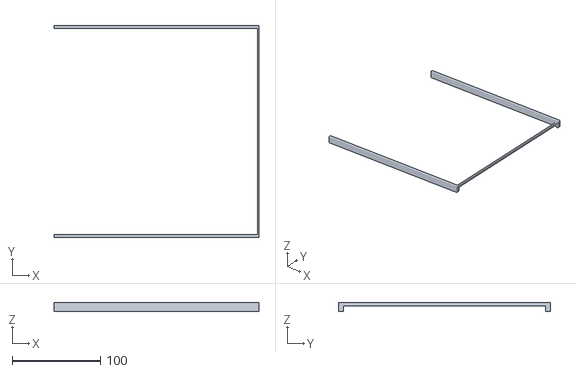
[picture p150: CAD file, 2026-10-31]
007a/out/print/S05_黑腰前.stl
231.9 x 240.0 x 10.0
