whois169/roboot007v/007v/out/body_print/L05_轮毂盖（扣在 goBILDA 轮毂上）.step

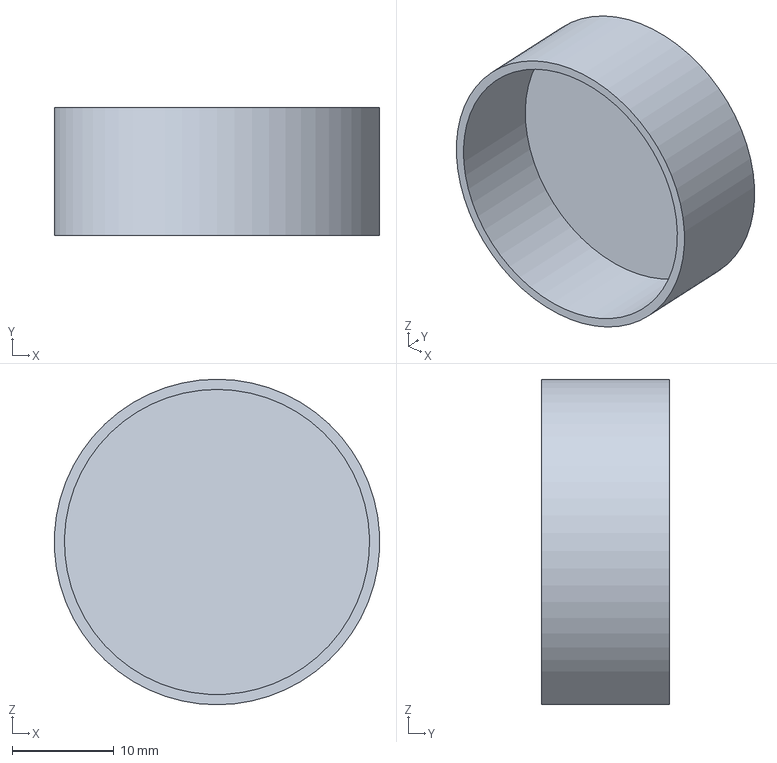
[picture p151: CAD file, 2026-10-23]
007v/out/body_print/L05_轮毂盖（扣在 goBILDA 轮毂上）.step
32.0 x 12.6 x 32.0 mm
