whois169/roboot007v/007a/out/mfg/P01_电池托.stl

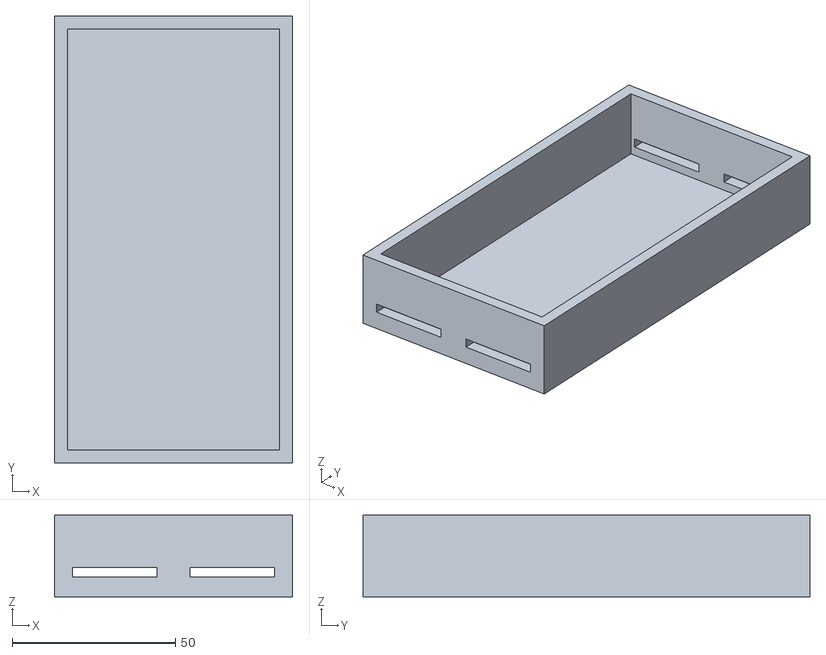
[picture p152: CAD file, 2026-10-29]
007a/out/mfg/P01_电池托.stl
73.0 x 137.0 x 25.0
