whois169/roboot007v/007a/out/leg_parts/015.stl

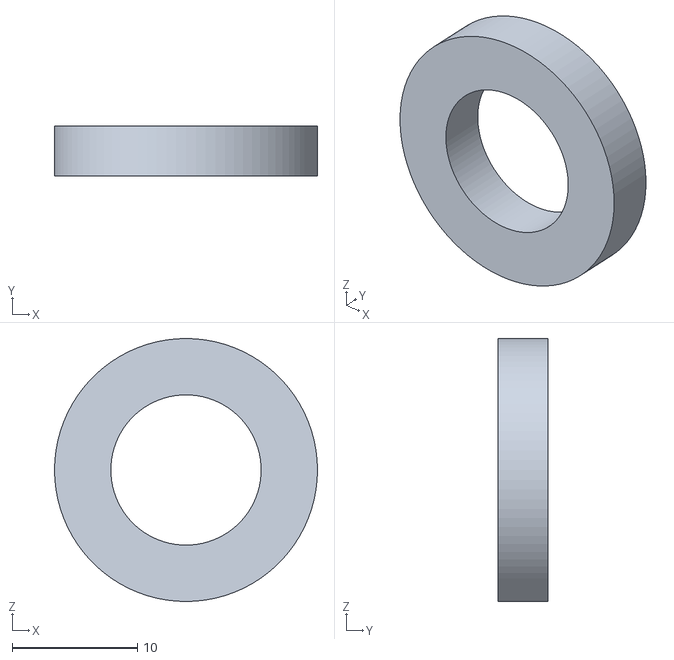
[picture p153: CAD file, 2026-10-29]
007a/out/leg_parts/015.stl
21.0 x 4.00 x 21.0
