whois169/roboot007v/007a/out/print/S09_头壳.stl

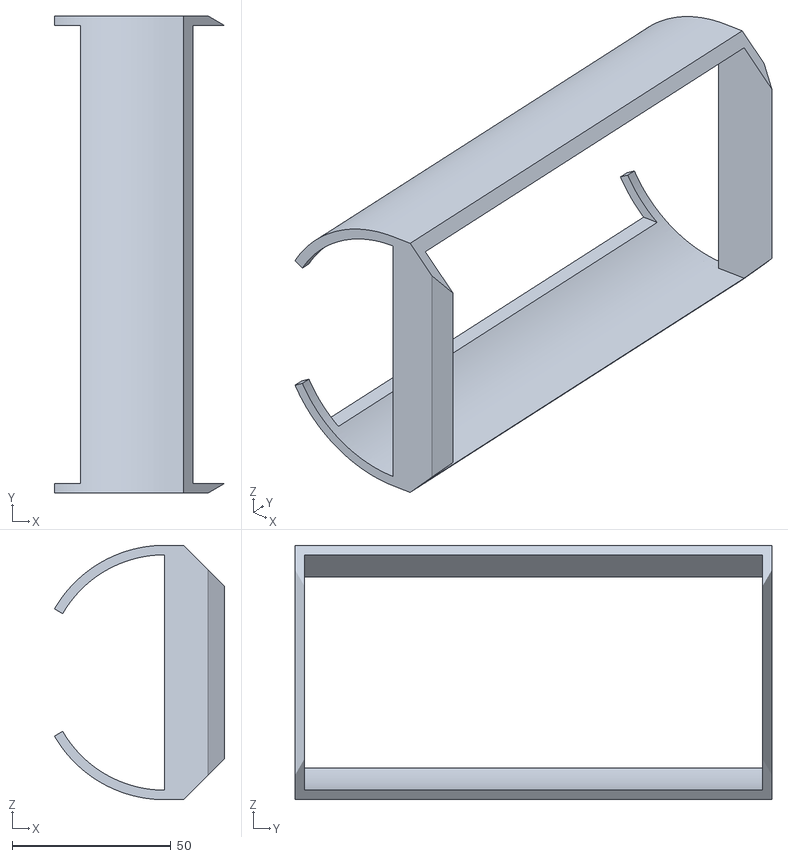
[picture p154: CAD file, 2026-10-31]
007a/out/print/S09_头壳.stl
53.5 x 150.0 x 80.0
