whois169/roboot007v/007a/out/leg_parts/010.stl

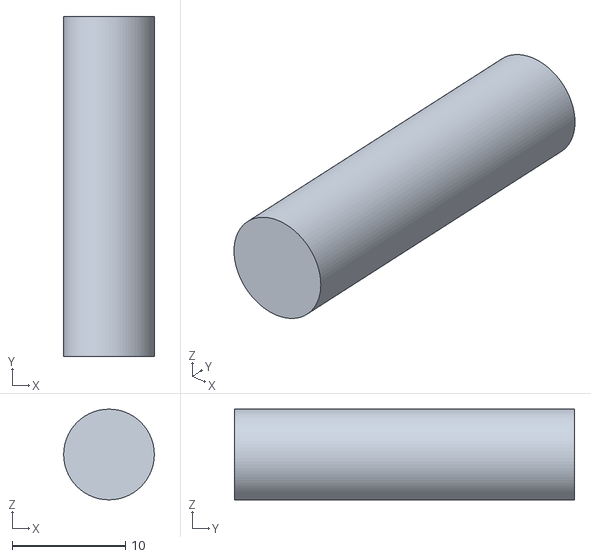
[picture p156: CAD file, 2026-10-29]
007a/out/leg_parts/010.stl
8.00 x 30.0 x 8.00
