whois169/roboot007v/007a/out/print/S14_尾部接口板.stl

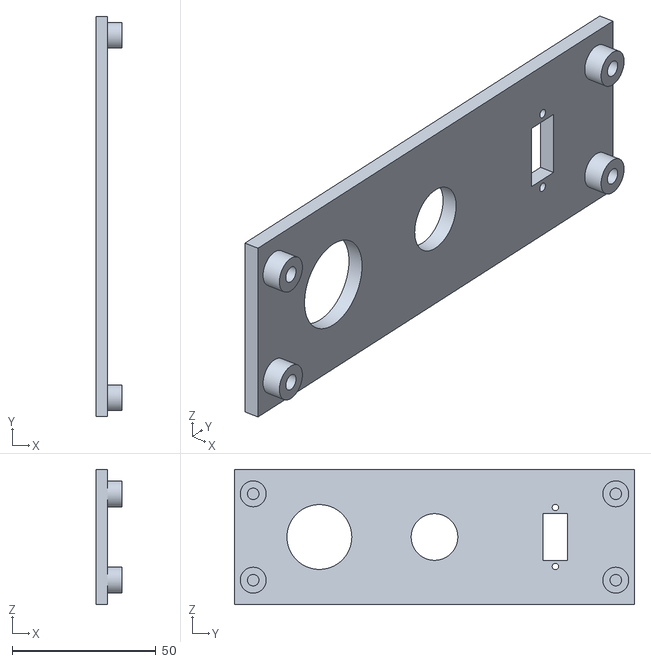
[picture p157: CAD file, 2026-10-31]
007a/out/print/S14_尾部接口板.stl
9.00 x 139.0 x 47.0
