whois169/roboot007v/007a/out/print/S24_髋盖.stl

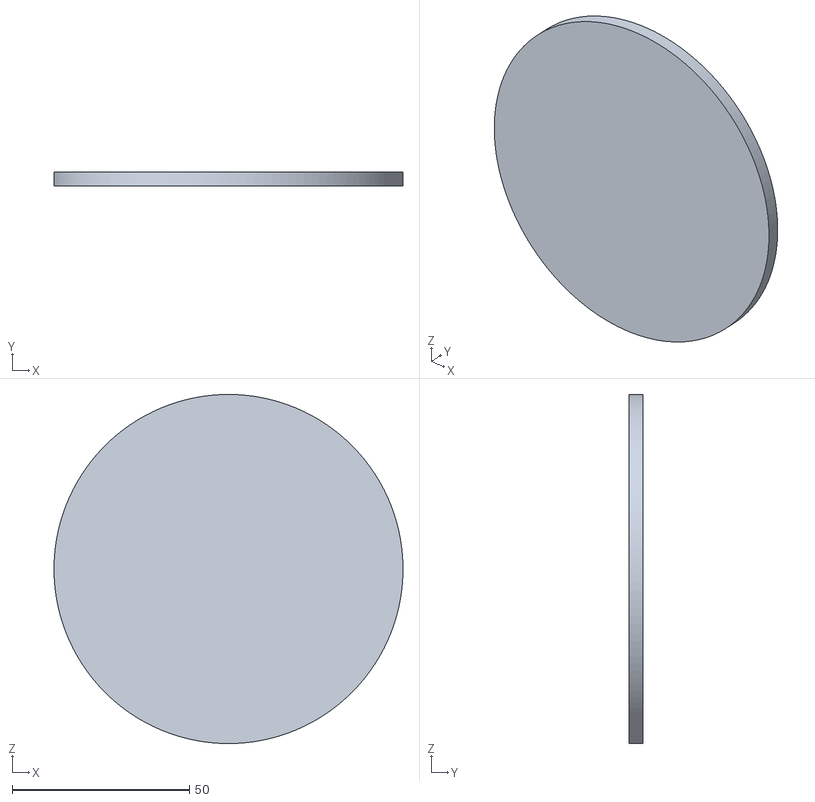
[picture p158: CAD file, 2026-10-31]
007a/out/print/S24_髋盖.stl
98.5 x 4.00 x 98.5
