whois169/roboot007v/007v/out/body_print/L02_电机护罩.step

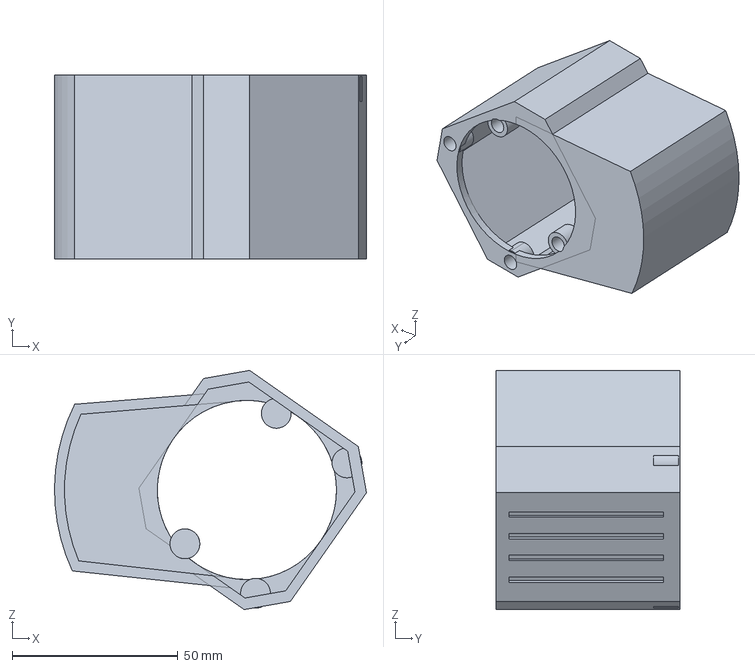
[picture p159: CAD file, 2026-10-23]
007v/out/body_print/L02_电机护罩.step
94.0 x 55.5 x 72.1 mm
