whois169/roboot007v/007a/out/print/S06_黑腰后.stl

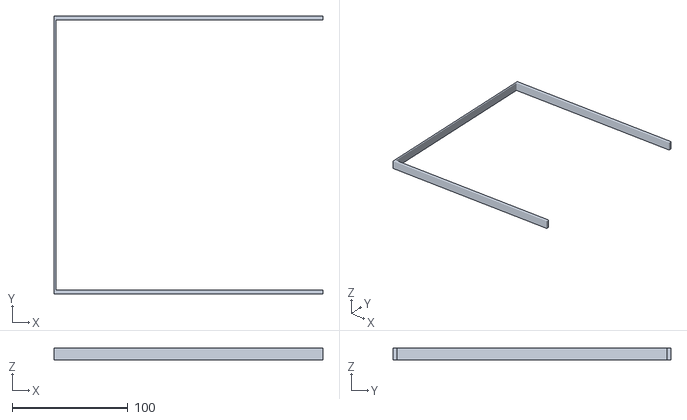
[picture p160: CAD file, 2026-10-31]
007a/out/print/S06_黑腰后.stl
231.9 x 240.0 x 10.0
