whois169/roboot007v/007v/out/body_print/P01_下层外壳·前.step

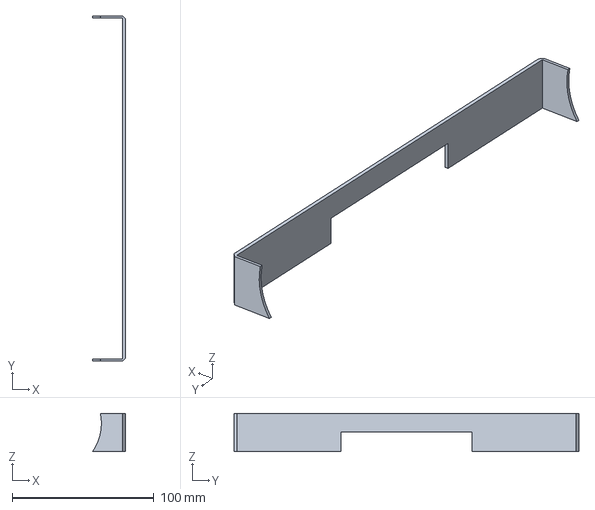
[picture p161: CAD file, 2026-10-23]
007v/out/body_print/P01_下层外壳·前.step
23.3 x 243.0 x 27.0 mm
