whois169/roboot007v/007v/out/body_print/L01_箱形臂座外壳.step

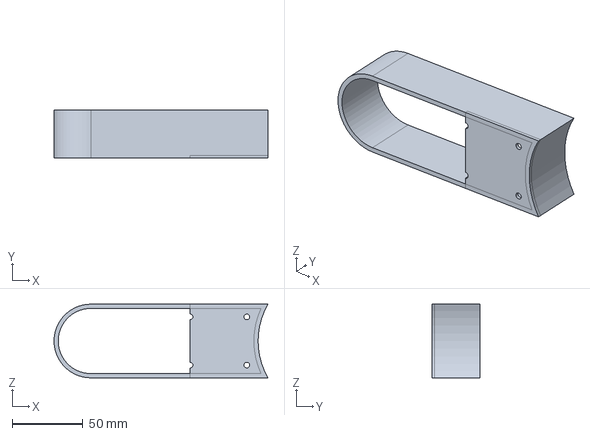
[picture p162: CAD file, 2026-10-23]
007v/out/body_print/L01_箱形臂座外壳.step
151.0 x 34.2 x 52.0 mm
