whois169/roboot007v/007v/out/body_print/P07_上层甲板壳·前鼻.step

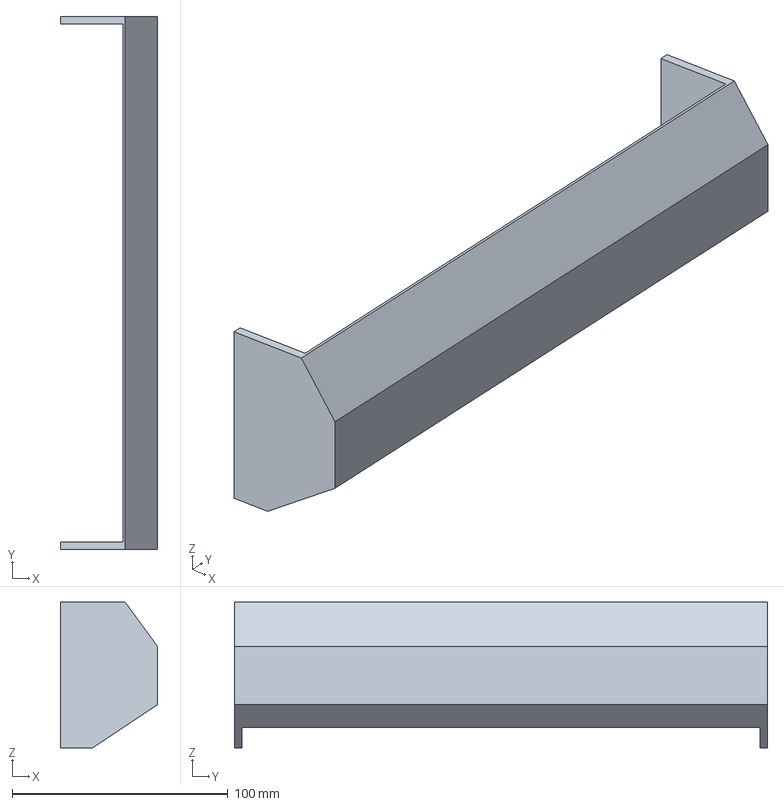
[picture p163: CAD file, 2026-10-23]
007v/out/body_print/P07_上层甲板壳·前鼻.step
45.0 x 247.0 x 67.5 mm
