whois169/roboot007v/007v/out/body_print/P25_前栏板.step

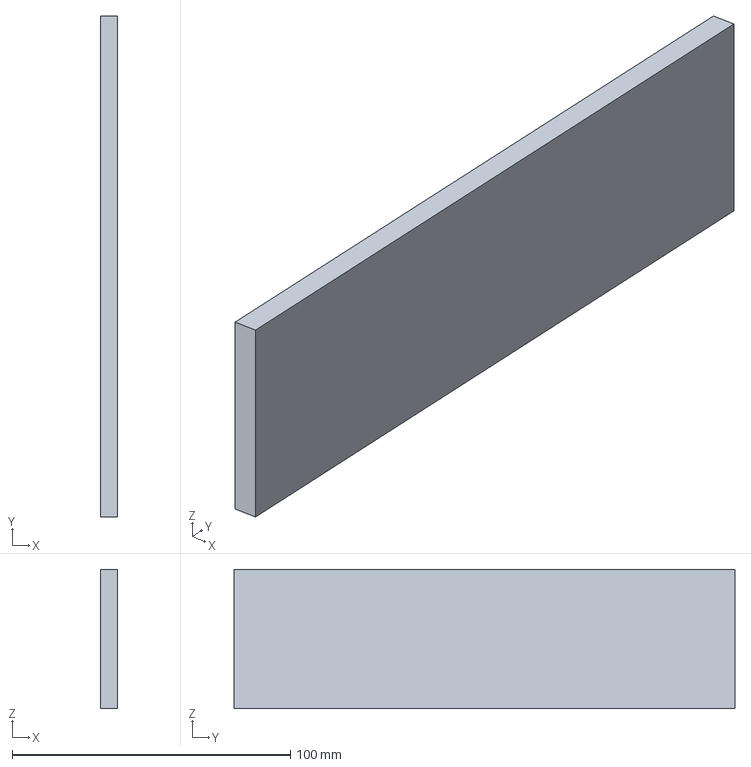
[picture p164: CAD file, 2026-10-23]
007v/out/body_print/P25_前栏板.step
6.00 x 180.0 x 50.0 mm
