whois169/roboot007v/(list of files, cad)

Other CAD files:
007a/out/eng_parts/204.stl
007a/out/eng_parts/159.stl
007a/out/mfg/L01_大腿外板.step
007a/out/eng_parts/134.stl
007a/out/leg_parts/003.stl
007a/out/eng_parts/205.stl
007a/out/leg_parts/026.stl
007a/out/leg_parts/024.stl
007a/out/eng_parts/135.stl
007a/out/leg_parts/023.stl
007a/out/eng_parts/108.stl
007a/out/leg_parts/019.stl
007a/out/eng_parts/177.stl
007a/out/leg_parts/027.stl
007a/out/print/S10_侧装甲板1.stl
007a/out/eng_parts/186.stl
007a/out/leg_parts/022.stl
007a/out/eng_parts/188.stl
007a/out/leg_parts/025.stl
007v/out/body_print/P12_上层甲板壳·右后.step
007a/out/leg_parts/014.stl
007a/out/mfg/L02_大腿杯和内板.step
007v/out/body_print/P13_侧挂板·左.step
007a/out/eng_parts/180.stl
007a/out/leg_parts/007.stl
007v/out/body_print/P03_下层外壳·左前.step
007a/out/eng_parts/122.stl
007a/out/eng_parts/161.stl
007a/out/eng_parts/121.stl
007a/out/mfg/L09_小腿根.step
007a/out/print/S03_上层甲板壳后左.stl
007a/out/eng_parts/132.stl
007a/out/leg_parts/000.stl
007a/out/eng_parts/176.stl
007a/out/eng_parts/124.stl
007a/out/leg_parts/002.stl
007a/out/eng_parts/206.stl
007a/out/leg_parts/013.stl
007a/out/eng_parts/208.stl
007a/out/leg_parts/012.stl
007a/out/print/S04_上层甲板壳后右.stl
007v/out/body_print/P22_侧栏板·左.step
007a/out/eng_parts/190.stl
007a/out/eng_parts/128.stl
007v/out/body_print/P11_上层甲板壳·右前.step
007a/out/eng_parts/151.stl
007a/out/leg_parts/018.stl
007a/out/eng_parts/197.stl
007a/out/leg_parts/009.stl
007a/out/eng_parts/148.stl
007a/out/leg_parts/008.stl
007a/out/eng_parts/149.stl
007a/out/leg_parts/011.stl
007v/out/body_print/P04_下层外壳·左后.step
007a/out/eng_parts/183.stl
007a/out/eng_parts/153.stl
007a/out/eng_parts/203.stl
007v/out/body_print/P20_滑撬·左.step
007a/out/eng_parts/175.stl
007v/out/body_print/P05_下层外壳·右前.step
007a/out/eng_parts/181.stl
007a/out/eng_parts/182.stl
007a/out/eng_parts/152.stl
007a/out/eng_parts/126.stl
007a/out/eng_parts/162.stl
007a/out/eng_parts/207.stl
007a/out/eng_parts/209.stl
007a/out/eng_parts/000.stl
007a/out/eng_parts/001.stl
007a/out/eng_parts/002.stl
007a/out/eng_parts/003.stl
007a/out/eng_parts/005.stl
007a/out/eng_parts/006.stl
007a/out/eng_parts/007.stl
007a/out/eng_parts/008.stl
007a/out/eng_parts/009.stl
007a/out/eng_parts/010.stl
007a/out/eng_parts/011.stl
007a/out/eng_parts/012.stl
007a/out/eng_parts/013.stl
007a/out/eng_parts/014.stl
007a/out/eng_parts/015.stl
007a/out/eng_parts/016.stl
007a/out/eng_parts/017.stl
007a/out/eng_parts/018.stl
007a/out/eng_parts/019.stl
007a/out/eng_parts/020.stl
007a/out/eng_parts/021.stl
007a/out/eng_parts/022.stl
007a/out/eng_parts/023.stl
007a/out/eng_parts/024.stl
007a/out/eng_parts/025.stl
007a/out/eng_parts/026.stl
007a/out/eng_parts/027.stl
007a/out/eng_parts/028.stl
007a/out/eng_parts/029.stl
007a/out/eng_parts/030.stl
007a/out/eng_parts/031.stl
007a/out/eng_parts/032.stl
007a/out/eng_parts/033.stl
007a/out/eng_parts/034.stl
007a/out/eng_parts/035.stl
007a/out/eng_parts/036.stl
007a/out/eng_parts/037.stl
007a/out/eng_parts/038.stl
007a/out/eng_parts/039.stl
007a/out/eng_parts/040.stl
007a/out/eng_parts/041.stl
007a/out/eng_parts/042.stl
007a/out/eng_parts/043.stl
007a/out/eng_parts/044.stl
007a/out/eng_parts/045.stl
007a/out/eng_parts/046.stl
007a/out/eng_parts/047.stl
007a/out/eng_parts/048.stl
007a/out/eng_parts/049.stl
007a/out/eng_parts/050.stl
007a/out/eng_parts/051.stl
007a/out/eng_parts/052.stl
007a/out/eng_parts/053.stl
007a/out/eng_parts/054.stl
007a/out/eng_parts/055.stl
007a/out/eng_parts/056.stl
007a/out/eng_parts/057.stl
007a/out/eng_parts/058.stl
007a/out/eng_parts/059.stl
007a/out/eng_parts/060.stl
007a/out/eng_parts/061.stl
007a/out/eng_parts/062.stl
007a/out/eng_parts/063.stl
007a/out/eng_parts/064.stl
007a/out/eng_parts/065.stl
007a/out/eng_parts/066.stl
007a/out/eng_parts/067.stl
007a/out/eng_parts/068.stl
007a/out/eng_parts/069.stl
007a/out/eng_parts/070.stl
007a/out/eng_parts/071.stl
007a/out/eng_parts/072.stl
007a/out/eng_parts/073.stl
007a/out/eng_parts/074.stl
007a/out/eng_parts/075.stl
007a/out/eng_parts/076.stl
007a/out/eng_parts/078.stl
007a/out/eng_parts/079.stl
007a/out/eng_parts/080.stl
007a/out/eng_parts/081.stl
007a/out/eng_parts/082.stl
007a/out/eng_parts/083.stl
007a/out/eng_parts/084.stl
007a/out/eng_parts/085.stl
007a/out/eng_parts/086.stl
007a/out/eng_parts/087.stl
007a/out/eng_parts/088.stl
007a/out/eng_parts/089.stl
007a/out/eng_parts/090.stl
007a/out/eng_parts/091.stl
007a/out/eng_parts/092.stl
007a/out/eng_parts/093.stl
007a/out/eng_parts/094.stl
007a/out/eng_parts/095.stl
007a/out/eng_parts/096.stl
007a/out/eng_parts/097.stl
007a/out/eng_parts/098.stl
007a/out/eng_parts/099.stl
007a/out/eng_parts/100.stl
007a/out/eng_parts/101.stl
007a/out/eng_parts/102.stl
007a/out/eng_parts/103.stl
007a/out/eng_parts/104.stl
007a/out/eng_parts/105.stl
007a/out/eng_parts/106.stl
007a/out/eng_parts/107.stl
007a/out/eng_parts/109.stl
007a/out/eng_parts/110.stl
007a/out/eng_parts/111.stl
007a/out/eng_parts/112.stl
007a/out/eng_parts/113.stl
007a/out/eng_parts/114.stl
007a/out/eng_parts/115.stl
007a/out/eng_parts/117.stl
007a/out/eng_parts/118.stl
007a/out/eng_parts/119.stl
007a/out/eng_parts/120.stl
007a/out/eng_parts/123.stl
007a/out/eng_parts/125.stl
007a/out/eng_parts/129.stl
007a/out/eng_parts/130.stl
007a/out/eng_parts/131.stl
007a/out/eng_parts/133.stl
007a/out/eng_parts/136.stl
007a/out/eng_parts/137.stl
007a/out/eng_parts/138.stl
007a/out/eng_parts/139.stl
007a/out/eng_parts/140.stl
007a/out/eng_parts/141.stl
007a/out/eng_parts/142.stl
007a/out/eng_parts/143.stl
007a/out/eng_parts/144.stl
007a/out/eng_parts/145.stl
007a/out/eng_parts/146.stl
007a/out/eng_parts/147.stl
007a/out/eng_parts/150.stl
007a/out/eng_parts/154.stl
007a/out/eng_parts/155.stl
007a/out/eng_parts/156.stl
007a/out/eng_parts/157.stl
007a/out/eng_parts/158.stl
007a/out/eng_parts/160.stl
007a/out/eng_parts/163.stl
007a/out/eng_parts/164.stl
007a/out/eng_parts/165.stl
007a/out/eng_parts/166.stl
007a/out/eng_parts/167.stl
007a/out/eng_parts/168.stl
007a/out/eng_parts/169.stl
007a/out/eng_parts/170.stl
007a/out/eng_parts/171.stl
007a/out/eng_parts/172.stl
007a/out/eng_parts/173.stl
007a/out/eng_parts/174.stl
007a/out/eng_parts/184.stl
007a/out/eng_parts/185.stl
007a/out/eng_parts/187.stl
007a/out/eng_parts/189.stl
007a/out/eng_parts/191.stl
007a/out/eng_parts/192.stl
007a/out/eng_parts/193.stl
007a/out/eng_parts/194.stl
007a/out/eng_parts/195.stl
007a/out/eng_parts/196.stl
007a/out/eng_parts/198.stl
007a/out/eng_parts/199.stl
007a/out/eng_parts/200.stl
007a/out/eng_parts/201.stl
007a/out/eng_parts/202.stl
007a/out/eng_parts/210.stl
007a/out/mfg/A01_A01底板.dxf
007a/out/mfg/A02_A02外摆隔板前.dxf
007a/out/mfg/A03_A03侧梁左.dxf
007a/out/mfg/A04_A04纵梁前左.dxf
007a/out/mfg/A05_A05前端板.dxf
007a/out/mfg/A06_A06后端板.dxf
007a/out/mfg/A07_A07顶板.dxf
007a/out/mfg/C01_电子托板.dxf
007a/out/mfg/L01_大腿外板.dxf
007v/out/body_print/L01_箱形臂座外壳.stl
007v/out/body_print/L02_电机护罩.stl
007v/out/body_print/L03_摆臂外盖板.stl
007v/out/body_print/L04_髋部大圆盖.stl
007v/out/body_print/L05_轮毂盖（扣在 goBILDA 轮毂上）.stl
007v/out/body_print/L06_电机护罩端圈.stl
007v/out/body_print/P01_下层外壳·前.stl
007v/out/body_print/P02_下层外壳·后.stl
007v/out/body_print/P03_下层外壳·左前.stl
007v/out/body_print/P04_下层外壳·左后.stl
007v/out/body_print/P05_下层外壳·右前.stl
007v/out/body_print/P06_下层外壳·右后.stl
007v/out/body_print/P07_上层甲板壳·前鼻.stl
007v/out/body_print/P08_上层甲板壳·后鼻.stl
007v/out/body_print/P09_上层甲板壳·左前.stl
007v/out/body_print/P10_上层甲板壳·左后.stl
007v/out/body_print/P11_上层甲板壳·右前.stl
007v/out/body_print/P12_上层甲板壳·右后.stl
007v/out/body_print/P13_侧挂板·左.stl
007v/out/body_print/P14_侧挂板·右.stl
007v/out/body_print/P15_前保险杠.stl
007v/out/body_print/P16_后格栅.stl
007v/out/body_print/P17_头部平台盖.stl
007v/out/body_print/P18_货斗底板.stl
007v/out/body_print/P19_后检修盖.stl
007v/out/body_print/P20_滑撬·左.stl
007v/out/body_print/P21_滑撬·右.stl
007v/out/body_print/P22_侧栏板·左.stl
007v/out/body_print/P23_侧栏板·右.stl
007v/out/body_print/P24_后栏板.stl
007v/out/body_print/P25_前栏板.stl
007v/out/body_print/P26_编码器支架（左右镜像各打 2）.stl
