whois169/roboot007v/docs/机械狗007A/装配说明.md

# 机械狗007A 装配说明（第 4 步，v20 宇树电机）

零件编号见 `零件图.pdf`、`制造件清单.md`、`打印件清单.md`；买的东西见 `采购清单.xlsx`。看位置对照 `整机爆炸图.png`、`腿部爆炸图.png`，或打开 `007A_省钱版.blend` 拖“拆散”滑块。

## 先买、先测（样品批）

1. 先买 **3 个宇树 GO-M8010-6**（驱动在电机里），就是一条腿的量，加 1 个宇树 USB 转 4 路 485 模块、1 套“包装清单1”。
2. 孔位已按宇树官方尺寸图画好（输出盘 6-M4 在 Φ34.5，背面 8-M3.5 在 R42.5）。到货先量图上没标的：**背面凸台直径**（按图量约 Φ61，板上开 Φ64）、**螺纹深度**。不对就改 `007a/eng_leg.py` 开头标 ★ 的数，重新跑 `mfg.py` 和 `drawings.py`，再下单加工。
3. 电机接 24 V 电源，在桌上测三项：峰值扭矩（拿弹簧秤拉一根力臂）、温升、485 通信。确认够用再买剩下 9 个。

## 一、机身骨架（铝板 + 角码，全部 M3）

1. **A01 底板**放平，四周装 **A03 侧梁**、**A04 纵梁**、**A05 前端板 / A06 后端板**。每个接缝用 J01 L 角码，配 M3×8 内六角螺丝和防松螺母。
2. 装两块 **A02 外摆隔板**（5 mm 厚的那块，前后各一块）。两面都用角码连底板和侧梁。
3. 电池托 **P01** 放在两块隔板中间，电池用两条绑带固定。继电器、保险丝盒放在电池两边。
4. 两条 **P02 托板导轨**贴在侧梁内侧。**C01 电子托板**先装好树莓派、USB 转 4 路 485、集线器、降压板、IMU，再从侧面插进导轨。IMU 要在正中间。
5. 先不装 **A07 顶板**，等腿装好、线走完再盖。

## 二、腿（4 条，左右镜像）

装配顺序就是爆炸图上从机身往外的顺序：

1. **外摆电机**背面用 8 颗 M3.5 拧在 A02 隔板上（背面凸台穿过 Φ64 孔）。
2. **L03 髋座**的后板拧在外摆电机的输出盘上，侧板托住**髋电机**的背面。
3. **L08 绕线环**套在髋电机外面。髋到膝电机的线在环里绕 1.5 圈，这样大腿转动时线不会被拉扯。
4. **L02 大腿杯 + 内板**拧在髋电机的输出盘上；**膝电机**背面也拧在杯底上，膝电机跟着大腿一起转。
5. 依次装：**L04 转接盘 + 轴**（拧膝电机输出盘）、**小带轮**（16 齿）、**同步带**、**张紧轮**。
6. 膝盖：
   - 两个 **6801 轴承**压进 **L09 小腿根**（铝 CNC，24 齿带轮 + 舌头）的孔里，两头顶到中间台阶。
   - **L07 小腿**（打印）的槽夹住小腿根的舌头，3 颗 **M4×16 薄头**横穿，头和薄螺母都沉进小腿的沉孔里（不能凸出来，小腿要在大腿叉口里转），螺纹点一滴中强度螺纹胶。
   - 把小腿根放进大腿两块板中间，套上皮带；两边各放一个**垫套 12×16**（只顶轴承内圈）。
   - **膝轴 L05** 从外板穿过去，两头各一颗 **M5×10** 拧死在内板和外板上。膝轴不转，小腿根绕着轴承转。
7. 装 **L01 大腿外板**（4 根 M4 立柱 + 外侧 6801 轴承）。用张紧轮把皮带压到手按下去约 3 mm。
8. 外面装 **S21 大腿外层壳**，再装盖板、髋盖、膝盖帽和脚垫（S24–S28）。

## 三、走线、上电

1. 每条腿 3 个电机串成一条 485 总线，4 条腿接 USB 转 4 路 485 的 4 个口。电源线不细于 16 AWG。
2. 急停串在电机电源继电器的线圈上，按下急停只断电机，树莓派不断电。
3. 走线路径见 `走线图.png`。第一次上电先**只接一条腿**，确认电机转动方向和零位，再接其他腿。

## 四、外壳（3D 打印）

1. 上层甲板壳是 4 块（S01–S04），下层底盘 2 块（S07–S08），黑腰 2 块（S05–S06）。接缝处插 Φ4×10 钢销再用胶粘，**先拼好整圈再装到骨架上**。
1b. 上层壳 4 块的接缝里有小凸台，插 Φ3 × 10 钢销对齐再粘；黑腰太薄，只用胶。
2. 下层底盘从下面套上，用 M3 圆头螺丝从底面拧进 A01 底板（2 颗）。
3. 黑腰放在下层底盘上面。
4. 盖上 A07 顶板，再放上层甲板壳。从顶板下面用 M3 拧进壳里的热熔螺母（6 颗）。
5. 装外面的小件：侧装甲板、前防撞杠、深度相机罩、热像仪座（MLX90640 镜头前直接开孔）、雷达护圈、护角（TPU）、急停座、麦克风座。
6. 头壳（S09，壁 3）装在两块头支架 H01 / H02 上，抬头舵机 STS3032 装在左支架上。头后面上下两片弧形裙边插进机身前脸的弧形窝和 A05 前端板的两条弧形槽里，抬头 40°、低头 20° 都只有 1.5 mm 的缝。

## 五、传感器（v20，孔位全按官方图纸，见 `孔位核对.md`）

1. **前防撞杠（S12）先装好传感器，再整根装上车：**
   - 深度相机 Gemini 335 从前面塞进相机罩，背面 2 颗 M3×6 从杠背面的沉头孔拧进相机（相机螺纹只有 3 深，别用长螺丝）；右端插 90° 弯头 USB-C 线，从出线道走到杠背面。
   - 热像仪 MLX90640：探头朝前塞进板槽，4 颗 M2.5×6 自攻从板背面拧。
   - 台阶测距 ×2：板塞进槽，各 2 颗 M2×6 自攻。
   - 探照灯：散热铝块 → 灯板 → 透镜依次放进灯筒，压圈 S16 胶粘压住。
   - 所有线顺着杠背面两边的走线槽，到中间进 A05 的大口。
   - 最后 4 颗 M3×8 从机身里面穿 A05 拧进杠背面的热熔螺母。
2. **尾部接口板（S14）：** 急停（y = −40）、总开关（正中）、充电口（y = +42）先装在板上，再 4 颗 M3×8 从机身里面穿 A06 拧进板背面柱子的热熔螺母。
3. **顶上：** 雷达 LD19 坐在上层壳左前角，3 颗 M2×8 自攻；护圈 S13 套在外面，2 颗 M2.5 从壳里面往上拧。麦克风 ×2 卡进拾音孔下面的圆槽（胶粘），喇叭 ×2 卡进前壁里面的卡圈（胶粘）。
4. **电子托板 C01：** 树莓派、两块 Pololu 降压、功放用铜柱；IMU 放进卡座 S17（扎带绑住），卡座 2 颗 M3×8 从托板下面拧；485 模块、集线器、12 V 降压用扎带。

## 打印建议

- 外壳用 ASA（耐晒、不怕热），4 圈壁、15 % 填充；大腿外层壳和小腿用 PA12-CF。护角、脚垫用 TPU 95A。
- 外壳大块正面朝下打，外观面朝向打印床，表面会更平整。
- 热熔螺母用 M3 × 5（外径 4），烙铁 220 °C 压进去。
