whois169/roboot007v/docs/机械狗007v/机身腿部打印与装配说明.md

# 机械狗007v 机身和腿部：打印件、尺寸依据、装法

> 2026-10-22 第二版：麦轮、5840 髋电机、电池组也按厂家资料定了型号。
> 文件由 `python 007v/body_print.py` 生成，放在 `007v/out/body_print/`：
> - **STL**：已经按打印方向摆好。
> - **STEP**：零件在装配位置。
>
> 铝板、车削件的图纸还是 `007v/out/mfg/`（A、B、C 开头的）。`out/mfg/` 里 D 开头的打印件只是外观模型，以这里的 P、L 开头的为准。

## 一、这次按官方图纸改了什么

| 地方 | 改了什么 | 依据 |
|---|---|---|
| 轮子电机 | 总长 41（原来按 38）；B07 改成兼电机座，3 颗 M2.5 拧电机前面，Φ37.1 孔套住电机凸台定心；B08 法兰 Φ34，3 颗 M3 沉头，分布圆 Φ27（原来按 6 颗画的） | SteadyWin GIM4310-10 官方安装图 + 3D 模型（`ref/gim4310/`） |
| 电子托板 C01 | 按官方孔位开孔：树莓派 5、ESP32、CAN Pal、TCA9548A、两块 Pololu；BTS7960、12V 降压、INA226 开长孔 | 各家官方图纸 / 电路板文件（`ref/boards/`、`ref/pi5/`、`ref/pololu/`） |
| 底板 A03 | 保险丝盒、两个继电器座开长孔 | 通用件 |
| 髋部编码器 | 新打印件 P26 编码器支架：托住 Adafruit AS5600，芯片正对髋轴端头的磁铁（间隙 1 mm），2 颗 M3 拧在侧板上 | Adafruit 官方电路板文件 |
| 台阶测距 | 从腿上挪到机身：前保险杠 2 个（朝前下 30°，外面一个 Φ8 小黑窗），后格栅 2 个（藏在鳍中间）；腿上去掉 D30 | Pololu 3415 官方尺寸图 |
| 轮子电机线 | 侧板 A01 过线孔挪到 x = 髋 ± 25、z = 75（黑腰铝带上，避开灯带），装 Φ12 橡胶护线圈；线从护罩出线口沿臂座上沿走到髋轴旁边，正对这个孔进机身。髋轴附近留一段余量，腿翻转时线跟着弯，不扯 | 站立姿态算的位置 |
| 后面板（急停、总开关、充电口） | 原来只在后板上开了孔、外壳下沿被切出半圆缺口，模型里没有实物。现在三样都挪到上层甲板壳后鼻那段竖面上（两盏尾灯中间，离机身底 114–115 mm），排成一排：左边总开关、中间急停、右边充电口。**急停**拧在后板 A05 上，外壳挖 Φ44 的窝，红蘑菇头伸出外壳 16 mm；**总开关**和**充电口**拧在外壳上（正面留 4 mm 壁，背面挖坑放螺母 / 法兰）。尾灯往外缩到 y 58–100。树莓派往前挪 4 mm（托板 C01 孔位跟着改），给急停后面的触点让位：急停离上面的 2020 横梁 1 mm、离树莓派 1.5 mm | 急停：施耐德 XB2BS542C 官方尺寸图（`ref/estop/`）；总开关：GQ16 系列尺寸图（`ref/switch/`）；充电口：Amass XT60E1 规格书（`ref/xt60/`） |
| 甲板 A02 | 脖子底座的螺丝孔改到 x = 78 / 175（原来的位置是改头部之前的，对不上） | 头部工程版 |

检查结果：
- 4 个姿态 0 处干涉。
- 趴平全程不撞。
- 机身里的电子件、编码器支架、台阶测距板单独检查过，不碰任何东西。

## 二、打印件（按 256 × 256 打印机拆好，全部放得下）

| 编号 | 名字 | 数量 | 材料 | 说明 |
|---|---|---|---|---|
| P01 / P02 | 下层外壳 前 / 后 | 各 1 | ASA 浅灰白 | 立着打 |
| P03–P06 | 下层外壳 左前 / 左后 / 右前 / 右后 | 各 1 | ASA 浅灰白 | 左右在 x = 0 拆开，接缝藏在侧挂板后面 |
| P07 / P08 | 上层甲板壳 前鼻 / 后鼻 | 各 1 | ASA 浅灰白 | P08 上有急停窝、总开关孔（背面螺母坑）、充电口窗（背面 2 个 M2.5 自攻孔，孔距 20.5 到货先用卡尺量） |
| P09–P12 | 上层甲板壳 左前 / 左后 / 右前 / 右后 | 各 1 | ASA 浅灰白 | 左边在 x = -30、右边在 x = +30 拆开，避开"007V"字样；字样一起打印，打完喷银 |
| P13 / P14 | 侧挂板 左 / 右 | 各 1 | ASA 深灰 | 4 颗 M5 沉头拧进侧板 |
| P15 | 前保险杠 | 1 | ASA 深灰 | 背面 4 个 M3 热熔螺母；两个台阶测距仓从背面装 |
| P16 | 后格栅 | 1 | PETG 黑 | 背面 4 个 M3 热熔螺母；两个台阶测距仓 |
| P17 / P18 / P19 | 头部平台盖 / 货斗底板 / 后检修盖 | 各 1 | ASA 浅灰白 | 孔和甲板、导轨、横梁的螺丝对齐 |
| P20 / P21 | 滑撬 左 / 右 | 各 1 | PETG / TPU | 300 长，**斜着放**才放得下 |
| P22–P25 | 栏板 左 / 右 / 后 / 前 | 各 1 | PETG | |
| P26 | 编码器支架 | 4（左右镜像各 2） | PETG | |
| L01 | 箱形臂座外壳 | 4 | ASA 深灰 | 外板那面 4 个 M4、腿板那面 6 个 M3 热熔螺母 |
| L02 | 电机护罩 | 4 | PA12-CF / PETG-CF | 里面 4 根 M4 螺丝柱，对腿板的 4 个孔 |
| L03 / L04 | 摆臂外盖板 / 髋部大圆盖 | 各 4 | ASA 深灰 | VHB 双面胶贴 |
| L05 | 轮毂盖 | 4 | ASA 深灰 | 扣在 goBILDA 轮毂上，盖住 4 颗 M4 |
| L06 | 电机护罩端圈 | 4 | PA12-CF / PETG-CF | 护罩朝机身那头原来是敞开的，看进去是空腔；这个圈扣进去封住，中间 Φ41 孔只露电机端面和青色光环。**装法**：电机先拧在 B07 上 → 套护罩、拧腿板 → 最后把端圈压进护罩口，点几滴胶 |

**黑腰不打印**：外观上那圈黑腰就是露出来的铝板。前后板、侧板做**黑色阳极氧化**，腰线灯条直接贴在铝板上。

**外壳怎么固定**：下层外壳、上层甲板壳都是贴在铝板外面的薄皮，用 **3M VHB 双面胶**贴牢。拆的时候用钓鱼线割开。

## 三、三样关键件（按厂家资料定的型号）

| 零件 | 型号 | 尺寸依据 | 改了什么 |
|---|---|---|---|
| 麦轮 | goBILDA 96 mm 麦轮套装 3213-3606-0002（左 2 右 2） | goBILDA 官方 3D 模型（`ref/mecanum/`）：Φ96.3 × 37.2，10 个轴承滚子；轮毂厚 12、在轮子正中，中心孔 Φ14，16 mm 孔型 4 × M4 | B08 轴端改双 D + M5；新加 B09 轮毂法兰（Φ32，4 × M4 螺纹孔 ±8，Φ14 凸台定心），4 颗 M4×16 低头螺丝从轮子外面拧；L05 轮毂盖扣在上面盖住螺丝；腿外侧面跟着轮宽走（整机宽 410） |
| 髋电机 | NFP-5840-31ZY-EN，24V，减速比 505（带霍尔编码器） | 厂家规格书 + 尺寸图（`ref/worm5840/`）：减速箱 58 × 40 × 31，4 × M4 孔距 28 × 40，输出轴 Φ8 D 形、离远端 20；电机 Φ31 × 57 | 额定 70 kgf·cm，3:1 后 20.6 N·m（原来写的 40 转/分那一档只有 9.4，不够）；**电机改成竖着朝上装**（横着装前后两个电机会在机身中间撞）；侧板 4 个孔按厂家孔位；髋关节速度按 30°/秒 重跑仿真 |
| 电池 | 6S2P 21700 定做 | 按电芯排法算：21700 平放 6 列 × 2 层 | 外形 ≤ **75 × 135 × 47**，按这个尺寸跟卖家定做；底板绑带槽跟着挪 |

改完以后：
- 4 个姿态 0 处干涉，趴平全程不撞，机身内部单独检查 0 处。
- 仿真结论不变；"0.8 m/s 直接压 15 mm 门槛"本来就要先减速，台阶测距管这个。
- 底盘测试 28 项全过。
