whois169/roboot007v/docs/机械狗007v/头部打印与装配说明.md

# 机械狗007v 头部：打印件、要买的小件、装配步骤

> 2026-10-22 第二版：所有传感器和电路板都有了专门的卡槽、定位柱或螺丝柱。
>
> 外观和定稿一样，只改了里面：
> - 拆分线
> - 螺丝孔、热熔螺母孔
> - 电路板卡槽和压框
> - 舵机仓
> - 传感器座
> - 走线孔
>
> 文件由 `python 007v/head_print.py` 生成（电子件的座子写在 `007v/head_electronics.py`），放在 `007v/out/head_print/`：
> - **STL**：已经按打印方向摆好，直接拖进切片软件。
> - **STEP**：零件在装配位置。
> - `装配体_头部.step`：整个头装好的样子。
>
> `out/mfg/` 里的 D02、D07–D14、D18 只是外观模型，**不要打印**，以这里的 H01–H19 为准。

## 一、尺寸依据（都存在 `007v/ref/`）

| 零件 | 尺寸来源 | 用到的尺寸 |
|---|---|---|
| 微雪 ESP32-S3-Touch-LCD-4.3B | 厂家图纸 + 3D 模型 | 玻璃 112.4 × 75.1，到 PCB 背面 9.1，最厚 17.4；PCB 4 个 M2 孔 |
| 飞特 STS3215 | 厂家 3D 模型 + 2D 图 | 机身 45.22 × 24.72；舵盘 Φ19.2，4 × M2 在 Φ14 圆上；底面两个插座 |
| 乐动 LD19 | 规格书 | 安装脚 54 × 46.29，3 个 Φ2.5 孔 |
| 乐鑫 ESP32-S3-DevKitC-1 v1.1 | 乐鑫官方尺寸图 | 62.74 × 25.40，没有安装孔 |
| Adafruit MLX90640 110°（4469） | Adafruit 官方电路板文件 | 25.40 × 17.78，4 个 Φ2.5 孔（孔距 20.32 × 12.70），探头在背面正中 |
| Adafruit SHT40（4885） | Adafruit 官方电路板文件 | 同上尺寸和孔位 |
| Adafruit MAX98357A（3006） | Adafruit 官方电路板文件 | 17.78 × 19.05，2 个 Φ2.5 孔 |
| SparkFun VL53L5CX Mini（19013） | SparkFun 官方电路板文件 + 尺寸图 | 25.40 × 12.70，2 个 Φ3.3 孔，芯片在背面 |
| OV5693 USB 摄像头 | 卖家图纸（得虹 WN-L2112） | 镜头模组 8 × 8.5 × 5.3；主板 15 × 30，4 孔 11 × 26 |
| INMP441 圆板 | 卖家图 | Φ13.8；底部进声（声孔在板子背面） |
| GY-302 BH1750 | 通用板 | 约 13.9 × 18.5（卡槽留了 ±0.5 余量） |
| 海凌科 LD2410B | 规格 | 35 × 7（导轨两头留了余量） |
| 940 nm 红外发射管 / VS1838B | 标准元件 | Φ5 × 8.6（法兰 Φ5.8）；6.0 × 7.0 × 5.0 |

**装配检查**：19 个打印件和 21 种外购件放在一起做实体求交，结果只有 2 处相交，都是设计上就要的过盈压入：轴销压进头壳、铜套压进耳朵。

## 二、电子件装在哪里、怎么固定

| 零件 | 位置 | 固定方法 |
|---|---|---|
| 屏幕板 | 前脸 | 两边导槽 + 压框，4 个定位销插进 PCB 的 M2 孔，4 颗 M3 |
| 摄像头镜头 | 下巴正中 Φ13 孔 | 外面压一个黑色镜头圈 H19；里面一个方框卡住模组，排线从方框后下角出来 |
| 摄像头主板 | 托板 | 4 根柱，M2×6 自攻 |
| 多点测距 VL53L5CX | 下巴右边 Φ9 孔（芯片贴着内壁） | 2 根定位柱穿过板子的 Φ3.3 孔，用烙铁把柱头烫扁 |
| 隐私灯（3 mm 红色 LED） | 下巴左边 Φ5 孔 | 从里面插进灯座，点胶 |
| 麦克风 ×2 | 左侧格栅后面（各对准一个格栅孔） | 圆圈卡住，板子和墙之间垫 1 mm 泡棉圈（密封声音），点胶 |
| 光线 GY-302 | 左侧格栅上排后面 | U 形卡槽，从上往下插；芯片朝墙 |
| 喇叭 Φ28 | 右侧格栅后面 | 喇叭圈，点胶 |
| 毫米波 LD2410B | 顶盖里面，天线朝上 | 两条带压边的导轨，从前面推进去 |
| ESP32 开发板 | 托板 | 后端垫块 + 前端托条和挡板，板底离托板 20 mm（下面插杜邦线），扎带绑住 |
| 功放 MAX98357A | 托板 | 2 根柱，M2.5×6 自攻，另一边一个托点 |
| USB 集线器 | 托板空位 | M3 铜柱或扎带（托板上全是 M3 孔） |
| 热成像 MLX90640 | 右耳方窗 Φ10.4 孔（探头伸进孔里） | 4 根定位柱，烫头固定 |
| 红外发射管 | 右耳方窗 Φ5.2 孔 | 灯座卡住法兰，灯头刚好在外表面里面 |
| 红外接收 VS1838B | 右耳方窗方孔 | 方框卡住，正面贴墙 |
| 温湿度 SHT40 | 右耳传感器仓里，拧在中板 H09 内侧 | 4 根柱，M2.5×6 自攻 |

**走线**
- **右耳传感器 → 头里**：右耳仓 → 斜孔 → 铜套后面 → **空心轴销** → 头里。所以轴销改用 Φ8 × Φ5 不锈钢管。
- **头里 → 树莓派**：从头壳背面 Φ10 孔出来，进左耳，沿耳朵里的线槽到底座。
- **舵机线、雷达线**：走左耳前端竖槽。

## 三、打印件清单（19 种，20 件）

| 编号 | 名字 | 数量 | 材料 | 打印方向 | 支撑 |
|---|---|---|---|---|---|
| H01 | 屏幕模块主壳 | 1 | ASA 浅灰白 | 底面朝下 | 要（下巴斜面、屏幕窗口上沿），用树状支撑 |
| H02 | 屏幕模块顶盖 | 1 | ASA 浅灰白 | 顶面朝下 | 不要 |
| H03 | 屏板压框 | 1 | PETG | 背面朝下，压脚朝上 | 不要 |
| H04 | 电子托板（带 ESP32 托架和柱子） | 1 | PETG | 平放 | 不要 |
| H05 | 屏框 | 1 | PETG 黑 / 深灰 | 正面朝上 | 不要 |
| H06 | 电机耳骨架（+Y，机器人左边，装舵机） | 1 | ASA 浅灰白 | 朝屏幕那面朝下 | 少量 |
| H07 | 方窗耳骨架（-Y，机器人右边，装铜套和传感器） | 1 | ASA 浅灰白 | 朝屏幕那面朝下 | 少量 |
| H08 / H09 | 耳朵中板（左 / 右，右边带温湿度柱） | 各 1 | ASA 浅灰白 | 平放 | 不要 |
| H10 / H11 | 耳朵外板（左带散热槽 / 右） | 各 1 | ASA 浅灰白 | 外面朝下 | 不要 |
| H12 / H13 | 转轴壳（左 / 右） | 各 1 | PETG 深灰 | 法兰朝下 | 不要 |
| H14 | 转轴光环 | 1 | PETG 透明 | 平放 | 不要 |
| H15 | 方窗面板（带传感器孔） | 1 | PETG 黑 | 背面朝下 | 不要 |
| H16 | 雷达法兰 | 1 | PETG 深灰（或铝 CNC） | 底面朝下 | 不要 |
| H17 | 雷达护环（带 4 根柱） | 1 | PETG 深灰 | 环朝下，柱朝上 | 不要 |
| H18 | 脖子底座 | 1 | PETG 深灰（或铝） | 底面朝下 | 不要 |
| H19 | 相机镜头圈 | 1 | PETG 黑 | 平放 | 不要 |

**打印参数**
- 层高 0.2
- **外壁 4 圈**
- 顶 / 底各 5 层
- 填充 25% 螺旋（gyroid）
- ASA 开封闭箱、关风扇

外壳件打磨后喷哑光浅灰白漆。

## 四、要买的小件（头部用）

| 名称 | 规格 | 数量 | 用在哪里 |
|---|---|---|---|
| 热熔铜螺母 M2 | 外径约 3.2，长 3–4 | 11（买 20） | 转轴壳 |
| 热熔铜螺母 M3 | 外径约 4，长 5 | 12（买 20） | 屏板压框 4、托板 4、雷达法兰 4 |
| 热熔铜螺母 M4 | 外径约 5.6，长 6 | 4 | 耳朵底面 |
| 热熔铜螺母 M5 | 外径约 6.4，长 8 | 10 | 耳朵外板 8、顶盖 2 |
| M2 盘头螺丝 | 长 6 | 13 | 转轴壳 11、舵机 2 |
| M2 自攻螺丝 | 长 6 | 8 | 舵盘 4、摄像头主板 4 |
| M2 自攻螺丝 | 长 8 | 3 | 雷达 |
| M2.5 自攻螺丝 | 长 6 | 6 | 功放 2、温湿度 4 |
| M3 内六角 | 长 8 | 4 | 屏板压框 |
| M3 内六角 | 长 6 | 4 | 托板 |
| M3 沉头 | 长 20 | 4 | 雷达法兰 |
| M4 沉头 | 长 20 | 4 | 脖子底座拧耳朵 |
| M5 沉头（头 Φ10） | 长 20 | 8 | 耳朵外板 |
| M5 沉头（头 Φ10） | 长 10 | 2 | 顶盖 |
| 钕磁铁 | Φ6 × 3 | 4 | 顶盖前端 |
| **不锈钢空心轴销** | **外 Φ8 / 内 Φ5，长 35**（买 Φ8×1.5 不锈钢精密管切 35） | 1 | 头的右边转轴，传感器线从里面穿 |
| 黄铜铜套 | 外 Φ10 / 内 Φ8 × 18 | 2（1 个备用） | 右耳 |
| 3 mm 红色 LED | 普通直插 | 2 | 隐私灯（录音 / 录像时亮） |
| 烟黑亚克力 | 3 mm，激光切 117.6 × 49.6，四角 R1 | 1 | 屏幕窗口 |
| USB-C 90° 侧弯线 | 短线 | 1 | 屏幕板 |
| 泡棉圈 / EVA 泡棉片 | 1 mm 厚 | 1 张 | 麦克风密封 |
| 小扎带 | 2.5 mm 宽 | 1 包 | ESP32、理线 |

约 **100 元**。

## 五、装配步骤

1. **埋热熔螺母**：烙铁约 220 °C，把铜螺母压进所有对应的孔，压到和表面平齐。
2. **右耳**：
   - 铜套压进 H07。
   - 热成像板放到 4 根定位柱上，探头伸进 Φ10.4 孔；用烙铁把柱头烫扁。
   - 红外发射管插进灯座，接收头放进方框，点胶。
   - 温湿度板用 4 颗 M2.5×6 拧在中板 H09 内侧。
   - 线从仓里的斜孔穿到铜套后面。
3. **左耳**：
   - 舵机放进 H06，舵盘朝屏幕、输出轴朝后、插座朝外。
   - 从内侧拧 2 颗 M2×6。
   - 插好舵机线，线走前端竖槽。
4. **装转轴壳**：H12（5 颗 M2）、H13（6 颗 M2）拧在两只耳朵内侧，光环 H14 套在 H12 上。必须在装头之前装。
5. **舵盘装到头上**：舵机舵盘取下来，放在 H01 左边（+Y）的 Φ20 圆座上，从头壳里面拧 4 颗 M2×6 自攻。
6. **空心轴销**：压进 H01 右边（-Y）的孔，露出 27 mm。
7. **下巴传感器**：
   - 镜头圈 H19 从外面压进 Φ13 孔。
   - 摄像头模组从里面放进方框。
   - 多点测距板套到 2 根定位柱上，烫头。
   - 3 mm LED 插进灯座。
8. **侧面传感器**：
   - 两个麦克风垫泡棉圈后放进左边两个圆圈。
   - 光线板从上往下插进 U 形槽。
   - 喇叭粘进右边喇叭圈。
9. **屏幕**：
   - 亚克力窗从里面粘进窗口。
   - 屏幕板斜着放进去，往前推到底。
   - 装压框 H03：4 个定位销进 PCB 孔，拧 4 颗 M3×8。
   - 屏框 H05 粘在前脸。
10. **托板**：
    - ESP32 放上托架，用扎带绑好。
    - 摄像头主板拧 4 颗 M2 自攻，功放拧 2 颗 M2.5 自攻，USB 集线器用铜柱或扎带。
    - 托板拧在底部 4 根柱子上（M3×6）。
11. **头装到耳朵上**：
    - 右耳套上轴销，传感器线从轴销里穿进头里。
    - 左耳的舵机花键插进舵盘，从头壳里面穿过 Φ6 孔拧舵机中心 M3。
    - 两只耳朵放到脖子底座上，从底下拧 4 颗 M4×20。
12. **耳朵外层**：中板、外板叠上，拧 8 颗 M5×20 沉头。
13. **雷达**：
    - 法兰拧在左耳顶（4 颗 M3×20 沉头）。
    - 雷达拧 3 颗 M2×8 自攻。
    - 护环套上，点胶。
14. **毫米波**：LD2410B 从前面推进顶盖里的导轨。
15. **盖顶盖**：先往前推让磁铁吸住，再拧侧面两颗 M5×10。

## 六、要知道的几件事

1. **前脸屏幕下面那排小孔是装饰。** 后面是屏幕玻璃，声音进不去。麦克风在左侧格栅后面，喇叭在右侧。
2. **方窗是"开孔 + 黑面板"。** 热成像看的红外线穿不过亚克力和玻璃，所以热成像正对一个通孔，黑面板远看和烟黑窗一样。
3. **雷达前两个孔离法兰边太近**，只能用 M2 自攻，别拧太紧。想更牢就 CNC 一块铝法兰。
4. **舵机背面插头空间留了 8.6 mm。** 插头太高的话可以剪掉直接焊线。
5. **热成像定位柱的高度是按探头高约 4.5 mm 算的。** 如果实物探头顶出外表面，在柱子上垫一片 0.5 mm 垫片。
6. **摄像头排线选 55 mm 那款。**
7. **毫米波 LD2410B 的尺寸**没找到原厂图纸，导轨两头留了余量。到货如果偏差大，告诉我改。
8. 头单独调试时，脖子底座可以先拧在一块木板上。
