whois169/roboot007v/007a/out/mujoco/007a.xml

<mujoco model="007A">
  <compiler angle="radian"/>
  <option timestep="0.0005" integrator="implicitfast" cone="elliptic"/>
  <visual><global offwidth="1280" offheight="720"/><quality shadowsize="4096"/></visual>
  <default>
    <geom contype="0" conaffinity="0" friction="0.8 0.02 0.001"/>
    <default class="hit"><geom contype="0" conaffinity="1"/></default>
    <default class="foot"><geom contype="0" conaffinity="1" friction="1.0 0.02 0.001" solref="0.004 1"/></default>
    <default class="terrain"><geom contype="1" conaffinity="0" rgba=".72 .72 .7 1"/></default>
  </default>
  <asset>
    <texture name="grid" type="2d" builtin="checker" rgb1=".55 .57 .6" rgb2=".5 .52 .55" width="512" height="512"/>
    <material name="grid" texture="grid" texrepeat="8 8"/>
  </asset>
  <worldbody>
    <light pos="1 -1 3" dir="-.3 .3 -1" directional="true"/>
    <geom name="floor" class="terrain" type="plane" size="20 20 .1" material="grid"/>
    <!--TERRAIN-->
    <body name="base" pos="0 0 0.2759">
      <freejoint/>
      <inertial pos="0.0111596 -0.00138833 -0.00825489" mass="6.7312" fullinertia="0.0489131 0.140233 0.167157 0 0 0"/>
      <geom name="body" class="hit" type="box" size="0.2400 0.1300 0.0700" pos="0 0 -0.0020" rgba=".9 .91 .92 1"/>
      <geom name="head" class="hit" type="box" size="0.02 0.11 0.045" pos="0.2500 0 0.0080" rgba=".15 .16 .18 1"/>
      <site name="imu" pos="0 0 0" size="0.01"/>
      <body name="cargo" pos="0 0 0.1080">
        <inertial pos="0 0 0" mass="5" diaginertia="0.02 0.04 0.05"/>
        <geom name="cargo" type="box" size="0.15 0.1 0.04" rgba=".85 .6 .2 1"/>
      </body>

    <body name="FL_haa_motor" pos="0.16 0.07 0"><inertial pos="-0.0853314 -1.42109e-17 0" mass="0.53" fullinertia="0.000591313 0.000362666 0.000362666 -1.35943e-18 0 -1.81257e-18"/></body>
    <body name="FL_hip" pos="0.16 0.07 0">
      <inertial pos="-0.00577337 -0.00430311 -2.84217e-16" mass="0.78128" fullinertia="0.000759253 0.00137073 0.000903703 3.17386e-05 -2.10511e-17 -1.64926e-17"/>
      <joint name="FL_haa" axis="1 0 0" range="-0.45 0.45" armature="0.008014" frictionloss="0.15" damping="0.05"/>
      <geom type="cylinder" size="0.048 0.021" pos="0 0.04305 0" euler="1.5708 0 0" rgba=".25 .27 .3 1"/>
      <body name="FL_thigh" pos="0 0.0861 0">
        <inertial pos="-0.0217236 -0.0230994 -0.0217298" mass="1.2364" fullinertia="0.00385944 0.00630067 0.00384046 0.00057176 -0.00248864 0.000543511"/>
        <joint name="FL_hfe" axis="0 1 0" range="-1.9 1.9" armature="0.008014" frictionloss="0.15" damping="0.05"/>
        <geom class="hit" type="capsule" fromto="0 0 0 -0.13775 0 -0.145" size="0.032" rgba=".85 .87 .9 1"/>
        <body name="FL_shank" pos="-0.13775 0 -0.145">
          <inertial pos="0.0534632 5.68434e-17 -0.0438956" mass="0.062562" fullinertia="9.82372e-05 0.000235027 0.000140383 2.04447e-19 0.000109783 2.81361e-20"/>
          <joint name="FL_kfe" axis="0 1 0" range="-1.6 1.6" armature="0.01803" frictionloss="0.22499999999999998" damping="0.05"/>
          <geom class="hit" type="capsule" fromto="0 0 0 0.117087 0 -0.095933" size="0.016" rgba=".3 .32 .35 1"/>
          <geom name="FL_foot" class="foot" type="sphere" pos="0.13775 0 -0.112862" size="0.018" rgba=".1 .1 .1 1"/>
          <site name="FL_foot" pos="0.13775 0 -0.112862" size="0.005"/>
        </body>
      </body>
    </body>
    <body name="FR_haa_motor" pos="0.16 -0.07 0"><inertial pos="-0.0853314 1.42109e-17 0" mass="0.53" fullinertia="0.000591313 0.000362666 0.000362666 1.35943e-18 0 1.81257e-18"/></body>
    <body name="FR_hip" pos="0.16 -0.07 0">
      <inertial pos="-0.00577337 0.00430311 -2.84217e-16" mass="0.78128" fullinertia="0.000759253 0.00137073 0.000903703 -3.17386e-05 -2.10511e-17 1.64926e-17"/>
      <joint name="FR_haa" axis="1 0 0" range="-0.45 0.45" armature="0.008014" frictionloss="0.15" damping="0.05"/>
      <geom type="cylinder" size="0.048 0.021" pos="0 -0.04305 0" euler="1.5708 0 0" rgba=".25 .27 .3 1"/>
      <body name="FR_thigh" pos="0 -0.0861 0">
        <inertial pos="-0.0217236 0.0230994 -0.0217298" mass="1.2364" fullinertia="0.00385944 0.00630067 0.00384046 -0.00057176 -0.00248864 -0.000543511"/>
        <joint name="FR_hfe" axis="0 1 0" range="-1.9 1.9" armature="0.008014" frictionloss="0.15" damping="0.05"/>
        <geom class="hit" type="capsule" fromto="0 0 0 -0.13775 0 -0.145" size="0.032" rgba=".85 .87 .9 1"/>
        <body name="FR_shank" pos="-0.13775 0 -0.145">
          <inertial pos="0.0534632 -5.68434e-17 -0.0438956" mass="0.062562" fullinertia="9.82372e-05 0.000235027 0.000140383 -2.04447e-19 0.000109783 -2.81361e-20"/>
          <joint name="FR_kfe" axis="0 1 0" range="-1.6 1.6" armature="0.01803" frictionloss="0.22499999999999998" damping="0.05"/>
          <geom class="hit" type="capsule" fromto="0 0 0 0.117087 0 -0.095933" size="0.016" rgba=".3 .32 .35 1"/>
          <geom name="FR_foot" class="foot" type="sphere" pos="0.13775 0 -0.112862" size="0.018" rgba=".1 .1 .1 1"/>
          <site name="FR_foot" pos="0.13775 0 -0.112862" size="0.005"/>
        </body>
      </body>
    </body>
    <body name="RL_haa_motor" pos="-0.16 0.07 0"><inertial pos="0.0853314 -1.42109e-17 0" mass="0.53" fullinertia="0.000591313 0.000362666 0.000362666 1.35943e-18 0 -1.81257e-18"/></body>
    <body name="RL_hip" pos="-0.16 0.07 0">
      <inertial pos="0.00577337 -0.00430311 -2.84217e-16" mass="0.78128" fullinertia="0.000759253 0.00137073 0.000903703 -3.17386e-05 2.10511e-17 -1.64926e-17"/>
      <joint name="RL_haa" axis="1 0 0" range="-0.45 0.45" armature="0.008014" frictionloss="0.15" damping="0.05"/>
      <geom type="cylinder" size="0.048 0.021" pos="0 0.04305 0" euler="1.5708 0 0" rgba=".25 .27 .3 1"/>
      <body name="RL_thigh" pos="0 0.0861 0">
        <inertial pos="-0.0217236 -0.0230994 -0.0217298" mass="1.2364" fullinertia="0.00385944 0.00630067 0.00384046 0.00057176 -0.00248864 0.000543511"/>
        <joint name="RL_hfe" axis="0 1 0" range="-1.9 1.9" armature="0.008014" frictionloss="0.15" damping="0.05"/>
        <geom class="hit" type="capsule" fromto="0 0 0 -0.13775 0 -0.145" size="0.032" rgba=".85 .87 .9 1"/>
        <body name="RL_shank" pos="-0.13775 0 -0.145">
          <inertial pos="0.0534632 5.68434e-17 -0.0438956" mass="0.062562" fullinertia="9.82372e-05 0.000235027 0.000140383 1.33637e-19 0.000109783 1.24696e-19"/>
          <joint name="RL_kfe" axis="0 1 0" range="-1.6 1.6" armature="0.01803" frictionloss="0.22499999999999998" damping="0.05"/>
          <geom class="hit" type="capsule" fromto="0 0 0 0.117087 0 -0.095933" size="0.016" rgba=".3 .32 .35 1"/>
          <geom name="RL_foot" class="foot" type="sphere" pos="0.13775 0 -0.112862" size="0.018" rgba=".1 .1 .1 1"/>
          <site name="RL_foot" pos="0.13775 0 -0.112862" size="0.005"/>
        </body>
      </body>
    </body>
    <body name="RR_haa_motor" pos="-0.16 -0.07 0"><inertial pos="0.0853314 1.42109e-17 0" mass="0.53" fullinertia="0.000591313 0.000362666 0.000362666 -1.35943e-18 0 1.81257e-18"/></body>
    <body name="RR_hip" pos="-0.16 -0.07 0">
      <inertial pos="0.00577337 0.00430311 -2.84217e-16" mass="0.78128" fullinertia="0.000759253 0.00137073 0.000903703 3.17386e-05 2.10511e-17 1.64926e-17"/>
      <joint name="RR_haa" axis="1 0 0" range="-0.45 0.45" armature="0.008014" frictionloss="0.15" damping="0.05"/>
      <geom type="cylinder" size="0.048 0.021" pos="0 -0.04305 0" euler="1.5708 0 0" rgba=".25 .27 .3 1"/>
      <body name="RR_thigh" pos="0 -0.0861 0">
        <inertial pos="-0.0217236 0.0230994 -0.0217298" mass="1.2364" fullinertia="0.00385944 0.00630067 0.00384046 -0.00057176 -0.00248864 -0.000543511"/>
        <joint name="RR_hfe" axis="0 1 0" range="-1.9 1.9" armature="0.008014" frictionloss="0.15" damping="0.05"/>
        <geom class="hit" type="capsule" fromto="0 0 0 -0.13775 0 -0.145" size="0.032" rgba=".85 .87 .9 1"/>
        <body name="RR_shank" pos="-0.13775 0 -0.145">
          <inertial pos="0.0534632 -5.68434e-17 -0.0438956" mass="0.062562" fullinertia="9.82372e-05 0.000235027 0.000140383 -1.33637e-19 0.000109783 -1.24696e-19"/>
          <joint name="RR_kfe" axis="0 1 0" range="-1.6 1.6" armature="0.01803" frictionloss="0.22499999999999998" damping="0.05"/>
          <geom class="hit" type="capsule" fromto="0 0 0 0.117087 0 -0.095933" size="0.016" rgba=".3 .32 .35 1"/>
          <geom name="RR_foot" class="foot" type="sphere" pos="0.13775 0 -0.112862" size="0.018" rgba=".1 .1 .1 1"/>
          <site name="RR_foot" pos="0.13775 0 -0.112862" size="0.005"/>
        </body>
      </body>
    </body>
    </body>
  </worldbody>
  <actuator>
        <motor name="FL_haa" joint="FL_haa" gear="1" ctrlrange="-23.7 23.7" ctrllimited="true"/>
    <motor name="FL_hfe" joint="FL_hfe" gear="1" ctrlrange="-23.7 23.7" ctrllimited="true"/>
    <motor name="FL_kfe" joint="FL_kfe" gear="1.5" ctrlrange="-23.7 23.7" ctrllimited="true"/>
    <motor name="FR_haa" joint="FR_haa" gear="1" ctrlrange="-23.7 23.7" ctrllimited="true"/>
    <motor name="FR_hfe" joint="FR_hfe" gear="1" ctrlrange="-23.7 23.7" ctrllimited="true"/>
    <motor name="FR_kfe" joint="FR_kfe" gear="1.5" ctrlrange="-23.7 23.7" ctrllimited="true"/>
    <motor name="RL_haa" joint="RL_haa" gear="1" ctrlrange="-23.7 23.7" ctrllimited="true"/>
    <motor name="RL_hfe" joint="RL_hfe" gear="1" ctrlrange="-23.7 23.7" ctrllimited="true"/>
    <motor name="RL_kfe" joint="RL_kfe" gear="1.5" ctrlrange="-23.7 23.7" ctrllimited="true"/>
    <motor name="RR_haa" joint="RR_haa" gear="1" ctrlrange="-23.7 23.7" ctrllimited="true"/>
    <motor name="RR_hfe" joint="RR_hfe" gear="1" ctrlrange="-23.7 23.7" ctrllimited="true"/>
    <motor name="RR_kfe" joint="RR_kfe" gear="1.5" ctrlrange="-23.7 23.7" ctrllimited="true"/>
  </actuator>
  <sensor>
    <framequat name="quat" objtype="site" objname="imu"/>
    <gyro name="gyro" site="imu"/>
        <touch name="FL_touch" site="FL_foot"/>
    <touch name="FR_touch" site="FR_foot"/>
    <touch name="RL_touch" site="RL_foot"/>
    <touch name="RR_touch" site="RR_foot"/>
  </sensor>
</mujoco>
