whois169/roboot007v/docs/机械狗007A/零件图.pdf

# 机械狗007A 零件图

## v19 省钱版（SteadyWin GIM8108-8） 由 007a/drawings.py 生成

A01–A07 | 机身铝板（激光切割，6061-T6）
L01 | 大腿外板（激光切割）
L02 / L03 | 大腿杯 + 内板、髋座（CNC）
L04 / L05 | 转接盘 + 轴、膝轴（车削，45 钢）
L09 | 小腿根（铝 CNC，24 齿带轮 + 舌头）
H01 / H02 | 头支架（5052 铝板 3 折弯）
C01 | 电子托板（亚克力 3）
打印件 | 见 打印件清单.md（STL 在 007a/out/print/）

工厂加工用 007a/out/mfg/ 里的 DXF（激光切割）/ STEP（CNC、车削、折弯）。这份图是核对、沟通用的。 ★ = 到货或拿到卖家 STEP 后要核对的尺寸。未注公差按 GB/T 1804-m；铝件去毛刺；CNC 件阳极氧化深灰。

## A01 A01底板 厚 3.0 ×1 （孔位图：原点 = 左下角红点，单位 mm）

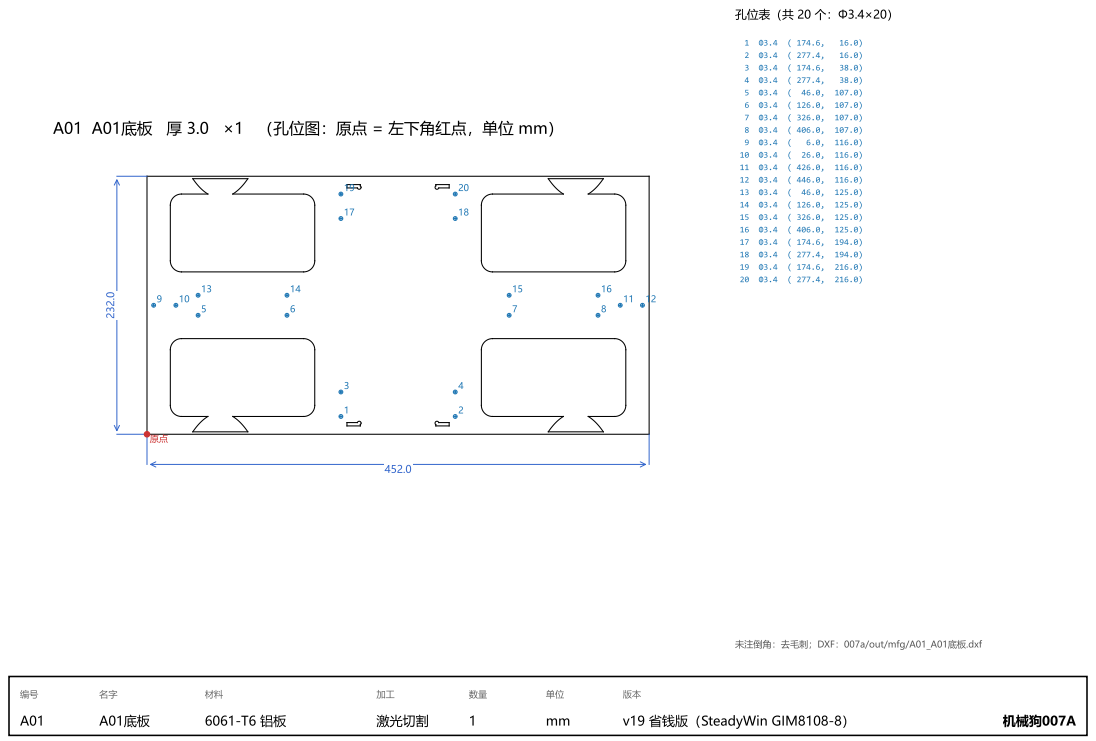
[picture p165: page 2]
孔位表（共 20 个：Φ3.4×20）; 激光切割; v19 省钱版（SteadyWin GIM8108-8）; 机械狗007A

未注倒角：去毛刺；DXF：007a/out/mfg/A01_A01底板.dxf

## A02 A02外摆隔板前 厚 5.0 ×2 （孔位图：原点 = 左下角红点，单位 mm孔位表（共 ） 33 个：Φ64×2 Φ3.9×16 Φ3.4×15）

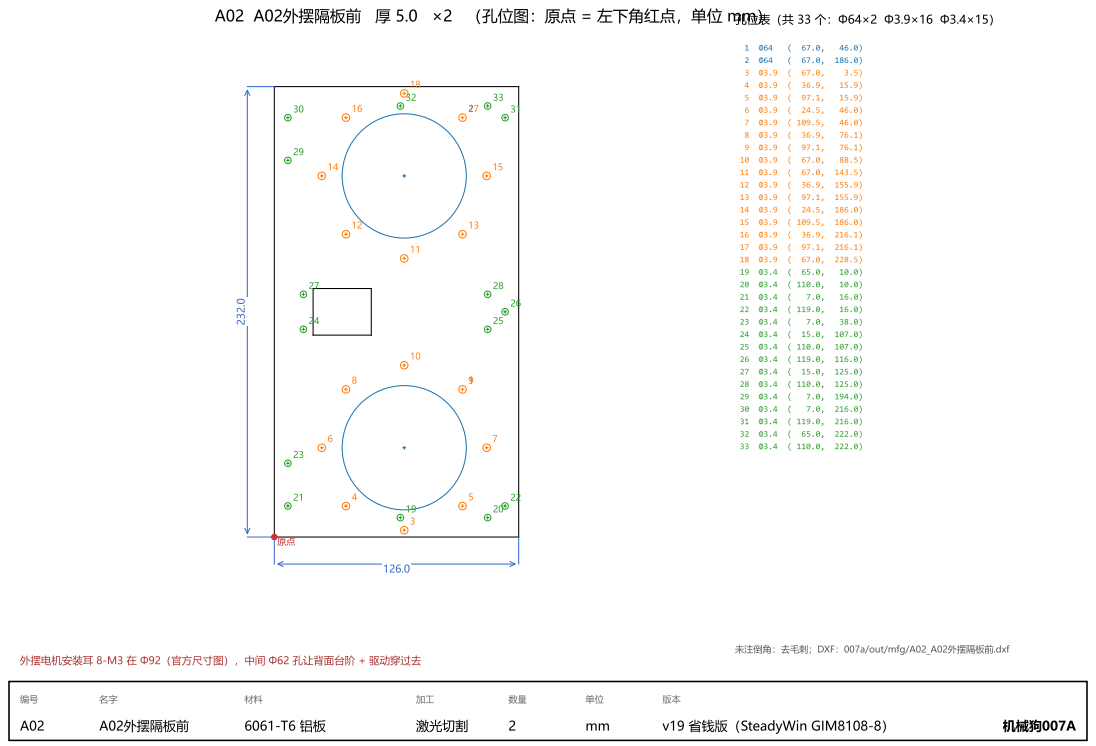
[picture p166: page 3]
A02外摆隔板前

未注倒角：去毛刺；DXF：007a/out/mfg/A02_A02外摆隔板前.dxf

外摆电机安装耳 8-M3 在 Φ92（官方尺寸图），中间 Φ62 孔让背面台阶 + 驱动穿过去

A03 A03侧梁左 厚 3.0 ×2 （孔位图：原点 = 左下角红点，单位 mm） | 孔位表（共 6 个：Φ3.4×6）
1 Φ3.4 ( | 7.0, | 16.0)
2 Φ3.4 ( 109.9, | 16.0)
3 Φ3.4 ( | 7.0, | 61.0)
4 Φ3.4 ( 109.9, | 61.0)
5 Φ3.4 ( 23.5, 119.0)
6 Φ3.4 ( 93.5, 119.0)

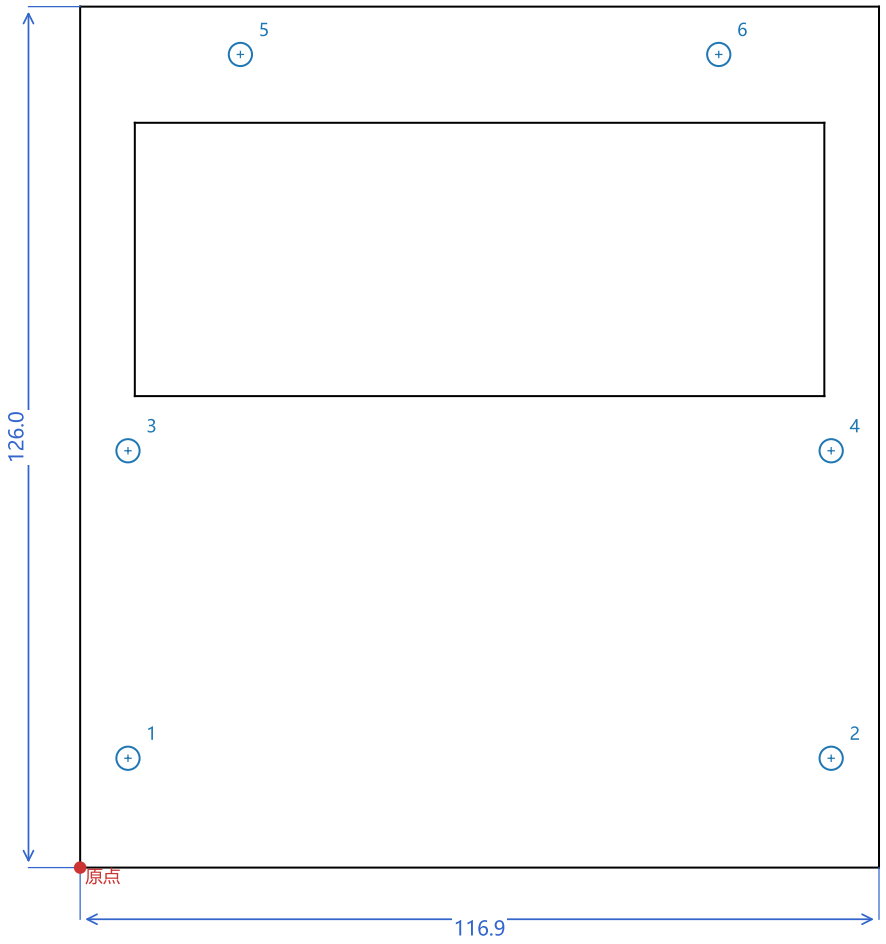
[picture p167: figure]

A03侧梁左

未注倒角：去毛刺；DXF：007a/out/mfg/A03_A03侧梁左.dxf

## A04 A04纵梁前左 厚 4.0 ×4 （孔位图：原点 = 左下角红点，单位 mm）

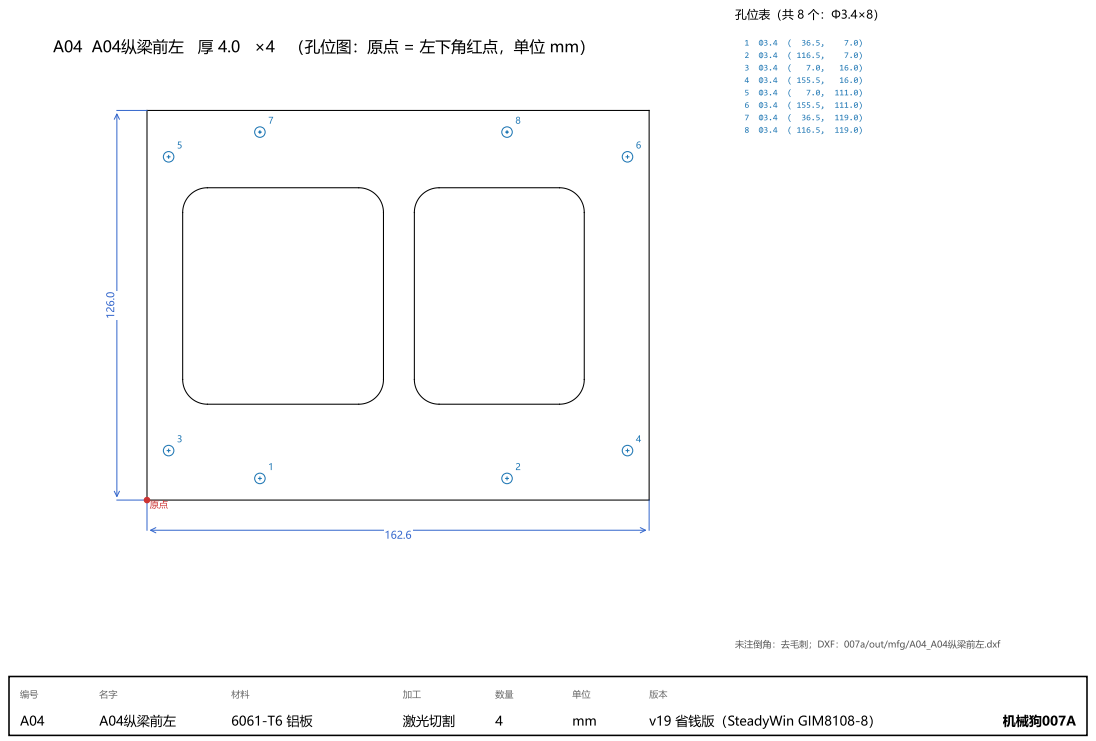
[picture p168: page 5]
孔位表（共 8 个：Φ3.4×8）; A04纵梁前左

未注倒角：去毛刺；DXF：007a/out/mfg/A04_A04纵梁前左.dxf

## A05 A05前端板 厚 4.0 ×1 （孔位图：原点 = 左下角红点，单位 mm）孔位表（共 9 个：Φ3.4×9）

1 Φ3.4 ( 82.0, | 37.0)
2 Φ3.4 ( 94.0, | 37.0)
3 Φ3.4 ( 19.0, | 47.0)
4 Φ3.4 ( 35.0, | 47.0)
5 Φ3.4 ( | 6.0, 113.0)
6 Φ3.4 ( 82.0, 153.0)
7 Φ3.4 ( 94.0, 153.0)
8 Φ3.4 ( 19.0, 179.0)
9 Φ3.4 ( 35.0, 179.0)

A05前端板

未注倒角：去毛刺；DXF：007a/out/mfg/A05_A05前端板.dxf

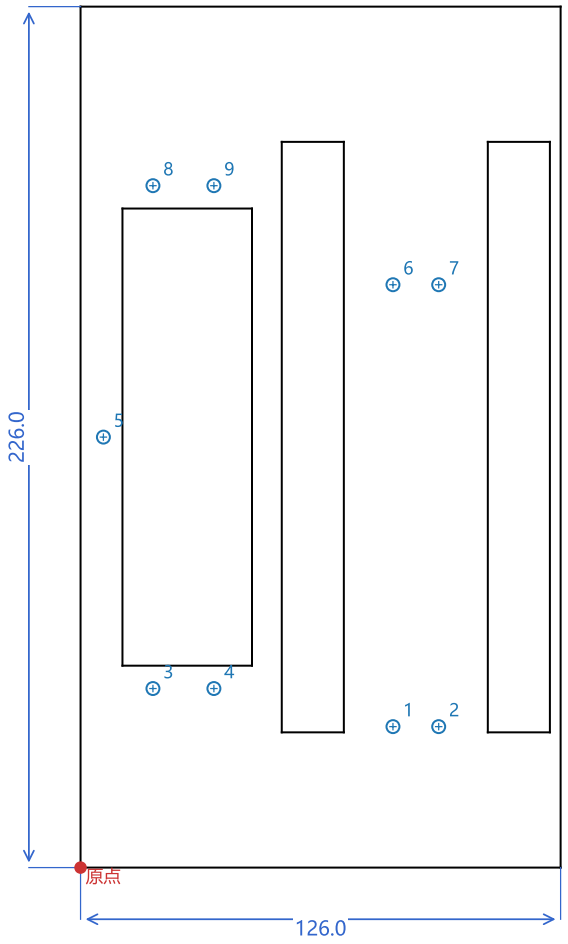
[picture p169: figure]

头弧形滑道：两条同心弧形槽（R29–41.5），中间横梁拧头支架

## A06 A06后端板 厚 4.0 ×1 （孔位图：原点 = 左下角红点，单位 mm）孔位表（共 8 个：Φ3.4×8）

1 Φ3.4 ( 73.0, | 50.0)
2 Φ3.4 ( 103.0, | 50.0)
3 Φ3.4 ( 15.0, 104.0)
4 Φ3.4 ( 6.0, 113.0)
5 Φ3.4 ( 120.0, 113.0)
6 Φ3.4 ( 15.0, 122.0)
7 Φ3.4 ( 73.0, 176.0)
8 Φ3.4 ( 103.0, 176.0)

A06后端板

未注倒角：去毛刺；DXF：007a/out/mfg/A06_A06后端板.dxf

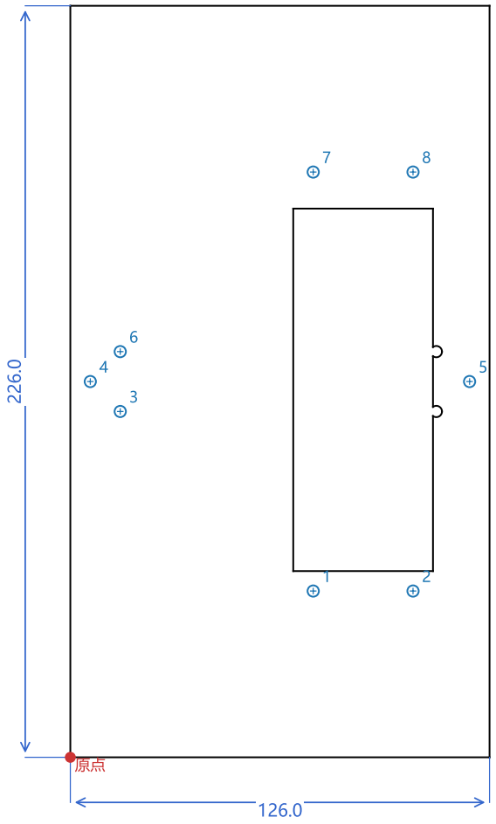
[picture p170: figure]

## A07 A07顶板 厚 3.0 ×1 （孔位图：原点 = 左下角红点，单位 mm）

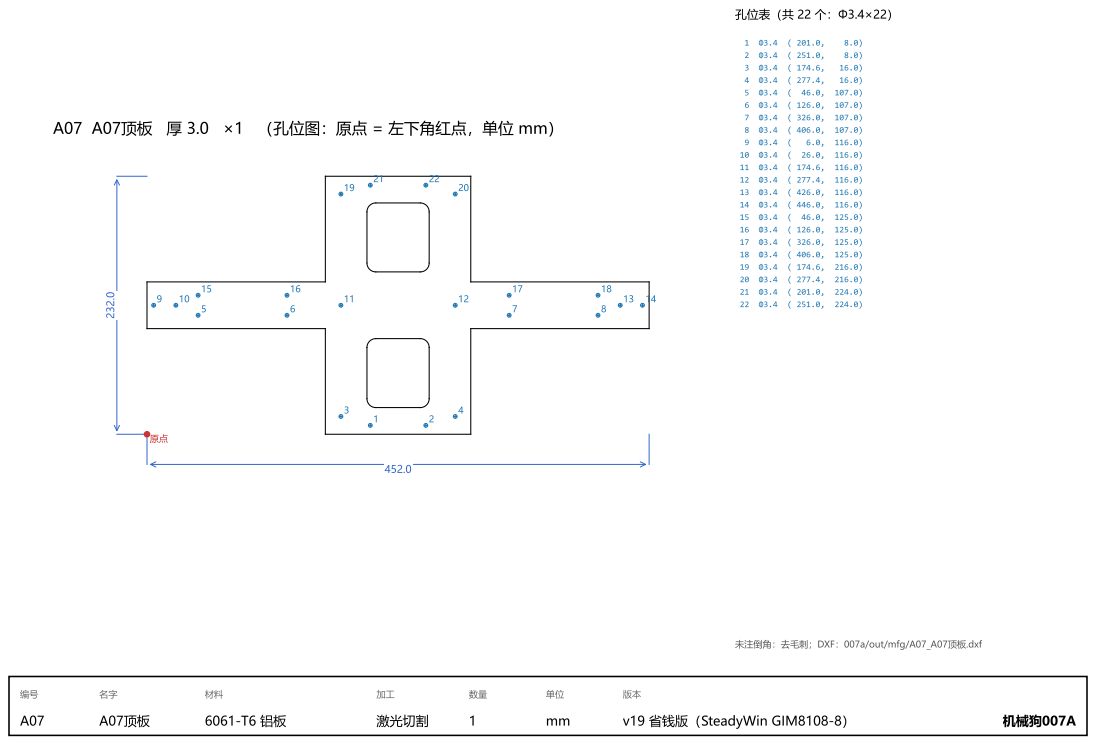
[picture p171: page 8]
孔位表（共 22 个：Φ3.4×22）

未注倒角：去毛刺；DXF：007a/out/mfg/A07_A07顶板.dxf

L01 大腿外板 厚 4.0 ×4 （孔位图：原点 = 左下角红点，单位 mm） | 孔位表（共 2 个：Φ21×1 Φ12.2×1）

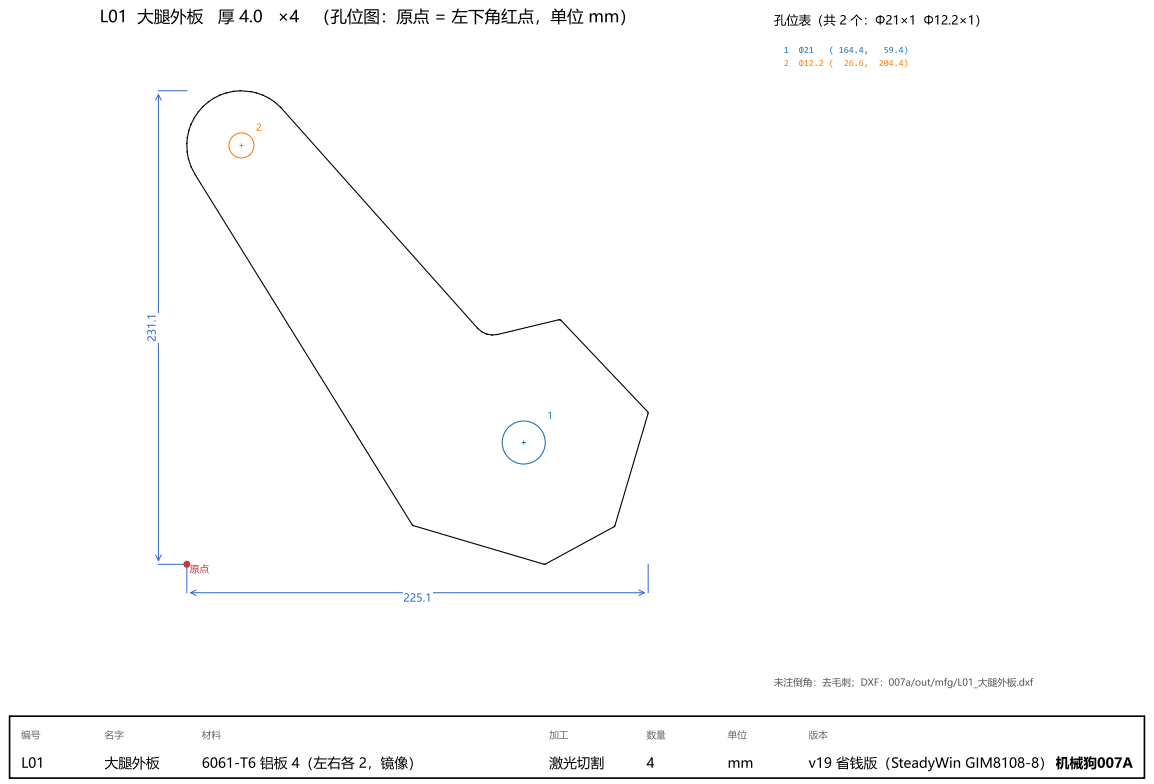
[picture p172: page 9]
大腿外板

未注倒角：去毛刺；DXF：007a/out/mfg/L01_大腿外板.dxf

6061-T6 铝板 4（左右各 2，镜像）

## L02 大腿杯和内板 外形 216.7 × 46.3 × 223.9 ×4

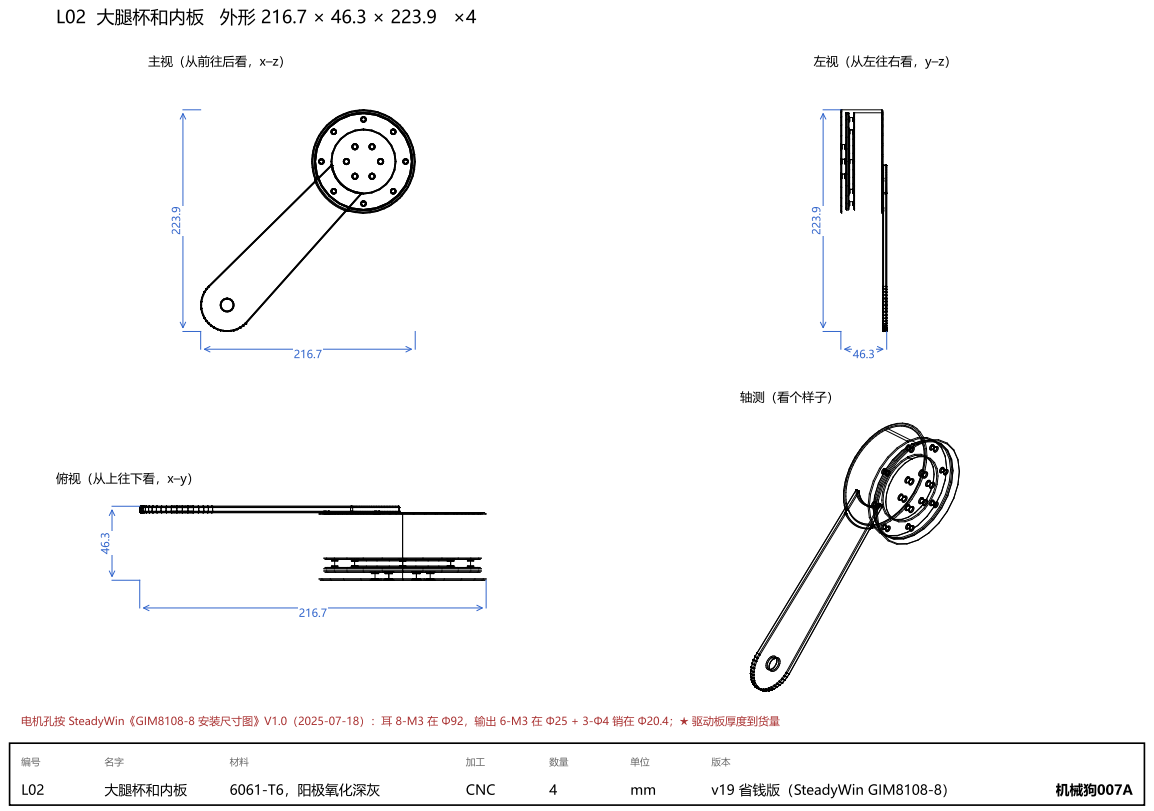
[picture p173: page 10]
主视（从前往后看，x–z）; 俯视（从上往下看，x–y）; 左视（从左往右看，y–z）; 轴测（看个样子）; 大腿杯和内板; 6061-T6，阳极氧化深灰; CNC

电机孔按 SteadyWin《GIM8108-8 安装尺寸图》V1.0（2025-07-18）：耳 8-M3 在 Φ92，输出 6-M3 在 Φ25 + 3-Φ4 销在 Φ20.4；★ 驱动板厚度到货量

## L03 髋座 外形 124.5 × 46.3 × 110.0 ×4

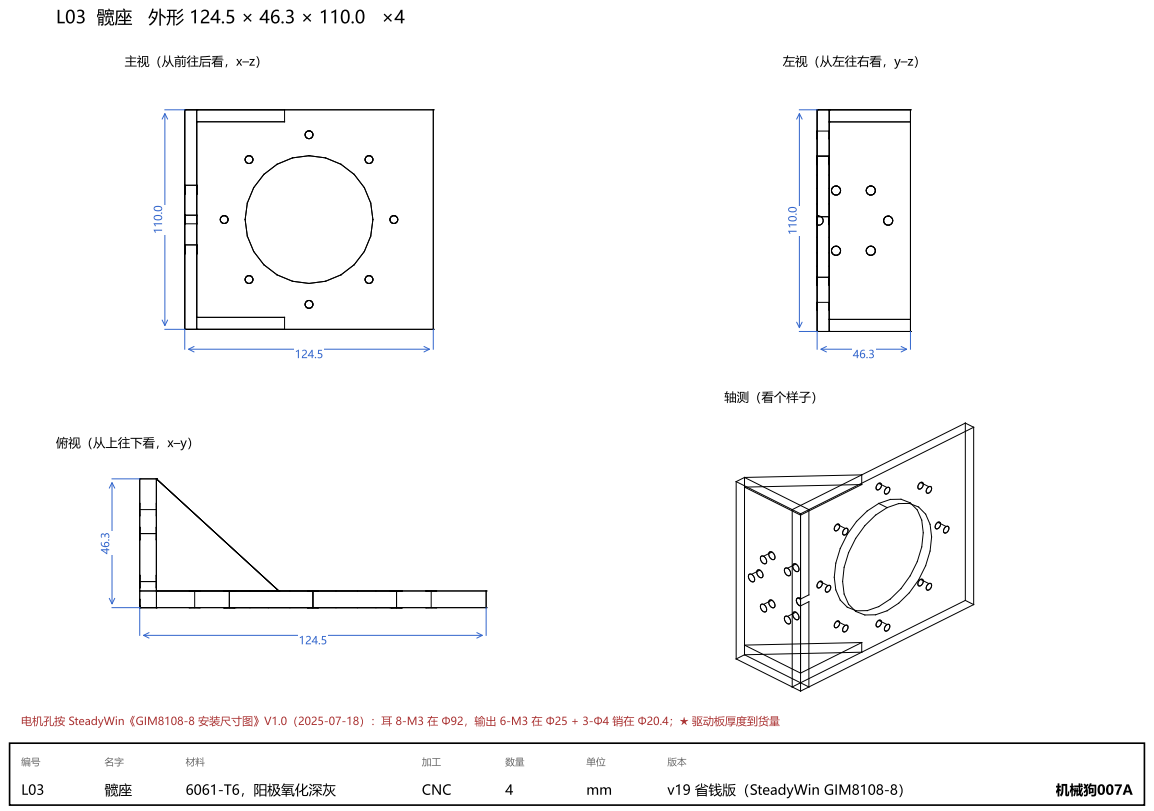
[picture p174: page 11]
主视（从前往后看，x–z）; 俯视（从上往下看，x–y）; 左视（从左往右看，y–z）; 轴测（看个样子）; 6061-T6，阳极氧化深灰; CNC

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

## L04 转接盘和轴 外形 59.0 × 33.0 × 59.0 ×4

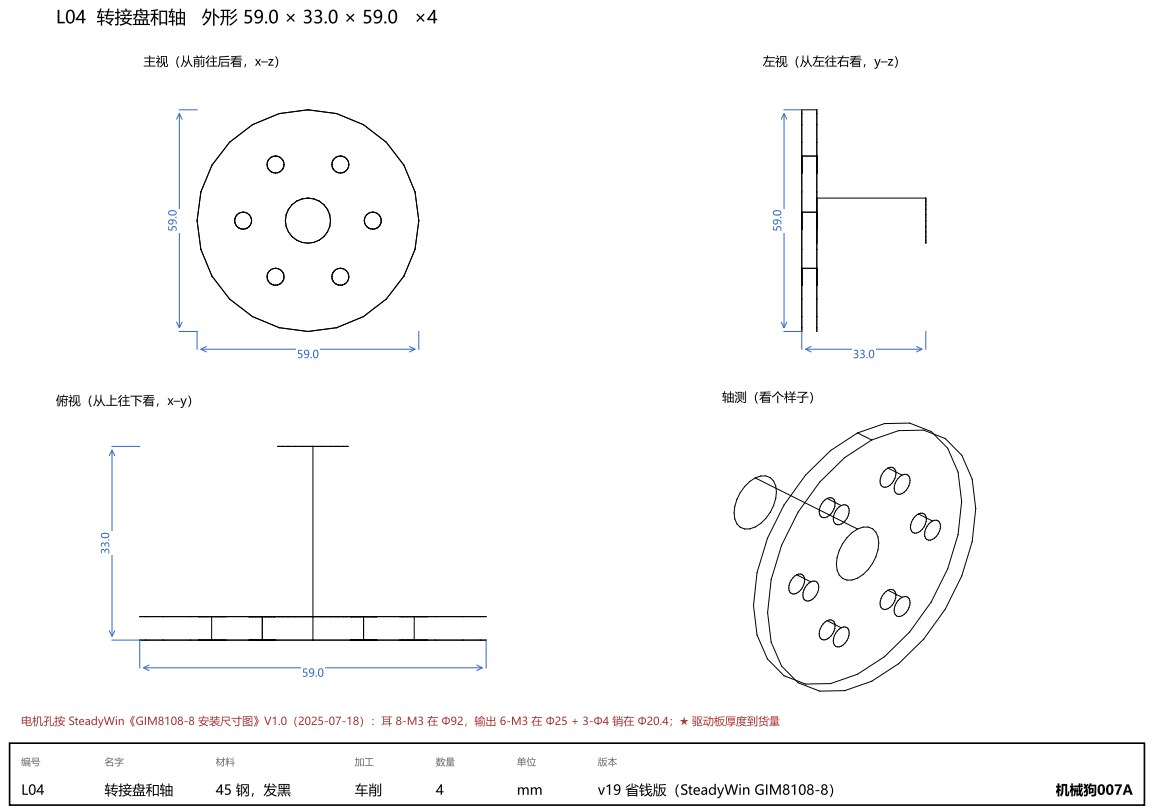
[picture p175: page 12]
主视（从前往后看，x–z）; 俯视（从上往下看，x–y）; 左视（从左往右看，y–z）; 轴测（看个样子）; 转接盘和轴

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

主视（从前往后看，x–z）

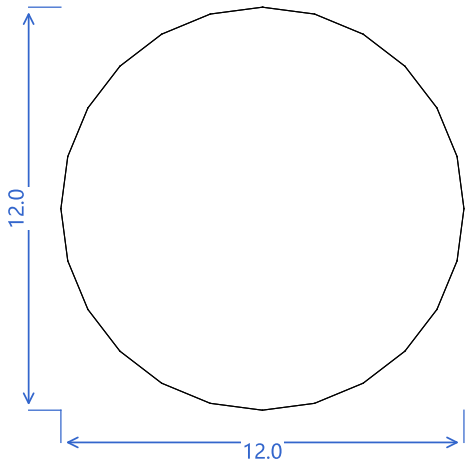
[picture p176: figure]
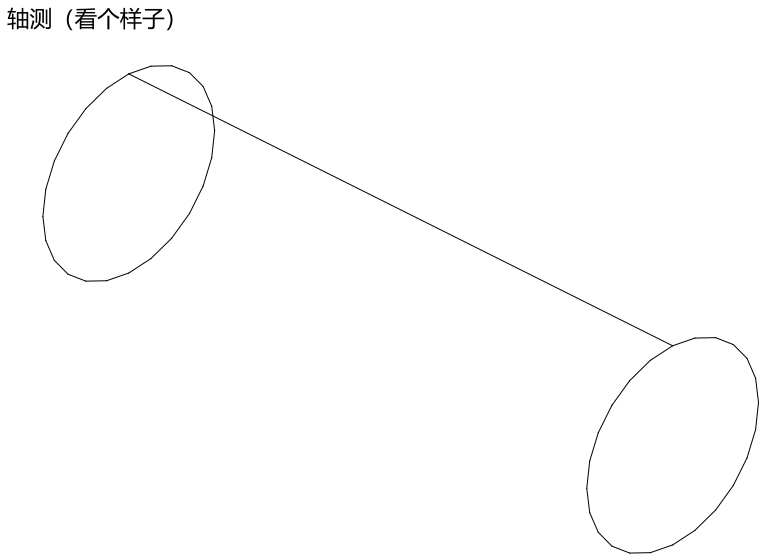
[picture p177: figure]
轴测（看个样子）

12.0

38.0

俯视（从上往下看，x–y）

38.0

12.0

左视（从左往右看，y–z）

L05

膝轴
45 钢，发黑，两头攻 M5 × 10

车削

## L05 膝轴 外形 12.0 × 38.0 × 12.0 ×4

## L09 小腿根 外形 71.3 × 23.0 × 66.8 ×4

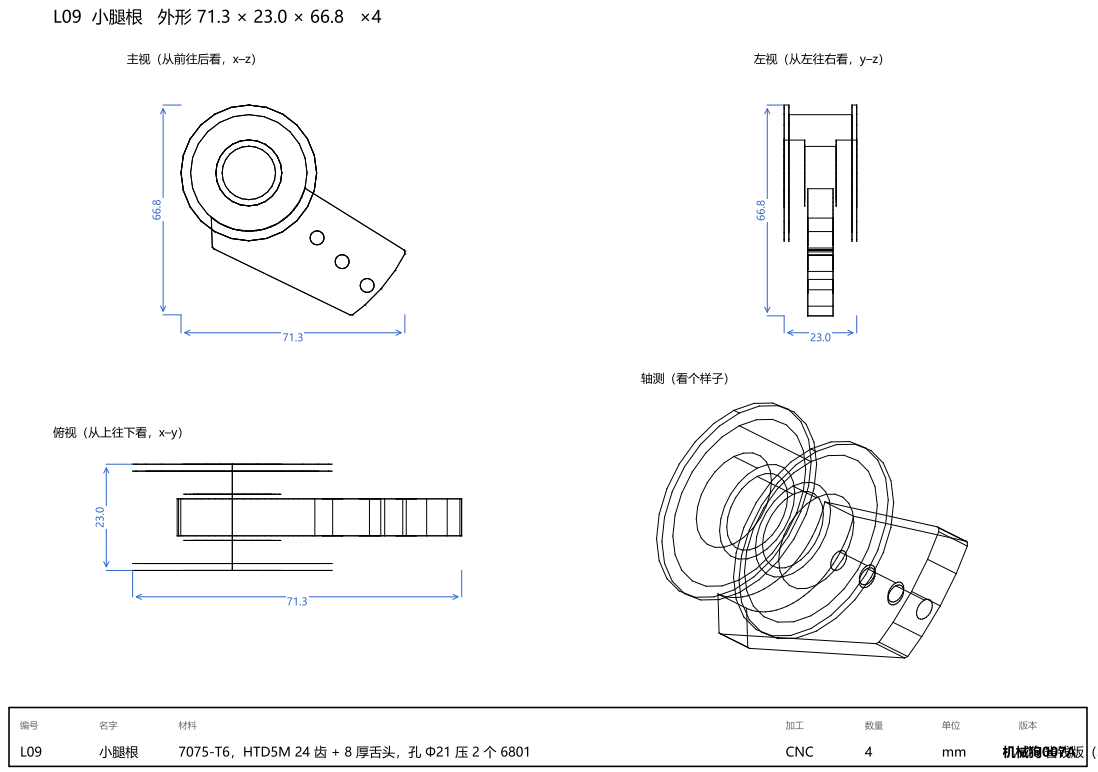
[picture p178: page 14]
主视（从前往后看，x–z）; 俯视（从上往下看，x–y）; 左视（从左往右看，y–z）; 轴测（看个样子）; 小腿根; 7075-T6，HTD5M 24 齿 + 8 厚舌头，孔 Φ21 压 2 个 6801; CNC; 机械狗v19 007A 省钱版（SteadyWin GIM8108-8）

## H01 头支架左 外形 24.0 × 17.0 × 24.0 ×1

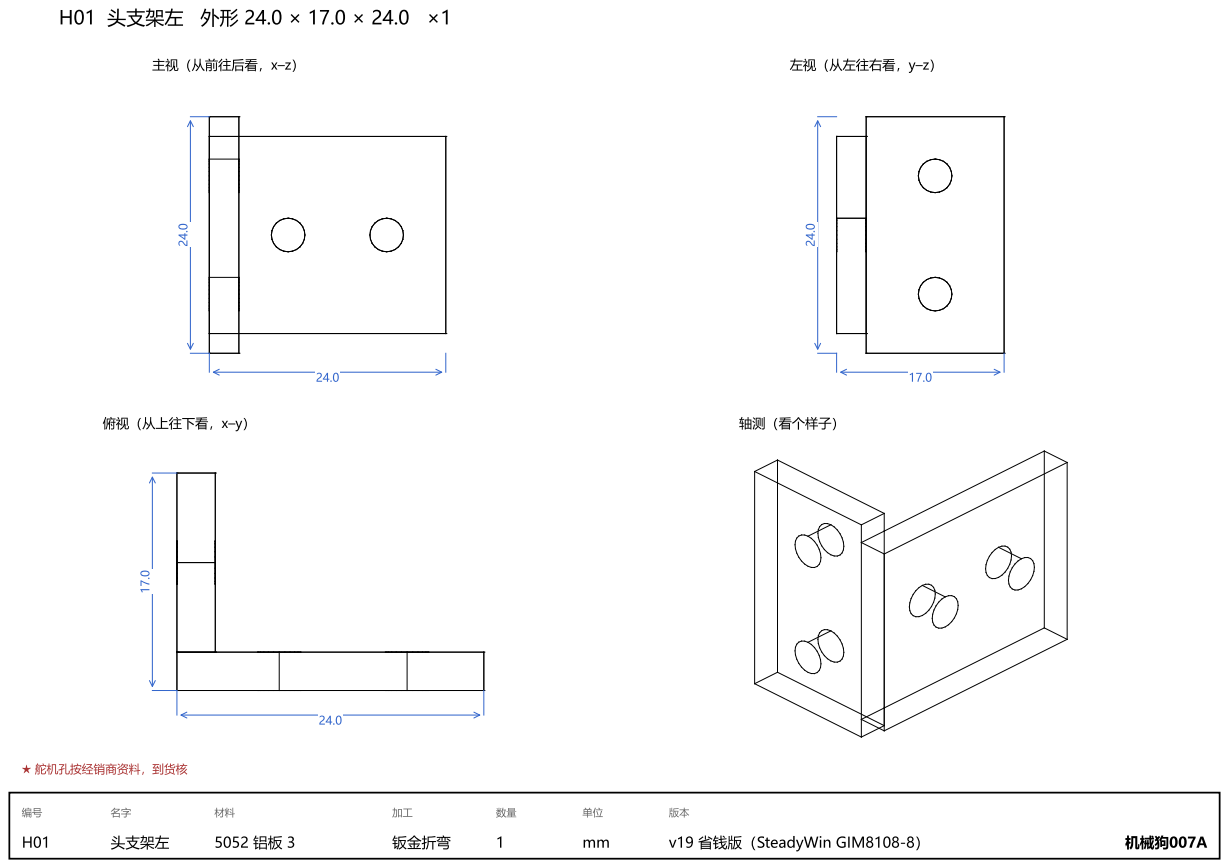
[picture p179: page 15]
主视（从前往后看，x–z）; 俯视（从上往下看，x–y）; 左视（从左往右看，y–z）; 轴测（看个样子）; 头支架左; 钣金折弯; ★ 舵机孔按经销商资料，到货核

## H02 头支架右 外形 24.0 × 17.0 × 24.0 ×1

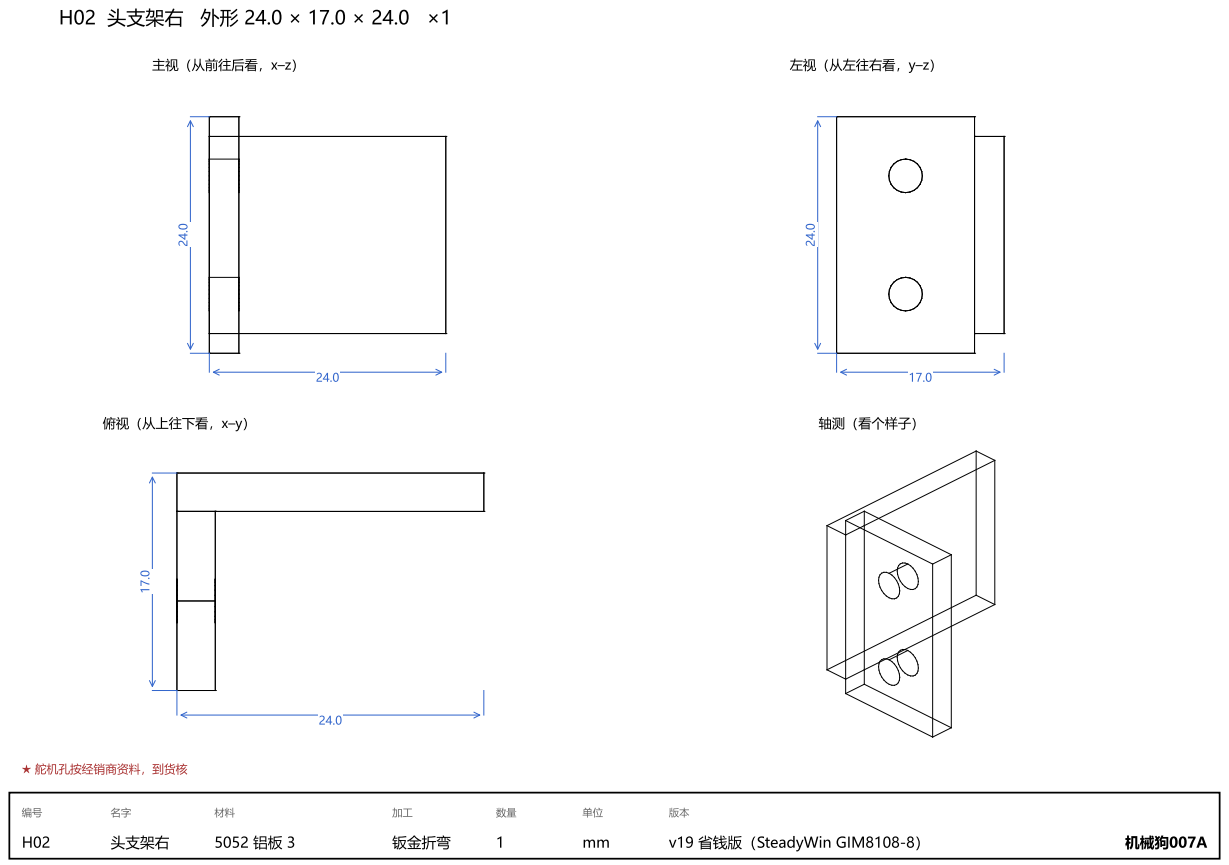
[picture p180: page 16]
主视（从前往后看，x–z）; 俯视（从上往下看，x–y）; 左视（从左往右看，y–z）; 轴测（看个样子）; 头支架右; 钣金折弯; ★ 舵机孔按经销商资料，到货核

## C01 电子托板 厚 3.0 ×1 （孔位图：原点 = 左下角红点，单位 mm）孔位表（共 14 个：Φ2.7×9 Φ2.6×5）

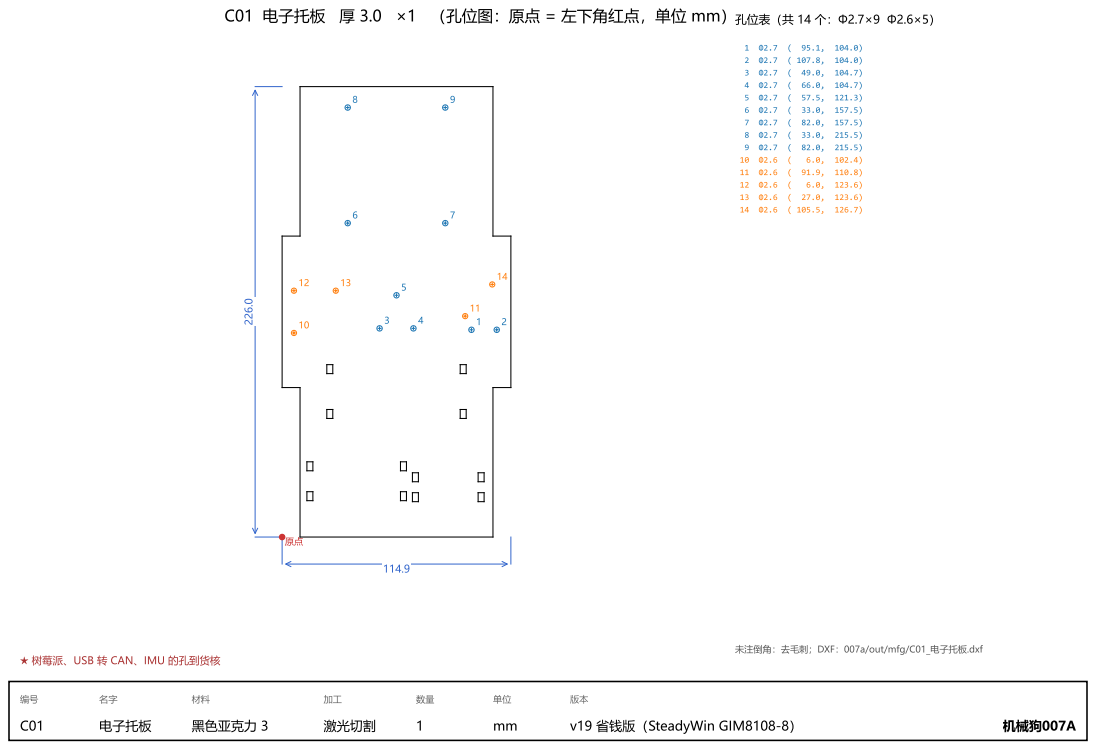
[picture p181: page 17]
电子托板; 黑色亚克力 3

未注倒角：去毛刺；DXF：007a/out/mfg/C01_电子托板.dxf

★ 树莓派、USB 转 CAN、IMU 的孔到货核
