whois169/roboot007v/007v/ref/gim4310/gds_2d.pdf

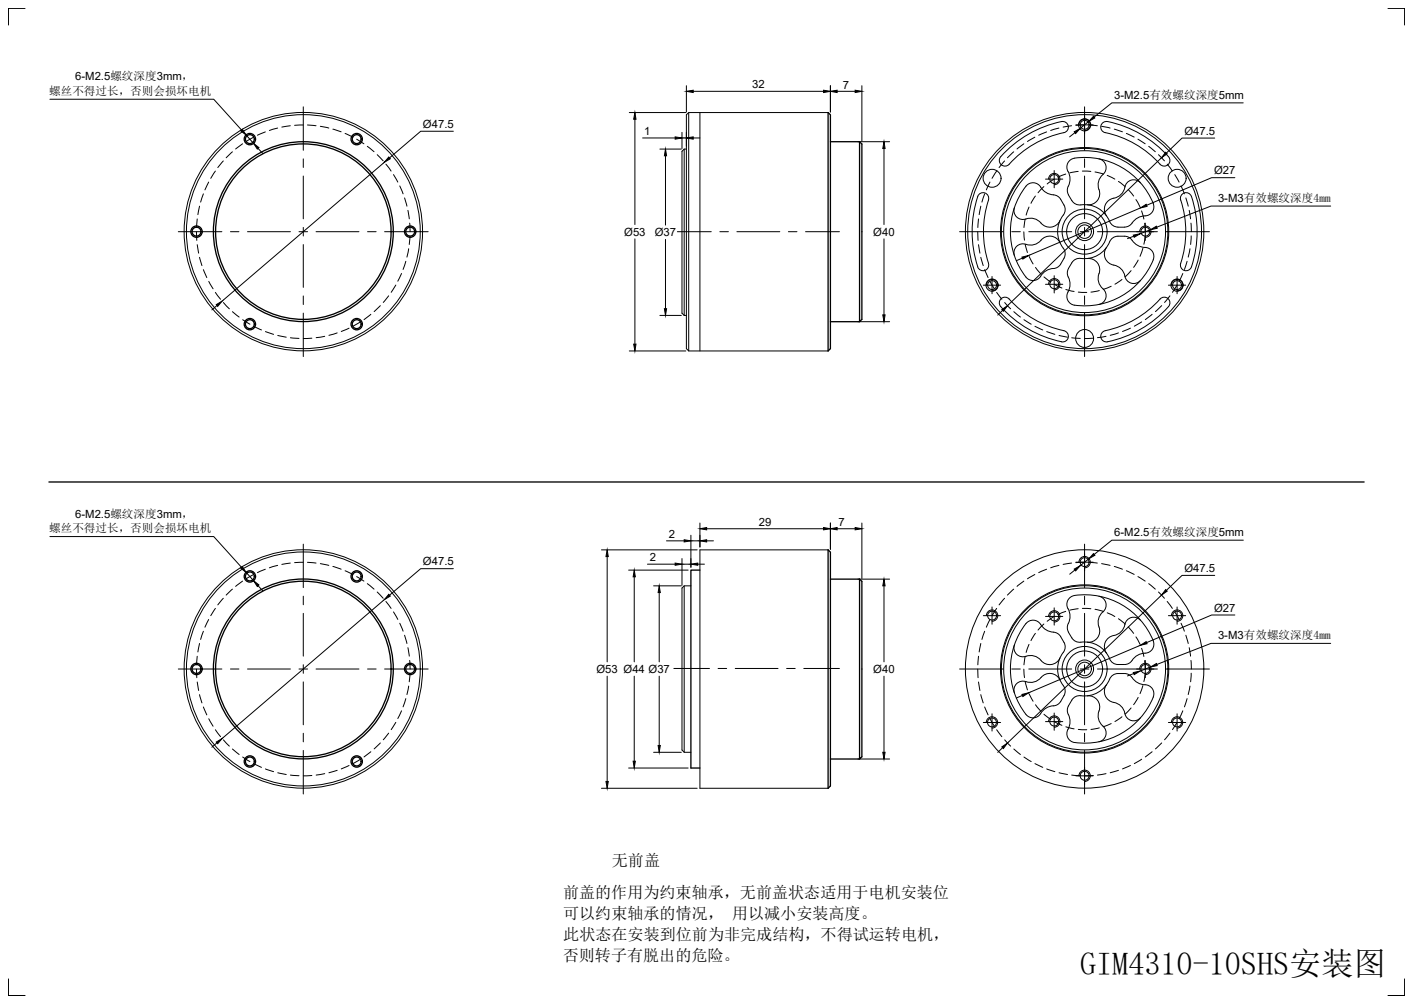
[picture p182: page 1]
可以约束轴承的情况， 用以减小安装高度。
