whois169/roboot007v/007v/ref/gim4310/gdz_2d.pdf

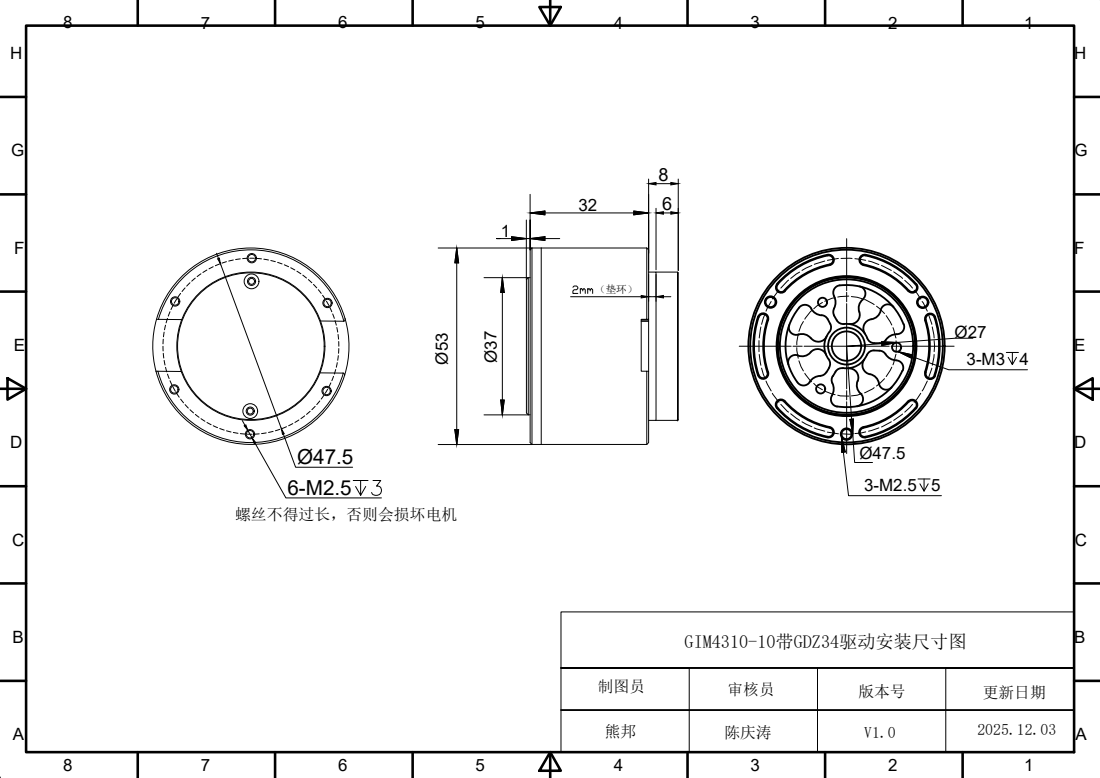
[picture p183: page 1]
G FEDC; CDEF B; 1 制图员; 审核员; 版本号 V1.0; 更新日期 熊邦; 陈庆涛

Ø37 Ø47.5 6-M2.5 螺丝不得过长，否则会损坏电机 6 GIM4310-10带GDZ34驱动安装尺寸图 （垫环） 8
