whois169/roboot007v/007v/wiring.py

"""机械狗007v 接线图（SVG）+ 底盘 ESP32-S3 建议引脚表，给图纸网页和 docs/机械狗007v/接线图.md 用。

用法：python 007v/wiring.py
"""
import json
import os

HERE = os.path.dirname(os.path.abspath(__file__))
ROOT = os.path.dirname(HERE)
OUT = os.path.join(HERE, "out", "mfg")

COL = dict(p24="#e0533d", p24m="#f08a24", p5="#d4b62c", p12="#c0843a", can="#3fb37f", usb="#3d8fe0", sig="#a46be0", i2c="#3fc9d6")
LEGEND = [("p24", "24V 总电源"), ("p24m", "24V 电机电源（急停能断）"), ("p5", "5V"), ("p12", "12V"),
          ("can", "CAN 总线"), ("usb", "USB"), ("sig", "PWM / 编码器 / 开关信号"), ("i2c", "I2C")]

BOXES = []
WIRES = []


def box(key, x, y, w, h, title, sub="", kind="dev"):
    BOXES.append(dict(key=key, x=x, y=y, w=w, h=h, title=title, sub=sub, kind=kind))


def wire(col, pts, label="", lx=None, ly=None, anchor="start"):
    WIRES.append(dict(col=col, pts=pts, label=label, lx=lx, ly=ly, anchor=anchor))


# ---------------------------------------------------------------- 电源
box("bat", 20, 30, 210, 62, "6S2P 21700 电池", "22.2V 10Ah · 30A 均衡保护板", "pwr")
box("chg", 20, 108, 100, 40, "充电口 XT60", "后板", "pwr")
box("fuse", 20, 168, 210, 40, "主保险 30A", "", "pwr")
box("k1", 20, 228, 210, 56, "总电源继电器 K1（40A）", "线圈 ← 总开关 Φ16（后板）", "pwr")
box("k2", 270, 228, 220, 56, "电机继电器 K2（40A）", "线圈 ← 串急停按钮常闭触点", "pwr")
box("estop", 270, 140, 220, 52, "急停按钮 Φ22（后板）", "常闭断 K2；常开 → ESP32 检测", "pwr")
box("ina", 270, 30, 220, 52, "INA226 电池电压 / 电流", "分流电阻串在电池负极", "pwr")
box("fb", 270, 320, 220, 130, "保险丝盒（6 路）", "", "pwr")
box("d5a", 20, 330, 210, 50, "DC-DC 5V 5.5A", "Pololu D36V50F5", "pwr")
box("d3a", 20, 400, 210, 50, "DC-DC 5V 3.2A", "Pololu D36V28F5", "pwr")
box("d12", 20, 470, 210, 50, "DC-DC 12V 3A", "24V → 12V", "pwr")

# ---------------------------------------------------------------- 主控
box("pi", 560, 300, 230, 118, "树莓派 5（大脑）", "USB ×4 · 5V 从 GPIO 5V 脚进（usb_max_current_enable=1）", "ctl")
box("esp", 560, 520, 230, 170, "底盘 ESP32-S3-DevKitC-1", "CAN → 4 个轮子\nPWM ×8 → 4 个髋驱动\n编码器 ×8、电流 ×4\nI2C → AS5600 ×4、VL53L1X ×4、INA226\n急停检测", "ctl")
box("hub", 560, 60, 230, 62, "头部 USB 集线器", "4 口，外部 5V 供电", "ctl")

# ---------------------------------------------------------------- 设备
box("lcd", 860, 20, 300, 50, "屏幕板 ESP32-S3-Touch-LCD-4.3B", "HUD 显示屏 + 触摸屏（点屏幕 = 叫醒 / 打断）")
box("hesp", 860, 82, 300, 74, "头部传感器 ESP32-S3（旧的那块）", "麦克风 ×2、功放、测距、毫米波、热成像、\n红外收发、光照、温湿度")
box("cam", 860, 168, 300, 40, "USB 相机（屏幕下方）")
box("servo", 860, 220, 300, 52, "俯仰舵机 STS3215 + 总线转接板", "12V；串口接头部传感器 ESP32")
box("lidar", 860, 300, 300, 46, "激光雷达 LD19（USB 转接板）", "5V")
box("depth", 860, 358, 300, 40, "深度相机（以后，USB3）")
box("wheel", 860, 430, 300, 64, "轮子电机 GIM4310-10 ×4", "24V + CAN 菊花链：前左→前右→后右→后左，\n最后一个电机接 120Ω 终端")
box("bts", 860, 520, 300, 64, "髋驱动 BTS7960 ×4", "RPWM / LPWM / 使能 / 电流 IS")
box("worm", 860, 604, 300, 52, "髋蜗轮电机 5840 ×4", "霍尔编码器 A/B → ESP32")
box("as", 860, 676, 300, 52, "AS5600 ×4 + VL53L1X ×4（经 TCA9548A 分路）", "AS5600 读腿角度；VL53L1X 在前保险杠、后格栅看台阶")

# ---------------------------------------------------------------- 连线
wire("p24", [(125, 92), (125, 168)])
wire("p24", [(70, 108), (70, 92)], "充电", 74, 104)
wire("p24", [(125, 208), (125, 228)])
wire("p24", [(230, 256), (270, 256)])
wire("p24", [(125, 284), (125, 305), (250, 305), (250, 385), (270, 385)], "24V 总线（不经过急停）", 132, 300)
wire("p24m", [(380, 284), (380, 320)], "24V 电机", 386, 306)
wire("p24m", [(490, 345), (830, 345), (830, 462), (860, 462)], "5A ×4", 760, 340)
wire("p24m", [(490, 370), (820, 370), (820, 552), (860, 552)], "10A ×2", 760, 365)
wire("p24", [(270, 400), (240, 400), (240, 355), (230, 355)], "5A", 244, 396)
wire("p24", [(270, 420), (245, 420), (245, 425), (230, 425)], "3A", 248, 417)
wire("p24", [(270, 440), (250, 440), (250, 495), (230, 495)], "3A", 252, 470)
wire("sig", [(380, 192), (380, 228)])
wire("sig", [(490, 166), (520, 166), (520, 660), (560, 660)], "急停常开", 524, 650)
wire("p5", [(230, 345), (530, 345), (530, 360), (560, 360)], "5V 5A → GPIO 5V 脚", 400, 340)
wire("p5", [(230, 425), (540, 425), (540, 100), (560, 100)], "5V → 集线器", 545, 140)
wire("p5", [(230, 435), (545, 435), (545, 540), (560, 540)], "5V", 549, 470)
wire("p12", [(230, 495), (250, 495), (250, 610), (840, 610), (840, 260), (860, 260)], "12V → 舵机", 700, 606)
wire("i2c", [(490, 56), (510, 56), (510, 600), (560, 600)], "I2C", 514, 230)
wire("usb", [(675, 300), (675, 122)], "USB", 680, 210)
wire("usb", [(790, 75), (830, 75), (830, 45), (860, 45)])
wire("usb", [(790, 90), (845, 90), (845, 118), (860, 118)])
wire("usb", [(790, 108), (850, 108), (850, 188), (860, 188)])
wire("usb", [(790, 330), (850, 330), (850, 323), (860, 323)], "USB", 800, 326)
wire("usb", [(790, 380), (860, 380)], "USB3", 800, 376)
wire("usb", [(700, 418), (700, 520)], "USB（串口）", 705, 470)
wire("sig", [(1010, 156), (1010, 220)], "串口", 1015, 192)
wire("can", [(790, 545), (812, 545), (812, 478), (860, 478)], "CAN H/L", 760, 540)
wire("sig", [(790, 570), (860, 570)], "PWM ×8、使能、IS ×4", 795, 594)
wire("sig", [(1160, 552), (1176, 552), (1176, 630), (1160, 630)], "电机线", 1110, 600)
wire("sig", [(860, 640), (810, 640), (810, 655), (790, 655)], "编码器 ×8", 800, 672)
wire("i2c", [(860, 702), (800, 702), (800, 680), (790, 680)], "I2C", 802, 716)

PINS = [
    ("CAN TX / RX", "GPIO 4 / 5", "接 Adafruit CAN Pal（TJA1051）"),
    ("I2C SDA / SCL", "GPIO 8 / 9", "TCA9548A（→ 4 个 AS5600 + 4 个 VL53L1X）、INA226"),
    ("前左髋 RPWM / LPWM", "GPIO 10 / 11", "LEDC 20 kHz"),
    ("前右髋 RPWM / LPWM", "GPIO 12 / 13", ""),
    ("后左髋 RPWM / LPWM", "GPIO 14 / 21", ""),
    ("后右髋 RPWM / LPWM", "GPIO 47 / 48", "v1.0 板的 48 接了彩灯，用 v1.1 板"),
    ("4 个驱动使能（R_EN、L_EN 并一起）", "GPIO 42", "上电默认低：电机不动"),
    ("电流 IS 前左 / 前右 / 后左 / 后右", "GPIO 1 / 2 / 6 / 7", "ADC1；每块驱动 R_IS、L_IS 各串 1k 并到一起"),
    ("编码器 前左 A / B", "GPIO 15 / 16", "PCNT"),
    ("编码器 前右 A / B", "GPIO 17 / 18", ""),
    ("编码器 后左 A / B", "GPIO 38 / 39", ""),
    ("编码器 后右 A / B", "GPIO 40 / 41", ""),
    ("急停检测（常开触点）", "GPIO 43", "不用 UART0 打日志，调试走 USB"),
    ("机身灯链（WS2812）", "GPIO 44", "经 5V 电平转换；腰线、尾灯、电机光环、前白灯串成一条（灯珠型号待定）"),
]


def svg():
    W, H = 1190, 750
    o = [f'<svg xmlns="http://www.w3.org/2000/svg" viewBox="0 0 {W} {H}" class="wiring">']
    for w in WIRES:
        c = COL[w["col"]]
        o.append(f'<polyline points="{" ".join(f"{x},{y}" for x, y in w["pts"])}" fill="none" stroke="{c}" stroke-width="2.4" stroke-linejoin="round"/>')
        x, y = w["pts"][-1]
        o.append(f'<circle cx="{x}" cy="{y}" r="3" fill="{c}"/>')
        if w["label"]:
            o.append(f'<text x="{w["lx"]}" y="{w["ly"]}" class="wl" fill="{c}">{w["label"]}</text>')
    for b in BOXES:
        o.append(f'<g class="bx {b["kind"]}"><rect x="{b["x"]}" y="{b["y"]}" width="{b["w"]}" height="{b["h"]}" rx="3"/>'
                 f'<text x="{b["x"] + 9}" y="{b["y"] + 19}" class="bt">{b["title"]}</text>')
        for i, line in enumerate(b["sub"].split("\n") if b["sub"] else []):
            o.append(f'<text x="{b["x"] + 9}" y="{b["y"] + 36 + i * 15}" class="bs">{line}</text>')
        o.append("</g>")
    # 保险丝盒内容
    for i, t in enumerate(["5A ×4 → 轮子电机（各一路）", "10A ×2 → 髋驱动（两块一路）", "5A → 5V 5.5A（树莓派）", "3A → 5V 3.2A", "3A → 12V（舵机）"]):
        o.append(f'<text x="282" y="{360 + i * 17}" class="bs">{t}</text>')
    lx = 20
    for k, t in LEGEND:
        o.append(f'<rect x="{lx}" y="{H - 26}" width="18" height="4" fill="{COL[k]}"/><text x="{lx + 24}" y="{H - 20}" class="lg">{t}</text>')
        lx += 24 + len(t) * 12 + 18
    o.append("</svg>")
    return "".join(o)


def write_md():
    L = ["# 机械狗007v 接线图", "", "> 由 `007v/wiring.py` 生成；图在“机械狗007v 图纸”网页的“接线图”页。引脚是建议值，写固件时再定。", "",
         "## 供电", "",
         "```",
         "电池 6S2P（22.2V）─ 主保险 30A ─ 总电源继电器 K1（总开关控制线圈）─┬─ 24V 总线（不经过急停）",
         "                                                                  │    ├─ 5A ─ DC-DC 5V 5.5A ─ 树莓派 5（GPIO 5V 脚）",
         "                                                                  │    ├─ 3A ─ DC-DC 5V 3.2A ─ 头部 USB 集线器、雷达、底盘 ESP32",
         "                                                                  │    └─ 3A ─ DC-DC 12V ─ 头部舵机",
         "                                                                  └─ 电机继电器 K2（线圈串急停常闭）─ 24V 电机电源",
         "                                                                       ├─ 5A ×4 ─ 轮子电机 ×4",
         "                                                                       └─ 10A ×2 ─ 髋驱动 BTS7960 ×4",
         "```", "",
         "- **急停只断电机，不断大脑**：按下急停，K2 断开，8 个电机全部断电（髋是蜗轮自锁，不会塌）；树莓派和 ESP32 照常工作，知道发生了急停。",
         "- 总开关和急停都只控制继电器线圈（几十毫安），大电流不走按钮。",
         "- INA226 的分流电阻串在电池负极，读电池电压、电流，算剩余电量。", "",
         "## 信号", "",
         "- 树莓派 5 USB：头部集线器（屏幕板、头部传感器 ESP32、相机）、底盘 ESP32、雷达、深度相机（以后）。",
         "- 底盘 ESP32 → CAN → 4 个轮子电机（菊花链：前左 → 前右 → 后右 → 后左，最后一个接 120Ω 终端）。",
         "- 底盘 ESP32 → PWM → 4 块 BTS7960 → 4 个髋蜗轮电机；电机霍尔编码器、驱动电流 IS 回到 ESP32。",
         "- 4 个 AS5600 地址一样（0x36），4 个 VL53L1X 也一样（0x29），一起经 TCA9548A 的 8 路接 ESP32 的 I2C。",
         "- 屏幕板只当显示屏：它的引脚几乎全被屏幕、触摸占了，所以头部传感器继续接旧的那块 ESP32-S3。", "",
         "## 底盘 ESP32-S3 建议引脚", "", "| 功能 | 引脚 | 说明 |", "|---|---|---|"]
    L += [f"| {a} | {b} | {c} |" for a, b, c in PINS]
    L += ["", "不用的脚：0、3、45、46（启动用）、19/20（USB）、26–37（N16R8 的闪存和内存占用）。"]
    path = os.path.join(ROOT, "docs", "机械狗007v", "接线图.md")
    with open(path, "w", encoding="utf-8") as f:
        f.write("\n".join(L) + "\n")
    return path


def main():
    os.makedirs(OUT, exist_ok=True)
    with open(os.path.join(OUT, "wiring.json"), "w", encoding="utf-8") as f:
        json.dump(dict(svg=svg(), pins=PINS), f, ensure_ascii=False)
    print(write_md())


if __name__ == "__main__":
    main()
