whois169/roboot007v/007v/config.py

"""机械狗007v骨架的全部关键尺寸。改尺寸只改这里，然后跑 python 007v/build.py。

坐标（和旧的四足一样）：X 向前、Y 向左、Z 向上，单位 mm。
机身坐标原点：机身底板下表面的正中心。整机姿态由 build.py 把机身抬到对应高度。
零件尺寸按选型计算书（docs/机械狗007v/选型计算书.md）里的候选零件；到货实测后更新这里。
"""

# ---------------------------------------------------------------- 机身（铝板 + 2020 铝型材的盒子）
BODY_L, BODY_W, BODY_H = 400.0, 240.0, 150.0
PLATE_SIDE = 4.0          # 两侧铝板（髋轴穿过这里，受力最大）
PLATE = 3.0               # 底板、前后板、顶板
PROFILE = 20.0            # 2020 铝型材
SKID_H = 6.0              # 底部滑撬（折叠时机身坐在它上面）

# ---------------------------------------------------------------- 髋驱动（机身里面：蜗轮电机 → 3:1 同步带 → 髋轴）
HIP_X = 150.0             # 髋轴离机身中心（前后）
HIP_Z = 60.0              # 髋轴高度（机身坐标）
HIP_SHAFT_D = 12.0
WORM_BOX = (58.0, 31.0, 40.0)     # NFP-5840-31ZY 减速箱（厂家图）：沿电机轴 58 × 厚 31 × 宽 40；输出轴 Φ8（D 形 7）伸出 15，离减速箱远端 20、在宽度正中
WORM_MOTOR_D, WORM_MOTOR_L = 31.0, 62.0   # 电机 Φ31 × 57（厂家图）+ 编码器 / 出线约 5
WORM_SHAFT_FROM_END = 20.0                  # 输出轴离减速箱远端（厂家图 9 + 11）
WORM_UP = True                              # 2026-10-22：电机竖着朝上装（横着装前后两个髋的电机会在机身中间撞）
WORM_OUT_DX, WORM_OUT_DZ = -55.0, -24.0   # 蜗轮输出轴相对髋轴的位置（前髋：往机身中心、往下）
PULLEY_SMALL_PD, PULLEY_BIG_PD = 14.3, 43.0   # HTD3M 15T / 45T 节圆直径
PULLEY_W = 14.0           # 带轮（含挡边）宽
BELT_W, BELT_T = 9.0, 2.4
BEARING_HOUSING_D, BEARING_HOUSING_W = 46.0, 18.0   # 侧板外面的轴承座（两个 6001 背靠背，共 16 宽）
AS5600 = (22.0, 4.0, 22.0)        # 磁编码器小板

# ---------------------------------------------------------------- 摆臂 + 轮子（摆臂随髋轴转）
ARM = 170.0               # 髋轴到轮轴
ARM_ROOT_R, ARM_END_R = 26.0, 27.0      # 摆臂高 52–54（用户 2026-10-17 第二次：腿再细一点）；轮端 ≥ 26.5 才盖得住 Φ53 的轮子电机
WHEEL_D, WHEEL_W = 96.0, 37.2         # goBILDA 96 mm 麦轮（3213-3606-0002，官方 3D 模型）：外径 96.3、宽 37.2、10 个轴承滚子
WHEEL_MOTOR_D, WHEEL_MOTOR_W = 53.0, 41.0   # GIM4310-10 + GDZ34 驱动（官方图纸 2025-12-03）：Φ53 机身 32 + 输出凸台 Φ37×1 + 后面驱动 Φ40×8（GDS34 版 39，也装得下）
LINK_IN_T, LINK_GAP, LINK_OUT_T = 3.0, 2.0, 3.0   # 摆臂连杆：双板夹层（内片 3 + 空隙 2 + 外片 3）
OUTER_PLATE_T = LINK_IN_T + LINK_GAP + LINK_OUT_T  # 连杆总厚
LINK_WAIST = 0.8                                  # 连杆中段收窄到两端的 80%
CAN_D, CAN_T = 44.0, 4.0                          # 轮端电机后盖 / 髋端编码器罩：直径、伸出连杆外片的长度
WHEEL_GAP = 5.0           # 折叠时电机端面和机身侧面的最小间隙
# ---- 叉式夹轮（2026-10-18）：机身 → 电机 → 腿板 → 轴承座 → 麦轮 → 轴承座 → 叉板 → 端盖
LEG_PLATE_T = (3.0, 3.0)  # 腿板两层：内层深色、外层浅色（外层四周缩进 PLATE_INSET）
FORK_PLATE_T = (3.0, 3.0) # 叉板两层
PLATE_INSET = 2.5
AXLE_BOSS = 5.0           # 腿板 / 叉板和麦轮之间：轴承座凸台（4）+ 轮毂间隙（1）
FORK_GAP = 4.5            # 叉板和麦轮滚子之间
FORK_LOW = 15.0           # 叉板最低点不低于轮轴中心以下 15
FENDER_R = (61.0, 66.0)   # 挡泥横梁（叉板和腿板在轮子上方连起来）内外半径
LP0 = BODY_W / 2 + 18.0 + 1 + 12.0 + 4.0         # 腿板内侧 = 臂根板内侧（侧板 → 轴承座 18 → 轴毂 12 + 法兰 4），155
AXLE_HOUSING_L = 17.5                            # 轮轴承座 B07：电机那头 Φ53 法兰 5.5（3 颗 M2.5 拧电机前面，Φ37.1 孔套住电机凸台定心）+ 两个 6801（10）+ 挡边 2
AXLE_FLANGE_T = 4.0                              # 轮轴法兰 Φ34：3 颗 M3 沉头拧在电机输出盘上（Φ27 圆），转在 B07 的 Φ37.1 孔里
M0 = LP0 - AXLE_HOUSING_L - (WHEEL_MOTOR_W - 1.0) # 电机内端面（驱动那头）：电机机壳前面贴 B07，凸台伸进 B07
AXLE_BOSS = 3.0                                  # 腿板和麦轮之间的轴承座凸台
WHEEL_Y0 = LP0 + 6.0 + AXLE_BOSS                 # 麦轮内侧（腿板就是 6 mm 的臂根板，一直延长到轮轴）
WHEEL_YC = WHEEL_Y0 + WHEEL_W / 2                   # 麦轮中心（运动学用）
FORK_Y0 = WHEEL_Y0 + 40.0 + FORK_GAP             # 叉板内侧（2026-10-18 叉板取消，留着不用）
LEG_Y1 = WHEEL_Y0 + WHEEL_W                         # 腿外侧面 = 麦轮外侧面（齐平）
ARM_BOX_LEN = 88.0        # 臂根内板的长度（铝板）；打印的箱形臂座外壳一直延伸到轮子跟前，尽头是贴着轮子的弧面
ARM_WHEEL_CLEAR = 4.0     # 臂座外壳尽头离轮子外缘
# 麦轮滚子（45°）：滚子轴线中点离轮轴 ROLLER_C、中间半径 ROLLER_R0、轴向半长 ROLLER_H，外形是“桶形”，外包络正好是 Φ152 圆柱
ROLLERS, ROLLER_C, ROLLER_R0, ROLLER_H = 10, 39.0, 9.5, 17.0       # goBILDA 96：10 个滚子
WHEEL_PLATE_D, WHEEL_PLATE_T = 84.0, 3.0   # 麦轮两侧的钢侧板（goBILDA 侧板约 Φ90，中间开口 Φ42）

# 摆臂结构：髋轴 → 臂座轴毂（键）→ 臂根内板（铝 6）→ 4 根六角支柱 → 摆臂外板（铝 6）→ 轮子电机；箱形臂座只是打印外壳
ARM_ROOT_PLATE_T = 6.0
ARM_STANDOFFS = [(-12.0, 12.0), (-12.0, -12.0), (60.0, 13.0), (60.0, -13.0)]   # 支柱位置（沿臂, 垂直臂），原点在髋轴
STANDOFF_HEX = 8.0                                 # M5 六角铝柱，对边 8

STANCE_DEG = 55.0         # 行驶：摆臂往下 55°
FOLD_DEG = 180.0          # 2026-10-18 不再往上折叠，最多趴平：摆臂水平（摆臂角 0°），机身坐在滑撬上
FOLD_THETA = 0.0

# ---------------------------------------------------------------- 三段式头部（脖子坐标：原点在甲板上表面、俯仰轴正下方）
NECK_X = 120.0            # 俯仰轴在机身前后的位置
PIVOT_UP = 66.0           # 俯仰轴高出头部平台盖（低头 20° 时下巴离平台盖还有 7 mm）
NECK_BASE = (130.0, 14.0, 240.0)      # 脖子底座（U 形，屏幕头下面挖空）：前后 × 高 × 左右；左右不能超出机身（折叠的前轮要从旁边过）
POD_IN, POD_W = 72.0, 48.0            # 肩座内侧离中线 72、宽 48：外侧和机身侧面平齐（再宽会被折叠的前轮扫到）；48 宽才放得下雷达的安装脚（46.3）
POD_HEX = [(-22, 16), (48, 16), (78, 62), (50, 122), (-8, 122), (-46, 62)]   # 肩座侧面六边形（脖子坐标）
HEAD_W = 126.0                         # 屏板 112.4 宽，两边各留约 7；和两耳之间留 9 mm，转轴壳露在这条缝里
HEAD_PROFILE = [(-25, -42), (56, -42), (84, -24), (84, 54), (72, 66), (-12, 66), (-30, 42), (-30, -28)]   # 屏幕模块侧面（相对俯仰轴）；前脸 -28…54 放得下 75.1 高的屏板，下巴斜切，低头才不碰平台盖
SCREEN_BOARD = (13.0, 112.4, 75.1)    # 微雪 ESP32-S3-Touch-LCD-4.3B：厚（估）× 宽 × 高（官方 112.4×75.1）
SCREEN_X, SCREEN_Z = 81.0, 15.0       # 屏板前表面离俯仰轴（头壳前墙内面 81.5）、屏板中心高出俯仰轴（下巴里面让开）
SCREEN_GLASS = (118.0, 50.0)          # 前面的玻璃窗：宽 × 高，约 2.4:1 的长条（效果图那样）；屏板上下边藏在框后面，HUD 只画中间一条
SERVO = (45.2, 24.7, 35.0)            # 飞特 STS3215 总线舵机（装在左耳轴座里）
EAR_LAYERS = ((POD_IN, 104.0, 0.0), (104.0, 110.0, -4.0), (110.0, POD_IN + POD_W - 4, -8.0))   # 耳朵三层板：(内侧 y, 外侧 y, 比骨架缩进多少)
LIDAR_FLANGE = 15.0                   # 雷达和耳朵顶面之间的低矮法兰；雷达扫描面 = 耳顶 122 + 15 + 27 = 164，高过屏幕模块抬头最高点（162）
# 乐动 LD19 激光雷达（官方规格书 V2.5）：底座约 38.6 方、转头 Φ35.29×12.6、总高 34.8，扫描面离底面约 27（顶下 7.8）
# 安装脚 54 × 46.29，3 个 Φ2.5 通孔：前面两个相距 46.8，第三个在后面正中，前后相距 31.92
LD19 = dict(base=38.6, head_d=35.29, head_h=12.6, h=34.8, scan=27.0, ear_w=54.0, ear_d=46.29,
            holes=[(23.4, 15.96), (-23.4, 15.96), (0.0, -15.96)], hole_d=2.5)   # 孔位 (沿 54 方向, 沿 46.29 方向)，以雷达中心为原点
CABLE_X = 30.0                        # 肩座里往下走线的孔（脖子坐标 x），甲板上对应 NECK_X + 30
HEAD_PITCH = dict(up=-35.0, level=0.0, down=20.0, fold=15.0)   # 负 = 抬头；折叠时微微低头（再低会碰甲板）

# ---------------------------------------------------------------- 货斗（甲板上 2020 卡槽导轨 + 打印栏板）
BED_X0, BED_X1 = -172.0, 65.0         # 货斗前后范围（前面给头部让位：肩座改成单侧传感塔后从 45 推到 65；后面让出后检修盖）
RAIL_Y = 102.0                        # 两侧导轨中心离中线
FENCE_H, FENCE_T, FENCE_INSERT = 70.0, 6.0, 5.0
ARM_PORT = (70.0, 8.0, 70.0)          # 机械臂接口板：前后 × 厚 × 左右
ARM_PORT_XY = (-20.0, -55.0)          # 货斗右前角（让开前导轨）

# ---------------------------------------------------------------- 机身里的电子件（盒子尺寸，到货实测更新）
BATTERY = (75.0, 135.0, 47.0)         # 6S2P 21700 定做：电芯平放、沿 x，6 列 × 2 层（70.4 × 130.2 × 43.4 + 镍片 / 热缩），外形 ≤ 75 × 135 × 47
BMS = (60.0, 40.0, 8.0)
PI5 = (85.0, 56.0, 22.0)              # 树莓派 5 + 主动散热
ESP_CHASSIS = (63.0, 25.5, 12.0)      # ESP32-S3-DevKitC-1（N16R8）
DRIVER = (50.0, 50.0, 40.0)           # BTS7960（IBT-2）单路 43A 驱动 ×4，带电流检测；孔位到货实测
DCDC_5V5A = (25.4, 25.4, 9.5)         # Pololu D36V50F5（5V 5.5A），给树莓派 5
DCDC_5V3A = (17.8, 22.9, 8.0)         # Pololu D36V28F5（5V 3.2A），给头部、雷达、传感器
CAN_MODULE = (22.0, 16.0, 5.0)        # SN65HVD230 CAN 收发小板
DEPTH_CAM = (25.0, 90.0, 28.0)        # 前脸深度相机：前后 × 左右 × 高
TRAY_Z = 68.0                         # 电子托板高度（在电池和蜗轮电机上方；底板到托板 65，用标准 M3×65 铜柱）

# ---------------------------------------------------------------- 制造件的接口（★ = 网上查不到的孔位，按常见规格先画；下单时问卖家要安装图，到货实测后改这里再出图）
BEARING = (12.0, 28.0, 8.0)                        # 6001-2RS：内径 × 外径 × 宽，每个髋 2 个
HOUSING_PCD, HOUSING_HOLE = 36.0, 4.5              # 轴承座 4 × M4 穿螺栓，分布圆 36
HOUSING_SPIGOT = (22.0, 3.0)                       # 轴承座伸进侧板的定位台：直径 × 长
HUB = dict(boss_d=28.0, boss_l=12.0, flange_d=44.0, flange_t=4.0, pcd=34.0)   # 臂座轴毂：键槽孔 Φ12，法兰 4 × M4
KEY = (4.0, 4.0, 12.0)                             # 平键 4 × 4 × 12（大带轮、轴毂各一个）
WHEEL_MOTOR_REAR = dict(n=6, pcd=47.5, d=2.5, depth=3.0)     # GIM4310 背面 6 × M2.5（深 3），分布圆 47.5（官方图纸）
WHEEL_MOTOR_FRONT = dict(n=3, pcd=47.5, d=2.5, depth=5.0)    # GIM4310 输出那面机壳 3 × M2.5（深 5），分布圆 47.5：拧在 B07 上
WHEEL_MOTOR_OUT = dict(n=3, pcd=27.0, d=3.4, depth=4.0, boss=37.0)   # GIM4310 输出盘 3 × M3（深 4），分布圆 27；输出凸台 Φ37 高 1（官方图纸）
WHEEL_HUB = dict(n=4, pcd=22.63, d=4.5, bore=14.0, hub_t=12.0)   # goBILDA 轮毂：中心孔 Φ14，“16 mm 孔型” 4 × M4（±8, ±8），轮毂厚 12、在轮子正中
ADAPTER = dict(d=62.0, t=8.0)                               # 轮子转接法兰（铝）
WORM_FACE = dict(holes=[(-14.0, -11.0), (14.0, -11.0), (-14.0, 29.0), (14.0, 29.0)], d=4.5, slot=2.0)   # 5840 减速箱侧面 4 × M4（厂家图：孔距 28 × 40；相对输出轴：横 ±14，沿电机轴 -11 / +29）
DRIVER_HOLES = dict(dx=43.0, dy=43.0, d=3.2)       # ★ BTS7960 板 4 个角孔
PI5_HOLES = dict(dx=58.0, dy=49.0, d=2.7, edge=3.5)   # 树莓派 5：58 × 49，M2.5（官方机械图）

# ---------------------------------------------------------------- 估算重量（kg，和 sizing.py 一致，合计约 15.6；到货称重更新）
MASS_FRAME = 2.5          # 铝板 + 2020 横梁 + 滑撬（按体积分摊）
MASS_BED = 0.5            # 货斗导轨 + 栏板 + 机械臂接口板（按体积分摊）
MASS_SHELLS = 1.37        # 打印外壳里没单独算重量的部分（侧装甲、灯带等，按机身中心算）；保险杠、格栅、肩座、头壳单独算
# ---- 工程化深化（2026-10-18）：底盘框架外露、外壳架高、顶面三块叠层板
FRAME_RAIL = (10.0, 8.0, 34.0)        # 底盘边梁（矩形铝管 26×10）：宽、下沿高、上沿高
FRAME_GAP = 6.0                       # 边梁上沿到外壳下沿的可见缝
TOP_PLATE_T, TOP_STEP = 7.0, 4.0      # 顶面盖板厚、前后两块比货斗底板高出多少（2026-10-18 硬表面：板厚 4 → 7）
TOP_OVER_X, TOP_OVER_Y = 9.0, 3.5     # 顶板悬挑：前后 9；两侧只到机身侧面外 3.5，和上层甲板壳齐平（折叠的前轮贴着侧面翻上去，5.5 就撞了）
SLAB_OUT, WAIST_IN, TUB_OUT = 3.5, 0.3, 1.5   # 侧面错层：上层甲板壳伸出 3.5、黑腰凹到 0.3、下层外壳 1.5（下部往里收）
SEAM = 2.0                            # 盖板之间的分缝宽
PART_MASS = {             # 零件名字里含这几个字就用这个重量（每个零件）
    "电池6S2P": 0.95, "电池保护板": 0.05,
    "蜗轮减速箱": 0.22, "蜗轮电机": 0.18, "小带轮": 0.02, "大带轮": 0.04, "同步带": 0.01, "髋轴": 0.03,
    "轴承座": 0.05, "磁编码器": 0.005,
    "臂座轴毂": 0.08, "箱形臂座外壳": 0.14, "臂根内板": 0.06, "臂根支柱": 0.01, "腿板内层": 0.12, "摆臂外板": 0.10, "腿板外层": 0.05, "叉板内层": 0.03, "叉板外层": 0.02, "挡泥横梁": 0.04, "轮轴支座": 0.02, "轮轴承座": 0.05, "麦轮轮轴": 0.06, "电机护罩": 0.03,
    "髋部护罩": 0.05, "叉板端盖": 0.01, "编码器罩": 0.02, "台阶测距": 0.01, "轮子电机": 0.23,
    "麦轮外包络": 0.0, "麦轮滚子": 0.010, "麦轮侧板": 0.025, "麦轮轮毂": 0.05, "轮毂法兰": 0.035,   # goBILDA 96：一个 207 g   # 一个 110 麦轮 14×0.017 + 2×0.07 + 0.18 ≈ 0.56
    "树莓派5": 0.10, "底盘ESP32": 0.02, "BTS7960": 0.065, "D36V50F5": 0.006, "D36V28F5": 0.004, "CAN Pal": 0.003, "TCA9548A": 0.002,
    "12V 降压": 0.02, "编码器支架": 0.012, "电机护罩端圈": 0.008, "急停": 0.09, "总开关": 0.025, "充电口XT60": 0.008, "护线圈": 0.001, "编码器磁铁": 0.0005, "INA226": 0.006, "保险丝盒": 0.06, "继电器": 0.045,
    "深度相机": 0.10, "电子托板": 0.32,                     # 托板含线束
    "屏幕头": 0.35, "4.3寸屏板": 0.12, "屏幕玻璃": 0.03,
    "屏幕头·主壳": 0.24, "屏幕头·顶盖": 0.09, "屏幕头·电子托板": 0.02, "屏板压框": 0.01, "屏幕头·": 0.005, "右耳·": 0.004,   # 工程版：头里、右耳里的小板
    "上层甲板壳·前鼻": 0.05, "上层甲板壳·后鼻": 0.05, "上层甲板壳·": 0.02,
    "俯仰舵机": 0.06, "雷达底座": 0.01, "雷达": 0.05, "耳骨架": 0.10, "耳中板": 0.03, "耳外板": 0.03, "转轴壳": 0.02, "雷达法兰": 0.03, "雷达护环": 0.01, "编织线缆": 0.02,
    "脖子底座": 0.24,
    "屏板卡槽": 0.005, "屏板压条": 0.003,
    "舵盘法兰": 0.01, "俯仰轴销": 0.01, "俯仰铜套": 0.005, "前保险杠": 0.08, "后格栅": 0.05,
    "底盘边梁": 0.12, "底盘横管": 0.05, "髋支座": 0.035, "侧挂板": 0.03,
    "头部平台盖": 0.12, "货斗底板": 0.15, "后检修盖": 0.03,
    "外壳·": 0.0, "摆臂外盖板": 0.04, "髋部大圆盖": 0.02, "上层甲板壳": 0.18,                                          # 装饰件（灯带、螺栓、镜头）重量算在 MASS_SHELLS 里
}
PAYLOAD = 10.0
PAYLOAD_UP = 100.0        # 货物重心高出甲板（按 20 cm 高的一箱货）
