whois169/roboot007v/007v/firmware/chassis/src/params.h

// 自动生成，不要手改：python 007v/firmware/chassis/gen_params.py
// 来源：007v/chassis/controller.py、007v/config.py
#pragma once

static const char* const FW = "0.1.0";
constexpr int RATE = 200;
constexpr int STATUS_EVERY = 20;
constexpr float R = 0.048f;
constexpr float FOLD_DEG = 0.0f;
constexpr float TOUCH_DEG = 6.078005058496837f;
constexpr float V_MAX = 1.0f;
constexpr float VY_MAX = 0.2f;
constexpr float WZ_MAX = 1.5707963267948966f;
constexpr float A_ACC = 0.5f;
constexpr float A_BRAKE = 1.0f;
constexpr float A_Y = 0.5f;
constexpr float A_W = 3.141592653589793f;
constexpr float A_ESTOP = 4.0f;
constexpr float ESTOP_RAMP = 0.1f;
constexpr float W_MAX = 20.833333333333332f;
constexpr float DRIVE_TIMEOUT = 0.5f;
constexpr float LINK_TIMEOUT = 2.0f;
constexpr float HIP_SPEED = 30.0f;
constexpr float HIP_ACC = 150.0f;
constexpr float HIP_SLOW = 15.0f;
constexpr float TOUCH_BAND = 8.0f;
constexpr float HIP_STALL_DEG = 15.0f;
constexpr float HIP_STALL_S = 1.0f;
constexpr float MOVE_V = 0.4f;
constexpr float MOVE_A = 0.4f;
constexpr float MOVE_VY = 0.2f;
constexpr float MOVE_WZ = 1.0471975511965976f;
constexpr float POS_TOL = 0.01f;
constexpr float ANG_TOL = 0.017453292519943295f;
constexpr int BAT_LOW = 15;
constexpr float M_EMPTY = 14.3f;
constexpr int LOAD_MIN_N = 120;
constexpr float LOAD_MIN_VAR = 0.02f;
constexpr float LOAD_RESET_S = 3.0f;
constexpr float STEP_SIN = 0.49999999999999994f;
constexpr float CLIFF_MM = 40.0f;
constexpr float STEP_MM = 30.0f;
constexpr float STEP_V = 0.3f;
constexpr float STEP_SENSOR_V = 0.2f;
constexpr float CLIFF_CLEAR_S = 0.3f;
constexpr float STEP_HOLD_S = 1.0f;
constexpr float CHG_A = 0.3f;
constexpr float BRAKE_A = 0.05f;
constexpr float EPS_T = 0.0001f;
constexpr float ARM = 170.0f;
constexpr float HIP_X = 150.0f;
constexpr float HIP_Z = 60.0f;
constexpr float SKID_H = 6.0f;
constexpr float STANCE_DEG = 55.0f;
constexpr float WHEEL_D = 96.0f;
constexpr int LEG_FX[4] = {1, 1, -1, -1};
constexpr int S_ROLL[4] = {-1, 1, 1, -1};
constexpr float YW[4] = {0.18259999999999998f, -0.18259999999999998f, 0.18259999999999998f, -0.18259999999999998f};
constexpr float STEP_Z[4] = {28.0f, 28.0f, 30.0f, 30.0f};
static const char* const STEP_NAMES[4] = {"front_left", "front_right", "rear_left", "rear_right"};
constexpr float PI_F = 3.141592653589793f;
