whois169/roboot007v/007v/body_electronics.py

"""机身里电子件的布置和安装孔（2026-10-22）：板子尺寸、孔位都按官方图纸 / 电路板文件（007v/ref/）。

托板 C01（3 mm 黑色亚克力，激光切割，z = TRAY_Z）上的板子，和底板 A03 上（托板下面）的电源件。
坐标：机身坐标，原点在机身中心底面，x 前、y 左，mm。每个零件 = 左下角 (x0, y0) + 尺寸 (sx, sy, sz) + 孔（相对左下角）。

| 零件 | 尺寸依据 |
|---|---|
| 树莓派 5 | 官方机械图：85 × 56，4 个 Φ2.7，孔距 58 × 49，离边 3.5 |
| 乐鑫 ESP32-S3-DevKitC-1 v1.1 | 官方尺寸图：62.74 × 25.40，没有安装孔 → 托板上开扎带孔 |
| Adafruit CAN Pal（5708） | 官方 .brd：20.32 × 20.32，2 × Φ2.5（2.54 / 17.78, 17.78） |
| Adafruit TCA9548A（2717） | 官方 .brd：17.78 × 30.48，2 × Φ2.5（8.89, 2.54 / 27.94） |
| Pololu D36V50F5（4091） | 官方尺寸图：25.4 × 25.4，3 × M2，离边 2.54 |
| Pololu D36V28F5（3782） | 官方尺寸图：20.3 × 17.8，2 × M2（对角），离边 2.54 |
| BTS7960（IBT-2）×4 | 没有官方图（各家仿版），约 49 × 49 × 37；4 个角孔开成长孔，±3 mm 都能装 |
| INA226 电流计、24V→12V 降压 | 通用模块，尺寸各家不同 → 开长孔 + 扎带孔 |
| 汽车继电器 ×2（带座）、6 路保险丝盒 | 通用件 → 底板上开长孔 |
"""
from config import DRIVER, PI5, TRAY_Z

T = 3.0                                   # 托板厚（亚克力）
STANDOFF = 6.0                            # 小板下面垫的 M2 / M2.5 / M3 尼龙柱高


def holes_rect(sx, sy, e, d):
    return [(e, e, d), (sx - e, e, d), (e, sy - e, d), (sx - e, sy - e, d)]


# 托板上：(名字, x0, y0, sx, sy, sz, [(孔 x, 孔 y, 直径, 类型)])；类型：hole 圆孔 / slotx 沿 x 长孔 ±3 / tie 扎带孔
TRAY = [                                   # 树莓派 x -132：后面让给急停的触点（面板后 66.5），网口、USB 头在急停下面
    ("树莓派5", -132.0, -28.0, PI5[0], PI5[1], PI5[2],
     [(3.5, 3.5, 2.7, "hole"), (3.5 + 58, 3.5, 2.7, "hole"), (3.5, 3.5 + 49, 2.7, "hole"), (3.5 + 58, 3.5 + 49, 2.7, "hole")]),
    ("BTS7960 前左", 86.0, 6.0, 49.0, 49.0, 37.0, [(x, y, 3.4, "slotx") for x, y, _ in holes_rect(49.0, 49.0, 3.0, 3.4)]),
    ("BTS7960 前右", 86.0, -55.0, 49.0, 49.0, 37.0, [(x, y, 3.4, "slotx") for x, y, _ in holes_rect(49.0, 49.0, 3.0, 3.4)]),
    ("BTS7960 后左", 34.0, 6.0, 49.0, 49.0, 37.0, [(x, y, 3.4, "slotx") for x, y, _ in holes_rect(49.0, 49.0, 3.0, 3.4)]),
    ("BTS7960 后右", 34.0, -55.0, 49.0, 49.0, 37.0, [(x, y, 3.4, "slotx") for x, y, _ in holes_rect(49.0, 49.0, 3.0, 3.4)]),
    ("底盘ESP32-S3", -45.0, 33.0, 62.74, 25.4, 12.0, [(3.0, -2.5, 3.0, "tie"), (50.0, -2.5, 3.0, "tie"), (3.0, 27.9, 3.0, "tie"), (50.0, 27.9, 3.0, "tie")]),
    ("CAN Pal", -45.0, 6.0, 20.32, 20.32, 10.0, [(2.54, 17.78, 2.7, "hole"), (17.78, 17.78, 2.7, "hole")]),
    ("TCA9548A", 8.0, 0.0, 17.78, 30.48, 5.0, [(8.89, 2.54, 2.7, "hole"), (8.89, 27.94, 2.7, "hole")]),
    ("5V 5.5A D36V50F5", -20.0, 2.0, 25.4, 25.4, 9.5, [(22.86, 22.86, 2.2, "hole"), (22.86, 2.54, 2.2, "hole"), (2.54, 2.54, 2.2, "hole")]),
    ("5V 3.2A D36V28F5", -45.0, -20.0, 20.3, 17.8, 8.0, [(2.54, 15.24, 2.2, "hole"), (17.76, 2.54, 2.2, "hole")]),
    ("12V 降压", -45.0, -60.0, 45.0, 28.0, 15.0, [(3, 3, 3.4, "slotx"), (42, 25, 3.4, "slotx"), (22.5, -2.5, 3.0, "tie"), (22.5, 30.5, 3.0, "tie")]),
    ("INA226 电流计", 5.0, -60.0, 25.0, 25.0, 6.0, [(3, 3, 2.7, "slotx"), (22, 22, 2.7, "slotx"), (12.5, -2.5, 3.0, "tie"), (12.5, 27.5, 3.0, "tie")]),
]

# 底板上（托板下面）：保险丝盒、两个继电器座
BASE = [
    ("6路保险丝盒", 64.0, -52.0, 87.0, 50.0, 32.0, [(5, 25, 4.5, "slotx"), (82, 25, 4.5, "slotx")]),
    ("继电器1（总电源）", 64.0, 10.0, 30.0, 30.0, 40.0, [(15, 3, 4.5, "slotx")]),
    ("继电器2（电机电源）", 100.0, 10.0, 30.0, 30.0, 40.0, [(15, 3, 4.5, "slotx")]),
]


def check_layout():
    """托板上 / 底板上的零件不能互相重叠，不能压到 8 根铜柱（±130 / ±60, ±56，留 Φ8）。"""
    import itertools
    bad = []
    for grp in (TRAY, BASE):
        for a, b in itertools.combinations(grp, 2):
            ax0, ay0, ax1, ay1 = a[1], a[2], a[1] + a[3], a[2] + a[4]
            bx0, by0, bx1, by1 = b[1], b[2], b[1] + b[3], b[2] + b[4]
            if ax0 < bx1 and bx0 < ax1 and ay0 < by1 and by0 < ay1:
                bad.append((a[0], b[0]))
    for n, x0, y0, sx, sy, *_ in BASE:
        for px in (-130, -60, 60, 130):
            for py in (-56, 56):
                if x0 - 4 < px < x0 + sx + 4 and y0 - 4 < py < y0 + sy + 4:
                    bad.append((n, f"铜柱 {px},{py}"))
    for n, x0, y0, sx, sy, *_ in TRAY:
        if x0 < -140 or x0 + sx > 140 or y0 < -66 or y0 + sy > 66:
            bad.append((n, "超出托板"))
    return bad


if __name__ == "__main__":
    print(check_layout() or "托板 / 底板布置不重叠")
