whois169/roboot007v/(commit log)

2026-10-05 RoboDog v0.3.3：项目初始版本
    四足机器狗参数化 CAD（CadQuery）、MuJoCo 仿真模型、3D 预览生成脚本、
    设计文档、电子接线、分阶段采购表和项目核心原则。
    Claude-Session: https://claude.ai/code/session_01CJoNP14JPfjPvJyKqdXibp
    [RoboDog_分阶段采购表.xlsx, robodog.xml, scene.xml]
2026-10-05 RoboDog v0.4：机身加宽，大腿全封闭
    - 机身 140 → 160mm，腿位置不变，髋部电机一半嵌进机身；2020 型材、顶甲、尾罩跟着加宽
    - 大腿：内外板去掉减重孔；外板改成带围边的外壳，皮带、带轮、张紧轮全包在里面
    - 小腿槽口按膝关节全行程扫出；小腿加膝部鼓形圆盘，大腿内加隔板，看不到皮带
    - 小腿改实心；新增 check_neck.py 脖子全范围扫描
    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
    [robodog.xml]
2026-10-05 RoboDog v0.4：腿部全包裹
    - 髋罩（上下两半）：包住髋俯仰电机、插头和髋支架，跟着外摆关节一起动
    - 膝部毛刷条：挡住小腿槽口，小腿经过时推开、过去后弹回
    - 髋俯仰电机插头改成朝外（前腿朝前、后腿朝后），髋罩才能压低、不碰尾罩
    - 髋座前外角切 14mm 斜角、肩甲缩短，给大腿根部外摆让位
    - 新增 check_haa.py 外摆关节全范围扫描：前腿内 15°/外 30°，后腿 ±25°
    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
    [RoboDog_分阶段采购表.xlsx, robodog.xml]
2026-10-05 RoboDog v0.4：去掉膝部毛刷条
    小腿槽口保持开口，膝部鼓形圆盘和大腿隔板挡在里面，看不到皮带。
    采购表、文档、效果图同步去掉毛刷条。
    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
    [RoboDog_分阶段采购表.xlsx, robodog.xml]
2026-10-05 gitignore：生成的模型、网格、效果图不进版本记录
    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
2026-10-06 新增零件尺寸收集清单
    按购买阶段列出每个买来的零件要收集的尺寸，以及对应要改的模型参数；附打印机孔径校准步骤。
    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
2026-10-08 RoboDog v0.5：科技机械狗
    - 方向调整：科技机械狗，不是宠物狗；更新核心原则、P1 计划、行动清单
    - 修正膝关节皮带长度：大腿轴距 190 -> 189.3mm，104 齿皮带配张紧轮
    名义压进 6.9mm 刚好张紧，长槽 ±6mm；build.py 增加皮带长度检查；
    逆运动学改成两段不等长的通用公式
    - 外观设计规范 v1：深灰壳板 + 银色件 + 黑色传感器窗 + 琥珀橙状态灯，
    缝线、端盖、小腿护甲、髋罩状态灯、侧甲分块；去掉尾鳍
    - 背部任务导轨（兼提手）+ 激光雷达模块 + 示范任务箱 + GX16-8 任务接口
    - 头部：MLX90640 热成像、红外收发直接开孔；银色前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
    [RoboDog_分阶段采购表.xlsx, robodog.xml]
2026-10-09 RoboDog v0.6：参考概念图重做腿的造型
    - 大腿：圆弧肩、上宽下窄，装甲和大腿外壳齐平（没有一圈凸边），
    装甲上不再开调节孔；张紧轮外侧改 M5 沉头，头和外板平齐
    - "叉形"大腿：下半段围边只包皮带层，小腿夹在隔板和内板之间，侧面没有槽口
    - 外露 Φ50 银色膝盖；小腿狗腿反弓（LEG_STYLE = C，另有 A/B 可选），
    槽口按小腿真实外形扫出；双色小腿护甲 + 银色脚踝护圈 + 大腿状态灯
    - 新增 check_knee.py：膝关节 -10°…150° 全程无碰撞
    - 验证：4 个姿态 0 干涉，外摆、脖子范围不变，起身顶限 6.0%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
    [robodog.xml]
2026-10-11 大脑程序 brain/ 加入版本记录；修 Windows 上报告乱码
    - brain/：听、说、想、HUD 眼睛、看、感觉板、记忆、主动开口、摸头唤醒和头部通信协议，回归测试 65 项
    - docs/头部通信协议.md：大脑和头部 ESP32 的 JSON 协议（写固件用）
    - docs/开发进度与交接.md 更新到 v0.6；docs/扩展规划_投影与传感器.md
    - build.py / check_haa.py / check_neck.py：读写 rig.json、report.txt 加 encoding="utf-8"
    - viewer/package.json：渲染效果图用的 node 依赖
2026-10-11 大脑第⑧块：红外遥控（学按键、发码、码库按家存）
    - dog/ir.py：码库，按“家电 + 按键”存在记忆同一个 .db 的 ir_codes 表；说法不同也能找到
    - 技能 ir_learn / ir_send / ir_forget；提示词加【我能遥控的家电】和规则 8
    - 协议：大脑 → ESP32 的 ir 指令（learn / send / cancel），ESP32 → 大脑的 ir 事件；三种码格式
    - 模拟器：R 键 = 学习时按了一下遥控器；发码回 sent
    - 没学过的按键不发；发了码一句没说时补“已发送”；学的时候摸头顶取消
    - 回归测试 84 项全部通过
2026-10-11 大脑第⑨块：热成像（分析热源、屏幕热画面、高温主动提醒）
    - dog/thermal.py：一帧 32×24 的编码解码（base64，约 1.1 KB）、找热源 / 冷点 / 方向、按温度猜是什么、模拟器假房间
    - 协议：ESP32 → 大脑 thermal 帧，大脑 → ESP32 {"thermal":{"hz":1}}；一行上限改成 2048 字节
    - 屏幕：THERMAL 画真热画面（3×2 像素一点、镜像、最热点角标、MAX/MIN、色标按平方根分配）
    - 感觉板加“热成像”读数；提示词规则 9（表面温度不是室温）
    - 60°C 以上持续 5 秒主动提醒，10 分钟不重复，隐私时不说
    - 模拟器：一直画假房间热画面，H 键开关假灶台
    -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
2026-10-11 大脑第⑩块：室内外对比 + 屋里舒不舒服的主动提醒
    - 温湿度改成头部 SHT40 经 ESP32 发来（room_temp / room_humidity），temp_offset 校准；模拟器 [ ] , . 键调
    - 程序算好室内外温差、湿度，聊到相关话题时放进【我查到的】；天气关键词加上温差、外面、屋里等
    - 屋里偏热 / 冷 / 潮 / 干持续 10 分钟、有人在时主动提醒，建议开窗或开空调，只问不自己发红外
    - 回归测试 115 项全部通过
2026-10-11 大脑第⑪块：认人（登记、叫出名字、陌生人汇报）
    - dog/people.py：登记的人和 SFace 脸部特征（只存 128 维特征，不存照片），比对和 5 次 3 票的投票
    - vision.py：摄像头线程给够近够正的脸算特征；认出 / 陌生人事件；感觉板写出是谁
    - 技能 enroll / forget_person；提示词规则 9；陌生人主动汇报（30 分钟一次）
    - 下载脚本加上 SFace 和 Kokoro v1.1；提示词规则 2 写清楚模拟数据也要报数
    - 回归测试 134 项全部通过
2026-10-11 交接文档：记下明天的开发顺序和功能想法
2026-10-11 上位机更正为树莓派 5：供电拆成两路 5V 5A，补充 Pi 5 注意事项
    - 电子系统与接线：树莓派 5 单独一路 DC-DC 5V 5A，头部 USB 集线器另一路；GPIO 供电要开 usb_max_current_enable=1；官方 27W 电源；主动散热
    - 采购表：上位机、测试电源、DC-DC 数量（2 个）、P6 主控备注
    - 其他文档里的“树莓派 4B”改成 5；CAD 只改注释（占位尺寸一样）
    [RoboDog_分阶段采购表.xlsx]
2026-10-14 语音合成换成独立的 Qwen3-TTS 服务（边收边播），删掉 MeloTTS / Kokoro / edge-tts
    - 语音合成服务单独放在桌面 RoboDog_TTS（Qwen3-TTS 0.6B + faster-qwen3-tts，RTX 3060 约 0.4 秒出第一段）
    - tts.py 只剩一种：通过 HTTP 找服务要声音，Utterance 一段一段收；服务连不上时不出声、不卡住
    - audio.py 加 play_stream：边收边播，先缓冲 0.3 秒；摸头打断时马上停
    - brain.py：回答和 speak_now 都边收边播，屏幕声波跟着每段的音量动；开机检查服务在不在（TTS QWEN3 OK / TTS OFFLINE）
    - 测试：统一的假嘴巴、假扬声器（mute）；测试语音改由服务合成，服务没开就跳过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
2026-10-14 语音合成请求不走系统代理（开着代理时会被拦下报 503）
2026-10-14 config 注释：语音服务多了 broadcast 广播音效
2026-10-14 概念页：笨笨 Mini 四种外观方案、轮足运输版（浏览器打开能转着看）
2026-10-15 概念页：笨笨 Mini 外观 v2（单段摆臂 + 麦克纳姆轮 + 俯仰屏幕头）
2026-10-15 概念页：笨笨 Mini 外观 v3（雷达冠、卡槽货斗和可拆栏板）
2026-10-15 概念页：笨笨 Mini 外观 v4（刀锋形传感器塔托起雷达，替代雷达冠）
2026-10-15 概念页：笨笨 Mini 外观 v5（传感塔和头架长在一起，雷达和天线都在塔上）
2026-10-15 概念页：笨笨 Mini 外观 v6（方正两节传感塔、雷达去罩、货斗右前角预留机械臂接口）
2026-10-15 概念页：笨笨 Mini 外观 v7（三段式头部：屏幕头 + 两块固定肩座，雷达在左肩座顶）
2026-10-15 概念页：笨笨 Mini 外观 v8（肩座改成下宽上窄的梯形）
2026-10-15 概念页：笨笨 Mini 外观 v9（肩座改成骨架 + 外装甲的六边形分层结构）
2026-10-15 概念页：笨笨 Mini 外观 v10（摆臂髋端改成封闭箱形臂座）
2026-10-15 笨笨 Mini 第 1 步：选型计算书 + 计算程序
    - bb/sizing.py：重量、轮子和髋关节受力、电机余量、稳定性、续航（输入都在文件顶上，实测后改数字重跑）
    - docs/笨笨Mini/选型计算书.md：需求、计算结果、每个零件的选型理由和硬指标、费用、样品测试标准、待验证问题
    - 结论：扁平关节电机（GIM4310-10）+ 152 mm 重载麦轮；髋用金属蜗轮自锁电机 + 3:1 同步带；
    底盘新增一块 ESP32-S3；头部换 4.3 寸 ESP32-S3 屏板；6S2P 21700 电池；不再用 MC02 和达妙电机
    [sizing.py]
2026-10-15 笨笨 Mini 第 2 步：结构骨架 + 干涉/折叠检查 + 3D 查看页
    - bb/config.py：全部尺寸；bb/model.py：机身、髋驱动（蜗轮+同步带）、摆臂+轮子、三段式头部、货斗、电子件
    - bb/build.py：4 个姿态实体干涉检查、折叠全程和抬头低头每 2° 的最近距离（fcl）、离地、重量重心、髋扭矩、导出 GLB
    - 检查发现并改掉：肩座/脖子底座比机身宽被折叠前轮扫到、低头和折叠时屏幕头碰脖子底座/甲板、机械臂接口板压到前导轨、雷达底座太宽
    - 结果：0 处干涉、折叠不撞，最小间隙 3.6 mm；展开 646×438×468，折叠 411×438×319；自重 15.6 kg
    - 待第 3 步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
2026-10-15 笨笨 Mini 第 3 步：MuJoCo 仿真 + 抬腿姿势规划 + 3D 仿真回放
    - 麦轮按 12 个 45° 桶形滚子建模（CAD 显示 + 仿真），碰撞检查仍用外包络
    - bb/sim/export_mujoco.py：从 CAD 零件算重量/重心/惯量生成 MJCF
    - bb/sim/run_sim.py：站立、起身趴下、加速急停、10% 坡、横走原地转、压门槛、抬腿；电机按额定/峰值/转速限制
    - bb/sim/lift_plan.py：抬腿前三条支撑腿的姿势搜索（静力学），满载四条腿都能抬 10 cm、重心在里面约 5 cm
    - 结果全部在额定以内，选型不变；得出 5 条底盘控制规矩；风险：髋是硬腿，压门槛冲到 17.3 N·m
    - 修正：第 2 步报告里“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
    [config.py, pack.py]
2026-10-15 改名：笨笨 Mini → 机械狗007v
    - 用户定名“机械狗007v”，不再叫笨笨
    - 结构工程 bb/ → 007v/，docs/笨笨Mini → docs/机械狗007v，概念页副本改名
    - 生成文件改名 007v.glb / 007v_data.js / 007v.xml，重新跑了结构检查和仿真，结果不变
2026-10-15 机械狗007v 第 4 步 4a：查零件尺寸 + 零件清单 + 加工图纸初版 + 接线图
    - 查到真实尺寸：LD19 孔位、微雪 4.3B 屏板 112.4×75.1（引脚被屏幕占满，头部传感器继续用旧 ESP32-S3）、
    152 重载麦轮太宽太重（改 45 宽 15 滚子）、Pololu 降压；查不到的（电机、轮毂、蜗轮箱孔位）标 ★ 等卖家图纸
    - 模型按真实零件改：头加高变窄、肩座 48 宽放雷达、整机宽 428、摆臂根铝内板 + 4 根铝柱受力、
    髋部两个 6001 + 键 + 端头压紧、电子仓按 4 块 BTS7960 重排；碰撞检查和仿真重新跑全部通过
    - 007v/mfg.py：23 种加工件（铝板 DXF、车削件 STEP、打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
    [采购清单.xlsx]
2026-10-15 机械狗007v：SolidWorks 装配体导出 + Blender 场景（动画、一键拆散、仿真回放）
    - 007v/export_sw.py：按 10 个运动部件分组的 STEP 装配体，每个部件原点在转轴上，带 Φ6 铰链标记；关节表、部件质量 CSV；
    中文名按 STEP 标准写成 \X2\ 编码（SolidWorks 不乱码）
    - 007v/blender/export_parts.py + make_blend.py：每个零件单独一个物体、挂在关节空物体下；时间轴：展开/折叠、抬头低头、
    拆散/装回、8 段 MuJoCo 仿真回放；“拆散”滑块用驱动器；Blender 5.2 用 channelbag 写关键帧
    - look.py：颜色、材质、坐标换算三处共用
    - docs/机械狗007v/SolidWorks和Blender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
2026-10-15 使用说明错字：铝链 → 铰链
2026-10-16 机械狗007v：外壳和头部内部结构（照效果图 v10）
    - 007v/shell.py：机身侧装甲、腰线灯、甲板银边、前保险杠（深度相机窗、雾灯）、后格栅和尾灯、底光、栏板反光条；
    空心屏幕头（屏框、眉、下巴相机 / 测距 / 隐私灯、脑后散热片、屏板卡槽和压条、舵盘法兰、俯仰轴销）；
    肩座三层（封板、骨架、外装甲 + 支柱、电机端盖、青光圈、光槽、缝灯、琥珀灯；左舵机仓和走线孔，右热成像窗、红外管、天线、铜套）
    - 机身铝板和摆臂外板改深灰阳极氧化；屏板往后、往上挪让开头壳内壁
    - 装饰件只查和其他运动部件的碰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
2026-10-16 机械狗007v：外观再向效果图靠（摆臂外盖、髋部大圆盖、下层底盘、007V 字样、正式渲染）
    - 摆臂：外盖板 + 长槽 + 斜黄条、髋部 Φ50 大圆盖（黄圈 + 银六角）、轮端青光圈、臂座四道黄箍
    - 机身：下层底盘护板（髋部让开）、前后斜切鼻子、007V 立体字和小字、警示斜纹；栏板、脖子底座改深灰
    - Blender 预览改 Eevee：屏幕 HUD 眼睛、灯带发光、影棚灯；加和效果图一样的三个角度
    - 同一部件里的装饰件判断改成名字里含“外壳·”（腿上的带前缀）；4 姿态 0 干涉、折叠不撞、仿真全过
    - 加工件 37 种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
2026-10-17 机械狗007v：外壳零件倒圆角（头壳 R4、肩座 R3–4、保险杠 R3、鼻子 R3.5、甲板四角 R10），Blender 平滑着色 + 细倒角，阳极氧化改哑光
2026-10-17 机械狗007v：机身照效果图比例改成下层底盘 67 + 黑腰 16 + 上层甲板 67，前后大斜面鼻子；预览照效果图的机位（长焦、低机位），栏板默认隐藏
2026-10-17 机械狗007v 外观定稿：上层甲板整块带前后两道斜面（效果图那个角）、麦轮改 127 宽 40、摆臂收窄到 R30、外盖和髋盖变薄
    整机 62.2 × 43.0 × 45.6 cm，自重 15.1 kg；4 姿态 0 干涉、折叠不撞、最小间隙 4.9 mm；仿真全部通过（平地 1.4 m/s 电机顶到转速上限）
    [采购清单.xlsx]
2026-10-17 机械狗007v：轮子改 110 mm、屏幕窗改 118×50 长条
    - 麦轮 127 → 110（14 滚子），最高速度降到约 1.1 m/s，平地仿真按 1.1 测
    - 屏幕玻璃窗 118×50（约 2.4:1，接近效果图），HUD 图同步
    - 过门槛髋扭矩 20.2/20.7，文档注明门槛前必须减速
    - 更新清单、选型计算书、仿真报告、图纸、SolidWorks 导出、Blender 场景
    [采购清单.xlsx]
2026-10-17 整理：旧的四足工程和旧文档挪到 ../旧版/，工程里只留 007v、大脑程序和在用的文档
    [RoboDog_分阶段采购表.xlsx, robodog.xml, scene.xml, 采购清单.xlsx]
2026-10-17 大脑程序挪进 007v/brain，改名 007v；屏幕 HUD 按 4.3 寸新屏 800×440 重写
    - 人设：名字 007v，轮足运输机器人，底盘没接上前如实说不能动；红外、热成像在右肩
    - 两块板分线：屏幕板收 HUD 指令、传感器板收红外/热成像；屏幕触摸 zone=screen 等同摸头顶
    - 屏幕切到热成像时让传感器板 4 帧/秒并转给屏幕板
    - HUD：800×440，上下状态栏（电量、速度、载重、温度），眼睛发光，12 个状态保留
    - 回归测试 127 项全过（语音 2 项因语音服务没开跳过）
2026-10-17 屏幕眼睛照效果图：圆角方块、唤醒弯成 ∩、警告琥珀色凶眼睛；加 face 表情字段
2026-10-17 眼睛演示：加速度、载重读数，汇报时用开心表情
2026-10-17 屏幕数据流看得清：字体换 5×7 放大 2 倍、整体调亮，眼睛出现时也不再太淡
2026-10-17 底盘程序（Python 参考实现）+ 虚拟底盘 + 28 项仿真测试
    - 协议：drive / move / pose / stop / estop / reset / limit / hb，事件 hello / chassis / ack / done / warn / fault
    - 麦轮运动学和里程计、加减速限制、急停 0.1 秒爬升到 4 m/s²、断线和 drive 超时自停
    - 站起来/趴下按仿真规矩（接地前后放慢）、髋卡住报故障、按推力和加速度估背上载重（空车标定 14.3）
    - 虚拟底盘：MuJoCo 车 + 底盘程序，可实时跑、可开窗口看
    [protocol.py]
2026-10-17 大脑接上底盘：虚拟底盘默认开，大模型能走路
    - 新技能 move / turn / stop / posture；边说边走，走的时候照样能听，说停或摸头马上刹住
    - 趴着时自动先站起来；往前走盯下巴测距，35 cm 内停；没走成等空下来说原因
    - 感觉板加底盘状态、速度、里程、载重、电量；屏幕 SPD / LOAD / 电量用真数
    - 提示词：说清能做什么、做不到什么（没地图、不会跟人）；没接底盘时不给走路技能
    - python main.py --text --view 打字指挥、开窗口看仿真里的车走
    - 大脑测试 146 项全过（新增底盘 13 项、大模型走路 6 项）；底盘测试 28 项全过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
2026-10-17 取消头顶、下巴触摸（软件 + 硬件）：叫醒、打断改用屏幕板自带的触摸屏
    - 协议 touch 只剩 zone=screen；点屏幕 = 唤醒 / 打断说话 / 走着先刹车
    - 模拟器鼠标点窗口或按 T = 点屏幕；去掉 C（摸下巴）
    - 清单、接线图、协议文档、大脑说明同步；大脑测试 144 项全过
    [采购清单.xlsx]
2026-10-17 腿变细（髋端 R26、轮端 R27，高 52–54）；箱形臂座外壳延伸到轮子跟前，尽头贴着轮子的弧面，不留空档
    - 髋端两根臂根支柱内移到 (-12, ±12)，让开变细的外壳
    - 4 个姿态 0 碰撞、折叠全程不撞；仿真全部 ✓；底盘测试 28 项全过
    - 图纸 D01、SolidWorks、Blender、3D 页、图纸页同步
2026-10-17 blender 日志不进版本记录
2026-10-17 工程化深化·第一阶段（结构重构，待确认）
    - 底盘框架外露：两根矩形铝管边梁 + 前后横管（带银色端盖），外壳架在上面，中间 6 mm 可见缝
    - 顶面三块叠层板：头部平台盖（高 4）/ 货斗底板 / 后检修盖（高 4），板边 4 mm、带垫条；脖子随平台盖抬高 8
    - 侧挂板独立：四角螺栓，和下层外壳一圈 1 mm 缝（去掉原来的侧装甲框）
    - 四个髋支座：独立铝件，下两颗螺栓拧在边梁、上两颗拧在侧板，轴承座从中间穿出
    - 货斗长度 240 → 217（让出后检修盖）
    - 0 碰撞、折叠全程不撞；仿真全部 ✓；自重 16.0 kg（+1.2）
    - 新增 blender/rend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
2026-10-17 工程化深化·硬表面调整（待确认）
    - 所有外壳边缘：大圆角改成 1–2 mm 小倒角，转角不再倒圆
    - 分缝 2 mm（侧挂板四周、顶板之间）；螺栓直径加倍（髋支座 Φ12、侧挂板 Φ10）；顶板厚 7、侧挂板厚 7、髋支座厚 7
    - 顶板前后悬挑 9；两侧只能和上层壳齐平（伸出 3.5，试了 5.5 折叠时撞前轮）
    - 侧面错层：上层甲板壳伸出 3.5、黑腰凹到 0.3、下层外壳 1.5（下部往里收）
    - 白模渲染改成 Cycles：单侧强主光 + 弱补光，两种灰度（金属件深灰、打印外壳浅灰），1800×1150
    - 0 碰撞、折叠全程不撞；仿真全部 ✓；自重 15.8 kg
    Co-Authored-By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
2026-10-17 工业化重构·第 1 步：结构重构（待确认）
    - 头：保留 4.3 寸屏，深 114 → 94，俯仰轴挪到头的底部；前脸一圈环绕烟黑面罩
    - 取消两边肩座：固定颈座（后横梁 + 两边立板）+ 两个 Φ64 圆柱耳轴座（左装舵机、右装铜套），端盖带六角和 6 颗螺栓
    - 雷达：立在左耳轴座上的短桅杆顶上，固定不动；扫描面在轴上 122，高过头抬到最高时的头顶，整个雷达在头外侧
    - 头部组件宽 240 → 216，俯仰轴前挪 10；货斗前沿 45 → 75（货斗 217 → 247 长）
    - 上层壳、下层壳前后各切一道 2 mm 缝，拆成前、后、左、右面板
    - 0 碰撞、折叠全程不撞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
2026-10-17 头部改版：屏幕模块 + 单侧六边形传感塔（固定，兼俯仰电机舱）+ 塔顶雷达（待确认）
    - 只有屏幕模块俯仰：左边舵盘法兰插进塔里的 STS3215，右边轴销插进小轴承座
    - 传感塔比原肩座小约 20%、厚 48 → 28（再小舵机放不下）；外侧转轴端盖 8 颗螺栓 + 青色灯环；外圈框和内面板一圈分缝；前斜面热成像窗 + 红外管
    - 塔顶六边形过渡法兰（4 颗小螺栓）+ 雷达 + 六边形护环（扫描面下 1 mm，不挡扫描）；扫描面高过屏幕模块抬头最高点，雷达整个在屏幕模块外侧
    - 屏幕模块：前框 / 顶盖 / 侧板 1.5 mm 分缝，四角沉头螺栓，两侧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
2026-10-17 头部恢复最初布局 + 工业化细节；腿部变截面双板连杆 + 抱闸壳（待确认）
    头部：屏幕模块居中（宽 136 → 126，给转轴壳让缝），两只六边形耳朵固定在脖子底座上
    - 电机耳（机器人左 / 面对时右）：舵机、侧面 4 条散热槽、15 mm 低矮法兰 + 雷达 + 六边形护环、转轴壳青色灯环
    - 方窗耳（机器人右）：铜套、内凹烟黑方窗 + 窄边框（后面是热成像和红外管）
    - 每只耳朵三层板叠起来，外层缩 4 mm 露台阶；外板可拆侧盖 1.5 mm 分缝；四角沉头螺栓；内侧转轴壳 + 法兰一圈螺栓
    - 屏幕模块：前框 / 顶盖 / 侧板分缝、麦克风孔、扬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
2026-10-17 腿宽减半：轮子电机塞进轮子里；抱闸壳改电机后盖（方案 A，去掉拨杆）；髋端改编码器罩；每条腿加台阶测距（待确认）
    - GIM4310 装在麦轮里面（轮子外侧板自制，中间开 Φ58 孔），后面拧在连杆内片上；腿往外 103 → 约 56 mm，整机宽 454 → 366，轮距不变
    - 连杆双板 3 + 2 + 3；轮端电机后盖 4 mm（4 颗小螺栓、六角、青光圈），髋端编码器罩（AS5600）同款
    - 台阶测距 VL53L1X：每条腿靠轮子那头的上沿，站立时朝前下方 30°（后腿朝后），看门槛、台阶、楼梯口
    - 臂座外壳从轴毂开始包，臂根内板跟着收窄；髋支座螺栓头压低 1.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
2026-10-17 腿改成电机内侧 + 叉式夹轮（待确认）
    - 从机身往外：电机（露在机身下方，半包护罩带散热纹和螺栓、端面青光环）→ 腿板（两层，外层浅色缩进 2.5，减重孔）→ 轴承座 → 麦轮 → 轴承座 → 叉板（两层、减重孔）→ 端盖（6 颗螺栓 + 青光环）
    - 叉板和腿板在轮子上方用挡泥横梁连成 U 形叉，横梁顶上凹槽线、两头 1.5 mm 分缝；叉板最低点在轴下 15，和滚子留 4.5
    - 拿掉整块浅色臂座，髋部只留短护罩；腿板、叉板各一条金线；电机线缆沿腿板内侧走、三个线夹；叉板小刻字（编号 · Φ110 · 旋向），每条腿单独做不镜像
    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
2026-10-17 叉式夹轮改回截图那种实心腿 + 电机护罩“靴子”（待确认）
    - 浅色箱形臂座外壳整条加回（从髋包到轮子跟前，黄箍、斜黄条），腿板、叉板去掉减重孔（用户：要实心）
    - 电机护罩改成从腿末端长出来的“靴子”：切角八边形，臂座在轮前收成 R59 弧、护罩从 R58 接上（1 mm 分缝），背面拧在腿板上并开孔让电机拧到腿板，朝机身那头敞开露出电机端面青光环；底面 4 道散热槽、两侧各两颗 Φ10 沉头螺栓
    - 走线：护罩后上方出线口 → 沿臂座上沿走到髋，三个线夹
    - 0 碰撞、折叠全程不撞；底盘测试 28 项全过；自重 16.8 kg；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
2026-10-18 腿回到方案 A 的样子，轮子在腿外侧并和腿外侧面齐平，电机在腿内侧露出带护罩（待确认）
    - 去掉叉板、挡泥横梁、叉板刻字；腿：浅色臂座 + 黄箍、深色外板 + 盖板长槽 + 斜黄条、髋部大圆盖（里面是编码器），直臂不收腰
    - 腿末端挖 R59 圆弧缺口，麦轮嵌进去，外侧面和腿外侧面同一个平面；轮毂盖 + 青光环
    - 电机在腿内侧（机身下方）露出来，保留“靴子”护罩、端面青光环、出线口和线缆；腿里面一块承力板托着电机和轴承座（单边支撑）
    - 0 碰撞、折叠全程不撞；底盘测试 28 项全过；自重 17.0 kg；整机宽 440
    - 仿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
2026-10-18 腿变薄 + Φ97 麦轮 + 电机露在机身下方 + 不往上折叠（最多趴平）（待确认）
    - 承力板 = 臂根板延长到轮轴（6 mm），浅色臂座只包在外面：腿厚 74 → 49 mm；轮子外侧仍和腿外侧齐平
    - 电机挪到腿板内侧，轮子那头露在机身下方（不往上折叠，碰不到机身），保留靴子护罩
    - Φ110 → Φ97（12 个滚子），最高速 1.1 → 1.0 m/s；机身底离地 134 → 128
    - 折叠改成“趴平”（摆臂 0°，机身坐在滑撬上），趴平时长约 74 cm
    - 底盘程序：站起来 / 趴下要等髋实际到位（差 3° 以内）才回 done，不只看指令走完
    - 0 碰撞；底盘测试 28 项、大脑 qui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
2026-10-18 采购表和图纸按外观定稿 v4 更新 + 标准件 / 关键件清单
    - 轮子落地结构：轮轴承座 B07（两个 6801-2RS，装在腿板内侧）+ 带法兰轮轴 B08（拧电机输出盘），电机往里挪 16，外观不变
    - 图纸 44 种：A06 外板（R52.5 轮子缺口）、A07 腿板（承力，轴毂 / 轮轴承座 / 护罩孔位）、B07、B08、D29 电机护罩兼支架（PA12-CF）、D30 台阶测距外壳、D31 髋支座（7 mm 铝）、耳朵各层、雷达法兰、转轴壳……；去掉肩座、轮子转接法兰、臂根支柱
    - 切割表加底盘边梁（26×10 方管）和横管（Φ16）
    - 采购表：Φ97 麦轮、轮轴轴承 6801 ×10、VL53L1X ×4（和 AS5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
    [采购清单.xlsx]
2026-10-18 配色渲染脚本：方案A深色/方案B浅色，只换材质和灯光，不动结构；无金色
2026-10-18 配色定方案 B：浅灰白外壳 + 深灰骨架 + 青色灯；去掉金色，灯改青/白/红；文档同步
2026-10-21 头部打印件工程版 H01–H18：拆分、螺丝孔、热熔螺母、屏幕板卡槽和压框、舵机仓、走线；按厂家图纸核对，装配检查通过
    [STS3215_03a.step]
2026-10-21 头部打印文件压缩包只放 STL + 图 + 说明（STEP 在 007v/out/head_print/）
2026-10-21 采购清单更新：头部轴销 Φ8×35、亚克力窗、USB-C 侧弯线、头部小件、M2/M5 热熔螺母、磁铁；说明里左右写反的地方改正
    [采购清单.xlsx]
2026-10-22 头部传感器改为重新买有官方图纸的版本（乐鑫 / Adafruit / SparkFun / 海凌科），麦克风和摄像头用户提供实物尺寸
    [采购清单.xlsx]
2026-10-22 头部内部深化：所有传感器和电路板按官方图纸做卡槽 / 定位柱 / 螺丝柱；空心轴销走线；爆炸图带中文标注；采购清单同步
    [max98357.brd, mlx90640.brd, sht40.brd, 采购清单.xlsx]
2026-10-22 腿部：按 GIM4310-10 官方图纸改电机外形（总长 41）、B07 兼电机座（3×M2.5 拧电机、Φ37.1 定心）、B08 法兰 Φ34 + 3×M3（Φ27）；碰撞和趴平检查通过
    [as5600_Adafruit_AS5600_Magnetic_Angle_Sensor.brd, tca9548a_Adafruit_TCA9548A.brd, vl53l1x_Adafruit_VL53L1X.brd]
2026-10-22 机身电子件：托板 C01、底板 A03 按官方孔位开孔（树莓派、ESP32、CAN Pal、TCA9548A、Pololu ×2），通用件开长孔；新增 D32 编码器支架（Adafruit AS5600）+ 侧板孔；内部无干涉
    [canpal.brd]
2026-10-22 台阶测距挪到机身：前保险杠 2 个（朝前下 30°，Φ8 小窗）、后格栅 2 个（藏在鳍中间）；腿上去掉 D30；检查通过
2026-10-22 机身腿部打印件工程版：按 256 打印机拆块（全部放得下）、外壳 VHB 贴铝板、侧挂板 / 保险杠 / 格栅 / 顶板 / 滑撬 / 臂座 / 护罩加螺丝孔和热熔螺母；甲板脖子底座孔修正；采购清单换成有官方图纸的模块
    [采购清单.xlsx]
2026-10-22 定型号：goBILDA 96 麦轮（B09 轮毂法兰 + L05 轮毂盖）、NFP-5840-31ZY-EN 24V 505（电机竖装、厂家孔位、髋 30°/s）、6S2P 电池 75×135×47；检查 / 仿真 / 测试通过
    [采购清单.xlsx]
2026-10-22 身体、腿部爆炸图（带中文标注）
2026-10-22 整机模型换成工程版：头部 H01–H19、耳朵 / 脖子、机身 P01–P25、腿部 L01–L05、头里和右耳的电子件、真实舵机和屏幕板外形；3D 查看页、Blender、SolidWorks 一起更新；检查通过
2026-10-22 腿部：加护罩端圈 L06 封住护罩空腔；轮子电机线接进机身（侧板过线孔挪到黑腰 z75 + 护线圈）
2026-10-23 后面板：急停（XB2BS542C）、总开关（GQ16 自锁带灯）、充电口（XT60E1-F）按厂家图纸放到后鼻上，模型里有实物；去掉外壳下沿的缺口；树莓派前移 4 mm
    [采购清单.xlsx]
2026-10-23 加上机身腿部打印件输出（STL/STEP）
    [L01_箱形臂座外壳.step, L01_箱形臂座外壳.stl, L02_电机护罩.step, L02_电机护罩.stl, L03_摆臂外盖板.step, L03_摆臂外盖板.stl, L04_髋部大圆盖.step, L04_髋部大圆盖.stl]
2026-10-24 软件结构初稿：四层、四块板分工、每个硬件的驱动和用法、待定问题
2026-10-24 软件结构：声音走 USB 声卡、灯和看向的分工已定
2026-10-24 屏幕换新风格：深蓝灰渐变底、细字体、冰蓝眼睛带柔和光晕；界面文字中英两套（lang 指令）；排版和动画不变
    旧风格存档在标签 屏幕旧风格存档。回归测试 146 项全过。
2026-10-24 屏幕界面文字默认英文（cn 中文留作备用）
2026-10-24 协议改动草案：台阶测距、机身灯、舵机、USB 声卡、下巴测距整幅、头部光环、树莓派防撞逻辑
2026-10-24 屏幕：有眼睛时后面的日志也看得清（数据流亮度 0.4→0.7，顶上的行不再淡到看不见）
2026-10-24 底盘：台阶测距（地面没了自动刹停锁方向、有坎限速、测距板坏了限速）、机身灯按状态亮、充电状态；横走 0.2 屏幕日志：时间/模块/内容三列，对话时推大脑每一步（听、识别、调模型、技能、开口），闲着时推读数；日志更亮，眼睛盖在上面
    底盘测试 43 项、大脑回归 146 项全过。
2026-10-24 底盘 ESP32 固件（PlatformIO + Arduino）：底盘程序照 Python 一行行翻成 C++、协议、硬件层（GDZ34 CAN、BTS7960 髋、AS5600/VL53L1X/INA226、急停、灯、看门狗）
    - 常数从 Python 自动生成（gen_params.py）
    - C++ 和 Python 逐步对比（test/compare.py）：37 秒动作、7480 步、401 条消息，0 处不一样
    - 两边都加了：髋角度零点标定（calib hip）、轮子电机没回应 / 驱动故障（WHEEL_LOST / WHEEL_FAULT）、开机自检提醒（HW_CHECK）
    - 尾灯刹车 / 倒车门槛改成不会被正好碰上的数
    - 采购清单加 USB 转 RS485（改电机 CAN 地址）；接线图更新灯链引脚和 CAN 芯片
    - 底盘测试 47 项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
    [采购清单.xlsx]
2026-10-28 007A 方案草图 v1、v2（腿照用户草图、大腿和髋盘一体、头嵌进机身前面）+ 重量和关节扭矩估算
2026-10-28 007A 方案草图 v3：腿外形照用户草图（带尖角的髋盘 + 大腿一体）
2026-10-28 007A 外观模型 v1（cadquery）+ Blender 效果图：机身照 007v 设计语言、头嵌进前面、腿照用户草图
2026-10-28 007A 外观 v2：髋盘按电机缩紧、大腿收成一条臂；髋往后收、头做成往前凸出的屏幕模块（带抬头低头转轴）；平行斜槽；脚垫加大
2026-10-28 007A 外观 v3：楔形大腿照草图、上浅下深分色；小腿和大腿同一个面（膝盖叉口）；头加眉檐、收下巴、两侧耳鳍；背上一体货台
2026-10-28 007A 外观 v4：髋改成圆形分层关节（Φ106），大腿切线收到膝；机身加高 25；取消头上眉檐和装饰边线（没作用的不设计）
2026-10-28 007A 外观 v5：髋盘回到多边形，改成规整的正六边形（边心距 53），大腿两边从六边形朝膝的两个角切到膝盖圆头，左右对称；浅色盖板靠髋那头平行于六边形的边
2026-10-28 007A 外观 v6：回到 v3 的髋盘+楔形大腿造型，轮廓理顺（每条边离电机中心 51，边角取 30/-120/180/120°），整体缩小（最远角 84→72）
2026-10-28 007A 外观 v6：髋盘和大腿沿中线翻过来（和 v3 一致：连续长直边在后面、髋盘尖角朝前上）
2026-10-28 007A 外观 v6.1：髋盘前上那个 90° 尖角切掉（切口离电机中心 54），和其他钝角协调
2026-10-28 007A 外观 v7（不怂）：腿伸直（膝 110°）、四脚撑开 ±45、机身前高后低 4°、头上移做大、小腿加宽、平底宽脚垫、眼睛改成有棱角；附 v6.1 对比图
2026-10-28 007A 外观退回 v6.1（用户觉得改之前更好）；v7 留在历史和对比图里
2026-10-28 007A 设计语言三个方向的概念图：A 多面体硬朗风 / B 整体曲面+锐利折线 / C 骨架+面板
2026-10-28 007A 外观 v8：在 v6.1 上做精——所有斜面统一 45°（大 24 / 中 18 / 俯视转角 10）、外棱统一倒 1.5；分缝上下连通、灯条字样居中在分缝之间；斜槽外沿对齐头正面；头四周 4 mm 影线缝（抬头低头间隙）；货台和雷达座同一套切角
2026-10-28 007A 机身 v9：楔形收腹（尾部底抬高 50）、前宽 260 后窄 220、八边形截面不倒大圆角、去掉竖向分缝、黑腰改成一道斜线（灯在里面）；头腿沿用
2026-10-28 007A v10: 原版方正机身 + 表面凹凸层次（装甲板、髋窝、格栅、提手、雷达架、防撞杠、尾部接口板）
2026-10-28 007A v11: 机身高 185 → 160
2026-10-28 007A v12: 机身高 140、去提手、斜肩 + 底盘收腰 + 护角
2026-10-29 007A v13: 腿 200/190（上楼梯计算）、扬声器孔、麦克风阵列 + 录音灯、电源开关
2026-10-29 007A v15: 一个探照灯、深度相机、底部绑带卡口 ×4、雷达八角护圈（去掉金属架）
2026-10-29 007A v16: 红外热像仪（前防撞杠右头）、气体检测（尾部格栅）
2026-10-29 007A 选型第 1 步：扭矩计算、关节电机定宇树 GO-M8010-6、膝同步带 1:1.5、传感器候选
2026-10-29 007A 采购表初版：宇树电机官方尺寸、新传感器、电源按 007A 改，沿用件从 007v 清单取
    [采购清单.xlsx]
2026-10-29 007A 采购表：宇树电机按天猫官方店价 1500、USB 转 4 路 485 一个就够
    [采购清单.xlsx]
2026-10-29 007A 采购表：深度相机、热像仪、气体、IMU、探照灯按淘宝官方店价更新
    [采购清单.xlsx]
2026-10-29 007A 第 2 步：一条腿的工程结构（宇树电机同轴、膝同步带 20/30、HTD5M 525）、外摆 ±15° 间隙检查、外观跟着改
2026-10-29 007A v18：大腿分两层（内层只包皮带），髋窝回到效果图大小，外摆 ±20° 不碰机身
    [000.stl, 001.stl, 002.stl, 003.stl, 004.stl, 005.stl, 006.stl, 007.stl]
2026-10-29 007A 第 2 步：机身骨架（铝板 A01–A07、外摆隔板、电池托、电子托板插槽）+ 4 条腿，站立 / 外摆 ±20° 干涉检查 0 处；货台凹 6、髋窝 R64
    [000.stl, 001.stl, 002.stl, 003.stl, 004.stl, 005.stl, 006.stl, 007.stl]
2026-10-29 007A 第 2 步：重量重心（目标 16.4 kg）、头安装和抬头低头 ±20° 检查（换 STS3032）、铝板 DXF / STEP 出图、采购表加结构件
    [A01_A01底板.dxf, A01_A01底板.step, A02_A02外摆隔板前.dxf, A02_A02外摆隔板前.step, A03_A03侧梁左.dxf, A03_A03侧梁左.step, A04_A04纵梁前左.dxf, A04_A04纵梁前左.step]
2026-10-29 007A 第 2 步第三轮：62 个角码 + 孔、减重孔、外壳 / 头 / 防撞杠 / 尾部安装孔、绕线环、头支架折弯件、走线图和说明；干涉 0 处；重量 17.2 kg
    [000.stl, 001.stl, 002.stl, 003.stl, 005.stl, 007.stl, 008.stl, 009.stl]
2026-10-29 007A 第 3 步仿真初版：MuJoCo 模型（重量按零件）、站立 / 站起 / 小跑 0.5 和 0.8 m/s 通过；住宅楼梯正着上能上但小腿蹭踏步边；楼梯余量按真实膝 / 腿厚度重算：正着上 2–6 mm、倒着上 20–31 mm
    [007a.xml]
2026-10-29 007A 爆炸图（整机 + 左前腿）；小腿外形对比（带折弯的小腿正着上楼梯余量最好，结构不改）；leg_clear.py 按真实腿外形查离台阶距离
2026-10-29 007A 仿真：走楼梯程序改版（真实腿外形查碰撞、前后腿分开挑跨步时机、机身前后左右挪保稳、跨的腿按机身实际姿势落脚）；正着上住宅楼梯、跨电缆槽通过
2026-10-30 007A 仿真第二版：机身高度/俯仰按需再挑、撑脚跟随实际位置；正着上住宅楼梯、跨电缆槽通过，公共楼梯/倒着上/正着下仍摔；报告更新（腿结构不改）
2026-10-30 007A 选型：国产关节电机对比（GIM8108-8 / DM-J8009P / RobStride 03 vs 宇树）
2026-10-30 007A 仿真：可设空载（PAYLOAD）和电机峰值（MOTOR_TAU）；改货重后重算整机质量；空载 + 18.3 N·m 电机仍能小跑、上楼梯
2026-10-30 007A v19 省钱版：关节电机换 SteadyWin GIM8108-8（Φ92×55，腿每边外移 25.4，露出大腿杯）；去掉探照灯、气体检测，热像仪换 007v 同款 MLX90640；托板重排、隔板角码让开电池托，干涉 0；采购约 2.1 万；新增 make_blend.py
    [采购清单.xlsx]
2026-10-30 007A 第 4 步：零件图 PDF（铝板孔表、CNC 三视图）、3D 打印件（外壳做成 2.5 mm 壳、按 256 拆块、销孔、热熔螺母孔）、装配说明
2026-10-30 007A v19：电机孔按 SteadyWin GIM8108-8 官方安装尺寸图（耳 8-M3 Φ92、输出 6-M3 Φ25 + 3-Φ4 销、背面 Φ60×20 穿隔板）；头抬 40° 低 20°，头后弧形滑道（缝 1.5）、头壳壁 3、去掉头鳍；A05 两条同心弧形槽；托板让开电机背面；零件图改孔位图（每孔编号 + 坐标表）；干涉 0
    [采购清单.xlsx]
2026-10-30 007A v19：重新生成的输出（STL、STEP/DXF、渲染图、质量、仿真动图），跟 8db9a7f 的模型一致
    [000.stl, 001.stl, 002.stl, 003.stl, 004.stl, 005.stl, 006.stl, 007.stl]
2026-10-30 007A v20：关节电机换回宇树 GO-M8010-6，孔位按官方尺寸图（输出 6-M4 Φ34.5、背面 8-M3.5 R42.5、背面凸台穿 Φ64 孔）；整机宽 351；采购改 485；干涉 0
    [000.stl, 001.stl, 002.stl, 003.stl, 004.stl, 005.stl, 006.stl, 007.stl]
2026-10-30 007A v20 传感器安装：前防撞杠合并相机罩/热像仪座/探照灯筒（探照灯加回）/台阶测距窗，孔位卡槽按官方图纸（Gemini 335、MLX90640、VL53L1X、LD19、Pololu、Pi5、MAX98357A、急停/开关/XT60）；尾部接口板；上层壳螺丝柱、接缝销孔；托板孔位和 IMU 卡座；逐颗螺丝核对 42/42
    [011.stl, 012.stl, 080.stl, 081.stl, 082.stl, 083.stl, 084.stl, 085.stl]
2026-10-30 007A v20 仿真复跑（宇树电机、空载）：住宅楼梯正着上过；公共楼梯 / 倒着上 / 正着下仍摔（静步程序到头）
2026-10-30 007A v20：抬头舵机 STS3032 按店铺尺寸图 + 打印舵机座 P04（拧左头支架）；XT60 开孔按图纸；IMU 改超核 HI12M0（350）、485 模块 269；孔位核对 46/46
    [A01_A01底板.dxf, A01_A01底板.step, A02_A02外摆隔板前.dxf, A02_A02外摆隔板前.step, A03_A03侧梁左.dxf, A03_A03侧梁左.step, A04_A04纵梁前左.dxf, A04_A04纵梁前左.step]
2026-10-31 007A v21：膝盖大腿夹小腿，带轮改 16/24 齿（HTD5M，1.5 倍，膝 35.5 N·m），皮带 500-5M 100 齿；大腿髋端不变、往下收细到 55；小腿侧面外扩 3、厚 16→20；修大腿内板皮带窗未切；干涉 0、孔位 46/46、减重目标 16.82 kg
    [005.stl, 006.stl, 007.stl, 014.stl, 016.stl, 017.stl, 021.stl, 022.stl]
2026-10-31 007A v21：卖家确认膝同步带 500-5M 20 宽能长期扛 1860 N，采购表改已确认
    [采购清单.xlsx]
2026-10-31 清理：只留 007A（主做）和 007v；删旧版四足、007A 旧过程渲染和对比图、省钱版效果图和 blend；外观设计规范挪进 docs/；CLAUDE.md 改成 007A 为主；补进 007A 仿真动图、打印件、爆炸图、图纸输出
    [000.stl, 001.stl, 002.stl, 003.stl, 004.stl, 005.stl, 006.stl, 007.stl]
2026-10-31 007A v21 定型：IMU 按店铺尺寸表改 HI12M0（22×22×10，3×M2.5 铜柱直接拧托板，取消卡座 P03）；探照灯按店铺图（3° 透镜 Φ21.8×17.6 + 20mm 铜基板 + 20×20×6 铝块）改灯筒；485 模块是光板没孔，扎带 + 双面胶；舵机座打印件不卡；零件清单不再有 ★要图；走线说明去掉气体、改 IMU 串口；干涉 0、孔位 47/47
    [080.stl, 097.stl, 098.stl, 099.stl, 100.stl, 101.stl, 102.stl, 103.stl]
2026-10-31 007A v21 膝盖连接：轴承挪进带轮里——小腿根 L09（7075 CNC：24 齿带轮 + 8 厚舌头，孔里压 2 个 6801），膝轴 Φ12 两头 M5 拧死在大腿两块板上不转；打印小腿夹舌头，3 颗 M4×16 薄头横穿沉孔；加腿内部干涉检查并修掉原来漏查的重叠（大腿壳让小腿 / 立柱 / 张紧轮，绕线环让髋座，小带轮开孔）；采购表加小腿根、膝轴固定件、托板铜柱
    [003.stl, 005.stl, 006.stl, 007.stl, 014.stl, 019.stl, 020.stl, 021.stl]
